plektra/syntsamix/docs/MECHANICAL.md

# Mechanical interface

Status: **[confirmed]** where a decision is named; sections marked *open* are still to settle in a `/system mechanical` session. Decisions behind this file: `decisions/mechanical.md` items 55, 59, 75, 86, 106 to 109, 119 to 121, 160, 162, 176 and 188; `decisions/power.md` items 168 (power LED), 182 (brick jack), 185 and 186 (power board size and form); `decisions/system.md` item 175 (multi-drop chain cables); `decisions/system-rules.md` item 118 (jack sizes).

The mechanical contract between the boards, the panels and the frame: what every board layout must fit. Changed only by a confirmed decision (invariant 5 in `ARCHITECTURE.md`).

## Format (decision 59)

Desktop unit. One PCB per channel strip under its own top panel strip; channel input jacks on the passive input module behind the rear panel (decision 62, position: decision 160); front and back aluminium rails cut to length with wedge side cheeks, so the top panels slope toward the player (decisions 160, 162); left to right: the channel strips, the master section, the power bay (decision 162); chain ribbons run under the strips between neighbours. Top and rear panels are black FR4 with white legends from the PCB maker.

## Strip envelope (decision 106)

| Item | Value |
|---|---|
| Strip pitch | 35.0 mm |
| Top panel strip width | 34.8 mm (0.2 mm gap to the neighbour) |
| Panel material | FR4, 1.6 mm |
| Channel card PCB width | at most 33.0 mm, centred on the strip |
| Control area (between the rails' inner faces) | at most 320 mm deep (decisions 106, 108) |
| Top panel length | control area + 2 × 20 mm on the rails, at most 360 mm (decision 108) |
| Channel card PCB depth | fits between the rails: at most 318 mm (1 mm clearance to each rail; decision 108) |

Sixteen strips are 560 mm wide before the master section. Unit width: 35 mm × (channels + 5) plus the cheeks (master 4 strips, power bay 1; decision 162): about 315 mm for the prototype, 735 mm for 16 channels.

## Channel strip panel layout (decisions 55, 106)

One column, top (rear) to bottom (front), following the signal flow:

1. TRIM
2. [LOW-CUT]
3. Cutoff CV IN and CV OUT jacks (3.5 mm Thonkiconn, vertical, on the channel card; decisions 118, 165), side by side, IN left and OUT right, 16 mm between centres, centred on the strip (decision 166)
4. CUTOFF
5. RESONANCE
6. [FILTER BYPASS]
7. AUX 1
8. AUX 2
9. [SC SEND] [DUCK] [COMP BUS] in one row (caps at most about 10 mm on an 11 mm pitch)
10. [PFL]
11. [MUTE]
12. 8-LED meter beside the 60 mm fader, at the front edge: printed bezel flush in one panel slot, 6.0 mm pitch, CLIP level with the fader's top travel end (decision 119)

## Panel stack (decision 107)

| Item | Value |
|---|---|
| PCB top to panel underside | 10.0 mm, set by the Alpha 9 mm pots (10 mm body) |
| Panel | 1.6 mm FR4; top surface 11.6 mm above the PCB |
| Pots (RD901F-40, RD902F-40) | hold the panel: M7×0.75 bushing 5 mm, washer 0.4 mm and nut 2 mm (4.0 mm of thread used); shaft 6 mm T18 knurled, L = 15 mm from the body face, about 13.4 mm above the panel, push-on knobs (decision 114); bushing thread from Alpha's RD902F drawing, confirmed by Thonk support for the Thonk T18 pots (2026-10-09); check the nut fit on the first delivery |
| Fader (PTA6043, DP lever 15 mm) | frame top 6.5 mm above the PCB; screwed to the panel with two M2 screws (holes 71 mm apart) through 3.5 mm spacers; lever about 10 mm above the panel; slot about 4.5 × 65 mm |
| Top-side height limit | at most 9.0 mm under the panel (1 mm clearance), except parts that pass through it |
| Buttons (GPBS850L) | printed caps take up the height (measure a sample) |
| Channel meter (decision 119) | 0805 LEDs on the PCB under a 3D-printed bezel 11.6 mm tall, face flush with the panel top, through one slot about 5 × 49 mm; 8 windows at 6.0 mm pitch (about 4 × 4.5 mm, 1.5 mm walls); located by the slot and two printed pegs in 1.5 mm non-plated PCB holes; column position across the strip: *set at channel card layout* |
| Cutoff CV jacks (IN, OUT) | 3.5 mm Thonkiconn PJ398SM (decisions 118, 166), each: body 9 mm on the PCB, 1 mm printed washer on the unthreaded bushing collar to the panel underside, M6×0.5 nut on top (2.9 mm of thread left) |

Assembly order: screw the fader to the panel first, then solder it to the PCB, so its joints carry no stress. The fader is therefore hand-soldered, not assembled by the PCB maker.

## Card fixing (decisions 108, 120)

- Each top panel rests on the front and back 2020 rails, covering each rail's full 20 mm top face.
- One M3 button-head screw (ISO 7380) per end (two per panel), on the strip's centreline, into a drop-in M3 T-nut in the rail's top slot (slot centre 10 mm from the rail edge) (decision 120).
- A 3D-printed locating key under each panel end sits in the rail's top slot and stops the panel rotating in its plane (decision 120). Check rattle and twist on the prototype; the second screw per end (decision 108) returns if needed.
- The card hangs from its panel by the pots and the fader (decision 107); nothing on the PCB reaches over a rail.

## Chain headers (decisions 109, 175)

- Left to right: the channel strips, the master section (4 strips), the power bay (1 strip) (decision 162).
- Every channel card: one audio header (2×17) and one power header (2×4) on the underside, long axis front to back, **pin 1 toward the front**, key on the same side on every card (decision 175). Every card is the same, so the sockets sit at the 35 mm strip pitch.
- Header positions (each header's distance from the front, position across the card): chosen by the channel card layout (rear half, clear of the fader) and recorded here: *to be filled in*. The master card's audio header sits on the same line in the same orientation, near its left edge.
- Audio cable: multi-drop sections of 34-way flat cable. A standard section has 8 card sockets about 37 mm apart on the cable (35 mm pitch plus about 2 mm so it bows instead of pulling; marked on a crimping guide) and an end socket at each end. The first section's right end plugs into the master; a second section (cards 9-16) joins the first's left end through the coupler board; a free end socket stays unplugged. End-segment lengths: *set at the channel and master layouts*.
- Coupler board (only for more than 8 cards): a small passive PCB with two shrouded 2×17 headers as on the cards, same orientation, pin n to pin n; held in the cable run under the strips by a cable tie or a printed clip, never on the bottom cover.
- Power cable: one multi-drop section per group of 8 cards (decisions 80, 175), 8-way Würth WR-CAB flat cable (decision 178), a feed socket at the power board and 8 card sockets. Chain 1 feeds the group next to the master (the prototype's cards), chain 2 the far group (full-size module only, decision 185). Chain 1's feed runs under the master section; chain 2's (about 0.5 m) along the rear floor in front of the input modules on printed clips on the rear bottom angle, then forward to the header line (no cross band under the cards). The master card has its own two-socket power ribbon.
- Unused card sockets may stay free: the prototype has one audio and one chain 1 power section with 4 of the 8 card sockets in use. Any card can be unplugged without breaking the chain.
- Crimping (by hand, IDC press or smooth-jawed vise): every socket of a section on the same cable face, stripe along the front edge. At card sockets the cable passes straight through; end sockets may take the strain relief (check the Würth drawing).

## Rear panel and input module (decision 160)

| Item | Value |
|---|---|
| Rear panel | one black FR4 strip per channel, 34.8 mm wide (as the top panels), 1.6 mm; the master section and the power bay have their own rear pieces (decision 162) |
| Rear strip fixing | top: one M3 screw into a T-nut in the rear 2020 rail's back slot; bottom: one screw into an aluminium angle (about 20 × 20 × 2 mm, cut to length) along the rear bottom edge |
| Input module (6.3 mm) | PCB on edge in the front-to-back vertical plane, below the rear rail, centred on its strip; NYS216 jacks stacked, L/MONO above R, about 19 mm between centres; module about 40 mm tall; fixed only by the jack nuts on the rear strip; 2x6 box header facing forward (decision 181) |
| Why stacked | NYS216 is 17.7 mm wide across its pin rows (footprint from Rean's drawing): two side by side need 35.4 mm, more than the 35.0 mm pitch |
| Rear inside height | about 60 mm: 20 mm rail plus about 40 mm of jack zone; *from the module layout* |
| Input cable (decisions 99, 180, 181) | self-made 12-way IDC flat cable, 150 mm, between the 2x6 box headers; the channel card layout places its header near the rear edge, within reach |

## Frame shape (decision 160)

- Sloped: wedge side cheeks, flat bottom cover; the rear about 60 mm inside (above), the front a single 2020 rail, 20 mm inside (decision 162), so the top panels tilt about 6° toward the player.
- Front: no member below the front rail; the bottom cover screws into the rail's bottom slot. At the front only fader and part pins pass a card's underside; underside parts (decision 121) sit at least about 40 mm behind the front rail's inner face, where the floor is deep enough.
- The cards hang from their panels (decision 107): the tilt changes nothing on a board. The cheeks are the same for every channel count.

## Master section (decision 162)

| Item | Value |
|---|---|
| Width | 4 strips (140 mm), right of the channels; one top panel 139.8 mm wide, at most 360 mm long |
| Master card | at most 138 mm wide and 318 mm deep, hung 10 mm under its panel like a channel card (decision 107); audio header on the channel cards' header line near its left edge, same orientation (decisions 109, 175) |
| Controls | 13 pots, 10 buttons, stereo meter, 5 gain-reduction LEDs, headphone jack; three columns (compressor and sidechain, AUX, master/phones/meter) set at layout |
| Meters | 0805 LEDs under printed bezels as decision 119: 2 × 12 at 6.0 mm pitch plus the 5 gain-reduction LEDs (yellow); the PFL-active LED is an 0805 under a bezel window too (decision 170) |
| Rear jacks | one rear piece 139.8 mm; 12 positions in 2 rows × 6 at about 23 mm: 11 jacks and the ground-lift switch, on two flat passive row boards fixed only by the jack nuts: output board (main L/R, AUX send 1 L/R, AUX send 2 L/R) and input board (AUX return 1 L/R, AUX return 2 L/R, SC EXT, ground lift), each cabled to the master card by one 26-pin ribbon (J603 outputs, J903 inputs and ground lift; decision 163). Needs the NYS216 at most about 17 mm tall above its board: *measure a sample*; if taller, on-edge 2-jack boards as the input module |
| Headphones | panel-mounted 6.3 mm stereo jack, nut on the master top panel, body through a cutout in the master card; Rean NYS230 cabled by a ready-made 150 mm Molex 217797-1031 lead to the KK 1x3 header J751 on the card (decision 169); at least about 90 mm behind the front edge (about 30 mm of depth, to measure on a sample) |
| Regulators | U901, U902 TO-220 on Wakefield 637-10ABPE heatsinks (12.67 °C/W, 25.4 mm below the PCB; LM317 TJ about 111 °C worst case at decision 167's 57 °C air, within the 125 °C rating, decision 174); U903 without a heatsink. On the card's underside, hand-soldered, at least about 190 mm behind the front rail's inner face, where the sloped floor leaves 40 mm below the panel underside (heatsink bottom 37 mm plus 3 mm to the cover; decision 176; master-only exception to decision 121); ≥ 3 mm from each other, the frame and the cover (live tabs); heatsinks and tabs at least 10 mm inside the card's right edge, preferably near the card's middle, so about 20 mm of air separates them from the power board's parts (decision 188) |
| Power cables | the master's power ribbon and the chain 1 feed cross under the master section in front of the heatsink zone (less than about 185 mm behind the front rail's inner face); no chain cable passes under a heatsink; the master's power header is placed so its ribbon needs no other route (decision 188) |

## Power bay (decisions 162, 185, 186, 188)

| Item | Value |
|---|---|
| Width | 1 strip (35 mm) at the right end, with a plain top strip (34.8 mm) |
| Power LED | on the bay's top strip: 3 mm LED in a Bivar CR-104 clip, Ø4.47 mm (+0.10 / −0.05) hole in the 1.6 mm FR4 (flange 5.3 mm, ring 6.1 mm behind the panel), wired to J103 (decision 168); hole on the strip's centreline about 290 mm behind the front rail's inner face, clear of the rear bracket (decision 188) |
| Power board | small module (decision 185): on edge in the front-to-back plane, 177 × 35 mm, about 138 to 315 mm behind the front rail's inner face, top edge about 5 mm under the panel, bottom edge 3 mm above the cover, rising over the front 47 mm (decision 186); parts side toward the master, parts up to about 17 mm; ribbon headers along the bottom edge, pin 1 toward the front |
| Position across the bay | back face (bracket side) 6 mm from the bay's right edge at the cheek, so the parts end about 10 mm from the master section's edge; back-face copper at least 5 mm from the cheek; nothing touches the cheek (decision 188) |
| Fixing | hangs from the bay's top strip on two brackets only, no fixing to the rear strip (decision 186); panels only, nothing on the cheeks; insulating hardware keeps PGND off the frame (invariant 8). Brackets printed PETG or ASA, inverted L: vertical leg on the back face with a vertical slot, M3 from the parts side through H1/H2 into a heat-set insert; horizontal leg about 4 mm thick in the 5 mm gap above the board; one M3 button-head screw (ISO 7380) per bracket through the top strip on its centreline, about 309 mm (H1) and 144 mm (H2) behind the front rail's inner face, plus a printed anti-twist peg (decision 188); bracket drawing and the strip's holes *with the panel drawing* |
| Rear strip | brick jack Kycon KPJX-PM-4S (flange 25.2 × 14.2 mm, two M2.5 self-tapping screws 19.0 mm apart, about Ø13 hole, body 9.9 mm; decision 182) and power rocker (decision 157, cutout 19.2 × 12.9 mm for a 0.8-1.2 mm panel, 19.4 mm for 1.3-2.0 mm), upright side by side; exhaust slots where they leave room (decision 167); the board's rear edge ends about 25 mm in front of the strip: *check the rocker tabs with their receptacles on the frame* |
| Module sizes | the prototype's small module for up to 8 channel cards (master and chain 1, decision 185); a full-size module with chain 2 after the prototype measurement; same bay and ribbons |

## Underside and bottom cover (decision 121)

| Item | Value |
|---|---|
| Underside parts | the chain headers (decision 175); elsewhere only hand-set parts (trimmers, jumper headers; decision 112), at most 10.5 mm below the PCB's bottom face |
| Keep-out | no underside parts other than the chain headers in a band across the whole card width over each header's length plus 15 mm front and back (decision 175); the cable runs below at the sockets' depth |
| Bottom cover | perforated as the air intake (decision 167); detachable, a few captive or quarter-turn screws: at the rear into the bottom angle (decision 160), at the front into the front rail's bottom slot (decision 162); off without touching side cheeks, cards or feet |
| Feet | on the side cheeks or the rails, not on the cover |
| Inside height | 20 mm at the front rail, about 60 mm at the rear (decisions 160, 162); the channel card layout checks header, socket and cable depth against the inside height at the header distance (decision 175) |

## Ventilation (decision 167)

| Item | Value |
|---|---|
| Principle | passive, no fan on the prototype; design point: inside air 22 K above room temperature (57 °C on a 35 °C stage), up to 8 cards; parts and heatsinks checked at 57 °C air |
| Intake | perforated bottom cover |
| Exhaust, channel rear strip | four routed slots 2 × 30 mm in the jack zone, two in each band beside the jack nuts (from the left edge 2.5-4.5, 6.5-8.5, 26.3-28.3, 30.3-32.3 mm; 2.5 mm edge margin, 2 mm bars): about 2.4 cm²; legends and the top screw on the 20 mm in front of the rail; jack nut taken as about 15 mm across (*measure the sample*) |
| Exhaust, master and bay | slots where the jacks, rocker and brick jack leave room (about 3 and 2 cm²) |
| No openings | cheeks, top panels (spills) |
| Estimate | rise about 20 K (prototype), 22 K (8 cards), 24 K (16 cards) **[estimate]**, `tools/heat_budget.py` |
| Measurement | prototype: probe at the master heatsinks and over the middle channel card, one hour with every LED lit; full-size cooling decided after it |
| Check | the rear bottom angle (decision 160) must not cover the lower slots or the lower jack's body: under the jack zone or a shorter leg (input module layout) |

## Panel hardware and ground (note)

Jack sleeves go to their own card's AGND; FR4 panels do not conduct (`CHAIN.md`, Grounding). Keep pot bushings and fader frames off AGND anyway, so metal panels (a product-version option, decision 59) need no ground rework. A jack's metal bushing is usually its sleeve, so on metal panels jacks would need insulated bushings or insulating washers.

## Open

Settled in this order, each by a decision:

1. *Underside:* the header positions, end-segment lengths and the inside-height check (keep-out settled by decision 175) and the input cable length, all at the channel card layout; the chain 1 feed reaches the header line after crossing under the master section in front of its heatsink zone (less than about 185 mm behind the front rail, decision 188), and the master layout checks the floor height where both power ribbons cross (rear, frame shape, master section and power bay settled by decisions 160 and 162; underside rules and cover by decision 121)
2. *Heat (full size):* the cooling for 16 cards after the prototype measurement (decision 167): a quiet fan in the power bay (expected) or less dissipation
