plektra/syntsamix/docs/SPEC.md

# Specification v0.7 (draft)

Items marked **[confirmed]** were agreed with the user. Items marked **[proposed]** are defaults suggested during the design chat and still need confirmation. See `decisions/INDEX.md`.

## 1. Goals

- Live-performance mixer for synths, drum machines and modular gear **[confirmed]**
- Modular by design **[confirmed]**
- Relatively tight budget: prefer cost-effective parts where the audible difference is small **[confirmed]**
- Channel strips can be added one at a time as needed. Each stereo channel card is self-contained and has no direct dependency on any other channel card; it talks only to the shared buses **[confirmed]**
- Inputs accept hot Eurorack modular levels as well as line levels, without an external attenuator **[confirmed]**
- Analog signal path **[confirmed]**
- Pro-level headroom: +4 dBu nominal. On ±15 V rails a single-ended stage tops out at about +20 dBu; +24 dBu is reachable only at the balanced outputs (each leg at +18 dBu) **[confirmed]**

## 2. Architecture

- Identical stereo channel cards, 1 to 16 (the prototype has 4), chained by multi-drop ribbon cables in 8-card sections (decision 175), with the master card at one end. No backplane PCB **[confirmed]**
- Each channel card has one connector of each kind, on multi-drop cables (decision 175): a 34-pin IDC audio ribbon (buses, logic lines, interleaved audio grounds, spares) and a keyed 8-pin IDC power ribbon (2× V+, 2× V−, 4× ground; 10- and 16-pin avoided so Eurorack cables cannot be plugged in) **[confirmed]**
- Chain power: about ±20 V nominal (unregulated in general; on the prototype it comes from the converters on the power board, decision 100), entering at the power board; each card regulates its own ±15 V; audio ground and power ground on separate conductors **[confirmed]**
- Pinouts, signal definitions and grounding rules: see `CHAIN.md` **[confirmed]**
- Summing buses: main L/R, compressor L/R, AUX1 L/R, AUX2 L/R (8 lines), plus cue L/R (2 lines), a "PFL active" logic line and the sidechain bus (pinout in `CHAIN.md`) **[confirmed]**
- Channel independence rules: every slot is identical (no slot-specific signals); audio buses are summed on the master card, so adding a card only adds a source; logic lines such as "PFL active" are wired-OR; no part is shared between channel cards; each card regulates its own supply **[confirmed]**
- Expansion by the chain: adding a channel means adding one card and one pair of ribbon cables **[confirmed]**
- Master/compressor card **[confirmed]**
- Prototype power: a certified off-the-shelf 24 V Class II DC power brick (floating output) plugs into a locking 4-pin DIN connector on the power board next to the master card (decisions 81, 100); non-isolated converters there (TPS54560 buck and inverter, 400 kHz) make about ±20 V for the chain, followed by an LC filter, with a pi filter at the input against the brick lead (decision 187); per-card linear ±15 V regulators reject the remaining switching ripple. Power switch, resettable fuse, reverse-polarity protection and a power LED at the input. No mains wiring inside the mixer **[confirmed]**
- Supply rating for 16 cards: 3.6 / 2.9 A per rail (decision 96, rerun after decisions 102 and 103; `docs/ARCHITECTURE.md`). The +20 V buck probably scales; the −20 V inverter needs a controller with external MOSFETs, settled after the prototype cards are measured (decision 100) **[open]**
- Each module is its own KiCad project with hierarchical sheets and its own PCB **[confirmed]**

Signal flow per channel: input receiver and trim (with soft clip) → low-cut (switchable) → filter (or bypass) → [PFL, meter and SC send tap] → level VCA (fader + mute) → AUX sends and bus assign (main or compressor bus).

## 3. Channel strip (per stereo channel; every element is an L/R pair)

| Block | Spec | Status |
|---|---|---|
| Input | Balanced inputs | confirmed |
| Mono sources | L/MONO input: with only the L jack plugged in, the signal feeds both sides through the R jack's switch contacts. No panel switch, no balance/pan control | confirmed |
| Input module | Jacks sit on a separate passive input module on a 12-pin IDC header (`INPUT-MODULE.md`, decision 181); the prototype module is 6.3 mm, with 3.5 mm and D-SUB bundle modules later | confirmed |
| Input connectors | 2x 6.3 mm TRS (L/MONO and R), balanced; an unbalanced TS plug works with ring and sleeve shorted, so Eurorack gear connects with a 3.5 mm TS to 6.3 mm TS cable. The R jack needs switch contacts on tip and ring for L/MONO normalling (part to be chosen from datasheets). All jacks on the mixer are 6.3 mm | confirmed |
| Input level range | From -10 dBV consumer line up to Eurorack hot signals of ±12 V peak (24 Vpp), with no clipping at minimum trim | confirmed |
| Input receiver | Difference amplifier at G = ½ (-6 dB) on one TL072 per card for L and R, 10k 0.1 % resistors (CMRR at least 51.5 dB; decision 143; the AD8273 until 2026-10-10) | confirmed; DC-coupled inputs confirmed |
| Soft clipping | Soft clipper after the input trim stage, so overloads saturate gradually instead of hard-clipping. Onset about 6 dB below the internal maximum (about +14 dBu); exact circuit set in the schematic | confirmed |
| Low-cut | Switchable fixed low-cut at 100 Hz (decision 73), 12 dB/octave Butterworth, C0G capacitors (decision 113; film before), after the trim stage and before the ladder filter (so meter, PFL and sends all see it) | confirmed (slope proposed) |
| Input trim | One wide trim, no pad switch: overall gain about -20 to +20 dB (input to internal +4 dBu nominal); the trim stage after the receiver spans about -14 to +26 dB | confirmed |
| Input DC blocking | AC coupling after the receiver, corner about 3 Hz; Eurorack outputs can carry DC offsets | confirmed |
| Level meter | 8-segment mono LED meter (louder of L/R), post-filter and pre-fader (same point as PFL): -30, -20, -10, -5, 0, +3, +6, clip, relative to +4 dBu nominal. Peak-reading with a 1 to 2 s fall. Peak detector plus comparators; low-current LEDs returning to power ground. Replaces the peak LED | confirmed |
| Filter | 24 dB/oct (4-pole) ladder LPF with resonance and cutoff controls | confirmed |
| Filter part | SSI2144 baseline, AS3320 fallback | confirmed |
| Cutoff range | 20 Hz to 20 kHz (10 octaves, about 190 mV at the frequency control pin); one linear pot drives L and R, which gives an even octave-per-turn feel (noon about 630 Hz) through the chip's exponential control | confirmed |
| Filter bypass | Per-channel bypass switch around the filter | confirmed |
| Filter gain structure | "Hot" drive by default: +4 dBu maps to the datasheet nominal of ±20 mV at the SSI2144 input. Simulated: under 0.1% THD at +4 dBu with the cutoff open, about 1.3% with the cutoff lowered toward the signal, clear saturation from about +8 dBu; SNR about 93 dB A-weighted with the filter engaged. A jumper on the prototype selects a "medium" drive 4 to 6 dB lower (switching the pre-filter attenuator and the make-up gain together) so the final choice can be made by ear. Make-up gain after the filter. See `simulation/filter/README.md` | confirmed |
| Filter tracking | One control path drives L and R, plus a frequency offset trim per chip; the temperature-compensating resistor is in the backlog (decision 141) | confirmed |
| Resonance limit | Fixed maximum Q current so no chip self-oscillates: about 75% of the oscillation current (k = 3). With the Q VCA (decision 71) the limit is the series resistor into the LM13700 bias pin (provisional 41.2 kΩ, about 254 µA with R184 = 12 kΩ, decision 129) | confirmed |
| Resonance bass loss | Half compensation by default: bass loss at maximum Q drops from -12 dB to -6 dB and the resonant peak stays about +9.5 dB above nominal (full compensation would put it at about +15.5 dB, at the internal maximum). Built with the datasheet's external Q VCA (SSI2144 Figure 9, one LM13700 per card for L and R) instead of a make-up gain stage; a prototype jumper selects none, half or full compensation (decision 71) | confirmed |
| Level | Level fader | confirmed |
| Fader type | Linear 60 mm fader (Bourns PTA6043-2015DPB103) generating the control voltage for an SSI2162 dual VCA (one chip per card covers L and R); a resistor network shapes a console-style dB law | confirmed |
| Fader range | +10 dB at the top, -∞ at the bottom (the VCA's -100 dB attenuation, with the control overdriven at the end stop) | confirmed |
| Fader scale | 0 dB at about 75% of travel; markings +10, +5, 0, -5, -10, -20, -30, -40, -60, -∞ | confirmed |
| Mute | Mute; click-free via VCA | confirmed |
| Bus assign | Per-channel switch: main bus or compressor bus | confirmed |
| Buttons | Low-cut, mute, PFL, SC send, duck, filter bypass, bus assign: latching push switches with two contact sets; one set drives a logic line to a DG413 analog switch that switches L and R (bus assign, PFL and SC send: a CD4052B at the virtual-earth end of the bus resistors, decision 183; for MUTE and DUCK the pole switches the DC control voltage into the VCA control summer directly, decision 142), the other drives the button's LED (decision 69). A local +5 V supply feeds the switch logic. State survives power cycles. Mute switches the VCA control voltage (click-free); switched audio paths are DC-free to avoid clicks. Low-current 0805 LEDs (1 to 2 mA) returning to power ground, lighting 3D-printed translucent caps from below (decision 75); colours to be chosen. Switch: CW Industries GPBS850L | confirmed |
| Duck | DUCK button: adds the master's SC_ENV ducking envelope to this channel's VCA control (post-fader level ducks with the sidechain trigger) | confirmed |
| SC send | Button: adds L+R to the mono sidechain bus, tapped at the same point as PFL (pre-fader, pre-mute) | confirmed |
| PFL | Latching button; taps the stereo signal after the filter and before the fader VCA (so also pre-mute) onto the cue bus, and pulls the "PFL active" line | confirmed |
| AUX | Two stereo AUX sends, each a level control feeding a stereo AUX bus | confirmed |
| AUX pre/post | Post-fader by default; a PCB jumper per send selects pre-fader | confirmed |
| Cutoff CV input | Per-channel 3.5 mm jack (Thonkiconn, decision 118) into the filter control summer, driving L and R together; fixed scale of about 1 V/octave (Eurorack convention), no amount knob; DC-coupled, about 100 kΩ input impedance, survives ±12 V; knob plus CV is limited to the chip's safe control range by a zener clamp on the summer (frequency pin within about ±128 mV, decision 165) | confirmed |
| Cutoff CV chaining | Per-channel 3.5 mm CV OUT jack beside the CV input: the channel's total cutoff control at 1 V/oct, so one knob or CV can drive several channels by patching CV OUT into the next CV IN. An underside jumper per card selects CV ONLY (a plugged CV replaces the knob) or CV + POT (the knob adds an offset). Beside CV IN, IN left and OUT right (decisions 165, 166) | confirmed |
| HPF | Sweepable resonant HPF dropped from the prototype; reserve space for later. A fixed switchable 100 Hz low-cut is included instead | confirmed |

Panel layout, top to bottom, following the signal flow (post-fader AUX knobs sit above the fader, as on any console) **[confirmed]**:
TRIM, [LOW-CUT], CV IN + CV OUT jacks, CUTOFF, RESONANCE, [FILTER BYPASS], AUX 1, AUX 2, [SC SEND] [DUCK] [COMP BUS], [PFL], [MUTE], then the 8-LED meter beside the 60 mm fader at the bottom edge.
Channel input jacks (L/MONO and R, on the input module) on the rear panel; the cutoff CV IN and CV OUT jacks sit side by side on the top panel directly above CUTOFF, mounted on the channel card (decision 166); strip pitch 35 mm (decision 106, `MECHANICAL.md`) **[confirmed]**

Notes on the filter (SSI2144 datasheet Rev 3.0, January 2018, verified):
- Supply ±4 V to ±16 V, absolute maximum ±18 V; datasheet specs are measured at ±12 V.
- Differential input, nominal ±20 mV, clips at ±50 mV.
- Dynamic range 92 dB A-weighted (noise floor to 1% THD).
- Frequency control -19 mV/octave, untrimmed offset up to ±10 mV (about half an octave between chips).
- Q current at oscillation 350 to 450 µA; more Q lowers the passband and bass gain.
- Current output, ±300 µA minimum; can drive an SSI2164 VCA input directly.
- SSOP-16 only. The chip is a reissue of the SSM2044 (Rossum improved ladder).
- Resonance is on the LPF only (HPF is dropped). Two filter cores per channel card (8 in the 4-channel prototype).

Notes on input levels:
- Eurorack audio is typically 10 Vpp (±5 V), about +13 dBu for a sine (Doepfer A-100 technical details). Many modules swing further toward the ±12 V rails; ±10 V outputs are common. Eurorack is unbalanced, on 3.5 mm TS.
- Waveforms are often square or saw, so plan by peak voltage, not dBu. A ±10 V square wave is about +22 dBu RMS.
- Gain needed to reach +4 dBu nominal (1.74 V peak): ±5 V peak about -9 dB, ±10 V about -15 dB, ±12 V about -17 dB. Line +4 dBu needs 0 dB; -10 dBV needs about +12 dB. Weak sources get up to +20 dB.
- AD8273 (not used since decisions 143 and 148: both receivers are TL072 difference amplifiers; Analog Devices, datasheet Rev B; figures from datasheet excerpts; supply current read from Table 2, the rest of the PDF still to read directly): dual, internal precision resistors, G = ½ or 2, ±2.5 V to ±18 V supplies. At ±15 V and G = ½: input voltage range about ±40.5 V (−3VS + 4.5 to +3VS − 4.5), output noise 26 nV/√Hz at 1 kHz (about -106 dBu over 20 kHz if flat), CMRR 77 dB minimum, gain error 0.05% maximum, THD+N 0.00025%. Supply current 2.5 mA maximum per amplifier at ±15 V (no typical given). Input resistance not yet confirmed. Active part, about $4.
- Earlier candidate THAT1246 (datasheet Rev 05, verified; replaced because of supply risk and because the AD8273 is a dual): gain -6 dB; with ±15 V rails the output swings to about +21.1 dBu, so differential inputs up to about +27 dBu (about ±24 V peak) pass cleanly, well above any Eurorack level. Common-mode input range +31 dBu. Input impedance 24 kΩ differential and 18 kΩ common mode (±25%). Output noise -106 dBu. THAT recommends the 1243 (-3 dB) for pro +24 dBu inputs, but the 1246 suits this mixer better because of the hotter Eurorack peaks.
- A TS cable shorts ring to sleeve at the source, so the receiver still rejects ground noise between the case and the mixer (pseudo-balanced).

Notes on mono/stereo (L/MONO convention everywhere):
- Channel inputs, AUX send outputs and AUX returns all use L/MONO jacks.
- Mono handling for AUX lives on the master card, not per channel.
- Jack part with tip and ring switch contacts is still to be chosen and verified from its datasheet.

## 4. Master and compressor

- Compressor with selectable/routable sidechain input **[confirmed]**
- The compressor processes a dedicated **compressor bus**; each channel chooses main or compressor bus, and the compressor output sums into the main bus **[confirmed]**
- Sidechain has an LPF so the detector reacts mainly to bass; purpose is bass pumping **[confirmed]**
- Sidechain LPF adjustable about 40 to 500 Hz, 12 dB/octave, with bypass switch **[confirmed]**
- Sidechain source: INT (the compressor bus itself, L+R) / BUS (the mono sidechain bus) / EXT (external jack). A plug in the EXT jack overrides; otherwise an SC BUS button picks BUS or INT (decision 90) **[confirmed]**
- Channels feed the sidechain bus through a per-channel SC send button, tapped after the filter and before fader and mute (same point as PFL and the meter), so a muted channel can still trigger the pumping ("ghost triggering"). The master card never addresses a specific slot **[confirmed]**
- EXT sidechain input: DC-coupled, accepts audio and Eurorack envelopes or gates up to ±12 V **[confirmed]**; 6.3 mm on the master's rear input row board (decisions 118, 162)
- Sidechain ducking (decision 66): an envelope follower on the master card takes the sidechain signal after the source switch and the sidechain LPF and drives the SC_ENV chain line. Controls: THRESHOLD, DEPTH and DECAY; attack fast and fixed. Each channel's DUCK button adds SC_ENV (negative, −1 V = 10 dB; decision 97) to its VCA control, so the channel ducks with the trigger independently of the compressor bus. Each AUX return also has a DUCK switch **[confirmed]**
- SC listen button: sends the filtered sidechain signal to the cue bus (headphones) and pulls the PFL-active line **[confirmed]**
- Stereo-linked VCA compressor (SSI2162) with a performance control set **[confirmed]**:
  - **Amount:** one knob that lowers the threshold and raises makeup gain together, through the VCA control circuit
  - **Release ("pump"):** recovery time after each hit
  - **Mix:** dry/wet blend of the uncompressed and compressed compressor bus (parallel compression)
  - **On/off button:** click-free bypass
  - **Gain-reduction LEDs:** about 5 segments
  - Sidechain LPF frequency and bypass, and the sidechain source selector (below)
- Preset inside (trimmers or jumpers, no panel knobs): attack about 1 ms, ratio 4:1, makeup range tied to Amount **[confirmed]**
- Detector: feed-forward, peak-sensing, log conversion with a matched transistor array (Alfa AS3046 / CA3046 class or THAT300 series; the THAT2252 RMS detector is obsolete) **[confirmed]**
- Ranges: Amount 0 to about 30 dB (threshold down to -30 dB below nominal, makeup tied); Release about 50 ms to 1.5 s; gain-reduction LEDs at 1, 3, 6, 10, 15 dB **[confirmed]**
- Soft clipping on the master bus output, same onset as the channels **[confirmed]**
- Master level: linear pot controlling an SSI2162 VCA (accurate L/R tracking) **[confirmed]**
- Headphone output **[confirmed for the prototype]**: dual-gang volume pot; TI TPA6120A2 headphone amplifier on ±15 V (decision 84, replaces the NJM4556A whose package cannot dissipate the power); for 32 to 600 Ω headphones; 6.3 mm stereo jack panel-mounted on the master top panel and wired to the card (decision 162), the only jack not on the rear
- AUX send outputs: L/MONO and R jacks per send (impedance-balanced TRS, TS works); with only L plugged in, L outputs (L+R)/2 **[confirmed]**
- AUX send master: dual-gang pot per send, -∞ to 0 dB, ahead of the output stage; full up gives +4 dBu nominal, turned down suits pedals and other low-level gear **[confirmed]**
- AUX returns: stereo, L/MONO normalled (only L plugged in feeds both sides) **[confirmed]**
  - Input stage: TL072 difference amplifier at G = ½ with 10k 0.1 % resistors (decision 148, as the channel's decision 143) (DC-coupled, about 3 Hz AC coupling after it, accepts up to ±12 V peak); a jumper per return sets the receiver gain to -6 dB (pro and Eurorack effects) or +6 dB (pedals at about -10 dBV)
  - Level: linear pot controlling an SSI2162 VCA, -∞ to +10 dB
  - Mute button (click-free via the VCA)
  - Main/compressor bus switch, so for example a reverb return can pump with the kick
- Headphone output: master bus normally, cue bus automatically while any PFL is active **[confirmed]**
- PFL-active LED **[confirmed]**
- Stereo LED level meter on the master bus after the master level control (no cue switching): 12 segments per side, -30, -20, -15, -10, -6, -3, 0, +3, +6, +9, +12, clip; 0 = +4 dBu; clip about +17 dBu internal (+23 dBu at the balanced outputs); peak-reading with a 1 to 2 s fall **[confirmed]**
- Balanced stereo outputs on 6.3 mm TRS **[confirmed]**
- No solo-in-place **[confirmed]**
- Ground-lift switch for the frame bond at the master card (see `CHAIN.md`, Grounding) **[confirmed]**
- Output protection: relays in series with the main outputs and the headphone output; open (outputs grounded through a resistor) when unpowered, closing about 2 s after the rails are stable, opening at once when a comparator sees the incoming chain voltage start to drop. AUX send outputs are not relay-protected **[confirmed]**

## 4b. Mechanical format **[confirmed]**

- Desktop unit, not rack. Left to right: channel strips, master section (4 strips), power bay (1 strip); 35 mm × (channels + 5) plus the cheeks: about 315 mm for the prototype, 735 mm for 16 channels (decision 162). Sloped: the panels tilt about 6° toward the player (decisions 160, 162)
- One module per channel strip: a horizontal PCB carrying the pots, fader and buttons, with its own top panel strip (35 mm pitch, 34.8 mm wide, control area at most 320 mm deep between the rails; decisions 106, 108, `MECHANICAL.md`); the PCB sits 10 mm below the panel, the pots hold the panel and the fader is screwed to it (decision 107)
- Top and rear panel strips are black FR4 with white printed legends, made by the PCB maker (aluminium panels can come with a product version)
- Channel input jacks are on the passive input module behind a small FR4 rear panel strip, cabled to the channel card (decisions 62, 99; on edge with the jacks stacked, decision 160); the headphone jack is on the master section's top panel (decision 162)
- Frame: front and back aluminium rails (2020 extrusion, cut to length) that the strips screw onto (one centred M3 button-head screw per panel end into a T-nut, plus a printed locating key; decisions 108, 120), with wedge side cheeks (sloped, decisions 160, 162); longer rails for more strips
- One multi-drop chain cable per 8-card section runs under the strips (decision 175)
- Knobs and fader caps chosen with the panel design

## 5. Performance targets (confirmed; refine after simulation and measurement)

With the filter bypassed:
- Frequency response 20 Hz to 20 kHz within +-0.5 dB
- THD+N below 0.05% at +4 dBu (relaxed from 0.01% for the SSI2162 VCA)
- Dynamic range above 100 dB
- Crosstalk below -80 dB

With the filter engaged:
- SNR at +4 dBu: about 93 dB A-weighted with hot drive, about 89 dB with medium drive (estimated from the datasheet's 92 dB dynamic range and the simulated 1% THD point)
- Distortion is part of the filter character: with hot drive and the cutoff lowered, about 1.3% THD at +4 dBu and clear saturation from about +8 dBu (simulated)

## 6. Tooling

- KiCad, driven through its MCP server **[confirmed]**
- Hierarchical schematics, custom symbol and footprint libraries, ngspice simulation, ERC/DRC checks, BOM export **[confirmed]**
