plektra/syntsamix/hardware/channel-card/STATUS.md

# Channel card status

Updated 2026-10-21 (/system: local regulation kept; 78L05 too hot at the 57 °C design air, Next 5). 2026-10-20 (breadboard: test 2 on chips 1 and 2, loose ladder capacitor contacts, chip 1 damaged; /system: decision 183 flag settled). 2026-10-19 (schematic: CD4052B bus switches and LCSC trimmers, decisions 183 and 184; input header J1 redrawn as the 2x6 box header of decision 181). 2026-10-18 (/system: SPARE2 to SPARE5 wording in the contracts, flag settled). 2026-10-17 (schematic: chain sheet down to one audio and one power header, decision 175; /system: multi-drop chain cables replace the mock-up, decision 175; cable mock-up dropped by the user; breadboard tests on chip 1: output scale, V/oct, cutoff tracking, weak resonance). 2026-10-15 (breadboard page: Electrokit SKUs and part types, kit resistor substitutes, RV4 and the 1N4001s on the board). 2026-10-14 (breadboard layout re-placed for the 500 mil SSOP adapter; SSI2144 footprint verified against the maker's package drawing and a measured chip). 2026-10-13 (/system: chain cable parts registered for the mock-up, SX-CONN-023 and SX-WIRE-001/003; CV IN and CV OUT side by side in panel row 3, decision 166; earlier: cutoff CV chaining, CV OUT and the summer clamp drawn: decision 165; RoHS source for the SSI2144 and SSI2162 accepted: SGS report via Electrokit). 2026-10-11 (/system mechanical: front underside zone, decision 162; schematic: coupling capacitors back to back, decision 161). 2026-10-10: R217 30k (153); SSI2144/SSI2162 hand-soldered (155). Earlier the same day: decisions 137, 139-143 and 152 (see the decision file); 2026-10-09: decisions 110-130.

Reference lists: `CHECKLISTS.md` (checks before layout and on delivery, cost-cut levers, component values; decision 151).

## Where it stands

- Schematic complete: Input, Filter, Level, Routing, Meter, Chain and power. ERC 0 errors 0 warnings; every sheet matches its reference netlist.
- 2026-10-08: decisions 97, 98 and 102 drawn (SC_ENV into VSUM through R217; PGND returns for Q301 and the button pull-downs; U204 = OPA2171). The Level control is simulated in `simulation/level/`.
- 2026-10-09, mechanical parts (decisions 110-117): every top-side part now fits the 9 mm limit under the panel. Regulators D²PAK on copper (110); electrolytics SMD at most 5.4 mm (111); trimmers and jumper headers on the underside (112); low-cut caps C0G 1206 (113); pot shaft standard T18 (114); trim stage scaled to a 100 k pot and the pots chosen (115); RoHS strict for every part (116, project-wide); button LEDs and chain headers chosen (117). Sheets rebuilt, netlists match, ERC 0/0.
- 2026-10-09, /system mechanical: 3.5 mm CV jack by the new jack-size rule (118), meter as 0805 LEDs under a printed bezel at 6.0 mm pitch (119), one centred panel screw per end with a printed key (120), underside rules, keep-out and bottom cover (121), RoHS invariant 9 with standard passives at BOM time (122).
- 2026-10-09, schematic: meter LEDs D411-D418 drawn as 0805 (KT-0805G, KT-0805Y, NCD0805R1; decision 119); power levers (decision 123): U107 NE5532 → TL072, meter U401/U404 TL072 → TL062CDR (SX-IC-024). Card load now 113 / 95 mA typical, 229 / 194 mA worst case, sizing 174 / 142 mA. Netlists match, ERC 0/0. RoHS audit of `parts.csv` done (report `docs/reviews/2026-10-09-rohs-audit.md`).
- 2026-10-09, schematic (pots): Alpha MPNs on RV1, RV181, RV301/RV302 (Thonk `-0057` codes); RV183 is SX-POT-012 (Tayda RD901F-40-15K-C10K) in the reference too; R184 10 k → 12 k (SX-R-008) so RV183 stays within Alpha's 0.02 W rating for non-B tapers (decision 129; RD901F spec facts in `parts.csv`). Netlists match, ERC 0/0.
- 2026-10-09, schematic (tempco): R108/R158 Vishay TFPT0603L8200FV (820 Ω, +4110 ppm/K) with new R122/R172 180 Ω in series to AGND replace the end-of-life ERA-V33J102V: 1 k, about +3370 ppm/K (decision 130). Trim pot value text shortened to "50k OFFSET" for room. Netlists match (filter 80 nets), ERC 0/0, sheet looked at.
- 2026-10-10, fee-free parts (decision 137, confirmed by the user): SX-IC-007 TL072 → ST TL072CDT (LCSC C6961, basic; U107, U205, U402, U403), SX-IC-012 78L05 → UTC 78L05G-AB3-R (C71136, basic; U503), SX-D-001 → hongjiacheng BZT52C6V2 (C19077403, preferred; D1-D4), SX-R-011/036/042 → UNI-ROYAL 0805W8F (C17455, C17797, C17818, preferred). Datasheets checked (facts and RoHS sources in `parts.csv`): TL072CDT pinout and limits as TI's, ICC the same, so the power budget is unchanged; 78L05G-AB3-R pins 1 O 2 G 3 I as the KiCad symbol (the -AB3-C-R variant is G I O); BZT52C6V2 SOD-123 matches KiCad `D_SOD-123`. Filter, level, meter and chain sheets rebuilt; netlists match, ERC 0/0. `costs.py extended`: 82 → 80 fee types.
- 2026-10-10, schematic (levers, delegated): U303 is a DG413: PFL L/R on the NO sections 1 and 4, SC send on the NC section 2 driven by SC_OFF from SW302 pin 1 (released = high), R315 moved to pin 1, no part added (decision 139). Values on E24 with JLCPCB basic/preferred UNI-ROYAL parts (decision 140): input trim stage, filter scaling, cutoff summer (R183 = 150k + new R187 12k; RV182 redrawn in the FCV column), fader law (new pairs R207+R223, R208+R224, R213+R225; `simulation/level/` rerun, within 0.4 dB of the design from +10 to −60 dB), SC send 47k, meter ladder (within 0.21 dB). New SX-R-092 to SX-R-106. Reference scripts give the button LEDs their 0805 footprints and part numbers. Netlists match (filter 81, level 44, routing 46 nets), ERC 0/0, changed areas looked at. `tools/costs.py estimate` (4 channels): €1,035 → €963.
- 2026-10-10, schematic (levers, delegated: "work on this autonomously"): TL072 difference receiver with 10k 0.1 % resistors instead of the AD8273 (decision 143; new R19-R26, SX-R-107); MUTE and DUCK switched by the buttons, U206 DG413 and C235/C236 removed, R220/R222 now 100k hold resistors on MUTE_V/DUCK_V with pin 1 open so no contact sequence can short the rail (decision 142, after the architect review); temperature compensation to the backlog, R108/R158 plain 820 Ω (decision 141); trimmers from Mouser, CUTOFF pot from Tayda A-4730. Netlists match (input 46, level 41 nets), ERC 0/0, drawings looked at. Card load 110 / 93 mA typical, sizing 171 / 139 mA. `tools/costs.py estimate` (4 channels): €946 (€1,035 on main before this day's sessions).
- 2026-10-10, schematic: R217 30k (decision 153; ducking −10.10 dB per −1 V in `simulation/level/`); SSI2144 U101/U102 and SSI2162 U201 hand-soldered by the user on the prototype (decision 155). Netlists match (filter 81, level 41 nets), ERC 0/0. `tools/costs.py estimate`: €788 / €1,069 / €1,665 for 4 / 8 / 16 channels, 36 fee types.
- 2026-10-10, button MPN corrected: SX-SW-001 is CW GPBS850L (latching, Electrokit 41012905); GPBS850N, recorded until now, is the momentary twin. MPN, footprint `SW_Latching_8.5x8.5mm_CW_GPBS850L` (same geometry per datasheet Rev 2), parts.csv and prices.csv changed; erratum on decision 75; no wiring change, ERC 0/0. Estimate €769 / €1,037 / €1,609 for 4 / 8 / 16 channels.
- 2026-10-11, schematic: the eight 10 µF bipolar coupling capacitors are now pairs of ROQANG 10 µF 35 V (SX-C-024) in series, − to −: C5+C21, C6+C22, C101+C108, C151+C158, C107+C109, C157+C159, C221+C235, C271+C285 (decision 161). New references C21, C22, C108, C109, C158, C159, C235, C285; R5/R6, R101/R151 and R201/R251 moved right for room; R112/R162 down 2.54 mm and TP102/TP152 to the left of the IV column for text clearance. Netlists match (input 48, filter 85, level 43 nets: +2, +4, +2 for the middle nodes), ERC 0/0, the drawings looked at. No part on the card is consigned now. `tools/costs.py estimate`: €778 → €768 / €1,040 → €1,024 / €1,600 → €1,571 at 4 / 8 / 16 channels (the master's 16 bipolars and the €30 handling remain until its session).
- 2026-10-13, RoHS: Electrokit sent the documents it received from its supplier (an SGS test report CANEC25029425315 of 2025-12-02 on the packaging house's SOP/SSOP families, an MSDS and a REACH report; in git-ignored `docs/rohs/`). The SGS report passes all ten RoHS substances on body and pins. The user accepted it as the source (decision 164) for SX-IC-001 (listed as 0.635SSOP16) and SX-IC-002 (not named; taken as the listed SOP10, same 3.9 × 4.9 mm body and 1.00 mm pitch); `parts.csv` records it. The maker, Sound Semiconductor, confirmed the same day: the report covers the whole SOP family, SSOP included, for both parts. The REACH report is not read yet (no PDF renderer on this Mac; RoHS does not need it).
- 2026-10-13, schematic (decision 165, the user's feature request, confirmed for the prototype point by point): cutoff CV chaining. New CV OUT jack J182 (PJ398SM) from FCV through U107B (R189 100k, R190 51k + R191 1k, R192 1k out): the channel's total cutoff control at 1 V/oct. Mode jumper JP181 on the underside (1-2 CV ONLY through J181's normal contact, 2-3 CV + POT); R181 300k → 200k (new SX-R-116) plus R188 100k. Summer clamp D184/D185 BZT52C11 back to back (new SX-D-018, JLCPCB preferred; datasheet facts in `parts.csv`): the SSI2144 datasheet's frequency pin range is −120 to +150 mV with a dropout above about +175 mV, which the unclamped summer could reach (about ±165 mV with the trim); clamped, the pin stays within about ±128 mV (`simulation/cutoff/`). Summer block moved 10.16 mm right for the jumper column. Filter netlist matches (92 nets, was 85: +8 new nets, SPARE_OA gone), ERC 0/0, the drawing looked at. `tools/costs.py estimate`: €761 → €764 / €1,017 → €1,022 / €1,564 → €1,573 at 4 / 8 / 16 channels, fee types unchanged (28). Breadboard test 13 checks the clamp knee, the real dropout and CV OUT.
- 2026-10-13, breadboard: the first Electrokit order arrived (the SparkFun SSOP adapter too). `breadboard.html` and its artifact refreshed to the parts in hand: E24 kit values (18k, 33k → 51k, 510 Ω, 470k, 160k, 300k), RV3 start about 9k (33k was the datasheet value for a 68.1k input), bipolar coupling caps, R82 film caps placed diagonally for their 5 mm pitch, C14/C15 10 µF at the supply entry, 1N4001s at the supply terminals, rail-continuity check; layout check passes. Test 13 needs zeners: Electrokit has no 11 V, so the second order carries a BZX55C10V and a BZX55C12V pair, measured both ways with C11 read between them. 2026-10-14: the SparkFun BOB-13994 adapter's pin rows are 500 mil apart, not 300: U1's pins now sit in rows d/g with rows e/f under the adapter kept free; C1, C2, C7, C8, C9, R1-R3, R6, R7, W5, W13 and the RV2 tag moved, link W14 added, the layout check passes and now rejects parts in pin holes or under a chip. 2026-10-15: the parts table lists each part's Electrokit SKU and type (film, C0G or X7R ceramic, polarised or bipolar electrolytic; 41037776 is probably the PC16SH pots, not confirmed). The kit lacks 200 Ω, 510 Ω, 160k and 300k: R2 = 2 × 100 Ω and R12 = 2 × 150k in series (exact), R4 and the R3 alternative 220 Ω, R7 470 Ω, R11 150k with RV5 near 42k, until the E24 values are ordered. RV4 (21h-23h, W15-W17) and the 1N4001s (D1, D2 across the rails at column 4) are on the board.
- 2026-10-14, SSI2144 package: Sound Semiconductor's package drawing PODPSSL16 (May 2024; the datasheet has none) gives a 16-lead SSOP, JEDEC MO-137-AB, 0.635 mm pitch, so "SSOP" (maker) and "QSOP" (KiCad) are the same outline. A chip from the first order measured within the drawing (body width 3.89, lead span 6.08, height 1.46, length 5.12 with end flash) and fits the SSOP-DIP adapter. U101/U102 keep `Package_SO:QSOP-16_3.9x4.9mm_P0.635mm`; footprint verified for layout. `parts.csv` SX-IC-001 and `CHECKLISTS.md` record it.
- 2026-10-15 to 10-17, breadboard tests on chip 1 (results in `simulation/filter/BREADBOARD.md`): bring-up clean once the ±15 V came from two single supplies in series and three build slips were fixed (R11 in pin 5's strip, poor contacts at R2 and RV3; RV3 is now a fixed 8.2 kΩ). Test 5: unity with the hot drive at 8.2 kΩ (+0.07 dB measured), medium drive (330 Ω) about 12.5 kΩ. Test 12: 1 V/oct needs 186 kΩ of feedback (about −18.4 mV/oct), inside RV182's 182-202 kΩ. Test 1: 17.5 Hz / 400 Hz / 9.7 kHz; the chip's tracking sags above about 5 kHz (0.57 octave short at +5 V CV, the same at ±12 V; the sag follows frequency, not pin voltage). Test 2: chip 1 never self-oscillates (up to about 790 µA) and peaks at k ≈ 1 near 410 µA; the Q network, capacitors and adapter joints check out, so a second chip is next. The datasheet (Rev 3.0, checked by `part-facts`) gives Q oscillation at 350-450 µA (typ 400), −18 to −20 mV/oct, 1000:1 for ±90 mV at ±12 V, and no maximum cutoff or tracking figure.
- 2026-10-17, schematic (decision 175, the user's go-ahead): the chain sheet has one audio header J501 (2×17, "AUDIO") and one power header J503 (2×4, "POWER") on the multi-drop cables; J502/J504 and the straight-through wiring are gone. SPARE2-5 (J501 pins 26-32) carry no-connect flags: the cable carries them past the card. Header notes say pin 1 toward the front. Chain netlist matches (22 nets, was 26: the four SPARE nets), the other five sheets unchanged and matching, ERC 0/0, the sheet looked at; root sheet unchanged (UUID-only churn restored). `power_budget.py` unchanged (110 / 93 mA typical, sizing 171 / 139 mA). `tools/costs.py estimate`: €801 → €792 / €1,087 → €1,069 / €1,686 → €1,650 at 4 / 8 / 16 channels.
- 2026-10-19, schematic (decision 181, the user chose the stock KiCad parts): J1 is now the Adam Tech BHR-12-VUA 2x6 box header (SX-CONN-024; Mouser 737-BHR-12-VUA), symbol `Connector_Generic:Conn_02x06_Odd_Even`, footprint `Connector_IDC:IDC-Header_2x06_P2.54mm_Vertical` (checked against the Adam Tech drawing figures; layout note in `CHECKLISTS.md`). Pinout as `docs/INPUT-MODULE.md`: 3 IN_L+, 4 IN_L−, 9 IN_R+, 10 IN_R−, AGND on 2, 5-8 and 11, DO_L/DO_R (1, 12) no-connect. J1 moved down between the two receivers; each side's AGND pins share one ground line and symbol; TP7 moved 7.62 mm right. `post_wired.py` gained an opt-in `field_at` title entry (J1's reference above, value below; nothing changes for sheets without it, the master included). Netlists match (input 48 nets as before, the others unchanged), ERC 0/0, the sheet looked at. `tools/costs.py estimate`: €813 → €812 / €1,075 → €1,073 / €1,689 → €1,687 at 4 / 8 / 16 channels.
- 2026-10-19, schematic (levers 1 and 2 of the commercial-console comparison, the user's choice): U302 (bus assign) and U303 (PFL) DG413 → CD4052BM96 (SX-IC-026, JLCPCB preferred), new U304 CD4052B for the SC send, each at the bus end of its bus resistor with the released PFL and SC throws on AGND (decision 183); VDD +5 V, VEE about −6.2 V from R505 10k and D507 BZT52C6V2 on the Chain and power sheet (PWR_FLAG, TP507); C303-C308 now +5 V / VEE decoupling. Drawn with the Analog_Switch:HEF4052BT symbol (passive switch pins, so ERC needs no relaxed rule). Trimmers RV101, RV151, RV182 → BOCHEN 3296W-1-503, LCSC C118911 (SX-TRIM-002, decision 184). Netlists match (routing 47 nets, was 46: VEE added; chain 23, was 22; filter 92, fields only), the other sheets unchanged and matching, ERC 0/0, the routing and chain sheets looked at. Power budget −15 V +1 mA (zener): 110 / 94 mA typical, sizing 171 / 140 mA. `tools/costs.py estimate`: €811 → €786 / €1,072 → €1,021 / €1,684 → €1,583 at 4 / 8 / 16 channels (channel card €48.48 → €42.10 per board).
- PCB: not started; waits for the breadboard (filter values).

## Provisional until the breadboard

`simulation/filter/BREADBOARD.md` tests 1-10 set R111/R161 (filter output scale, now 9k1 for the 18k attenuator; the breadboard uses the same 18k since 2026-10-13, so its value carries over directly) and R120/R170 (Q current limit, now 36k: about 281 µA maximum with R184 = 12 k, decisions 129 and 140). Keep any new value on E24 or an E24 pair (decision 140).

Measured so far (chip 1, 2026-10-17), not yet decided:
- R111/R161: **8.2k [proposed]** if the hot drive stays the default (9k1 would run about 0.9 dB hot); 12k or 13k with the medium drive. Settle with the drive choice (tests 4 and 7, REW).
- R120/R170: open; no chip has self-oscillated yet (test 2). 2026-10-20: chip 2 faulty or a bad joint, chip 1 damaged by a misplaced power-up after reaching k ≈ 1.5 at about 520 µA (776 µA measured into pin 14, no oscillation); loose ladder capacitor contacts on the breadboard found. Repeat on chip 3 with the capacitors soldered to the adapter.
- Cutoff range **[proposed, open]**: with the datasheet's capacitors chip 1 tops out near 9-10 kHz. Options: keep them and rely on the bypass for the full-bandwidth sound, or test smaller filter capacitors (3 × 3.3 nF + 270 pF) to move the sag up; the datasheet neither recommends nor rules this out. Decide after chip 2. RV182's range fits chip 1's scale.

Then edit `filter_wired.py` / `filter_build.py`, run `scripts/rebuild_all.sh`, and update `docs/decisions/channel-card.md`.

## Waiting on others

- **Decision 183 circuit details (the user's review):** the user chose the lever; the details are mine: three CD4052B (a third for the SC send), VEE about −6.2 V from R505 10k and D507 on the Chain and power sheet, released PFL/SC resistor ends on AGND, the HEF4052BT symbol. Bring-up checks in `CHECKLISTS.md`.

- **Alpha `-0057` suffix (left open by the user 2026-10-09):** the variant code on Thonk's three Alpha order codes is not defined in the RD901F spec; RV183 (Tayda) has none. Check the shaft and knurl of the Tayda RESONANCE pot against the Thonk pots on delivery.
- **RD902F dual specification:** not read yet (the Mouser RD901F PDF is blocked to scripts; the Tayda copy covers the RD901F single); confirm the dual's power rating when it is found.

- **Knobs:** after the pots (T18 push-on, up to about 19 mm across; for example Thonk Davies 1900H clone, Tall Satin Synthpointer, Mini MXR); need a RoHS source.

## Parts

Chosen (fields on the symbols, sources and RoHS in `docs/parts.csv`): regulators onsemi LM317D2TR4G / LM337D2TR4G; ROQANG SMD electrolytics, also as back-to-back pairs in the audio coupling positions (decision 161); Murata C0G low-cut caps; BOCHEN 3296W trimmers from LCSC (decision 184); TI CD4052BM96 bus switches (decision 183); Bourns PTA6043 fader; chain headers Würth 61203421621 (2×17) and 61200821621 (2×4); button LEDs JLCPCB basic 0805 (MUTE red NCD0805R1, PFL yellow KT-0805Y, SC SEND/DUCK/COMP BUS green KT-0805G, LOW-CUT/BYPASS white KT-0805W); CV jack Thonkiconn PJ398SM (decision 118). Printed in-house: button caps, the meter bezel (decision 119) and the 1 mm M6 washer for the CV jack (SX-MECH-004). Supply budget: `scripts/power_budget.py` (rerun after changing parts that draw current).

## Next

1. Breadboard, next session: solder the ladder capacitors C1-C4 and C9 onto the adapter header pins (their breadboard contacts were loose, 2026-10-20), fit chip 3 (the last in hand: chip 1 damaged, chip 2 faulty or a bad joint, `BREADBOARD.md` test 2), repeat test 2 and the 100 Hz bass-loss check, then the tracking points (CV 0 / +3 / +5 V) and test 12's second-chip row. If chip 3 also stays near k ≈ 1.5, write to Sound Semiconductor. Tests 4, 6 and 7 need the audio interface with REW. Plan (now with test 11, the back-to-back coupling pair against a bipolar, decision 161, test 12, fixed V/oct and drift, and test 13, summer clamp, dropout and CV OUT, decision 165) (second Electrokit order on hold: `simulation/filter/electrokit-order-2.csv`). Test 10 (fader law) wants one OPA2171 (SOIC-8, adapter) and one TL072; with two TL072s, skip the 0 % row (`simulation/filter/BREADBOARD.md`).
2. RoHS gaps: copy the orderable MPNs the audit checked (NE5532DR, LM339DR, DG413DY-T1-E3, LM13700MX/NOPB; CD4052BM96 is already the orderable code) into the MPN column at BOM time. At the next LCSC check run, add SX-R-089 (TFPT, Mouser-only: hand-solder or consign) and SX-R-090 to `docs/lcsc-check.csv` / `tools/lcsc_check.py`.
3. ~~Chain sheet for decision 175~~: done 2026-10-17 (J501 and J503 only).
4. PCB layout. Chain headers (decision 175, `docs/MECHANICAL.md`, Chain headers): underside, long axis front to back, pin 1 toward the front, key on a fixed side; record each header's distance from the front and position across the card in `MECHANICAL.md` (tell /system), with the end-segment lengths; keep-out band across the full width over each header's length plus 15 mm front and back; check header, socket and cable depth against the inside height at that distance (sloped floor, decision 162).

5. **78L05 U503 at the 57 °C design air (/system 2026-10-21), before layout:** `power_budget.py` gives 0.25 W worst case (0.14 W typical) from the raw 20 V; at about 357 °C/W (UTC's 350 mW SOT-89 rating, no thermal resistance given) that is about 146 °C junction worst case and 107 °C typical at decision 167's 57 °C inside air, above the usual 125 °C limit (UTC's TJ rating not yet in `parts.csv`: look it up). Candidates: an E24 dropper resistor in series with its input, feeding it from +15.1 V (moves about 0.25 W onto U501, already at 97-107 °C worst case, and adds to the +15 V load), or a larger package or another regulator; the choice is a new decision (next free number, `INDEX.md`, `record/`); redraw, rerun `power_budget.py`, and tell /system to update the `ARCHITECTURE.md` heat and local-rail rows. Also recheck U501/U502 at 57 °C air on the board's real copper weight (decision 110 assumed 2 oz and 40 °C; by hand U502 about 92-100 °C and 97-107 °C worst case for U501 on 36-45 °C/W, within 125 °C).

## For /system

- Settled by /system 2026-10-21 (the user): local regulation stays (invariant 3, decision 40); a regulated ±15 V from the power board is not pursued (shared-rail noise and ribbon drop would reach the rail-referenced controls; the 2026-10-10 review's scenario B). The card keeps its LM317/LM337 on copper, no heatsink. 78L05 heat: Next 5.

- Settled by /system 2026-10-20: decision 183's refinement of rule 69 is in `docs/decisions/system.md` (69) and the budget rows of `ARCHITECTURE.md`; the master's DG413s stay as they are.

- Settled by /system 2026-10-17 (decision 175): the dropped cable mock-up is replaced by multi-drop chain cables in 8-card sections; the card keeps one audio and one power header (drawn 2026-10-17; layout in Next 4).
- Settled by /system 2026-10-18: `CHAIN.md` and `ARCHITECTURE.md` now say SPARE2 to SPARE5 are carried by the multi-drop cable and left unconnected on the cards (wording only, no pinout change). The CV jack note below (row 3 beside the chain headers) applies only if row 3 falls over the header band.

- Settled by /system 2026-10-10: decision 152 refines 69 (a button pole may switch a DC control voltage when the wiring does not depend on the contact sequence and a smoothing ramp follows; the board already meets both) and confirms the scope wording; the input impedances are in `docs/INPUT-MODULE.md`. Keep conditions (a) and (b) of 152 if MUTE/DUCK are redrawn.

- Decision 160 (2026-10-11): the input module stands on edge below the rear rail. At layout, place the input header near the rear edge, within reach of the 150 mm IDC flat cable (decision 181), and report its position. The sloped frame changes nothing on the card.
- Settled by /system 2026-10-13 (decision 166): J181 (CV IN) and J182 (CV OUT) side by side in panel row 3, IN left, OUT right, 16 mm between centres, each 8 mm from the strip centreline, pins along the strip as the footprint draws them. At layout: if row 3 falls beside the chain headers, the jack pins (8.5 mm from the PCB edge) sit inside the 10 mm underside keep-out of item 121; clip them flush or move the header distance. A CV patch cable between cards is allowed (`CHAIN.md`, Grounding). JP181 follows the underside zone rules (items 112, 121).
- Decision 162 (2026-10-11): single front rail, 20 mm inside at the front: keep underside parts (trimmers, jumper headers) at least about 40 mm behind the front rail's inner face (the card's front edge sits 1 mm behind it). Chain 1's power feed plugs into the power OUT header of the card next to the master; nothing changes on the card.
