plektra/syntsamix/docs/CONTINUE-FROM-HERE.md

# Continue from here

Project-level handoff, updated 2026-10-21 (/system: local regulation on every card kept, the user; channel 78L05 too hot at 57 °C air, `hardware/channel-card/STATUS.md` Next 5). Read `CLAUDE.md` first. Board detail lives in each board's `STATUS.md` and `CLAUDE.md`; shared schematic workflow in `hardware/CLAUDE.md`; decisions in `docs/decisions/` (start at `INDEX.md`; area files hold short current rulings, `record/` the full text, decision 154).

## Boards

| Board | Schematic | PCB | Status file |
|---|---|---|---|
| Input module | done, ERC 0/0; position on edge, jacks stacked (decision 160); 2026-10-19: input header J3 redrawn as the Adam Tech 2x6 box header (decision 181) | not started | `hardware/input-module-6p3/STATUS.md` |
| Channel card | done, ERC 0/0; mechanical parts chosen and settled with /system 2026-10-09 (decisions 110-122); meter LEDs 0805 and op amp power levers drawn (decision 123); pot MPNs on the symbols, R184 12 k for the RESONANCE pot rating (decision 129); TFPT tempco pair (decision 130); 2026-10-10 (delegated): U303 DG413 (decision 139), all values E24 with fee-free parts (decision 140), tempco to the backlog (141), MUTE/DUCK by the buttons (142), TL072 receiver (143); trimmers from Mouser, CUTOFF pot from Tayda; R217 30k (153); SSI2144 and SSI2162 hand-soldered on the prototype (155); 2026-10-11: coupling capacitors as back-to-back ROQANG pairs, nothing consigned (161; the master follows); 2026-10-13: cutoff CV chaining, CV OUT jack, CV ONLY / CV + POT jumper and a zener clamp on the cutoff summer (165; panel row: CV IN and OUT side by side, decision 166) ; 2026-10-17: chain sheet down to one audio and one power header J501/J503 (decision 175); 2026-10-19: input header J1 redrawn as the Adam Tech 2x6 box header (decision 181); bus assign, PFL and SC send on CD4052B (decision 183) and LCSC trimmers (decision 184), about €6.40 per card less | not started (waits for the breadboard; SSI2144/SSI2162 RoHS source accepted 2026-10-13) | `hardware/channel-card/STATUS.md` |
| Master card | done, ten sheets, ERC 0/0; decision 162 rework in progress: rear ribbons J603/J903 drawn (163, 26-pin, row boards still to draw after measuring an NYS216), headphone jack J751 done 2026-10-13 (KK header for a panel NYS230); meter and GR LEDs 0805 done 2026-10-13; underside heatsinks on hold (none fits; recheck at decision 167's 57 °C air, master STATUS); pre-layout session 2026-10-09: open points of 89-94 confirmed, DRV135 replaces the end-of-life THAT1646, TL062 levers, SMD electrolytics, both raw rails watched (decisions 125-128); RELEASE pot C100K for the pot rating (decision 131); SC LPF pot RV501 a standard B100K dual (decision 138); 2026-10-10: fee-free parts and E24 values throughout (decisions 144, 146, 147), AUX return receivers TL072 difference amplifiers (148, the AD8273 is gone from the project), R421 a plain 1k (149, temperature compensation to the backlog), DG413/SSI2162/DRV135/AS3046D hand-soldered on the prototype (150); R232/R332 30k (153); 2026-10-17 (delegated): U901/U902 onsemi LM317TG/LM337TG (TI LM317KCSE3 NRND), the 16 bipolar 10 µF as back-to-back ROQANG pairs including the DRV135 sense capacitors (172, nothing consigned), power budget at 57 °C inside air; ten NE5532 → TL072 (173); regulator heatsinks Wakefield 637-10ABPE with the junction limit at the 125 °C rating (174; zone at least about 190 mm behind the front rail, decision 176); AUX return MUTE/DUCK on the buttons, U208/U308 DG413 removed (177, delegated; `CHECKLISTS.md` brought to decisions 174-175) | not started (waits for the decision 162 schematic rework) | `hardware/master/STATUS.md` |
| Power board | done, four sheets, ERC 0/0; power bay form and two module sizes (decision 162); values confirmed, start-up ramp added; full-size brick GSM220B24-R7B (decision 145); converter dividers on fee-free E24 values (decision 156); power switch a rear-panel rocker on J102 (decision 157); C103 and sync capacitors chosen (decision 158); D201 SS54 on SMA (decision 159); power LED on the bay's top strip via J103 (decision 168); 2026-10-19/20: panel-mount brick jack wired to J101 (182), small module without chain 2 (185); 2026-10-20: input EMI pi filter C108/L101 after Q102 (187), DNP switch-node snubber footprints (189) | done 2026-10-20, reviewed by the user: 2 layers, 177 × 35 mm referenced to the panel, two brackets to the top strip (186); DRC clean; built by `scripts/build_pcb.sh`; rebuilt with the input filter (187) and snubber footprints (189), reviewed by the user | `hardware/power/STATUS.md` |
| Chain coupler | not needed for the prototype: two shrouded 2x17 headers joining the 8-card audio cable sections, drawn before the first build of more than 8 cards (decision 175) | not started | (none yet; `docs/MECHANICAL.md`, Chain headers) |
| Rear row boards (master; output and input) | not started: new KiCad projects, jacks + 26-pin header (+ SW901 on the input board), pinouts decision 163; measure an NYS216 sample first | not started | `hardware/master/STATUS.md` |

Decisions 1-191; last pushed commit: see `git log -1`.

## Order of work

1. **Decision 97 and 98 board changes**: done on the channel card (with decision 102) and on the master card (2026-10-08, with decisions 103 and 104: master fader-law op amps on OPA2171s, SC_ENV from a negative DEPTH through the existing follower). Remaining before layout: the checks in each `STATUS.md` (master power levers done, decision 126).
2. **SSI2144 breadboard**, in progress (`simulation/filter/BREADBOARD.md`, results in its tables): chip 1 measured 2026-10-15 to 10-17 (output scale 8.2k [proposed] for the hot drive, V/oct 186 kΩ, tracking sags above about 5 kHz, resonance too weak: never oscillates). 2026-10-20: chip 1 reached k ≈ 1.5 at about 520 µA on a steadier board (still no oscillation), loose ladder capacitor contacts found, chip 2 faulty or a bad joint, chip 1 then damaged by a misplaced power-up. Next: solder the ladder capacitors onto the adapter, fit chip 3 (the last in hand) and repeat test 2 first; tests 4, 6 and 7 need the audio interface with REW. It settles the provisional filter values on the channel card (`hardware/channel-card/STATUS.md`).
3. **Channel card schematic touch-up**: done 2026-10-09 (meter LEDs 0805, decision 119; power levers, decision 123).
4. **RoHS audit** (decision 122): done 2026-10-09, report `docs/reviews/2026-10-09-rohs-audit.md`. Gaps: the declaration for the AS3046D (master; the SSI2144 and SSI2162 are cleared by an SGS package report via Electrokit, decision 164; the Alpha pots are cleared by Alpha's declaration, decision 124), and the rows with no part chosen yet. The end-of-life parts are gone: ERA-V33J102V (no tempco part on either board, decisions 141 and 149) and THAT1646 (DRV135UA, decision 125).
5. **Chain cables (decision 175, 2026-10-17):** the dropped mock-up is replaced by multi-drop flat cables in 8-card sections (audio sections joined by a coupler board, one power section per group), hand-crimped by the user. Cable: Würth WR-CAB 28 AWG, 1 A max at 25 °C, 34-way and true 8-way in 1 m cuts (decision 178; the unrated 3M 3365 is dropped from the chain); confirm its derating before a full group of 8, and check mid-cable use on the first socket delivery (`CHAIN.md`). Board follow-ups in the channel, master and power `STATUS.md`. Chain cables are costed on their own line of `tools/costs.py` since 2026-10-17 (sections per build, lengths in `docs/costs/overheads.csv`): €38 for 4 or 8 channels, €93 for 16 (two sections, a coupler and its PCB; Würth WR-CAB cable, decision 178); the 2x4 power sockets (€1.75) are about half of it: a cheaper 2x4 socket is the open lever (candidate in `prices.csv`).
6. **Master schematic rework for decision 162** (`hardware/master/STATUS.md`, Next): rear ribbons on the master done (decision 163); still the two row board projects (measure an NYS216 sample first); underside heatsinks chosen (decision 174), their zone is settled by decision 176 (meter and GR LEDs 0805 done 2026-10-13); the headphone jack is done (J751 KK header, panel NYS230, ready-made Molex lead, 2026-10-13). Input-module cable: a self-made 12-way IDC flat cable on Adam Tech 2x6 box headers replaces the Molex lead (decisions 180, 181; about €16 saved at 4 channels, €66 at 16), misplug-safe pinout in `docs/INPUT-MODULE.md`; before the channel card layout both boards redraw their input header in `/board` sessions (channel card J1 and input module J3 done 2026-10-19) (`hardware/channel-card/STATUS.md`, `hardware/input-module-6p3/STATUS.md`).
7. **Power board PCB: done** (2026-10-20, decisions 182, 185, 186): placed and routed by scripts (`hardware/power/scripts/build_pcb.sh`; workflow lessons in `hardware/CLAUDE.md`, PCB workflow), reviewed by the user. Power bay settled by /system 2026-10-20 (decision 188): board back face 6 mm from the cheek, master heatsinks at least 10 mm inside the master card's right edge, inverted-L printed brackets to the top strip's centreline, LED hole about 290 mm behind the front rail, chain cables cross under the master in front of the heatsink zone; the bracket drawing goes to the power board session. Still to report: the converters' efficiency for `tools/heat_budget.py`. One JLCPCB order for all boards stays the plan.
8. **Channel card PCB** (after the breadboard; its floorplan with a free filter zone may start earlier: it sets the chain header positions the master needs), then the input module and master card (with its two row boards) PCBs.
9. **Prototype bring-up:** with the heat measurement of decision 167 (probe at the master heatsinks and over the middle channel card, one hour with every LED lit); its result replaces the estimates in `tools/heat_budget.py` and settles the full-size cooling. Power board EMI on the first boards: ripple on the brick lead and switch-node ringing, snubber values if needed (decisions 187, 189; `hardware/power/CHECKLISTS.md`, "Bench, first boards").

## System

Cross-board budgets, chain lines and invariants: `docs/ARCHITECTURE.md` (budgets rerun after decision 123 on 2026-10-09). Mechanical contract `docs/MECHANICAL.md`: strip envelope, panel stack, card fixing and chain headers settled (decisions 106-109), jack sizes, channel meter bezel, single panel screw, underside and bottom cover (decisions 118-121); rear strips, input module on edge with stacked jacks, sloped frame (decision 160); master section (4 strips, rear jacks on two row boards, headphones on the top panel), power bay with two planned module sizes, single front rail, chain 1 next to the master (decision 162); invariant 9 RoHS (decision 122); CV IN and OUT side by side (decision 166); passive ventilation, design point 22 K above room (decision 167, `tools/heat_budget.py`); multi-drop chain cables with a header-band keep-out (decision 175); power bay layout and master heatsink keep-out (decision 188); still open: the header positions (channel layout) and the full-size cooling after the prototype measurement. Flags from board sessions sit under "For /system" in each `STATUS.md`. Validator reports: `docs/reviews/`.

## Waiting for the user's confirmation

- Channel card: decisions 139-143 (made under the user's delegation 2026-10-10) reviewed and accepted by the user 2026-10-17. Lever 11 settled by decision 155 (the user hand-solders the SSI2144 and SSI2162 on the prototype). The prototype-scope button wording and the refinement of decision 69 were confirmed by /system (decision 152).
The master's proposals (89-94, power levers) were decided on 2026-10-09 with the user's delegation (decisions 125-128; review them in `hardware/master/STATUS.md`).
- Master card: 144, 146-150 and 177 confirmed by the user (147 on 2026-10-17); nothing waiting.

- **Cost (2026-10-09):** the user asked for a large cost cut, then set the frame: the prototype is 4 channel cards, maybe 2 (first trial-and-error versions); the full 16-channel console's cost stays in view for a possible product; the ladder filter stays (rejected as a fitting option). Estimates from `tools/costs.py` (2026-10-11, after decisions 139-159: €764 / €1,045 / €1,641 for 4 / 8 / 16 channels, 28 fee types; 2026-10-13, with every off-board part counted through `docs/costs/offboard.csv` (rear jacks, cables, ribbon sockets, row-board PCBs; the user: nothing is left out, decision 171): €834 / €1,113 / €1,696; after the 0805 master LEDs (170) €831 / €1,110 / €1,693; 2026-10-17, after decisions 172-174 and the consignment fix in `costs.py`: €801 / €1,087 / €1,686; after the channel chain sheet of decision 175 (one header pair per card): €792 / €1,069 / €1,650; with the chain cables counted on the rated Würth cable (175, 178): €827 / €1,105 / €1,740; 2026-10-21 cost review (`docs/reviews/2026-10-21-cost-system.md`, after 181-184): €793 / €1,028 / €1,590, 2 channels €683; the 27 hand-soldered chips stay on the first prototype, production machine-places them (decision 190); the realistic builds set by the user, before VAT and shipping) and levers: `docs/ROADMAP.md`, Cost review; board levers in each `STATUS.md`. Done: Rean NYS216 jacks (decision 132); through-hole parts hand-soldered by the user (decision 133). Value selection is each board's own job (decision 134: E24 by default; off-series lists in each `STATUS.md`). Cost principle: live device, not studio gear (decision 135). Fee-free JLCPCB parts first: basic, then preferred (decision 137; candidates in the board STATUS files). Cost control: `/cost <scope>` (cost-controller sub-agent), `tools/costs.py`, and the private ledger of realized costs, `/cost ledger` (decision 136); the first Electrokit breadboard order is recorded. 2026-10-10: ±15 V rails reviewed and dropped as marginal (`docs/reviews/2026-10-10-cost-system-15v-rails.md`); one power input only (the user rejected two bricks); full-size brick GSM220B24-R7B (decision 145). Open, all [proposed]: prototype fees (one JLCPCB order, the two-board minimum), and the per-channel levers for the console (cheaper and fewer trimmers; the receivers and DG413s are settled by decisions 139, 142, 143 and 148; fee types shared by both boards, 220p C0G, TL062 and LM339, in `hardware/channel-card/STATUS.md`).

## Pending outside the boards

- Second Electrokit order, placed by the user 2026-10-20 (record its total with `/cost ledger` when invoiced): `simulation/filter/electrokit-order-2.csv`, now with three ProtoPCB EKB14 boards for a soldered filter core, three SSI2144 (chip 1 damaged, chip 2 faulty) and the E24 resistors the kit lacks (33k, 200 Ω, 510 Ω, 160k, 300k). Not needed to start the breadboard (tests 1-7 and a reduced test 10 run on the first order, `BREADBOARD.md`); release it for tests 8, 9 and 13 (BZX55C10V and BZX55C12V pairs: Electrokit has no 11 V zener) and for the GPBS850L buttons (button cap prints and LED brightness). The full test 10 also needs an OPA2171 on an SOIC-8 adapter (Mouser or LCSC).
- Next near-future order: include about 3 Rean NYS216 jacks as samples, from Tayda with the channel's CUTOFF pot (Tayda lists Rean as the maker, $0.70, 2026-10-13). The master rear row boards wait on its height (at most about 17 mm above the board, decision 162), and its pin roles must be checked with a meter before the input module or master PCBs are ordered (decision 132). No sample on hand (2026-10-13).
- RoHS declaration requested by the user (2026-10-09, by email) for the AS3046D (master); without it the part blocks the master's PCB order. The SSI2144 and SSI2162 (channel) are cleared: Electrokit forwarded its supplier's SGS package report (2026-10-13, `docs/rohs/`, accepted by the user); Sound Semiconductor (the maker) confirmed the report covers both part numbers.
- Panel pots: Taiwan Alpha's RoHS II declaration (via Thonk, 2026-10-09) covers every standard Alpha pot (decision 124): the four channel pots are cleared, the master's Alpha pots get their source when chosen. Supplier declarations live in git-ignored `docs/rohs/` (not ours to publish).
- RoHS is strict for every part on every board (decision 116): record a `RoHS: <source>` in `docs/parts.csv` when choosing a part.
- Ground-lift switch part to choose (decision 61), with the master's input row board.
- Backlog (now including mains power: external linear box or internal supply, decision 101), cost-cut and power-cut candidates: `docs/ROADMAP.md`.

## How the user likes to work

- Commit and push only when asked; pause for review before each commit.
- "Commit & push" means Claude puts the commit on `main` on origin itself; from a background worktree: `git push origin HEAD:main` (fast-forward only, rebase first if main moved, never force; allowed by the rule in `.claude/settings.json`). The user does not merge or push by hand.
- Give a recommendation with alternatives; one topic at a time; tight budget (flag cost-cut candidates).
- Mark proposals as proposed until confirmed; ask before changing a confirmed decision.
