plektra/syntsamix/docs/ROADMAP.md

# Roadmap

## Phases

1. **Specification** *(done: spec v0.7, decisions 1-69, chain pinouts in CHAIN.md, input module interface in INPUT-MODULE.md)*. Supply rating for 16 cards settled by decision 96 (system decisions 96-99 settle the 2026-10-06 system validation)
2. **Simulation and breadboard**: filter simulated in ngspice *(done, `simulation/filter/`)*; channel fader law and ducking *(done, `simulation/level/`)*; SSI2144 breadboard *(parts ordered; plan, schematic, layout and BOM in `simulation/filter/`)*. compressor side chain and sidechain/ducker simulated in ngspice *(done, `simulation/compressor/`, `simulation/sidechain/`)*. Later: VCA and compressor detector on the breadboard, sidechain LPF
3. **Input module** (`hardware/input-module-6p3`): schematic *(done, ERC clean)*, then PCB
4. **Channel card** (`hardware/channel-card`): schematic *(done)*, mechanical parts *(chosen 2026-10-09, decisions 110-122; pots RoHS-cleared by Alpha's declaration, decision 124; meter LEDs drawn)*, then PCB
   - Input: header, TL072 difference receiver (decision 143), trim with soft clip, 100 Hz low-cut, DG413 switching *(done, ERC clean apart from sheet links)*
   - Filter: 2x SSI2144, LM13700 Q VCA (resonance compensation), cutoff summer and CV, drive and compensation jumpers, DG413 bypass *(done, ERC clean apart from sheet links; output scale and Q limit provisional until the breadboard)*
   - Level: SSI2162 VCA, 3-segment fader law, mute and DUCK switched by the buttons (decision 142) *(done, ERC clean apart from sheet links)*
   - Routing: pre-fader buffers, AUX sends with pre/post jumpers, bus assign, PFL and SC send, PFL_ACT driver *(done; outputs wait for the Meter and Chain sheets)*
   - Meter: 8-segment peak meter (full-wave superdiode peak detector, LM339 comparators) *(done)*
   - Chain and power: ribbon connectors, ±15 V regulation, +5 V logic supply, test pads for the rails and PGND *(done; schematic complete, ERC 0 errors 0 warnings)*
5. **Master/compressor card** (`hardware/master`): schematic sheet by sheet *(schematic complete: ten sheets, ERC 0/0; decisions 97, 98, 103, 104 drawn; pre-layout parts session 2026-10-09, decisions 125-128)*, then the decision 162 rework (rear ribbons J603/J903 drawn 2026-10-12, decision 163; still the two passive row board projects after measuring an NYS216, panel-mounted headphone jack and 0805 meter LEDs done 2026-10-13; 2026-10-17: back-to-back coupling pairs (172), ten NE5532 → TL072 (173), Wakefield 637-10ABPE heatsinks (174, enclosure depth to /system)), then PCB with the two row boards
6. **Power board** (`hardware/power`, decisions 81, 100): 24 V brick input, protection, non-isolated TPS54560 buck and inverter to ±20 V; *(schematic complete, ERC 0 errors 0 warnings; PCB done 2026-10-20: the small module, master and chain 1, 177 × 35 mm on edge in the power bay, decisions 182, 185, 186)*; the full-size module (chain 2, about 4 A per rail) after the prototype cards are measured
7. **Prototype build and measurement** against the targets in SPEC.md section 5

## Backlog (after the prototype)

- Channel HPF
- Filter temperature compensation (decision 141): put a +3300 ppm/K resistor back in the SSI2144 FREQ leg (R108/R158, now a plain 820 Ω with 180 Ω; Vishay TFPT 820 Ω +4110 ppm/K as in decision 130, in 0805 or with a 0603 footprint) if breadboard test 12 or the prototype shows the cutoff drifting audibly with warm-up
- Compressor detector temperature compensation (decision 149): put a +3300 ppm/K resistor back as R421 (Vishay TFPT 820 Ω + 180 Ω pair as decision 130, or another 1k +3300 ppm/K part) if the prototype's compression drifts audibly as the case warms up (simulated: threshold about 2 dB over 15-45 °C without it)
- Hand-soldered master ICs as a potential single point of failure (decision 150): the prototype's master has DG413 ×8 (decision 177), SSI2162 ×4, DRV135UA ×2 and AS3046D soldered by hand; one bad joint can silence the whole mixer. The channel cards' SSI2144 ×2 and SSI2162 are hand-soldered too (decision 155). A production build machine-places every SMD part (decision 190; under €1 per mixer at 100 mixers); before that, settle SSI2144/SSI2162 sourcing at volume (maker minimum order), JLCPCB consignment terms (tubes or reels), panelling the 318 mm channel card above 30 boards, or a contract manufacturer that sources the parts itself (`docs/reviews/2026-10-21-cost-system.md`). If the prototype shows joint trouble, return them to JLCPCB placement earlier (remove the Assembly field)
- Digital output per channel for recording: ADAT or similar
- More input modules (the interface exists from the prototype, `INPUT-MODULE.md`): 3.5 mm, D-SUB bundle, XLR
- More CV control options
- Pre-fader direct output per channel for multitrack recording (input header pins 1 and 12, DO_L and DO_R, already reserved, decision 181; jacks on the input module)
- Momentary buttons with flip-flop logic and LEDs instead of latching switches, enabling CV/MIDI control and mute groups over the spare chain lines. Must keep button states through a power cycle (for example after a power cut during a gig), so the states need non-volatile storage (FRAM or microcontroller EEPROM) restored at power-up
- Insert points on the channel strips
- Power modules in two sizes for the power bay (decision 162): one for up to 8 channel cards (the prototype design) and one for larger builds, so small units do not pay for the full-size supply
- Microphone channel strip: mic preamp input (XLR) for vocals or acoustic sources
- Expansion to 32 channels: a power section for each further group of 8 cards (decision 80), mixing amps sized for 32 inputs (about 3 dB more bus noise), two frames of 16 strips linked by a coupler board and a longer audio section (decision 175). Channel cards and pinouts stay unchanged
- (Done: channel meter decision 119, master meter decision 162; the master's PCB step is still to do) 3D-printed LED bar diffuser for the meters: an opaque printed bezel with square windows (for example 4 x 4 mm at 5 mm pitch) and a translucent diffuser over 0805 SMD LEDs, replacing the round 3 mm meter LEDs (decision 86). Same look as the printed button caps; walls between the windows stop light bleeding between segments
- Mains power (decision 101): an external linear supply box (mains and toroid in their own earthed box, ±20 V on a locking connector; the power board shrinks to protection and fusing) or an internal mains supply (Class I, safety earth to the chassis, ground lift between signal ground and chassis). Either must keep the supply output floating (invariant 8)
- Mixer variant with external channel strips, for bands or groups of performers who each connect and control their own instrument submix
- Longer-life channel fader (decision 48): TT Electronics PS60-10MC2BR10K (PSxx Issue B, 11/2020): same 75 × 9 × 6.5 mm body, M2 holes 71 mm apart and 15 mm metal lever as the PTA6043, rated 100,000 cycles instead of 15,000; check its pin pattern against the PTA footprint. A factory order at Mouser (3,600 minimum, about 1.25 € each, 2026-10-09); the 20 and 25 mm lever versions (MC4, MC5) would allow a taller panel gap (decision 107) if the pots change too

## Cost-cut candidates

Decisions that can fall back to a cheaper option if the budget needs it:

- Main balanced outputs: THAT1646 line drivers → NE5532 buffer + inverter (decision 83; the THAT1646 is now the DRV135UA, decision 125, about €3.40 each)

### Cost review 2026-10-09

The user asked for a large cost cut (2026-10-09), then set the frame: the prototype is 4 channels, maybe only 2 (first trial-and-error versions of the channel design); the cost of a full 16-channel console must stay in view in case it becomes a commercial product; the ladder filter stays, being the feature that sets this mixer apart. On 2026-10-10 the user set the realistic builds to track: 4, 8 and 16 channels (`python3 tools/costs.py estimate` shows them side by side). Prices below are rough, before VAT and shipping, from the four schematic BOMs (20-50 pieces; LCSC and Mouser checks on 2026-10-09 for the DG413DY, DRV135UA, PTA6043 and the jacks, the rest estimated, so ±25 %). Through-hole parts are hand-soldered by the user (decision 133).

**Figures from `tools/costs.py` (decision 136), 2026-10-09:** the schematic BOMs priced from `docs/lcsc-check.csv` and `docs/costs/prices.csv`, with the overheads in `docs/costs/overheads.csv`. About a third of the part prices and every overhead figure are estimates (marked in those files), so treat the totals as ±25 %. Rerun `python3 tools/costs.py estimate` for current figures (4, 8 and 16 channels; `--channels N` for one build in detail).

| Build | Total |
|---|---|
| Prototype, 4 channels | ~€1,115 (2026-10-10: €941; after decisions 144-150: €794; after 153, 155: €788; 153 on the master: €785; power board 156-159, 2026-10-11: €764; latching button price, JLCPCB fees per design at $3.07, Thonk volume breaks: €778; 2026-10-13, every off-board part counted (`docs/costs/offboard.csv`: rear jacks, cables, ribbon sockets, row-board PCBs, decision 171): €834; 0805 master LEDs, decision 170: €831; 2026-10-17, decisions 172-174: €801; chain cables counted, decision 175: €833; rated Würth cable, decision 178: €839; with the channel chain sheet of 175: €827) |
| 8 channels, one power board | €1,221 (2026-10-10; after decisions 144-150: €1,074; after 153, 155: €1,069; 153 on the master: €1,066; power board 156-159: €1,045; button, fee model, breaks: €1,040; off-board parts counted, 2026-10-13: €1,113; decision 170: €1,110) |
| Series of 8-channel mixers, one order (`tools/costs.py sets`) | per set €1,040 / €854 / €784 / €772 for 1 / 5 / 10 / 20 sets (2026-10-11); from 5 sets the channel cards go to Standard PCBA (over 30 boards), panelling the 33 mm card not priced; volume breaks only where known (Thonk) |
| Full console, 16 channels, ordered like the prototype | ~€2,110 (2026-10-10: €1,818; after decisions 144-150: €1,671; after 153, 155: €1,665; 153 on the master: €1,663; power board 156-159: €1,641; button, fee model, breaks: €1,600; off-board parts counted, 2026-10-13: €1,696; decision 170: €1,693) |

The 2026-10-10 figures include decisions 139-143 and 145. The 8-channel build assumes one power board carries 8 cards plus the master (power lever 1's open check); the 16-channel figure still prices one power board, although the full-size supply is not designed yet (decision 100).

The 4-channel prototype in detail:

| Item | EUR |
|---|---|
| Channel card parts (4 boards, about €65 each) | 261 |
| Input module parts (4) | 7 |
| Master parts (JLCPCB assembles at least 2 boards per design, so a second set of SMD parts) | 182 |
| Power board parts (2 assembled) | 30 |
| JLCPCB fees (82 extended or consigned types, 3 assembled designs, placements) | 343 |
| PCBs | 75 |
| FR4 panels | 55 |
| Frame, hardware, ribbons, 24 V brick | 110 |
| Knobs and fader caps | 22 |
| Consigned parts handling | 30 |
| **Total** | **1,115** |

These replace the first hand estimate of the same day (prototype about €1,450, console about €2,600), which guessed about 130 extended part types (the BOMs have 82 once JLCPCB's fee-free "preferred" parts are counted, decision 137) and a higher channel card cost (about €75; the BOMs give about €65). Includes decisions 130 and 131 (TFPT tempco pair, RELEASE C100K). At prototype size the JLCPCB fees are about a third of the cost; at 16 channels the channel cards are about half. The full-size power board still needs its 4 A design (or power lever 1).

**Update 2026-10-10** (system cost review, `docs/reviews/2026-10-10-cost-system.md`): with JLCPCB Economic PCBA set-up (about €9 per design instead of €35), current prices and seven fee types the tool had missed, `tools/costs.py` gives about €885 / €1,035 / €2,009 for 2 / 4 / 16 channels; about €60 more at 4 channels if JLCPCB bills shared extended types once per design (`--fees-per-design`, unverified). New levers are in each board's `STATUS.md`, Cost-cut levers. After the channel decisions 139-143 and the brick prices of decision 145 (prototype GSM120B24 €44.60, full-size GSM220B24 €72.90 at TME, now taken from `docs/costs/prices.csv`): €941 / €1,221 / €1,818 for 4 / 8 / 16 channels; the brick line in the table above is then €105 at 4 channels (€125 at 8, €193 at 16).

**Update 2026-10-19** (comparison with commercial analog consoles: Midas, Soundcraft, Harrison 32, Allen & Heath, Yamaha): the user took levers 1 and 2, LCSC BOCHEN trimmers (decision 184) and CD4052B switches at the virtual-earth bus ends (decision 183): €811 → €786 / €1,072 → €1,021 / €1,684 → €1,583 at 4 / 8 / 16 channels (channel card €48.48 → €42.10). The other levers (DRV135 → op-amp balanced outputs, passive master level, pot and button sourcing) were judged too small to pursue; low-cut and bypass as virtual-earth switches and the master's DG413s are noted in `hardware/channel-card/CHECKLISTS.md`.

**As a product:** at production volume the set-up and extended-part fees spread over many units and the per-channel parts become the cost, together with labour: through-hole assembly (hand-soldered here, decision 133, not in a product) and calibration (three trimmers per channel: CUTOFF OFFSET ×2 and V/OCT, plus the TRIM and drive/Q jumpers). Per-channel levers therefore count sixteen times per console, and anything that removes a trimming step saves labour on every channel.

Levers [proposed] (board details in each `CHECKLISTS.md`, "Cost-cut levers"):

*For the prototype (fixed costs):*

1. **JLCPCB fees:** one order for all boards (shared part types pay their fee once), and fewer extended types: JLCPCB basic or preferred (fee-free) parts wherever one fits (decision 137; candidates in each board's `STATUS.md`, all types with a fee from `python3 tools/costs.py extended`). Value selection is each board's job (decision 134: E24 by default, justified exceptions listed in the board's `STATUS.md`, "Component values"; now 25 types on the channel card, 23 on the master, none on the power board since decision 156). Up to about €100-150 per order.
2. **The second master and power board:** JLCPCB's two-board minimum buys a spare; place only one fully and leave the spare for repair, or hand-place the spare's SMD parts later. Check JLCPCB's current minimum and partial-assembly options when ordering.
3. **Start with 2 channels:** about €150 less, at the cost of not testing 3- and 4-card chain effects (bus noise, chain current).

*For the full console and a product (per channel, ×16):*

4. **Op-amp receivers instead of the AD8273** (done 2026-10-10: channel decision 143, AUX returns decision 148) (channel and AUX returns): about €4.50 per channel (€80 at 16) and one part fewer to consign; costs CMRR and needs the input stage checked again.
5. **Fewer DG413s** (channel: done 2026-10-10, decision 142, one DG413 fewer) (4 per channel, about €1.90 each) by using VCA control for mute and DUCK: about €2-4 per channel. 2026-10-19: bus assign, PFL and SC send moved to CD4052B (decision 183), two DG413 left per channel (low-cut, bypass).
6. **Cheaper trimmers** than the Bourns 3296W: about €4 per channel; and for a product, fewer trimmers (each is a calibration step).
   - Note (2026-10-10): the channel trimmers are now bought at Mouser to keep the hand-soldered parts in one order (652-3296W-1-503LF, €1.58 at 10+, €1.38 at 25+). The same Bourns part is cheaper at LCSC (C83686, 0.75 USD at 10+, 0.64 USD at 50+): about €0.90 less per trimmer, €2.70 per channel card (3 trimmers), about €11 for 4 channels and €43 for a 16-channel console. Worth switching if the order goes to LCSC/JLCPCB anyway.
7. Done: Rean NYS216 jacks instead of the Neutrik NMJ6HCD2 (decision 132), about €1.15 per jack. For a product, recheck the 1,000-cycle rating against the inputs' expected use (the Neutrik is rated over 10,000).
8. **Settled by decisions 180 and 181 (2026-10-18): self-made 12-way IDC flat cable on Adam Tech 2x6 box headers instead of the Molex lead**, saving about €16 at 4 channels and €66 at 16 (`docs/reviews/2026-10-18-cost-input-module-6p3.md`); the boards redraw their headers. History: **Cost watch: ready-made input-module cables** (agreed by the user 2026-10-13 to avoid hand crimping; decision 179): Molex 217796-1101 at about €4.80 (€4.00 at 25+) against about €1.60 for housings and crimps, so about €13 more on the 4-channel prototype and about €40-50 at 16 channels. Levers to check later: a cheaper ready-made source with a RoHS statement, a longer stock length cut and re-terminated (needs crimping again), IDC (a 2x6 or 2x7 header on both boards, see below: contract change), or a crimp tool once the volume justifies it. **To check (the user, 2026-10-17):** whether a simple input module with a self-made IDC ribbon (flat cable and two IDC sockets, one press each, the same tool as the chain cables of decision 175) is cheaper and less manual work than the ready-made Molex lead. Constraints: a 2x5 (10-pin) header is the Eurorack power size that decision 41 keeps off the unit, and 2x4, 2x13 and 2x17 are taken by the power, rear and audio ribbons, so a 2x6 or 2x7 header (spare pins as grounds) is the likely size; it changes the input header contract (`docs/INPUT-MODULE.md`, decisions 68, 99, 105, 179) and both boards' footprints, so it is settled before the channel card layout places the input header. Compare parts per channel (two box headers, two sockets, about 0.15 m of cable) against the Molex lead (about €5) in `tools/costs.py`, and the work (two presses against none).

Rejected by the user (2026-10-09): **the filter as a fitting option** (about €25 per channel). The SSI2144 ladder filter is one of the essential features that make this mixer stand out; it stays on every channel.

## Power-cut candidates

From `/system power conversion` (2026-10-08). About three-quarters of the supply current is op amp quiescent current; the NE5532s in the core audio path stay. Supply currents per amplifier, typical / maximum (TI datasheets): NE5532 3 / 8 mA, TL072 1.4 / 2.5 mA, TL062 0.2 / 0.25 mA, OPA1678 2 / 2.5 mA.

1. **Done on the channel card (decision 123):** Channel U107 (cutoff CV summer, one unit unused): NE5532 → TL072. Saves 3.2 / 11 mA per rail per card; DC accuracy improves (FET input bias into 100-300 kΩ)
2. **Done (decisions 123, 126):** channel U401, U404 and master U409, U410, U802, U804 TL072 → TL062; the superdiodes (channel U205, master U207, U307, U706) and the master's log-detector U407 stay TL072. Master saves about 9.6 mA per rail typical
3. Later cost choice: NE5532 → OPA1678 in low-noise-gain audio stages (channel U3, U106; the master positions became TL072 by decision 173). Saves 2 / 11 mA per package with equal or better audio; costs more (price not checked)

The channel share is done: decision 123 cut the card from 121 / 103 to 113 / 95 mA typical (the budget in `ARCHITECTURE.md` includes it). The master's share is done too: decision 126 moved four packages (about 9.6 mA per rail typical; master 340 / 269 → 331 / 260 mA with decision 125); `ARCHITECTURE.md` still shows the old master figures until `/system` reruns the budget. NE5532 → TL072 in audio stages was rejected at first (measurably more noise and distortion); decision 173 (2026-10-17, the user) then moved ten master packages with low noise gain and light loads to TL072 (master 327 / 256 → 295 / 224 mA typical); the audible bus summers, send drivers and master out I-V stay NE5532.

## KiCad workflow

- One KiCad project per module; hierarchical sheets inside a module for sub-blocks (input stage, filter, VCA, AUX sends)
- Custom symbols and footprints live in `hardware/libs/`
- Sheets are generated by scripts in `hardware/channel-card/scripts/` and drawn with real wires inside each circuit block (labels only between blocks); every rebuild is checked pin by pin against a separate reference netlist. See the scripts README
- Edit schematics and PCBs through the KiCad MCP server (kicad-mcp-pro, profile `schematic_authoring`); pause for the user's review before each commit
- The server's circuit builder connects nets by labels and cannot handle multi-unit symbols (dual op amps, DG413): build with temporary references per unit, then rename them in the file, and verify with ERC plus a netlist check against the intended nets
- Shared project symbols: `hardware/libs/syntsamix.kicad_sym` (SSI2144, SSI2162, AS3046, THAT1646 pinout used for the DRV135, TPA6120A2; the AD8273 symbol is no longer used, decisions 143 and 148), registered in each project's `sym-lib-table`
- Give every placed symbol the BOM fields in `docs/PART-NUMBERING.md`
- Run ERC after schematic changes and DRC after layout changes
- Keep a BOM export per module
- Keep simulation netlists and results in `simulation/`

## Design cautions

- Ladder filters need low-level signals; do the gain structure before layout
- L/R filter tracking needs a per-chip offset trim close to each SSI2144 (the temperature-compensating resistor is in the backlog, decision 141); plan layout accordingly
- 8 filter cores means significant board area per channel card
- Verify every part's pinout, footprint and limits against its datasheet
