plektra/syntsamix/simulation/filter/BREADBOARD.md

# SSI2144 breadboard test plan

Goal: verify the simulation in `README.md` against the real chip, and fix the values the channel card schematic needs (output scale, resonance limit, drive setting). Record every measurement in the result tables below.

Order list: `breadboard-bom.csv`. Schematic, breadboard layout and placement tables: `breadboard.html` (generated by `breadboard_schematic.py`, `breadboard_layout.py` and `breadboard_page.py`; the layout script checks the breadboard connections against the schematic netlist).

Reference: SSI2144 datasheet Rev 3.0 (January 2018), Figures 1 and 3. Where this plan says "per Figure 1", copy the datasheet values exactly; they set the filter's frequency scale and are not repeated here, so they cannot be copied wrong.

## 1. Shopping list

**What runs on the first order alone** (`electrokit-order.csv`, delivered 2026-10-13, with the SparkFun SSOP adapter bought separately and an E24 1 % resistor kit): tests 1-7, which settle the values the channel card waits for (R111/R161 output scale in test 5, R120/R170 Q limit in test 2, the drive jumper in tests 4 and 7), test 10 in its reduced form (two spare TL072s, without the 0 % row), test 11 (the bipolar and two 10 µF 25 V electrolytics from the order) and test 12. Test 13 needs the second order's BZX55C10V and BZX55C12V pairs (Electrokit has no 11 V zener; the 51k and 1k for its CV OUT row come from the kit, the op amp is a spare TL072). Test 8 needs the second order's three 6.8 nF capacitors and second breadboard; test 9 needs its LM13700 and 1N4148s; test 13 needs its zeners. The full test 10 needs one OPA2171 on an SOIC-8 adapter, in neither order (Mouser or LCSC). 2026-10-20: the second order (placed that day) now also carries three ProtoPCB EKB14 boards for a soldered filter core, three SSI2144 and the E24 resistors the kit lacks (33k, 200 Ω, 510 Ω, 160k, 300k; SKUs confirmed by the user). The second order (`electrokit-order-2.csv`) also carries 3 GPBS850L buttons (cut from 10 on 2026-10-20: latch and pin check, cap fit; the LED brightness and bleed test moves to the first channel card PCB, since the 0805 LEDs come only with JLCPCB assembly; the build's set comes later at the 25+ price) for printing and testing the button caps and setting the button LED brightness (decisions 75, 117). Resistors come from the 1 % E24 kit; the plan, the drawing and `breadboard.html` use the kit values (the channel card's own where it has them).

| Qty | Part | Notes |
|---|---|---|
| 3 | SSI2144 (SSOP-16) | One for the test, one for the L/R tracking test, one spare. Electrokit 41019301 (EU), Thonk, synthCube, Modular Addict |
| 2 packs | SSOP-16 to DIP-16 adapter, 0.635 mm pads | SparkFun BOB-13994 (2 boards per pack). The SSI2144 package is QSOP-16 (JEDEC MO-137-AB, 0.635 mm pitch). Its pin rows are 500 mil (0.5 in) apart, not a DIP's 300 mil (measured 2026-10-14): it straddles the centre gap with its pins in rows d and g, and the layout keeps rows e and f under it free. A 600 mil adapter does not fit the layout |
| 3 | TL072 (DIP-8) | Control summer, output stage, spare. Electrokit 40350072 |
| 1 | NE5532 or OPA1642 (DIP-8 or on adapter) | Optional: lower-noise output stage for comparison. Electrokit 40355532 (NE5532P) |
| 1 set | 1% metal film resistors, kit | 18 kΩ, 200 Ω (3), 330 Ω, 33 kΩ, 51 kΩ, 510 Ω, 1 kΩ, 100 kΩ (2), 160 kΩ, 300 kΩ, 470 kΩ. The kit in hand lacks 200 Ω, 510 Ω, 160 kΩ and 300 kΩ (2026-10-14); until the E24 values are ordered: R2 = 2 × 100 Ω in series (exact, it sets the drive level), R4 and the R3 alternative 220 Ω, R7 470 Ω, R11 150 kΩ (RV5 makes up the rest), R12 = 2 × 150 kΩ in series (exact, the card's 300k) |
| 1 set | Capacitors | 6.8 nF (3) and 10 nF, 3.3 nF (optional): R82 film box, 10 % (6.8n, 3.3n) and 5 % (10n), 5 mm pitch (Electrokit 41015666, 41015667, 41015664); 560 pF and 100 pF C0G/NP0 ceramic MLCC (41011990, 41011983) |
| 6 | 100 nF ceramic | X7R ceramic MLCC: supply decoupling across the rails at each IC. Electrokit 41016717 |
| 4 | 10 µF electrolytic, 25 V or more | Polarised electrolytic, ø4×5 mm, stripe = −: supply rail bulk decoupling (C14, C15 at the supply entry) and test 11. Electrokit 41019084 |
| 2 | 10 µF bipolar electrolytic (100 V, ø8 mm) | Bipolar (non-polarised) electrolytic, ø8×12 mm: input and output coupling (both ends sit near 0 V); test 11 also uses two of the 10 µF electrolytics above, back to back. Electrokit 41018168 |
| 3 | 10 kΩ linear pot (PC16SH, PCB pins: solder leads) | Cutoff, resonance (Figure 3; linear instead of reverse-audio), spare. Probably Electrokit 41037776 (not confirmed: no longer listed) |
| 3 | 50 kΩ multiturn trimmers (in-line pins) | Output gain (RV3), V/octave (RV5), cutoff offset (RV4). Bourns 3296W, Electrokit 40900268 |
| 3 | 6.3 mm mono jacks with switch (PCB pins: solder leads to tip and sleeve) | Input, output, CV. Electrokit 41002006 |
| 1 | Solderless breadboard (840 holes) and jumper wire | Check that the rails run the full length. Electrokit 10160840 (840 holes), jumper kit 41002700 |
| 2 | 1N4001 | Reverse-polarity protection, on the board across the rails at column 4 (D1, D2; the leads fit the holes). Electrokit 40310001 |
| 2 + 2 | Zener 0.5 W DO-35: BZX55C10V and BZX55C12V | Test 13 only, second order (Electrokit has no 11 V; 40310030 and 40310033); they bracket the card's BZT52C11 |
| – | Flux, fine solder (0.5 mm), fine tip, magnifier | For the SSOP adapter |

Equipment:
- Dual bench supply, ±15 V, current limit about 50 mA per rail
- Audio interface with balanced line outputs and inputs (able to reach +18 dBu or more), on a computer with REW (Room EQ Wizard, free)
- True-RMS multimeter (1.228 V RMS at 1 kHz = +4 dBu)
- Oscilloscope (optional)

## 2. Build

### Chip on adapter
Flux the pads, tack two opposite corner pins, check alignment, then solder the rest or drag-solder. Inspect for bridges under magnification and check pin-to-pin continuity with the multimeter before powering.

### Power
±15 V from the bench supply, current limit 50 mA. 100 nF ceramic from each supply pin to ground right at the chip and at each op amp; 10 µF per rail at the breadboard's supply entry. Note the supply current at power-up (datasheet: about 5 mA per rail typical; the whole board draws about 12-13 mA per rail with the pots). Two single-output supplies in series make the ±15 V: one's − and the other's + join as ground, their earth terminals stay open (a single supply's middle terminal is chassis earth, not a midpoint: with it, the board's ground floats and the rails read about +2.4 / −12.8 V).

### Bench notes (2026-10-15 to 10-17)
- Measure every kit resistor before fitting it: a "150k" read 135 kΩ, and the parts in the 33k compartment (banded 33k) read 19.2 kΩ (R6 is one of them).
- The DSO1060's meter reads resistance about 2 % low and cannot resolve capacitors below about 1 nF (100 pF reads 0.0 nF). In meter mode it reads only from its own COM and V/Ω jacks, not the probes.
- Trimmer pins and two-resistor pairs make poor breadboard contact: the gain wandered ±0.2 dB until R2 was fixed and RV3 replaced by a fixed 8.2 kΩ.
- Cutoff from one reading: with resonance 0 the four poles give f_c = f / √(1/√r − 1), r = V out / V in at a test frequency f above the cutoff. Read V in at the same frequency with the same meter, so the meter's own frequency response cancels.

### Circuit blocks

| Block | Build |
|---|---|
| Input coupling | 10 µF in series with the input jack (stands in for the channel's 3 Hz AC coupling) |
| Input attenuator (hot drive) | 18 kΩ (the card's R104) from the coupled input to SIG IN+, 200 Ω (two 100 Ω in series) from SIG IN+ to ground: +4 dBu (1.74 V peak) becomes about ±19.0 mV |
| Medium drive jumper | Jumper that adds a resistor in parallel with the 200 Ω: 330 Ω gives 124.5 Ω (about -4 dB), 220 Ω gives 104.8 Ω (about -5.6 dB; 200 Ω for -6 dB once the E24 set is in). Try both |
| SIG IN- | 220 Ω to ground (datasheet: 200 Ω for an unused input; not critical) |
| Filter capacitors | Per Figure 1 |
| Cutoff control | Control summer per Figure 1 (TL072) with the 10 kΩ linear pot and a trimmer for frequency offset. The datasheet values are for ±12 V; on ±15 V check the sweep in test 1 and scale the pot's input resistor if needed. Use a fixed 1 kΩ in place of the temperature-compensating resistor (datasheet allows this) |
| Resonance | Per Figure 3, fed from +15 V. Series resistor into the Q pin: 33 kΩ for test 2 (allows up to about 450 µA), then 51 kΩ (limits to about 294 µA). Keep the 10 nF from Figure 3 with 470 Ω for its 499 Ω (kit value). The Q pin is a virtual ground, so Q current = wiper voltage / series resistance: measure the wiper voltage instead of using an ammeter |
| Output | Current-to-voltage stage per Figure 1, with a 50 kΩ trimmer (RV3) as the feedback resistor in place of the fixed 33.2 kΩ. Start at about 9 kΩ (unity is predicted near 8.8 kΩ with the 18 kΩ attenuator; at 33 kΩ the output would sit about 11.5 dB hot); it is set for unity gain in test 5 |

## 3. Tests

Calibrate levels first: generate a 1 kHz sine from REW and set the interface output so the multimeter reads 1.228 V RMS (+4 dBu) at the breadboard input. Loop the interface output to its input with a cable and run a REW calibration so the interface's own response is removed.

### Test 1: Cutoff sweep
Sweep the frequency response with the cutoff knob at minimum, noon and maximum, resonance at zero.

| Knob | Expected cutoff | Measured -3 dB point (or -12 dB point of the 4-pole) |
|---|---|---|
| Min | about 20 Hz | 17.5 Hz (chip 1, from 32 mV at 40 Hz: uncertain, mains hum) |
| Noon | about 630 Hz | 400 Hz (RV4 near centre, pin 15 about −2 mV) |
| Max | about 20 kHz | 9.7 kHz (8.9 kHz after RV5 was set for 1 V/oct) |

Chip 1 (2026-10-15 to 10-17), tracking against the CV input, RV1 at noon, RV5 set for 1 V/oct at +3 V (test 12):

| CV | 1 V/oct would give | Measured, ±15 V | Measured, ±12 V | Measured, 0 V point moved to about 240 Hz with RV4 |
|---|---|---|---|---|
| 0 V | – | 403 Hz | 447 Hz | about 240 Hz |
| +3 V | 8 × | 3.21 kHz (set) | 3.78 kHz (3.08 oct) | 1.93 kHz |
| +4 V | 16 × | 5.7 kHz (0.18 oct short) | – | – |
| +5 V | 32 × | 8.6 kHz (0.57 oct short) | 9.4 kHz (4.40 oct) | 7.0 kHz (+3 to +5 V: 1.86 oct, 0.14 short) |

The pot path is right (R12 296 kΩ, R13 100.8 kΩ): the knob's span falls short because the chip's tracking sags above about 5 kHz. The sag follows the frequency (control current), not the pin voltage, and is the same at ±12 V. The datasheet (Rev 3.0) gives no maximum cutoff or tracking figure; it claims 1000:1 for ±90 mV at ±12 V. Chip 1 also resonates weakly (test 2), so a second chip should be measured before this is taken as the part's behaviour.

### Test 2: Resonance onset and limit
With the 33 kΩ series resistor and cutoff at about 1 kHz, raise resonance slowly until the output sine-oscillates with no input. Record the wiper voltage and compute the current. Then change to 51 kΩ and confirm no oscillation at full resonance.

| Measurement | Datasheet / plan | Measured |
|---|---|---|
| Q current at oscillation onset | 350 to 450 µA (typ 400, datasheet p2) | Chip 1: no oscillation anywhere on RV2 (R6 read 19.2 kΩ: up to about 790 µA). Chip 2: none either, at any cutoff, on ±15 V and ±12 V |
| Max Q current with 51 kΩ | about 294 µA | |
| Oscillates at max with 51 kΩ? | No | |

Chip 1 (2026-10-17): with a small signal (0.12 V at the 1 kHz cutoff) the level at the cutoff peaks at a third of the input (k ≈ 1) at a wiper of 7.9 V (about 410 µA) and falls again over the last quarter turn; at 1.23 V in the peak is 0.396 V. Checked and cleared: pin 14 at 0.7 mV (the current flows into the chip), the R7/C8 junction at the same voltage (no DC through R7), C4 marked 561 at pins 4-5, C9 fitted, every capacitor-pin joint continuous from chip pin to adapter pin. Next: fit chip 2 on a fresh adapter and repeat this test first.

Chip 2 (2026-10-20), swapped into chip 1's place with the rest of the board unchanged (R6 still 19.2 kΩ, J1 off): no self-oscillation with the input quiet, with RV2's wiper at about 8 V (about 410 µA) or fully up (15.2 V, about 790 µA), anywhere across the cutoff pot's travel. The same on ±12 V (about 620 µA at the top). Pin 14 at about 10 mV with RV2 fully up, so the current reaches the chip. Supply current at ±12 V: +12.43 / −10.66 mA for the whole board, in line with the chip's datasheet 4.0 / 4.2 mA plus the TL072 and the pots. A `part-facts` check of the datasheet (Rev 3.0, Figures 1 and 3, p2) found the build matching: capacitors on the right pin pairs (560 pF at 4-5, 6.8 nF at 6-7, 10-11, 12-13), the optional 3.3 nF across pins 1-2 ("improves Q stability and amplitude over frequency sweep"), 470 Ω + 10 nF at pin 14 for 499 Ω + 10 nF, 200/220 Ω input terminations, pin 14 a current input at ground potential (0-1000 µA range, oscillation 350-450 µA), supply range ±4 to ±16 V with every figure at ±12 V. The only differences are the ±15 V supply (ruled out above) and the hotter input attenuator (18k / 200 Ω against the datasheet's 68.1k), which should not matter with the input quiet. Step 3 on chip 2 (±12 V, 0.12 V in at the 1 kHz cutoff): out/in 0.29 / 0.31 / 0.39 / 0.28 / 0.27 at wiper 2 / 4 / 6 / 8 / 10 V, k ≈ 0.6 / 0.8 / 1.4 / 0.5 / 0.3 from out/in = 1/(4 − k). Not reliable: with 0.5 V in, RV2 at 0 (wiper 0 V) and the cutoff fully open, chip 2 gave only 0.2 V (about 8 dB low) and drifted, while chip 1 in the same place gave a steady 0.380 V. Chip 2's adapter joints are suspect (inspect and reflow pins 1, 3, 8, 9, 15, 16 first); its no-oscillation result stands only once that is cleared. Chip 1's 0.380 V for 0.5 V in is about 2.4 dB under test 5's unity, possibly from the ±12 V supply; recheck at ±15 V.

Cause found (2026-10-20): back at ±15 V chip 1 wandered too, and tapping U1 sent the output from about 0.4 V to over 3 V. All 16 adapter pins read good to their strips and no bridges were found; wiggling the ladder film capacitors (C1-C3, placed diagonally for their 5 mm pitch) steadied the output at 0.44 V for 0.5 V in (cutoff open, about −1 dB). Poor breadboard contacts at the ladder capacitors are the likely cause of the drift and probably of the weak resonance on both chips (a series resistance at a ladder capacitor costs loop gain at the cutoff). Fix: solder C1-C4 and C9 directly across their adapter header pins (4-5, 6-7, 10-11, 12-13, 1-2), then repeat test 2 on chip 1 and chip 2's results after its joints are checked. Before soldering, after the wiggling: chip 1 still did not self-oscillate (input quiet, RV2 up to fully up, cutoff near 1 kHz). Step 3 on chip 1 (±15 V, 0.5 V in at 1 kHz, cutoff set for 0.125 V out at RV2 = 0): 0.154 / 0.175 / 0.193 / 0.204 / 0.189 V out at wiper 4 / 6 / 8 / 10 V / fully up (about 210 / 310 / 415 / 520 / 790 µA), k ≈ 0.75 / 1.1 / 1.4 / 1.55 / 1.35: a little stronger than before, still far from 4, and falling again at the top. Current measured directly with RV2 fully up: 14.9 V across R6, pin 14 at 10 mV, so about 776 µA flows into the chip. Chip 2 refitted on the steadier board: output 0 V or wandering with the cutoff fully open and RV2 at 0, where chip 1 gives a steady 0.44 V. Chip 2 is faulty or has a bad lead joint (it drew normal supply current at ±12 V); its test 2 results do not count. Reflow its leads with the capacitor soldering; the third chip is the spare. Chip 1 was then refitted one column to the right and powered: each pin sat in its neighbour's strip. Back in place, the + rail ran into the 50 mA limit; without a chip both rails read normal, so chip 1 is damaged (its results above, taken before, stand). Before powering a refitted adapter, check that pin 1 sits in its marked strip.

Where test 2 stands (2026-10-20): on a steady board, chip 1 reached k ≈ 1.5 at about 520 µA and never self-oscillated with 776 µA measured into pin 14; the build matches the datasheet. Not settled: whether the ladder capacitors' breadboard contacts still cost loop gain. Next: solder C1-C4 and C9 onto the adapter header pins, fit chip 3 (the last one in hand), repeat test 2, then the 100 Hz bass-loss check (output at 100 Hz with RV2 at 0, 10 V and fully up; k from the drop 1/(1 + k)). If chip 3 also stays near k ≈ 1.5, write to Sound Semiconductor with these figures.

### Test 3: Bass loss with resonance
Frequency response at cutoff about 1 kHz, resonance at 0, 1/3, 2/3 and full (51 kΩ).

| Q current | Simulated 20 Hz gain | Measured | Simulated peak | Measured |
|---|---|---|---|---|
| 0 | 0 dB | | – | |
| about 100 µA (k = 1) | -6.0 dB | | -3.7 dB | |
| about 200 µA (k = 2) | -9.5 dB | | -1.8 dB | |
| about 300 µA (k = 3) | -12.0 dB | | +3.5 dB | |

### Test 4: Distortion against level (hot drive)
100 Hz sine, resonance 0. THD+N from REW.

| Level | Sim, cutoff open | Measured, cutoff open | Sim, cutoff 1 kHz | Measured, cutoff 1 kHz |
|---|---|---|---|---|
| 0 dBu | 0.03% | | 0.53% | |
| +4 dBu | 0.08% | | 1.3% | |
| +8 dBu | 0.21% | | 3.4% | |
| +12 dBu | 0.60% | | 8.7% | |

Repeat the +4 dBu row with the medium drive jumper (both values):

| Jumper | Measured THD, cutoff open | Measured THD, cutoff 1 kHz |
|---|---|---|
| 330 Ω (about -4 dB) | | |
| 220 Ω (about -5.6 dB) | | |

### Test 5: Output scale
With the cutoff fully open and resonance 0, set RV3 so +4 dBu in gives +4 dBu out. Scaling the datasheet's Figure 1 values (68.1 kΩ in, 33.2 kΩ out for unity) to the 18 kΩ hot attenuator predicts about 8.8 kΩ; the channel card uses 9.1 kΩ (R111/R161, E24, decision 140) until this test sets it. The breadboard's attenuator is the card's 18 kΩ, so the measured value carries over directly (an E24 value or pair, decision 140). With power off, measure RV3's resistance between its pin 1 and wiper.

| Measurement | Value |
|---|---|
| RV3 resistance for unity gain (hot drive) | Chip 1: 8.0 kΩ on the meter (about 8.2 kΩ); a fixed 8.2 kΩ in RV3's place gives +0.07 dB (1.24 V out for 1.23 V in) |
| Same with medium drive jumper | Chip 1: 12.3 kΩ on the meter (about 12.55 kΩ), R3 measured 324.5 Ω |

Attenuator as built: R1 17.62 kΩ, R2 196.9 Ω (meter values; the ratio matches 18k / 200 Ω). The jumper changed the level by 0.65 (−3.7 dB) against 0.625 (−4.1 dB) from the resistors.

### Test 6: Noise
Terminate the input (short the jack's tip to sleeve through about 100 Ω). Measure output noise in REW, 20 Hz to 20 kHz, A-weighted, at the same unity gain setting.

| Setting | Estimated SNR at +4 dBu | Measured noise (dBu A) | Measured SNR |
|---|---|---|---|
| Hot drive | about 93 dB | | |
| Medium drive (-4 dB) | about 89 dB | | |

### Test 7: Listening
Play synths, drums and a full mix through the filter at +4 dBu. Sweep the cutoff, add resonance, push the level to +8 and +12 dBu. Compare hot and medium drive and note which sounds right as the default.

| Material | Hot drive | Medium drive | Preferred |
|---|---|---|---|
| | | | |

### Test 8: L/R tracking (optional, second chip)
Build a second core sharing the same control voltage. With both cutoffs at the same knob position, measure each one's cutoff, then adjust one offset trimmer until they match.

| Measurement | Value |
|---|---|
| Untrimmed cutoff difference (octaves) | |
| Trimmer range needed (mV at the frequency pin) | (plan: at least ±12 mV) |

### Test 9: Q VCA (resonance compensation, decision 71)
Rebuild the resonance section per datasheet Figure 9 with one LM13700N (DIP-16): Q pin 14 to ground through 13 kΩ; OTA A output (pin 5) to SIG IN- (pin 2, keep its 220 Ω to ground); OTA + input (pin 3) through 560 Ω or 620 Ω to ground (channel card: 560 Ω with 18 kΩ, decision 140); OTA - input (pin 4) through the same value to ground, through 18 kΩ (R14) from the output stage, and through R10 from the input attenuator's input node; bias input (pin 1) through about 41 kΩ (kit: 39 kΩ) from the RESONANCE pot wiper; pot from +15 V through 10 kΩ, its other end through two 1N4148 in series to -15 V; diode bias and buffer outputs open, buffer inputs (pins 7, 10) to ground. Note: the datasheet circuit inverts at the output stage, so the input node here is the 18 kΩ's input end.

| R10 | Expected 20 Hz gain at max resonance | Measured | Oscillates at max? |
|---|---|---|---|
| Open (none) | -12 dB | | No |
| 51 kΩ (half) | -6 dB | | No |
| 18 kΩ (full) | 0 dB | | No |

| Measurement | Value |
|---|---|
| Bias current at oscillation onset (wiper voltage minus about -13.8 V, divided by the series resistor) | (datasheet: about 375 µA) |
| Series resistor for k = 3 maximum (75% of onset) | (channel card provisional: 36 kΩ, about 281 µA maximum, decision 140) |
| Listening: none / half / full preferred | |

### Test 10: Fader law (channel card Level sheet, decisions 72, 97, 102)
This tests the control-voltage circuit only; no VCA is needed. Build it on the second breadboard with one OPA2171 (U204: A = fader buffer, B = summer with pin 5 to ground), one TL072 (U205: both superdiodes), two 1N4148 and a 10 kΩ linear pot as the fader (pin 1 to -15 V, pin 3 to ground). Follow `hardware/channel-card/level.kicad_sch` (U204, U205 and the resistors around them). E24 kit values are close enough: 110k for 113k, 470k for 453k, 220k for 221k, 62k for 63.4k, 120k for 124k, 8.2k for 8.66k, 30k for 30.1k. Leave out C224 and the DG413 for this test. The OPA2171 comes in SOIC-8 only: use a SOIC-8 adapter, or use a TL072 for U204 and skip the 0 % row (the TL072 buffer is outside its input range near -15 V and may reverse phase; decision 102).

Measure the pot wiper voltage Vw (travel x = 1 + Vw / 15 V) and the summer output VC (U204 pin 7). Gain in dB = -VC / 33 mV. Simulated values: `simulation/level/results.txt`.

| Travel x | Wiper Vw | Expected VC | Expected gain | Measured VC |
|---|---|---|---|---|
| 100 % | 0 V | -0.33 V | +10.1 dB | |
| 75 % | -3.75 V | 0.00 V | 0.0 dB | |
| 53 % | -7.05 V | +0.32 V | -9.6 dB | |
| 42 % | -8.70 V | +0.65 V | -19.6 dB | |
| 19 % | -12.15 V | +1.37 V | -41.4 dB | |
| 14 % | -12.90 V | +1.97 V | -59.7 dB | |
| 0 % | -15 V | +3.31 V | about -100 dB (off; the OPA2171 output stops about 0.45 V above -15 V) | |

Expected values are for the card's E24 network (decision 140): 113k = 100k + 13k from VB, 450k = 300k + 150k from +15 V, breakpoints 100k / 220k → 62k and 100k / 124k (100k + 24k) → 9k1. With the E96 kit values of the original network the law is the same within 0.5 dB.

Mute check: connect a 33 kΩ resistor from -15 V to U204 pin 6; VC must rise by about 4.5 V at any fader position. On the card the MUTE button switches this resistor itself (decision 142): flick a wire on and off a few times and check on a scope that VC ramps (about 10 ms) without spikes, which also covers contact bounce.

Duck check (decision 97): connect 30 kΩ from a -1 V source (a low-impedance divider from -15 V) to U204 pin 6; VC must rise by about 0.33 V (10 dB) at any fader position.

### Test 11: Back-to-back electrolytics instead of a bipolar (decision 161)
The card's eight coupling positions are now two polarised 10 µF electrolytics in series, negative to negative (decision 161: C5+C21, C6+C22, C101+C108, C151+C158, C107+C109, C157+C159, C221+C235, C271+C285), 5 µF effective. This test checks that the pair is as clean as a bipolar at low frequency and hot levels. Parts: two 10 µF polarised electrolytics, 25 V or more (from the order, wired − to −), and the 10 µF bipolar from the order.

Put the capacitor under test in series with the input (in place of the input coupling capacitor of the circuit), signal into a 10 kΩ load (as C101 into R101), output into the scope and headphones through the output stage.

| Check | Bipolar electrolytic | Two 10 µF back to back |
|---|---|---|
| Level at 20 Hz relative to 1 kHz (expect about −0.1 dB for the pair) | | |
| THD at 20 Hz and 50 Hz, +4 dBu (if the meter or interface allows) | | |
| THD at 20 Hz, hot Eurorack level (10 V peak) | | |
| THD at 1 kHz, +4 dBu | | |

Decide: keep the pair unless its 20 Hz THD is clearly above the bipolar's (more than about 0.05 %) or audible; then return to a bipolar part (Nichicon UWP1V100MCL1GB, LCSC C340735, same footprint as before; one fee type). The X5R ceramic option is dropped: it costs more than the pair and can be microphonic.

### Test 12: Fixed V/oct scale instead of the RV182 trimmer (cost review, product lever)
Temperature compensation is in the backlog (decision 141): the card's FREQ leg is a plain 1 k (820 + 180), as on this breadboard. This test shows whether the V/oct scale is close enough between chips to drop the V/OCT trimmer, and how far the scale drifts without compensation.

With the CV input at 0 V and at +1 V, +2 V, +3 V (a lab supply or a divider; the card's CV input is 100 kΩ into the summer), trim RV5 for an exact octave per volt at room temperature, then measure RV5 plus its series resistor (power off). The card needs the summer feedback near 162k (R183 + R187) plus the trimmer.

| Measurement | Chip 1 | Chip 2 (test 8) |
|---|---|---|
| Feedback for 1.000 V/oct at room temperature (kΩ) | 186.3 (meter; about 190), set at +2.99 V: about −18.4 mV/oct | |
| Room temperature (°C) | | |
| Octave error at +3 V after 30 min warm-up in a closed box (cents) | | |
| Octave error at +3 V with the chip warmed by a finger or hair dryer for a minute (cents) | | |

Decide: if both chips need the same feedback within about ±2 % (about 20 cents over 3 octaves), an E24 pair can replace RV182 for the product (one part and one calibration step fewer per card). The warm-up drift tells whether the backlog item (decision 141) is worth bringing back.

### Test 13: Summer clamp, dropout and CV OUT (decision 165)
The card clamps the cutoff summer with two BZT52C11 back to back across its feedback, so the SSI2144 frequency pin stays inside its datasheet range (−120 to +150 mV) and below the low-cutoff dropout (above about +175 mV the filter goes silent and recovers at about +135 mV, datasheet p5). `simulation/cutoff/` predicts a clamp at about ±10.5 to 12 V and a pin within about ±128 mV; the knee below 0.5 mA is not in the zener datasheet. Electrokit has no 11 V zener, so the second order carries a pair each of BZX55C10V and BZX55C12V (DO-35): the two neighbours of the card's BZT52C11, and the two values this test may move to. Measure with both pairs; C11 behaves between them. Also needed, for the last row, a TL072 half with 100k in, 51k + 1k feedback and 1k out.

First without the zeners: feed the CV input from a lab supply (or a ±12 V divider) and raise the voltage on the low-cutoff side (positive at the pin) until the output goes silent; note the pin voltage, then lower it until the signal returns. Then fit the C10 pair and repeat across the full CV range, then the C12 pair.

| Measurement | Without clamp | C10 pair | C12 pair |
|---|---|---|---|
| Pin voltage at dropout / recovery (mV) | | — | — |
| Summer output at the CV extremes (V) | | | |
| Pin voltage at the CV extremes (mV) | | | |
| Octave error at the pot's ends (cents; knee of the clamp) | — | | |
| CV OUT against the total control at −5, 0, +5 V (V) | — | | |

Decide: take C11's figures as midway between the C10 and C12 columns. Keep C11 if its pin voltage stays below the measured recovery level with margin and its pot ends are within about 20 cents; otherwise move one zener step (C10 if the dropout comes earlier than the datasheet says, C12 if the knee bends the ends), using that pair's measured column directly.

## 4. After the tests

- Copy the measured values into `README.md` next to the simulated ones.
- Update `docs/decisions/channel-card.md` (and its row in `INDEX.md`): drive default, Q VCA series resistor and compensation setting, output feedback resistance, any differences from the model.
- Update the channel card Filter sheet: R111/R161 (output scale) and R120/R170 (Q limit), on E24 values or E24 pairs (decision 140).
- Tests 11 and 12: record the decisions on the coupling capacitors (lever 7) and the V/OCT trimmer in `hardware/channel-card/STATUS.md`.
- Test 13: if the zener changes, update D184/D185 in `filter_wired.py` / `filter_build.py` and `simulation/cutoff/`.
