plektra/syntsamix/docs/decisions/record/process.md

# Process decisions

Tools, workflow, part numbering, licensing, test points and assembly.

Full record (decision 154): the complete text of each decision as made, with figures, sources and rejected options. The current rulings, which sessions read first, are in `../process.md`; the index of all decisions is `../INDEX.md`. Numbers are global and never reused. Text marked **[proposed]** still needs the user's confirmation.

## Decisions

10. Design tool: KiCad, using its MCP server
11. Write the specification before starting implementation
47. Tooling: one KiCad project per module with hierarchical sheets, custom symbol and footprint libraries, ngspice simulation, ERC/DRC checks, BOM export
63. Part numbering: each unique part type gets a project part number `SX-<category>-<nnn>` (register `docs/parts.csv`), used as Mouser's customer part number. KiCad symbols carry ProjectPN, Manufacturer, MPN, Supplier and SupplierPN fields, and BOMs are exported grouped by ProjectPN (`docs/PART-NUMBERING.md`)
70. Licensing is non-commercial source-available; the author keeps all commercial rights (`LICENSE.md`, `REUSE.toml`, texts in `LICENSES/`): hardware design files and documentation CC-BY-NC-SA-4.0, source code PolyForm-Noncommercial-1.0.0 with SPDX headers, repository configuration CC0-1.0. Applies from this change on; earlier commits stay under GPL-3.0
77. Test points: bare 1.5 mm SMD pads only (no wire loops), named on the silkscreen with their net and kept out of the BOM. Channel card pads: L/R receiver out, trim out and PREFILT, AGND (Input); L/R SSI2144 input, I-V out and POSTFILT, FCV, QW, AGND (Filter); VC, VB, L/R POSTFADE, SC_ENV (Level); L/R PRE (Routing); MV (Meter). The Chain and power sheet adds pads for the raw rails, +15 V, -15 V, +5 V and PGND
79. Assembly at JLCPCB (or PCBWay) for the prototype is planned around the LCSC stock check (`docs/lcsc-check.csv`, `tools/lcsc_check.py`). To cut extended-part setup fees, non-critical resistors use JLC basic values: bus resistors 22 kΩ (was 22.1 kΩ), the VCA input network 100 Ω (was 110 Ω), the cutoff offset injection 470 kΩ (was 499 kΩ, range still about ±32 mV) and the regulator dividers 200 Ω / 2.2 kΩ (15.1 V; was 120 Ω / 1.33 kΩ). Filter scaling, fader law and meter ladder keep their exact values. Not stocked at LCSC and to be consigned or hand-soldered: SSI2144, SSI2162, AD8273 and the ERA-V33 temperature-compensating resistor
116. RoHS compliance is a strict requirement (confirmed by the user 2026-10-09, during `/board channel-card mechanical parts`; for EU compliance). Every component on every board, and the boards themselves, must comply with the RoHS directive 2011/65/EU as amended by Delegated Directive (EU) 2015/863 (ten restricted substances); compliance through an Annex III exemption counts as compliant. A part may be chosen only when its maker or supplier states RoHS compliance (datasheet mark, declaration, or the distributor's RoHS field), and the source is recorded in the Notes column of `docs/parts.csv` as `RoHS: <source>`. Parts without such a statement (for example unbranded synth-DIY pots, knobs and jacks) are not chosen until compliance is confirmed. Fabrication and assembly are lead-free: lead-free HASL or ENIG board finish and lead-free assembly at JLCPCB (not the default leaded HASL), lead-free solder for hand soldering. The parts already registered are audited against this rule (all boards) (invariant 9, standard passives and the audit: item 122 in `system-rules.md`)
124. A maker's general RoHS declaration covers that maker's standard parts (confirmed by the user 2026-10-09, `/system`; refines item 116). Taiwan Alpha's RoHS II declaration (2020-10-26, signed; 2011/65/EU with 2015/863, all ten substances) covers "our standard models or series", so every standard Alpha potentiometer counts as RoHS compliant under item 116, whichever reseller sells it (Thonk, Tayda), provided the part is genuine Alpha. This clears the channel pots CUTOFF, TRIM, AUX (Thonk, Alpha order codes RD901F-40-15K-B50K-0057, RD902F-40-15K-A100K-0057, RD902F-40-15K-A10K-0057) and RESONANCE (Tayda, RD901F-40-15K-C10K), and gives the master card's Alpha pots their source once a standard model is chosen. Supplier declarations received by email are kept in `docs/rohs/`, which is git-ignored: they are the suppliers' documents and not ours to publish in the public repository; `parts.csv` names the document, its date and scope. The same reading applies to other makers' general declarations
133. Through-hole parts are hand-soldered by the user; JLCPCB places SMD parts only (confirmed by the user 2026-10-09, cost review; refines item 79). This covers the panel parts (pots, faders, latching switches, 6.3 mm and 3.5 mm jacks), the chain and input headers, jumper headers, trimmers, relays, the master's TO-220 regulators and heatsinks, and the power board's radial capacitor and DC jack. No through-hole assembly is ordered, so JLCPCB charges no through-hole set-up or per-joint fees; the order files list these parts for the user's own purchase. Footprints keep hand-solderable pads (no paste-in-hole assumptions).
134. Component values come from the E24 series, and each board owns its value selection (confirmed by the user 2026-10-09, cost review; refines items 79 and 110). Resistor and capacitor values are chosen from E24 (capacitors preferably E12 or E6, where the JLCPCB basic library is widest). A value outside E24 stays only where the circuit needs a ratio or accuracy that E24 values cannot give, singly or as a pair of E24 parts; each such value is listed in its board's `STATUS.md` (section "Component values") with its references and reason. The board's own sessions are responsible: they apply the rule when drawing, review their list before layout, and record each exception or change there. Reason: every value outside the JLCPCB basic library costs a $3 extended-part fee per type per order (item 110), and off-series values are harder to source for a product. Item 79's exact values (filter scaling, fader law, meter ladder) stand until their board's review moves or justifies them. The rule is in each board's `CLAUDE.md`, "Component values".
136. Cost control and realized costs (confirmed by the user 2026-10-09). (1) `/cost <scope>` runs the `cost-controller` sub-agent (`.claude/agents/cost-controller.md`), read-only on the design like the validator: it prices the BOMs, checks them against item 135 and the E24 rule (item 134), explores new cost-saving scenarios, and writes `docs/reviews/<date>-cost-<scope>.md` with each lever's saving, trade-off, the side of item 135 it is on, and the decisions it would touch. Its levers are proposals; accepted ones become topics in a `/board` or `/system` session. (2) `tools/costs.py` makes the estimate repeatable from the schematics: `estimate --channels N`, `drivers`, `unpriced`; its inputs are `docs/lcsc-check.csv`, `docs/costs/prices.csv` (prices for parts LCSC does not sell, with source and date) and `docs/costs/overheads.csv` (rates, PCB, panel, JLCPCB fee, frame and knob figures). The ROADMAP's cost figures come from it. (3) Realized costs: every order and payment is recorded with `tools/costs.py ledger add` (date, supplier, order reference, category, board, amount and currency, converted to EUR); `tools/costs.py ledger` totals them by category, board and supplier. The ledger `docs/costs/ledger.csv` is private: git-ignored (the repository is public) and kept in the main checkout, which the tool finds from any worktree. (4) `/handoff` notes the cost effect of a session that changed parts.
137. Prefer JLCPCB's fee-free parts (confirmed by the user 2026-10-10: "highly prefer the standard parts from LCSC in order to avoid extended component costs"; refines items 79, 110 and 134). For every SMD part JLCPCB places, choose in this order: (1) a JLCPCB basic part; (2) a JLCPCB "preferred" part (an extended part that carries no extended-part fee); (3) another LCSC extended part ($3 fee per type per order); (4) a part LCSC does not stock (consigned or hand-placed). A lower choice is allowed only where no fee-free part meets the need under item 135 (live device: accuracy the audience cannot hear may be traded; the "must stay" list may not), and it is recorded with its reason in the board's `STATUS.md`. Same function counts: a basic part from another maker (for example ST's TL072CDT for a TL072) is fine once its datasheet confirms pinout, package and limits. Resistor values follow item 134 (E24), and the chosen E24 value should be one the basic or preferred library holds (most 1 % 0805 E24 values are; 110 Ω, for example, was not on 2026-10-10). Through-hole parts are hand-soldered (item 133) and bought wherever they are cheapest. `tools/lcsc_check.py` records the class as basic, preferred or extended; `tools/costs.py` counts basic and preferred as fee-free, and `tools/costs.py extended` lists the types that still cost a fee.
151. Models per role and a lighter session start, to cut token use (confirmed by the user 2026-10-10; refines item 136 and the workflow in `docs/WORKING-WITH-CLAUDE.md`). Design sessions (`/board`, `/system`) stay on Opus. The sub-agents carry a fixed model in their `.claude/agents/` files: `architect`, `cost-controller` and `validator` on Sonnet; `/validate <scope> deep` runs the validator on Opus, used for a full board before layout and before a PCB order and for `system` before the first full order; likewise `/cost <scope> deep` runs the cost controller on Opus before layout, before each order and for `system` when new levers are wanted, while plain `/cost` (re-pricing, rule checks) stays on Sonnet. New read-only helper agents take the bounded jobs that used to start a general-purpose agent on the session's model: `part-facts` (datasheet facts with citations, Sonnet, because part reports have come back wrong before), `build-check` (reference build, `check_netlist.py` and ERC, Haiku), `sim-run` (ngspice runs against `results.txt`, Haiku) and `stock-check` (LCSC stock, class and prices, Haiku). Models are not switched in the middle of a session, since the switch drops the prompt cache; a fresh session for a phase with nothing left to decide may start on Sonnet. `/board` no longer reads all of `INDEX.md` and `ARCHITECTURE.md`: only the index's area table, rules, the board's rows, **[proposed]** rows and the open items, and the architecture's invariants and open system items (budgets and chain lines when the phase touches power, ribbons, signal levels or the panel, and always for the power board). Refined the same day (confirmed by the user): (1) `/board` reads the board's decision files in full only when the phase changes the circuit (schematic, breadboard, simulation); for PCB, mock-up, ordering and cost phases it reads the decisions named in the status files or the topic, by number, and reads in full before any circuit change. (2) Each board's `STATUS.md` keeps only the session state (where it stands, waiting, next, For /system); checks before layout and on delivery, checked part facts, cost-cut levers and the component value list (items 134 and 137 named `STATUS.md` for these) move to `hardware/<board>/CHECKLISTS.md`, read for layout, assembly, ordering and cost work and by the validator and cost controller. (3) `/handoff` runs the `architect` reviewer only when the changes touch a contract, a budget, `parts.csv`, a chain, bus or input-header script, a power budget script, or a decision that changes a signal level, rail, load or panel part.
154. Decision log in two tiers, to cut what sessions read (confirmed by the user 2026-10-10: "go ahead" on the recommendation; refines item 151 and the log rules in `INDEX.md`). The area files had grown to about 122 KB (140 KB with the index), a `/board channel-card schematic` start-up read about 36 KB of decision text, and recent entries ran to 1-2 KB each (measurements, prices and stock dates, rejected options, delegation quotes, netlist and ERC results), while a decision's current state was often spread over a refinement chain (12 → 50 → 71, 72 → 102 → 140 → 142, 65 → 73). (1) `docs/decisions/<area>.md` now holds the current ruling of each decision: what holds today, refinements folded in, at most a one-clause reason where it prevents reopening, references to the decisions that set it. (2) `docs/decisions/record/<area>.md` holds the full text unchanged (moved with `git mv`, so `git log --follow` keeps the history), with the tables, rationale notes and availability notes; it is read when a number needs its figures or sources, before reopening a decision, and by the validator and cost controller. (3) A new decision is written in both: the full entry appended to the record, the short ruling appended to the area file, and every short entry it refines rewritten to the new state (the record entries of refined decisions are not edited). (4) `tools/check_decisions.py` checks that `INDEX.md`, the short files and the record files list the same numbers, each in one area. (5) `/board`, `/system`, `/handoff` and the agents read the short files; the short files and the record were checked against each other once by the validator. Rejected: archiving superseded decisions only (little saving, since the long entries are the live ones) and trimming in place with git as the only record (the rationale would be hard to reach, inviting decisions to be reopened). Result: the area files sessions read fall from about 122 KB to about 47 KB (the channel card's two files from about 36 KB to about 12 KB)
164. RoHS source for the SSI2144 and SSI2162 (confirmed by the user 2026-10-13, `/board channel`: "Let's go with A"; refines item 124). Electrokit answered the 2026-10-09 request ("I have attached documents that I have received from the supplier") with three files, kept in the git-ignored `docs/rohs/`: (1) SGS test report CANEC25029425315, SGS-CSTC Guangzhou, 2025-12-02, lot 25J0288, client name and address redacted; sample an SOP16-1, the report applying to the client's SOP, ESOP, HSOP, SSOP, MSOP, EMSOP and TSSOP series (among them SOP10, SOP16, 0.635SSOP16, MSOP10). Results: EU 2011/65/EU with 2015/863, all ten substances not detected in the black body (sample A4); silvery pins (A5) Pb 6 mg/kg (limit 1000), Hg, Cd and Cr(VI) not detected; US TSCA section 6(h) PBT pass; F, Cl, Br, I not detected (EN 14582). (2) An MSDS for "IC" from the packaging maker (2025-05-25; Si, Cu, Ag, silica, Sn). (3) A REACH report (not read: no PDF renderer on this Mac, and RoHS does not need it). The report names packages, not part numbers, and is the packaging house's test rather than a Sound Semiconductor declaration. SSI2144SS-TU (QSOP-16, 0.635 mm pitch) matches the listed 0.635SSOP16. SSI2162SS-TU (Sound Semiconductor PSSL10: 10 leads, 3.9 × 4.9 mm body, 1.00 mm pitch) is not named; it is taken as the listed SOP10, which in Chinese packaging-house naming is that body and pitch. The user asks Electrokit to confirm both part numbers (2026-10-13); the PCB order does not wait for the answer, but a denial for the SSI2162 reopens SX-IC-002 under invariant 9. Rejected: accepting the SSI2144 only until the SSI2162 is confirmed (B), and waiting for a signed declaration naming the part numbers (C), which may never come; the documents answer a request for these exact parts and carry lab data for body and pins
171. Off-board parts in the cost estimate (`/board master` 2026-10-13; refines 136; the user: "I don't think we should count out any costs like this"). Until then `tools/costs.py` counted only parts with a schematic symbol, so the eleven master rear jacks, the ground-lift switch, the row-board headers and ribbon sockets (all moved off the card by 163), the panel headphone jack and its lead, and the input-module cable were in no total. `docs/costs/offboard.csv` (board, ProjectPN, qty, notes) now lists them; `bom()` adds them to that board as user-bought parts (priced from `prices.csv`, volume breaks applied). Master: SX-CONN-019 ×1, SX-CONN-021 ×1, SX-CONN-015 ×11, SX-SW-002 ×1 (estimate, part not chosen), SX-CONN-017 ×2, SX-CONN-018 ×4 (the jacks, switch and headers move to the row-board projects when those exist); input module: SX-CONN-022 ×1 (the ready-made cable the user agreed to, pending `/system`). The two row boards are priced as two PCB designs (`pcb_rear_row_eur` €1.50 per board, the €15 minimum per design applies). Effect: €763 / €1,021 / €1,573 became €834 / €1,113 / €1,696 for 4 / 8 / 16 channels. Still estimated inside overheads: chain ribbon cables (frame per channel), the rear ribbons' flat cable, knobs

190. Hand-soldered SMD chips: prototype only; production machine-placed (confirmed by the user 2026-10-21, after `/cost` asked which SMD parts the user solders; refines 133, 150 and 155). The 2026-10-21 cost review (`docs/reviews/2026-10-21-cost-system.md`) listed the hand-soldered SMD chips from the Assembly field: per channel card SSI2144 ×2 (U101, U102, QSOP-16 0.635 mm) and SSI2162 ×1 (U201, SSOP-10); on the master SSI2162 ×4, DG413DY ×8, DRV135UA ×2 and AS3046D ×1; 27 chips and about 366 pins at 4 channels, 63 chips and about 870 pins at 16. The user is not confident with the QSOP/SSOP packages, so the session priced JLCPCB placement with `tools/costs.py` (scenario override, no file change): SSI2144 and SSI2162 consigned to JLCPCB add about €52 to one prototype (€30 consigned-parts handling, about €8.5 extended/consigned fees for three type-designs, about €15 for four SSI2162 on the second master board of the two-board minimum): 2 / 4 / 8 / 16 channels €683 / €793 / €1,028 / €1,590 become €735 / €845 / €1,082 / €1,643; all 27 chips at JLCPCB add about €80. In orders of many mixers the difference per mixer falls to €3.7-4.7 at 10 mixers and €0.5-0.7 at 100 mixers (the model's flat €30 handling per order understates consignment at volume). Ruling: the first prototype keeps the hand-soldered chips as in 150 and 155; the user: "Let's keep the plan as it is for the first prototype, because I'm expecting the consignment to be quite a hassle, and I doubt SSI is interested in doing all this for the sake of only a few chips, most likely they have some kind of MOQ". A production build is not hand-soldered: the user: "there's no way I'm going to hand solder the chips for hundreds of 8 & 16 channel mixers"; every SMD part is machine-placed. Open for production (not priced): SSI2144/SSI2162 sourcing at volume (not at LCSC, not stocked at Mouser; direct from Sound Semiconductor or a reseller, minimum order unknown), JLCPCB consignment terms at volume (tubes versus reels), panelling the 318 mm channel card above Economic PCBA's 30 boards, and a contract manufacturer with its own sourcing as the alternative. Rejected for the prototype: consigning the SSI chips (cost and logistics above), and JLCPCB placement of all 27 chips (about €80, and the SOIC parts are easy to hand-solder).
191. PCBA supplier stays JLCPCB (confirmed by the user 2026-10-21 after `/cost` compared AISLER and PCBWay: "let's stick with jlcpcb"; refines 79). Report: `docs/reviews/2026-10-21-cost-system-pcba-suppliers.md`. The three assembled designs hold 230 distinct SMD part types (channel card 81, master 116, power 33); JLCPCB charges only the 28 extended types ($3.07 each; whole fee line EUR 144 at 4 channels). AISLER charges per distinct part: EUR 3.75 to 7.50 per type (2022-2023 posts, current rates behind its upload calculator) gives EUR 863 to 1,725 in part fees alone, about EUR 720 to 1,580 more per 4-channel build; its bare boards would also cost about EUR 136 against about EUR 60. PCBWay publishes no fee schedule (quote per project; an old user report suggests about 2x parts markup), so it could not be bounded. Rejected for the prototype: AISLER (cost; its advantages are an EU invoice, no customs and 6-9 working days) and PCBWay (no evidence it is cheaper). Open for production: re-quote AISLER, PCBWay and JLCPCB Standard PCBA (about EUR 320 loading per order for 230 types) at 16 cards and about 50 consoles. Follow-up the same day on JLCPCB's "Pre-reflow Soldering" line ($0.016 per joint, Economic and Standard, price page 2026-09-09): no JLCPCB page defines it; the evidence (through-hole parts normally wave, selective or hand soldered after reflow; pin-in-paste requested in the order remarks with through-hole pads on the paste layer; the rate matches manual assembly at $0.0164 rather than SMT at $0.0016) points to a charge on through-hole joints soldered in the reflow oven, not on every SMT joint. The cost review's worst case (about EUR 124 at 4 channels if every joint were charged) is therefore taken as zero while orders follow 133: SMD-only BOM and position files, no pin-in-paste remark, no through-hole pads on the paste layer; ask JLCPCB support if the line still appears on a quote. Not modelled in `overheads.csv`.

## Availability notes (checked 2026-10-03; recheck before ordering)

- SSI2144 (SSOP-16): not at the big distributors; sold through Sound Semiconductor's resellers. In stock at Thonk (about £3.75), also listed by synthCube and Modular Addict.
- SSI2164 (SOP-16): widely in stock (Thonk, Modular Addict, CE Distribution, AI Synthesis).
- THAT 2180A/B (SIP-8, through-hole): in stock at Newark, Farnell and element14 (tens to a few hundred units).
- Bourns PTA6043-2015DPB103 fader: active, about $1.92 at Mouser (about 1,300 in stock), €2.01 at Farnell. Alps RS60N11 is no longer manufactured.
- AD8273 (SOIC-14): active, widely stocked (DigiKey, Mouser, Arrow, Farnell), about $4.11. ADI's suggested replacement for the obsolete SSM2143.
- INA2137 (TI, dual, G = ½ or 2): active, $7.37 at quantity 1 at Mouser.
- SSM2143: obsolete.
- THAT1246: the SOIC-8 version (THAT1246S08-U) was in stock at Farnell and Newark, but one Farnell listing marks it "No Longer Manufactured"; the DIP-8 version shows a 20-week lead time. Treat it as at risk: buy prototype quantities plus spares early, and keep a fallback. Replaced by the AD8273 (proposed).
