plektra/syntsamix/docs/decisions/record/power.md

# Power decisions

The power board (`hardware/power`): 24 V DC brick input, protection, non-isolated converters to the raw ±20 V chain rails (decision 100). Chain voltage and power injection (decisions 40 and 80) are in `system.md`.

Full record (decision 154): the complete text of each decision as made, with figures, sources and rejected options. The current rulings, which sessions read first, are in `../power.md`; the index of all decisions is `../INDEX.md`. Numbers are global and never reused. Text marked **[proposed]** still needs the user's confirmation.

## Decisions

60. Prototype power: certified DC power brick (24 or 48 V) into the master section, isolated DC-DC module to about ±20 V, LC filter, per-card linear regulation. Power switch, resettable fuse, reverse-polarity protection, locking DC connector, power LED. A linear external supply box can be considered for a product version. (Item 100 replaces the isolated DC-DC module with non-isolated on-board converters and fixes the brick at 24 V; the brick provides the isolation)
81. The power input section is a separate small power board (`hardware/power`) next to the master card: DC brick input, fuse, reverse-polarity protection, power switch and LED, isolated DC-DC to ±20 V and LC filter. It feeds the master card and both power chains with short power ribbons, keeping switching noise and its ground currents off the audio boards. The master card takes power like a channel card and regulates locally. (Item 100: the conversion is non-isolated; the brick provides the isolation)
100. Power board conversion and parts (refines items 60 and 81; power board schematic session 2026-10-07). Isolated DC-DC modules were dropped as too expensive (about $260 for a ±20 V series pair of Traco TEP modules, the only family checked that trims down to 20 V). The certified brick provides the isolation; the power board converts without isolation and the brick's negative is PGND, so the brick's DC output must float (settled by item 101: invariant 8)
    - **Brick:** 24 V, Class II (2-pin C8 inlet) with a floating output: Mean Well GSM120B24-R7B (120 W) for the prototype, GSM160B24-R7B (160 W) for 16 cards (item 145: GSM220B24-R7B for 16 cards). Same plug and pinout: R7B locking 4-pin power DIN (Kycon KPPX-4P type), pins 1 and 4 = +24 V, 2 and 3 = 0 V. Mean Well GST bricks were rejected: Class I, and the 120 and 160 W models tie −V to earth
    - **Jack:** Kycon KPJX-4S, PCB right-angle at the board's rear edge, 7.5 A per pin; the KPPX plug latches into it. Check polarity with a meter on the first brick (Mean Well's and Kycon's face drawings are rotated relative to each other)
    - **Converters:** two TPS54560 (60 V, 6.3 A minimum switch limit): a buck to +20 V and an inverting buck-boost to −20 V (TI SLVA317), about 2 A per rail. Both synchronised at 400 kHz in opposite phase from one on-board oscillator (74HC14); the timing resistors give 400 kHz if the clock fails. Light-load pulse skipping cannot be turned off, but the cards' quiescent load keeps both in fixed-frequency operation
    - **Input protection:** 4 A resettable fuse (LUTE 2920L400/30GR), SMBJ24A TVS (clamps 38.9 V, keeping the inverter IC's VIN + 20 V under 60 V), two SQJ457EP P-MOSFETs back to back: one blocks a reversed brick, the other turns on slowly (about 7 ms) so the converters' input capacitors charge gently. The power switch only drives the shared gate. Power LED on the switched side
    - **Output:** one LC filter per rail, shared by the three headers: 2.2 µH (Bourns SRP7028A), 330 µF polymer (Panasonic EEHZK1V331P), 100 µF electrolytic for damping, 4.7 µF ceramic. Simulated about 47 dB at 400 kHz at the filter, 63 dB at the cards, peaking about 4.4 dB near 4 kHz. One 2 A resettable fuse (BHFUSE BSMD1812-200-33V) per rail per header, six in all; the chain 2 header is fitted on the prototype too
    - **Power ribbon parts (SX-CONN-008):** Würth 61200821621 box header, 3 A per contact; Würth 61200823021 IDC socket, 1 A per contact (two contacts per rail). Neither is stocked at LCSC: hand-soldered and ordered from a distributor
    - **Full size (about 4 A per rail; 2026-10-10: 3.31 / 2.69 A at the sizing figure, 4.37 / 3.68 A at worst case, `docs/ARCHITECTURE.md`):** the +20 V buck probably carries it (thermal check needed); the −20 V inverter does not (about 7.5 A inductor current) and needs a controller with external MOSFETs, none found at LCSC. Settled with the full-size supply after the prototype cards are measured (decision 96). The 2920 input fuse does not scale to 6.5 A either
    - Component values and their derivation: `hardware/power/scripts/design.py`. Confirmed by the user 2026-10-08: UVLO start 21.1 V and stop 18.7 V on both converters (they wait for the input ramp; on the inverter the stop threshold is moot once running); oscillator 4.7 kΩ / 560 pF (275 to 445 kHz over the 74HC14's threshold spread; both loops cross over near 1.8 kHz, the inverter's peak inductor current stays about 4.6 A at 275 kHz); power switch and LED on the power board at the rear edge (switch part to choose); part-number categories L (inductors, also ferrite beads) and F (fuses). Parts still to choose: the 100 µF 50 V input bulk capacitor and the 10 pF C0G 100 V sync capacitor
    - **Start-up ramp** (power board session 2026-10-08; settled by Claude, the user delegates such technical choices): with the fixed 2.6 ms soft-start both converters charge about 1.1 mF per rail at their current limit, and the averaged model `hardware/power/scripts/startup_sim.py` puts the brick's input at 183 to 262 W peak (6.3 to 8.8 A switch limit, SLVSBN0C), over the hiccup threshold of the GSM120B24 (105 % of 120 W = 126 W) and of the GSM160B24 (168 W) for 1 to 2 ms. Starting the inverter 10 ms after the buck still exceeds 126 W at the typical limit. Fix: on each converter 47 nF C0G (SX-C-016) from the output through a 1N4148W (SX-D-003) into FB; the loop holds FB at 0.8 V, so the output rises as an RC with τ = 240 kΩ × 47 nF = 11.3 ms (19 V after about 40 ms) and the input peaks at about 54 W whatever the current limit. A 1 MΩ (SX-R-060) and a second 1N4148W clamp reset the node; in steady state the diode is off and the loop is unchanged. On the inverter the network is referred to its IC ground (capacitor from PGND, clamp and resistor to −20V_CONV). The GSM120B24 stays the prototype brick
145. Full-size brick: Mean Well GSM220B24-R7B (`/system power brick` 2026-10-10; refines item 100, confirmed by the user after the ±15 V cost review `docs/reviews/2026-10-10-cost-system-15v-rails.md` and a brick survey). The 16-card console takes the GSM220B24-R7B (SX-MECH-005, 221 W) instead of the GSM160B24-R7B; the prototype keeps the GSM120B24-R7B (SX-MECH-003). Reason: at the rails 16 cards plus the master draw 120 W at the sizing figures and 161 W at worst case (`tools/system_power_budget.py`, 2026-10-10), about 133 / 179 W at the brick with about 90 % conversion **[estimate]**: 83 % of the GSM160B24's rating at the sizing figure and over it at worst case, 60 % / 81 % of the GSM220B24's, which leaves margin for a hot stage (working temperature −30 to +70 °C with a derating curve). One brick and one mains cord: the user rejected two bricks in series as unprofessional (2026-10-10). Facts from Mean Well GSM220B-SPEC (2026-05-09): IEC 320-C8 inlet, Class II, I/P-O/P 4 kVAC and 2×MOPP, no FG at the output; 24 V ±3 % (24.7 V maximum, as the GSM120B24, so the SMBJ24A note in the power board's `STATUS.md` is unchanged); 120 mVp-p ripple; 93.5 % efficiency, Level VI; overload 105-135 % in hiccup mode, far above the start-up ramp's 54 W. Same R7B plug (Kycon KPPX-4P equivalent, pins 1 and 4 = +V, 2 and 3 = −V), so the KPJX-4S jack and the power board are unchanged; 9.2 A rated, within the jack's 7.5 A per pin on two pins per pole. Price at TME (2026-10-10): EUR 72.90 at 1, 66.30 at 10, 64.40 at 20, 105 in stock; Mouser and Digi-Key about EUR 72 with no stock. RoHS: Mouser 709-GSM220B24-R7B RoHS Compliant (checked 2026-10-10). Item 100's full-size limits stand: the inverter and the input fuse still need the full-size supply design. Rejected: the GSM160B24-R7B (EUR 51.50 at Digi-Key; thin margin, worst case over its rating), the Mean Well OWA-200E-24 (200 W, locking XLR4 output at about the same price, but a fixed EU mains cord and 230 V input only), XP Power AHM180/AQM200 and Same Sky SDI200G (1.5 to 2.5 times the price, no gain), Class I versions (GSM160A/GSM220A: floating −V but the plug shell is earthed) and the GST220A24 (−V tied to earth, against invariant 8)

156. Power board converter dividers on fee-free E24 values (power board schematic session 2026-10-10, cost lever 5; refines item 100; confirmed by the user). UVLO divider R201/R301 732k → 680k (SX-R-036, LCSC C17797 preferred) and R202/R302 42k2 → 39k (SX-R-104, C25826 preferred): start 21.14 → 21.31 V, stop 18.65 → 19.00 V (SLVSBN0C eq. 4/5 with Ip 1.2 µA, Ih 3.4 µA, VEN 1.2 V); the inverter's EN at VIN + |VO| = 44.7 V is 2.42 V (internal clamp 5.8 V, abs max 8.4 V). The later start keeps the converters off until the input soft-start FET has finished its ramp, as item 100 intended; the buck's 19.0 V stop stays below the brick's 23.3 V minimum less the fuse and FET drops, and on the inverter the stop point is moot. RT R204/R304 243k → 240k (SX-R-084, the feedback divider's part, so no new type): free-running frequency 400 → 405 kHz, used only when the sync clock is absent. Buck compensation R203 15k8 → 16k (SX-R-005, C17490 preferred): calculated 15.94 kΩ (SLVSBN0C eq. 48), so 16k is closer than the 15k first proposed; Czero 220n and Cpole 560p stay (zero at 45 Hz, pole at 17.8 kHz). Four fee types fewer (732k, 42k2, 15k8, 243k; about $12 per order), none added. The 240k feedback resistor stays: it has no fee-free part, and moving the divider to 24k / 1k would need a 470 nF ramp capacitor, which is no longer practical in C0G (the start-up ramp τ = 240k × 47n). Rerun: `scripts/design.py`; `scripts/startup_sim.py` with the 21.31 V start (and the GSM220B24's 232 W limit from item 145): the 47 nF ramp still peaks at 54.2 W, rails at 19 V about 40 ms after switch-on. Netlist checks 0 problems, ERC 0/0.

157. Power switch: a snap-in rocker on the rear panel, wired to the power board (power board schematic session 2026-10-10; refines item 100, which placed a board-mounted switch at the rear edge; confirmed by the user, who asked for something cheap instead of a lever toggle). The switch only pulls the MOSFET gate to PGND through R102 (about 0.12 mA closed, 24.7 V open), so any latching contact rated above 25 V will do. Part: Legion SS11-BBIWG-R20-R (SX-SW-003, LCSC C309069, about EUR 0.32): black, O/− marking, 4.8 mm quick-connect tabs, panel cutout 19.2-19.8 × 12.9 mm by panel thickness (Legion drawing WIF120070 rev A4), 16 A 250 VAC, RoHS statement on the maker's drawing. It connects through a JST XH 2-pin header J102 (SX-CONN-016, B2B-XH-A, LCSC C158012, hand-soldered) with pre-crimped leads, so the rear panel can come off without desoldering; the leads are soldered or crimped (4.8 mm receptacles) to the rocker tabs. No datasheet of the cheap rockers states a DC rating, minimum load or contact material: check on the bench that it switches the gate reliably. The cutout and position on the rear panel go to `/system mechanical` (rear panel, still open). Rejected: E-Switch 100SP1T2B4M6QE toggle (B4 bushing unthreaded, so the board would take every flick; the threaded B3 version had no stock), C&K 7101MD9AQE toggle (threaded, about EUR 8.39: price), the channel cards' GPBS850L latching button (points up from a flat board, so it would move the switch to the top panel and is easy to press by accident on stage), cheaper KCD11 and RS601HL rockers (thin PCB pins not suited to wires, or no maker datasheet), E-Switch RA11131121 (cleanest datasheet but about EUR 0.55 at Mouser).

158. Power board parts left open by item 100 (power board schematic session 2026-10-11; confirmed by the user). Input bulk C103: Nichicon UHE1H101MPD, 100 µF 50 V radial 8 × 11.5 mm, 3.5 mm pitch (SX-C-028, LCSC C116229, about EUR 0.12), hand-soldered: JLCPCB has no fee-free SMD part at 100 µF 50 V, and the board already has hand-soldered radials. Nichicon CAT.8100M: 0.17 Ω max at 100 kHz (moderate ESR, good for damping the input filter), 555 mA rms at 105 °C / 100 kHz against about 0.3 A estimated, 7000 h at 105 °C, RoHS stated. Sync capacitors C207/C307: Samsung CL10C100JB8NNNC, 10 pF C0G 5 % 50 V 0603 (SX-C-029, LCSC C1634, JLCPCB basic) instead of a 100 V 0805 part (extended, $3 per order): C207 sees about 5 V, C307 bridges about 20-25 V (CLK_B from PGND to RT on the −20 V node) and about 40 V at most if the inverter output ran away (VIN + |VO| is limited to 60 V by the IC); C0G keeps its capacitance under DC bias. Rejected: KNSCHA 152EC0412 (cheaper, thinner documents), Panasonic EEU-FR1H101B (twice the price), an SMD bulk capacitor (fee); 100 V 0805 sync capacitors (fee, margin not needed). SX-C-021 and SX-C-022 (the placeholders) are not used.

159. Buck catch diode D201: MDD SS54 in SMA (LCSC C22452, JLCPCB basic) with the D_SMA footprint (power board schematic session 2026-10-11, cost lever 6; refines item 100; confirmed by the user). The drawn footprint was D_SMC while the recorded LCSC code C22452 is the SMA part: the footprint now matches the part, and the part stays fee-free. MDD datasheet Rev 2024A4: 40 V, 5 A, VF 0.55 V at 5 A, IR 50 mA max at 100 °C at rated voltage (about 4 mA typical at 62 % of rating, Fig. 2), RthJA 60 °C/W on 5 × 5 cm copper, TJ max 125 °C. Losses: forward about 0.15 W at 2 A (0.27 W at the 3.3 A full-size figure) at 17 % conduction; leakage at 24.7 V for 83 % of the time about 0.08 W typical, roughly 0.5 W at the datasheet maximum; rise about +15 °C typical, about +40 °C worst case, so near 90 °C junction in a 50 °C box with copper. Layout: give D201 a copper pad; bench check its temperature at full load. Rejected: an SMC SS54 (extended, $3 per order, likely the same die), SS56 60 V (lower leakage but VF 0.70 V).

168. Power LED on the power bay's top strip (power board session 2026-10-13; refines items 60 and 100, which put the power LED on the board at its rear edge; confirmed by the user). Since decision 162 the power board stands on edge in the power bay, hung from the bay's top strip, so an LED on the board cannot be seen; `docs/MECHANICAL.md` (Power bay) already lets the top strip carry the power LED, so no contract changes. The 0805 LED D103 (SX-D-011) leaves the board; R104 (10k from VIN_SW) stays and feeds a JST XH 2-pin header J103 (SX-CONN-016, the rocker's header part, hand-soldered): pin 1 = LED anode (LED_A), pin 2 = PGND (cathode). LED: Kingbright WP710A10LGD (SX-D-004, already registered for the master meter), T-1 3 mm green GaP diffused; Kingbright datasheet DSAL0509 V.9B (2020-04-18): 1 mcd min / 3 mcd typ at 2 mA, 50°, VF 1.9 V typ / 2.25 V max at 2 mA, IF 25 mA DC, VR 5 V, −40 to +85 °C, RoHS compliant. At 23.3-24.7 V the LED runs at about 2.1-2.3 mA (R104 about 50 mW in 0805, LED about 4 mW). The polarised XH housing keeps the LED from seeing reverse voltage; each lead joint gets its own heat-shrink sleeve (Kingbright precautions). Clip: Bivar CR-104 (SX-MECH-006), C-104 clip and R-104 ring, nylon 6/6 UL94 V-0, black; drawing CR-104 rev E: panel 0.8-3.2 mm (the bay's 1.6 mm FR4 strip fits), hole 0.176 in +0.004/−0.002 (4.47 mm +0.10/−0.05), flange 5.3 mm, ring 6.1 mm; Mouser EUR 0.189 at 1, 3599 in stock (2026-10-13); RoHS: Mouser RoHS Compliant. LED EUR 0.232 at 1 (Mouser, 15328 in stock). Both are off-board and counted with the frame in `tools/costs.py`, as the rocker (157). Rejected: a light pipe from an LED on the board's top edge through the strip (needs a tight, known gap between the board edge and the panel, which only the mock-up and the brackets settle; one more part type to source), and leaving the LED on the board (visible only through the vents). Netlist checks 0 problems, ERC 0/0. The hole's position on the top strip goes into `docs/MECHANICAL.md` at the next `/system mechanical` session.
182. Brick jack on the panel (power board PCB session 2026-10-19; refines item 100, which put a Kycon KPJX-4S right-angle PCB jack at the board's rear edge; confirmed by the user). While drawing the KPJX-4S footprint (Kycon drawing rev A13) it turned out the jack has no thread, nut or flange: two plastic pegs and the soldered contacts hold it, so the board would carry it and the panel only passes the barrel through a hole. The user doubted that it would stay sound after a few hundred matings. Ruling: Kycon's panel-mount version KPJX-PM-4S (Kycon drawing rev C2, 2026-01-08: same 4-pin locking connector, mates the KPPX-4P and the Mean Well R7B, 7.5 A per pin at 48 V DC, -40 to +75 C, RoHS compliant; diamond flange 25.2 x 14.2 mm, two M2.5 self-tapping screws 19.0 mm apart driven from the front, length 6.6 mm plus the panel thickness; body 9.9 mm deep behind the flange; non-shielded; Mouser 806-KPJX-PM-4S, 2.30 EUR, 9935 in stock 2026-10-19) is screwed to the power bay's rear strip; insertion, pull and side loads go into the panel. It is wired to the board by four 18 AWG wires, header pin n to jack pin n (1, 4 = +24 V; 2, 3 = 0 V, as the R7B plug), on a JST VH 4-pin top-entry header J101 (B4P-VH(LF)(SN), LCSC C160317, hand-soldered) with a VHR-4N housing and SVH-21T-P1.1 contacts (AWG 22-18). JST rates the VH at 10 A per pin with AWG 16 on the standard header (7 A with AWG 18 on the shrouded header), 250 V, -40 to +105 C, and advises against sharing a current above the rating between parallel pins (JST VH datasheet eVH); here each pin carries about 2.5 A on the prototype brick (120 W, 5 A) and about 4.6 A on the full-size brick (221 W, 9.2 A), each within the rating alone. The schematic's nets are unchanged (J101.1 and J101.4 VBRICK, J101.2 and J101.3 PGND); only the part, footprint and fields of J101 change. On the strip the jack (flange upright, 14.2 mm wide) and the rocker (cutout 12.9 mm wide, upright) sit side by side across the 34.8 mm strip; stacked they would need about 44 mm of the roughly 40 mm jack zone. The board's rear edge no longer needs to meet the strip and ends about 25 mm in front of it (set at placement). Cost: about 0.85 EUR more for the jack plus about 1.30 EUR for the header, housing and contacts per unit (`docs/costs/offboard.csv`), and four crimped leads to make. Rejected: keeping the KPJX-4S with the panel taking the loads (close-fitting Ø13.1 hole, jack shoulder against the strip, a bracket beside the jack): cheapest, but it relies on board edge, shoulder and strip lining up within a few tenths of a millimetre, otherwise the joints take the load again; the shielded KPJX-PM-4S-S (3.49 EUR): its shield would tie to nothing on the floating Class II supply. The rear strip's contents in `docs/MECHANICAL.md` (Power bay: "brick jack (KPJX-4S)") and its cutout change: noted for `/system`.
185. Small power module without chain 2 (power board PCB session 2026-10-19; refines items 100 and 162; confirmed by the user). The board carried three power headers (master, chain 1, chain 2; item 100 fitted chain 2 on the prototype), but its TPS54560 converters are designed for about 2 A per rail: at the sizing figures of `docs/ARCHITECTURE.md` 8 cards plus the master need about 1.9 A (+20 V) and 1.5 A (-20 V), close to that limit (the check is power lever 1 in `hardware/power/CHECKLISTS.md`), and 16 cards plus the master 3.26 / 2.63 A (4.25 / 3.57 A worst case), beyond the inverter's switch-current limit and the 4 A input fuse. The user asked why a board for at most 8 channels has a connector for 16 and, after weighing one full-size module now (a new -20 V inverter with an external-MOSFET controller, about 8-10 A input fuse, lower-resistance reverse-polarity MOSFETs, 2.5-3 A header fuses, a fan per item 167, about 10-20 EUR more per board, sized before the cards are measured), kept the plan of items 96 and 162: this board is the small module, the full-size module follows the prototype measurement. Ruling: J403 and its fuses F405/F406 are removed from the outputs sheet (scripts `outputs_build.py`, `outputs_wired.py`; netlist checks 0 problems, ERC 0/0), the board ends 18 mm earlier (177 mm, front bracket hole H2 moved with it), about 2 EUR of parts less per board. The pinout of the remaining headers is unchanged. `docs/CHAIN.md` ("the power board has three power headers") and `docs/ARCHITECTURE.md` describe the full system: their wording for the two module sizes goes to /system. `tools/costs.py` still prices this small module for every build, the 16-channel estimate included, until the full-size module exists.
186. Power board PCB form (power board PCB session 2026-10-19/20; refines items 100 and 162; confirmed by the user step by step). (1) Stack-up: 2 layers, 1 oz copper, lead-free HASL, JLCPCB's cheapest class with Economic PCBA; the bottom layer is mostly plane, PGND with a separate -20V_CONV island under the inverter (its IC ground), power nets as copper areas on top. Rejected: 2 oz (only if the full-size thermal check needs it), 4 layers (cost; the cards' LC filters and regulators follow anyway; the fallback if the bench shows switching noise on the rails). (2) Outline: a first rear fin of about 170 × 35 mm referenced to the bottom cover left parts covering 68 % of the area (too dense for a 2-layer switcher), so the board grew forward to 195 mm; the user then pointed out that a board hung from the top strip must be referenced to the panel and that the floorplan had no room for brackets: the top edge now runs about 5 mm under the panel along the whole length (the board tilts with the panel, about 6.7 degrees from the rail positions, ±1-2 mm), the bottom edge 35 mm lower at the rear and rising over the front part to keep 3 mm above the cover. With decision 185 the board ends 18 mm earlier: 177 mm, about 138 to 315 mm behind the front rail's inner face (KiCad design coordinates x 100-277, y 99-134; placed on the A4 sheet 40 mm to the left). Rejected: a lower 250 mm fin, a parallelogram along the slope, a taller board (beyond `MECHANICAL.md`'s 35 mm). (3) Mounting: two M3 holes (Ø3.2, unplated, board-only footprints H1 rear and H2 front, 4 mm below the top edge, copper keep-out radius 5 mm on both layers) for two brackets to the bay's top strip, the brackets on the board's back face; no fixing to the rear strip (the user: since decision 182 nothing on the board is plugged from the rear, and the ribbon headers sit under H2); the brackets get some width along the board or two screws each against twisting. This changes `MECHANICAL.md` (Power bay: "fixed at its rear edge to the bay's rear strip"): /system, together with the bracket design (proposal: printed PETG or ASA, not PLA at the 57 °C design air of item 167, L-shaped with a vertical slot for the height tolerance, M3 screws). (4) Ribbon headers: lying along the bottom edge with the long axis front to back, so each cable leaves sideways and folds flat to the floor without a twist (the user), pin 1 (stripe, -20 V) toward the front as on the cards, each header's fuses above it. (5) Build: placement, a hand-designed power stage (locked copper areas, tracks, vias, with bottom-layer hops for U201 EN, U201/U301 COMP, U301 BOOT and the sync clocks) and Freerouting for the small signals, by `hardware/power/scripts/` (`build_pcb.sh`); a first Freerouting-only run left 8 power connections open and cut the bottom plane with the VIN feed. Result reviewed by the user 2026-10-20 ("board looks good"): DRC clean with schematic parity, ERC 0/0.
187. Power board input EMI filter (power board session 2026-10-20; refines item 100; the user chose the recommendation, and the brick-side capacitor below was added on the calculation and reported). Asked how the TPS54560s' EMI is handled, the review found the output side covered (one 400 kHz clock, both converters synchronised in opposite phase, so no beat in the audio band; the second-stage LC filter per rail; the separate board and PGND; the input ceramics tight at each IC over a bottom PGND plane, shielded inductors), but nothing between the brick lead and the converters except C103 and the ceramics: the converters' pulsed 400 kHz input current ran out through the four internal wires and the 1.8 m brick lead, the board's largest antenna, and back through the brick to the mains. Ruling: a pi filter after the soft-start MOSFET Q102: C108 (4.7 uF 100 V X7S 1210, SX-C-018, the converters' input ceramic) on the brick side, L101 (2.2 uH Bourns SRP7028A-2R2M, SX-L-001, the output filters' inductor; 8 A rms, 14 A saturation, 20 mOhm) in series, then C103 and the converter ceramics. New net VIN_PRE: Q102 drain, the Miller capacitor C102 (the ramp follows the drain), C108 pin 1, L101 pin 1; VIN_SW starts at L101 pin 2. No new part type, so no new fee; about EUR 1-2 per build (`tools/costs.py estimate`: EUR 793 / 1,028 / 1,590 for 4 / 8 / 16 channels, from 792 / 1,027 / 1,588). Calculation (2026-10-20, hand model: brick lead and internal wires 0.5-3 uH with 50 mOhm, the brick's output an AC short, converter ceramics about 15 uF after DC bias, C103 ESR 0.05-0.4 Ohm, not taken from the UHE datasheet): 400 kHz ripple current in the lead relative to the converters' input ripple is about -44 dB today (-34 to -50 dB over the lead range); L101 alone gains almost nothing (-44 dB with a 1.5 uH lead) because the 100 nF C101 at the fuse resonates with the lead near 400 kHz; with C108 about -80 dB (-70 to -86 dB over the lead range), about 36 dB better. The filter's output impedance peaks at 0.2-0.36 Ohm near 7-20 kHz, far below the converters' negative input resistance (about 5.3 Ohm at 108 W from the brick), damped by C103's ESR, so no extra damping part. C108 sits behind Q102, so it is charged by the soft start (no hot-plug inrush into a bare ceramic). Layout: F101 stands upright in the free rear corner, D101 and C101 turned, Q101 and Q102 8.7 mm to the rear, L101 between Q102 and C103, C108 and C102 below L101 on a VIN_PRE copper area, the VIN_SW spine from L101's output; TP102 moved between F101 and J101. `placement.py` now takes the parts and every pad's net from the schematic netlist (new parts added from their library footprints). Board rebuilt by `build_pcb.sh`: DRC 0 violations, 0 unconnected, schematic parity. Rejected: L101 alone (the recommendation as first worded: about 0 dB in the model), a ferrite bead only (little effect at 400 kHz), a footprint with a 0 Ohm bridge fitted only if the bench needs it (same board space, a decision deferred without gain), and nothing until the bench (a later fix means a board revision). The filter sits before the full-size input's 9.2 A: the full-size module is a new design (decision 185). Still to look at, one topic at a time: switch-node snubber or edge-control footprints, and common-mode noise through the brick and the audio cable shields (only if the bench shows a problem).
189. Switch-node snubber footprints, not fitted (power board session 2026-10-20; refines item 100; the user chose the recommendation). The second EMI topic after decision 187: each converter's switch node swings fast (about 24 V on the buck, about 44 V on the inverter, between VIN and the -20 V node), and every edge rings with the loop's stray inductance and the diode and IC capacitance, typically 50-200 MHz: that ringing radiates from the switch-node copper and reaches the ribbons and the brick lead (stage wireless, the master card next door). Already helping: Schottky catch diodes (no reverse-recovery spike), short hot loops, shielded inductors. Ruling: an RC snubber footprint across each catch diode, an 0805 resistor (R208, R308) in series with an 0805 capacitor (C215, C315): the buck's from SW to PGND above D201, the inverter's from SW to the -20 V node (-20V_CONV) right of D301, its capacitor to the island by a via. Marked DNP in the schematic (placeholder values 4R7 and 470 pF 100 V, project number 'none'), so JLCPCB places nothing and the cost is unchanged; fitted by hand only if the bench shows ringing worth taming. Sizing on the bench: measure the ringing frequency f1 on the switch node (short ground spring on the probe), add a known capacitor across the diode until the frequency halves (the added C is then about three times the node's capacitance C0), L = 1/((2 pi f1)^2 C0); fit C about 3-4 C0 and R about sqrt(L/C0). The resistor takes about C V^2 f: an 0805 (about 0.125-0.25 W) allows up to about 1 nF on the buck (24.7 V) but only about 270 pF on the inverter (44.7 V) at 445 kHz; more needs a larger resistor wired on. Not fitted by default because a fitted snubber burns that power all the time (1 nF: about 0.23 W buck, 0.8 W inverter; heat, decision 167) against a problem not yet seen. Layout: R208/C215 in a row above D201 with a finger of the buck switch-node copper and a PGND via at C215; R308/C315 upright right of D301's top, the D301-L301 link track moved up to y 121.1. In the schematic L201 and L301 moved right to make room (no net change). `placement.py` now also takes the DNP and BOM flags from the symbols. Board rebuilt: DRC 0 violations, 0 unconnected, schematic parity. Rejected: snubbers fitted now with estimated values (the loss without knowing the need, guessed values); a resistor in series with the BOOT capacitor to slow the turn-on edge (not checked against the TPS54560 datasheet; can follow if the bench needs more); nothing (a later fix means a board revision). The measurement is a bring-up task: `hardware/power/CHECKLISTS.md`, Bench.

## Open items

- [x] Supply rating for 16 cards plus the master: decision 96 (`system.md`), 3.6 / 3.0 A per rail, about 132 W; prototype 1.35 / 1.11 A (rerun after decisions 102 and 103: 3.56 / 2.94 A, 130 W; prototype 1.33 / 1.09 A; after decision 123: 3.37 / 2.75 A, 122 W; prototype 1.28 / 1.04 A; `docs/ARCHITECTURE.md`), converters about 2 A per rail. Raw rails above about 19 V under load
