plektra/syntsamix/docs/decisions/record/channel-card.md

# Channel card decisions

The stereo channel card (`hardware/channel-card`): receiver, trim, low-cut, ladder filter, VCA and fader, routing, meter, chain and power sheet.

Full record (decision 154): the complete text of each decision as made, with figures, sources and rejected options. The current rulings, which sessions read first, are in `../channel-card.md`; the index of all decisions is `../INDEX.md`. Numbers are global and never reused. Text marked **[proposed]** still needs the user's confirmation.
Part and mechanical choices made for the panel stack (decisions 110-115, 117) are in `channel-card-parts.md`.

## Decisions

4. Per channel: level fader, mute, ladder filter, two AUX connections, balanced inputs
7. Filters are 24 dB/oct (4-pole) ladder lowpass filters with resonance. "Moog-style" is dropped as a requirement
8. Channel HPF is dropped from the prototype to simplify the build; resonance is therefore LPF-only
9. Filter part: SSI2144 baseline, AS3320 fallback
12. Filter gain structure: "hot" drive by default (+4 dBu at the datasheet nominal ±20 mV), with a per-channel filter bypass. Updated after simulation (item 50): saturation starts around +8 dBu when the cutoff is lowered, and a prototype jumper offers a medium drive
16. L/R filter tracking: shared control path plus a per-chip frequency offset trim and temperature-compensating resistor
17. Resonance limited by a fixed maximum Q current (about 300 µA) so no chip self-oscillates
18. Compensate the passband/bass gain loss that comes with resonance (half compensation, item 50)
19. Fader controls a VCA; part chosen in item 31
20. Per-channel cutoff CV input is included
22. No balance/pan control on the channel
23. AUX sends: post-fader, with a PCB jumper per send for pre-fader
26. One wide input trim (about -20 to +20 dB overall), no pad switch
31. VCA: SSI2162 dual, one per channel card (L/R) and one for the compressor. The clean-path THD+N target is relaxed from 0.01% to 0.05% to fit a tight budget
33. Input receiver: AD8273 dual difference amplifier at G = ½, one chip per channel card
35. Fader: linear 60 mm fader generating the VCA control voltage; a resistor network shapes the law to a pro console feel (fine resolution near 0 dB, fast fade to silence at the bottom)
36. Fader range: +10 dB at the top, -∞ (fully off) at the bottom
37. Fader scale: 0 dB at about 75% of travel; markings +10, +5, 0, -5, -10, -20, -30, -40, -60, -∞
43. Each channel card has an 8-segment mono LED level meter (louder of L/R), measuring after the filter and before the fader (same point as PFL); scale -30, -20, -10, -5, 0, +3, +6, clip relative to +4 dBu nominal. It replaces the peak LED. Built from a peak detector and comparators, not LM3915-type driver chips. Low-current LEDs returning to power ground. PFL is kept for listening (meter form: 0805 LEDs under a printed bezel since item 119)
48. Fader part: Bourns PTA6043-2015DPB103 (60 mm, single gang, linear, 10 kΩ, PCB pins, no detent, 15 mm metal lever). Fallback: Taiwan Alpha 60 mm 10k linear (check footprint). An RC filter smooths the fader's control voltage against wiper noise (datasheet: up to 100 mV sliding noise). Rated life 15,000 cycles: fine for the prototype; look for a longer-life fader for a product version
50. Filter simulation outcome: keep hot drive as the default and add a prototype jumper for a medium drive 4 to 6 dB lower (pre-filter attenuator and make-up gain switched together), to choose by ear on the breadboard. Resonance uses half compensation (make-up gain √(1+k) tied to the Q control): -6 dB bass loss and about +9.5 dB peak at maximum Q. Per-chip cutoff trim must inject at least ±12 mV at the frequency control pin
52. Filter cutoff range 20 Hz to 20 kHz on a linear pot (even octave spread through the exponential control)
53. Cutoff CV input: fixed about 1 V/octave, no amount knob (depth set at the source); DC-coupled, about 100 kΩ, protected to ±12 V, summed with the cutoff knob and limited
54. Channel buttons on the prototype are latching push switches with two contact sets (function plus LED); momentary buttons with logic are in the backlog
65. Switchable fixed low-cut per channel at about 150 Hz (12 dB/octave proposed), film capacitors, after the trim stage and before the ladder filter; one more latching button with LED. The sweepable resonant HPF stays in the backlog. Moved to 100 Hz by item 73
71. Resonance compensation uses the SSI2144 datasheet's external Q VCA (Rev 3.0 page 6, Figure 9): half of an LM13700 per filter (one chip per card), driven from one single-gang reverse-audio RESONANCE pot. The chip's own Q pin gets the datasheet's 13 kΩ to ground. A per-side 3-pin jumper selects the input share R10: none (plain SSI2144), half (R10 = 3 x R14, default; -3.5/-5.1/-6.0 dB at k = 1/2/3 against the √(1+k) target of -3.0/-4.8/-6.0 dB) or full (R10 = R14, constant bass). Refines decision 50: same half compensation, built in the feedback loop instead of a make-up gain stage, so no triple-gang pot or second VCA is needed
72. Level sheet: SSI2162 per datasheet Rev 1.2 Figure 1 (10 kΩ in and out, 110 Ω + 2.2 nF input network, 10 µF input coupling for control feedthrough), Class AB by default with a DNP mode resistor for trying Class A. The VCA stage inverts and a unity inverter restores polarity, so post-fader and pre-fader taps share one polarity. The fader law is a 3-segment piecewise curve from a buffered linear fader and two precision (superdiode) breakpoints on TL072s (buffer and summer on an OPA2171 since item 102): +10 dB at the top, 0 dB at 75 %, -10 dB at 53 %, -20 dB at 42 %, -40 dB at 19 %, -60 dB at 14 %, -113 dB at the bottom. A 10 ms smoothing in the control summer covers fader noise and the click-free mute ramp. MUTE and DUCK switch through one DG413: mute adds +4.5 V to the control voltage (-127 dB at the top of the fader), DUCK adds SC_ENV at 10 dB of ducking per volt (scale and circuit: item 97, SC_ENV negative, fed into the summer's virtual earth through 30k1)
73. The switchable low-cut moves from about 150 Hz to 100 Hz (refines decision 65): same 12 dB/octave unity-gain Sallen-Key with 47 nF film capacitors, resistors changed to 24 kΩ and 47 kΩ (101 Hz, Q 0.71)
74. Routing sheet: the post-filter signal is buffered (NE5532 followers) before the pre-fader taps (PFL, SC send, meter, AUX pre option), so they do not load the filter's DG413 bypass switch. Every bus is driven through 22 kΩ (was 22.1 kΩ, changed by item 79); the master card's virtual-earth amplifiers use 22 kΩ feedback for unity gain per channel. The SC send sums L and R through 44.2 kΩ each, so the SC bus carries (L+R)/2. (47 kΩ since item 140: the SC bus carries 0.47 (L+R).) AUX sends use a 10 kΩ audio dual-gang pot per send (wiper drives the bus resistor) and a 2x3 header per send for pre/post (default post). Bus assign switches each side's bus resistor to MAIN or COMP through one DG413 (pressed = COMP); PFL and SC send switch through a DG412 (four normally-open switches). PFL_ACT is pulled to AGND by an MMBT3904 open collector (to PGND since item 98)
76. Meter sheet: L, -L, R and -R each drive a precision rectifier (superdiode, TL072) that charges one 1 µF hold capacitor through 1 kΩ outside its feedback loop (about 1 ms attack, stable); 680 kΩ gives a fall of 20 dB in about 1.5 s. A follower drives eight LM339 comparators against a 1% resistor ladder from +15 V (thresholds within 0.06 dB). The clip segment lights at +10 dB re nominal (+14 dBu, the soft-clip onset; confirmed by the user). LEDs: 3 mm, five green (-30 to 0), two yellow (+3, +6), one red (clip), about 2 mA each from +5 V, sinking into the LM339 outputs whose ground is PGND. A 10-segment bar graph and square LEDs were considered and dropped (item 86) (LEDs: 0805 under a printed bezel since item 119; colours and drive unchanged)
78. Chain and power sheet: the audio (34-pin) and power (8-pin) ribbons each have an IN and an OUT header wired straight through. LM317/LM337 make ±15.1 V from the raw ±20 V (200 Ω / 2.2 kΩ since item 79, 10 µF on ADJ, protection diodes per the TI datasheets), a 78L05 makes +5 V for the DG41x logic and the meter LEDs. Input capacitors return to PGND; dividers, output capacitors and SS14 rail clamps (stop a rail being pulled the wrong way at power-up) return to AGND. Estimated load about 130 mA per rail per card, so about 0.7 W in each TO-220 regulator. With this estimate 16 cards draw about 2.1 A per rail, about 1.05 A per power-ribbon pin: the power ribbon's current capacity must be rechecked in the master card design. Superseded figures: power injection in groups of 8 (item 80); budget and sizing in item 96 (`scripts/power_budget.py`: typical 122 / 105 mA, worst case 253 / 218 mA, regulators 1.24 W worst case; 121 / 103 mA, 249 / 214 mA and 1.22 W since item 102)
102. Fader buffer input range (from /system 2026-10-08; refines item 72): U204 becomes an OPA2171 (TI SBOS516H: input range (V−) − 0.1 V to (V+) − 2 V, no phase reversal, rail-to-rail output, 0.475 mA per amplifier). The fader wiper reaches −15 V at the bottom, below a TL072's input range, where the classic TL07x reverses its output phase and could send the VCA to full gain. The OPA2171's inputs carry back-to-back protection diodes, which would conduct in a superdiode (open loop when off, about 5.6 V across the inputs) and leak current into VSUM, so U204 holds the fader buffer (A) and the control summer (B, linear, + input on AGND), and both superdiodes move to the TL072 U205 (A: breakpoint 2, B: breakpoint 1). Same part count; about +$0.20 per card (LCSC C40904, $0.36 against about $0.12 for a TL072); 1.9 mA less per rail typical. Simulated (`simulation/level/`): the law is within 1.2 dB of item 72 from +10 to −60 dB, and the bottom of the fader gives about −102 dB instead of −113 dB because the output stops about 0.45 V above −15 V (inaudible). With decision 97 the ducking is 10.07 dB per −1 V of SC_ENV at every fader position, 90 % of a 40 dB step after 23 ms (10 ms time constant). Rejected: a resistor at the bottom of the fader with a TL072H (the law would then depend on the fader's track tolerance, about ±2 dB at −20 dB) and relying on the TL072H not reversing phase outside its specified range
123. Channel op amp power levers (`/board channel-card schematic` 2026-10-09; confirms Power-cut candidates 1 and 2 of `docs/ROADMAP.md` for the channel card; the user took the recommendation). U107 (cutoff CV summer, DC control stage driving about 40 kΩ at a noise gain of about 4) goes from NE5532 to TL072: noise does not matter there, and the FET inputs improve DC accuracy into the 100-301 kΩ network. U401 (meter inverters, 10 k in and feedback) and U404 (hold follower into eight LM339 inputs) go from TL072 to TL062CDR (TI SLOS078N: VICR ±11 V min, swing ±10 V min into 10 k, 0.2 / 0.25 mA per amplifier, 3.5 V/µs; the meter needs about ±5.5 V at the +14 dBu clip point, HOLD stays between 0 and about +11 V, and 20 kHz at 11 V peak needs 1.4 V/µs; above clip an inverter may limit at ±10 V, with the clip LED already lit). U205 (superdiodes, open loop when off) and the meter superdiodes U402/U403 stay TL072. Card load drops from 121 / 103 mA to 113 / 95 mA typical, 249 / 214 to 229 / 194 mA worst case, sizing 186 / 154 to 174 / 142 mA (`scripts/power_budget.py`)
129. RESONANCE pot within its power rating (`/board channel-card schematic` 2026-10-09; refines item 71; the user took the recommendation). Taiwan Alpha's RD901F specification (RD901F-(C), Tayda copy SP26020021, 2026-02-04; drawing SLH-211-414) rates the track at 0.05 W for B taper and 0.02 W for every other taper. RV183 (C10K) sits in the chain +15.1 V → R184 → RV183 → D181, D182 → −15.1 V: with R184 = 10 k the pot carried 28.9 V / 20 kΩ = 1.45 mA, about 21 mW with the wiper at the bottom end (above its rating). R184 becomes 12 k (SX-R-008): 1.31 mA, about 17 mW. With the wiper at the top, loaded by R120/R170 (41.2 k each into the LM13700 bias pins, about 1.2 V above −15.1 V), the maximum Q current falls from about 284 µA to about 254 µA (k about 2.8 → 2.5). R184 is provisional with R120/R170: the breadboard sets the Q current limit; 36.5 k for R120/R170 would restore about 280 µA with R184 = 12 k. The other panel pots are within rating: CUTOFF (B50K across ±15.1 V) about 18 mW of 50 mW, AUX (A10K, audio, wiper into 22 k) about 6 mW at +20 dBu, TRIM (feedback resistor) negligible. Rejected: keeping 10 k (part outside its datasheet limit, invariant 6) and a B-taper pot with a law-shaping resistor (changes the reverse-audio law of item 71)
130. Tempco leg from an orderable part (`/board channel-card schematic` 2026-10-09; refines item 16; the user took the recommendation). The Panasonic ERA-V33J102V (1 k, +3300 ppm/K, 0603) named by the SSI2144 datasheet is End of Life at Mouser with no stock (checked 2026-10-09), and no other maker offers a 1 k +3300 ppm/K chip at Mouser, TME or LCSC. R108/R158 become a Vishay TFPT0603L8200FV (nickel thin-film linear PTC, 820 Ω 1 %, 0603, +4110 ppm/K ± 400 at 25 °C; Vishay TFPT datasheet doc. 33017 rev. 15-Apr-2026; SX-R-089) and new R122/R172 a standard 180 Ω 1 % 0805 in series to AGND (SX-R-090): 1 k at 25 °C as before, so the FREQ pin divider and the V/oct scale are unchanged, at 820 × 4110 / 1000 ≈ +3370 ppm/K, 2 % above the datasheet's 3300 and well inside the TFPT's own ± 400 ppm/K. Only the TFPT must sit against the SSI2144. RV182 trims the scale and RV101/RV151 the offset as before. Mouser: 71-TFPT0603L8200FV, 1379 in stock, about €0.96 (2026-10-09). On the drawing the trim pot value text RV101/RV151 is shortened to "50k OFFSET" to make room. Rejected: a TFPT 1 k with 243 Ω in series (3300 ppm/K, but 1.24 k changes the divider), synth-DIY through-hole tempcos (Electrokit 1 k 3500 ppm, Thonk KRL/Akaneohm: no maker or RoHS statement yet, hand-soldered) and broker stock of the ERA-V33J102V (dead part for later builds). The master card's R421 still uses the ERA-V33J102V (its own session)
139. PFL and SC send switch U303 a DG413 instead of the DG412 (`/board channel-card schematic` 2026-10-10; refines item 74; cost lever 6 of the system cost review `docs/reviews/2026-10-10-cost-system.md`, taken under the user's delegation for this session: "work autonomously and follow recommendations"). In the DG413 (Vishay doc 70050 Rev E, already used for U302 and U206) SW1 and SW4 are normally open and SW2 and SW3 normally closed. PFL L stays on SW1 (pins 1-3), PFL R moves to SW4 (pins 6-8), both driven by PFL_CTRL as before. The SC send moves to the normally closed SW2 (pins 14-16), driven by the new net SC_OFF from SW302 pin 1: the GPBS850N connects pins 1-2 (+5 V) when released (pressed = 2-3, datasheet Rev 1), so SC_OFF is high and the send off while SC SEND is out; pressed, pin 1 opens and the existing 100 k R315 pulls SC_OFF to PGND, so the send is on. SW302 pin 3 is now unused, so no part is added (the review's extra pull-down is not needed). SW3 stays tied to AGND. Break-before-make in the button is harmless: the send turns on only once pin 1 opens. Saving about €3.60-6.10 per card (DG412 8.24 USD at LCSC, DG413 1.64) and one fee type; SX-IC-008 is no longer used on any board. Netlist checked against the reference (46 nets), ERC 0/0
140. Channel card values on E24 (decision 134) and fee-free parts (decision 137) (`/board channel-card schematic` 2026-10-10; cost lever 10 of the 2026-10-10 review, under the same delegation; the off-E24 table of `STATUS.md`). Every resistor value is now E24 with a JLCPCB basic or preferred UNI-ROYAL 0805W8F part (LCSC search 2026-10-10), except R217 30k1 (below). E24 values with no fee-free part (110 R, 160k and others in the review's list) are avoided. Where one E24 value is not close enough, a series pair of fee-free values takes its place (one more placement, no fee). Input: trim stage R5/R6 3k9, R7/R8 820, R9/R10 1k8 (gain −13.5 to +28.3 dB, was −14 to +28; soft-clip ratio R9/R5 0.462, was 0.465). Filter: medium drive R103 16k / R113 6k2 (−4.2 / +4.2 dB, was −4.0 / +4.1); hot attenuator and Q feedback R104, R117, R119 18k (+4 dBu gives ±19.0 mV at SIG IN, was ±19.7 mV); half compensation R118 51k (2.83 × R104, was 3.0 ×: slightly more compensation, closer to the √(1+k) target at low k); Q VCA divider R115/R116 560 Ω, the SSI2144 datasheet's value; R111 9k1 and R120 36k stay provisional until the breadboard. R111 rises with the attenuator to keep unity. R120 36k gives about 281 µA maximum Q current (was 253 µA; decision 129 asked for 36.5k to restore 280 µA), which keeps the Q loop's maximum k about where it was with the smaller OTA divider. RV183 still dissipates 17.4 mW at most (computed with the R120 load). Cutoff summer: R181 300k; R183 becomes the pair 150k + new R187 12k (162k): V/oct needs about 192k of feedback (−19 mV/oct through the 100k/1k divider), and RV182 must bracket it from both sides, which neither 150k (top only +4 %) nor 180k (bottom only −6 %) does. RV182 now sits in the FCV column of the drawing. Level (fader law): R207 = 100k + new R223 13k, R208 = 300k + new R224 150k, R210 220k, R211 62k, R213 = 100k + new R225 24k, R214 9k1, R216 33k; `simulation/level/run.py` (ngspice) gives +10.1, 0.0, −9.6, −19.6, −41.4, −59.7 dB at 100, 75, 53, 42, 19 and 14 % against the design +10, 0, −10, −20, −40, −60 (the previous values gave 10.0, 0.0, −9.7, −19.6, −41.2, −60.2); the mute and ducking scales are unchanged (ducking −10.07 dB per −1 V). R217 stays 30k1: `docs/ARCHITECTURE.md` names 30.1 kΩ in the SC_ENV chain line, so a change goes through /system (30k would move the ducking scale by 0.03 dB). Routing: SC send R305/R306 47k (the SC bus carries 0.47 (L+R), −0.6 dB from (L+R)/2; the master's sidechain has its own threshold). Meter ladder R410-R418 39k, 8k2, 3k9, 3k, 3k, 1k8, 1k5, 470, 220: every threshold within 0.21 dB of −30 … +10 dB re +4 dBu peak, ladder current 0.25 mA (was 0.50). New part numbers SX-R-092 to SX-R-106; 17 resistor types left unused. The master still uses the old fader-law set (SX-R-014, SX-R-023 to SX-R-028) for its AUX returns and master out: noted in its `STATUS.md`. With decision 139, `tools/costs.py estimate` for 4 channels falls from €1,035 to €963 (channel parts −€25, JLCPCB fees −€47; fee types 87 → 70). All sheets match their references, ERC 0/0 (R217 30k1 → 30k by system decision 153)
141. Temperature compensation of the filter to the backlog (`/board channel-card schematic` 2026-10-10; cost lever 12; the user asked for it on 2026-10-10 and delegated the details: "work on this autonomously"; reopens decision 130 and the tempco half of item 16). R108/R158 become a standard 820 Ω 0805 (SX-R-100, JLCPCB preferred) in series with R122/R172 180 Ω as before, so the FREQ leg stays 1 k and the netlist, the divider and the V/oct scale at 25 °C are unchanged; only the +3300 ppm/K is gone. Cost: the cutoff scale now drifts with the chip's temperature (about 0.33 %/K of the V/oct scale: 10 K of warm-up moves a 3-octave CV sweep by about a semitone, and L and R drift together as long as the chips are equally warm); the knob is still set by ear. Saving €1.95 per card and the only Mouser-only consigned SMD part (TFPT). Backlog item in `docs/ROADMAP.md`: put a TFPT (0805 or a 0603 footprint) back in R108/R158; breadboard test 12 measures the drift. SX-R-089 is no longer used
142. MUTE and DUCK switched by the buttons, no DG413 (`/board channel-card schematic` 2026-10-10; cost lever 2; the user asked for it on 2026-10-10 and delegated the details: "work on this autonomously"; refines items 72 and 97). The free logic pole of each latching GPBS850N now switches the control voltage itself: MUTE pin 3 = −15 V, DUCK pin 3 = SC_ENV, common pin 2 = MUTE_V / DUCK_V into R216 33k / R217 30k1 at the control summer; pin 1 (released) stays open and R220 / R222 100k (the former logic pull-downs) hold MUTE_V / DUCK_V at AGND when off, so the circuit does not depend on the switch's contact sequence: a make-before-break contact would otherwise short −15 V, or the shared SC_ENV line, to AGND for a moment (architect review 2026-10-10; the GPBS850N sequence is not recorded). Engaged, the 100k draws 0.15 mA from −15 V and changes nothing at the summer. The summer's 10 k ∥ 1 µF (10 ms) smooths the step exactly as it did after the DG413, so the mute and duck ramps stay click-free and contact bounce (a few ms) is filtered; mute still adds +4.5 V to VC and DUCK still gives 10 dB per −1 V (`simulation/level/`). The contacts carry at most 0.45 mA DC at 15 V, a wetting current like the logic they carried before. U206 (DG413) and one decoupling pair (C235/C236) go: about €1.70-1.90 per card, no part added. The prototype rule "buttons only carry logic and LED current" (root `CLAUDE.md`) is read as audio never runs through a button; these are DC control currents, and the wording there now says so. Decision 69 (system: one pole drives a logic line to a DG413) is refined by this board decision; the architect asks for a /system confirmation of that refinement and of the reworded scope line (noted in the channel `STATUS.md`). Rejected: driving the summer from a logic level (wrong polarity, and a 5 V/15 V offset scheme leaves a few dB of gain error, cost review 2026-10-10)
143. Input receiver: TL072 difference amplifier instead of the AD8273 (`/board channel-card schematic` 2026-10-10; cost lever 1; the user asked for it on 2026-10-10 and delegated the details: "work on this autonomously", after the user's note that balanced runs are at most 5 m and usually 1-2 m; refines items 25 and 33). U1 becomes a TL072CDT (SX-IC-007, JLCPCB basic) as a G = ½ difference amplifier per side: R1-R4 (the RFI series resistors, with the 220p C0G caps) become 10k 0.1 % and form the first half of each 20k input leg, then R19/R21 (L) and R23/R25 (R) 10k into the inverting and non-inverting inputs, R20/R24 10k feedback and R22/R26 10k to AGND, all 10k 0.1 % thin film (YAGEO RT0805BRD0710KL, LCSC C110775, SX-R-107; one extended type, no 0.1 % part is fee-free). IN+ drives the inverting leg as the AD8273 pins were wired (−INA, +INA), so the receiver still inverts and the trim stage inverts back. Headroom: ±12 V peak in gives ±6 V out (decision 25); the non-inverting input sees a third of the input, well inside the TL072's common-mode range. CMRR from the resistor match: at least 51.5 dB worst case ((1 + G)/4t with 0.1 %), typically about 60 dB, against the AD8273's 77 dB minimum. With short runs the cable picks up little; what CMRR rejects here is ground-loop hum between the gear, which does not depend on cable length, and 50-60 dB keeps a 10 mV loop voltage 100 dB or more below +4 dBu. Noise: about 35 nV/√Hz at the receiver output (TL072 18 nV/√Hz at a noise gain of 1.5 plus the 10k/20k resistors), EIN about −98 dBu over 20 kHz, below the filter's 92 dB dynamic range. Input impedance 20k (IN+) and 30k (IN−). Supply: −2.2 mA typical per rail (`power_budget.py`). Saving about €3.20 per card (AD8273 €3.82 against a TL072 and twelve 0.1 % resistors), and the channel consigns one part fewer (the master's AUX returns still use the AD8273). Rejected: 1 % basic resistors (no fee, but 31.5 dB worst case CMRR) and the NE5532 (3.5 dB quieter receiver, 3 mA more per rail)

155. Channel SSI2144 and SSI2162 hand-soldered on the prototype (`/board channel-card schematic` 2026-10-10; cost lever 11; the user: "for the prototype, I can also hand solder SSI2162 and SSI2144, let's wait on the bipolar capacitors test results"; refines item 133 for these parts, as decision 150 does on the master; reverses the user's earlier note of the same day that the SSI2144 stays with JLCPCB). U101/U102 SSI2144 (SX-IC-001, QSOP-16, 0.635 mm pitch) and U201 SSI2162 (SX-IC-002, SSOP-10, 1.0 mm pitch) carry Assembly = "hand (decision 155)"; `tools/costs.py` counts them as user-soldered. With the master's SSI2162 already hand-soldered (decision 150), neither type is consigned any more: two fee types fewer (38 → 36, about €105 → €99 per order) and €794 → €788 for the 4-channel build (estimate 2026-10-10). On the 4-channel prototype that is 8 SSI2144 and 4 SSI2162, bought by the user (Electrokit). The €30 consignment handling stays while the 10 µF bipolar capacitors (SX-C-023) are consigned; they wait for breadboard test 11 (X5R ceramics, cost lever 7): if it passes they become a JLCPCB basic part and the handling goes too. Backlog: a product build returns both chips to JLCPCB placement (the 0.635 mm SSI2144 is the hardest joint on the card; a bad joint silences one channel, not the mixer). Rejected: keeping both consigned (about €5.52 more per order) and hand-soldering only the SSI2162 (keeps the SSI2144 fee). Update 2026-10-11: decision 161 replaced the bipolar capacitors with back-to-back SX-C-024 pairs placed by JLCPCB, so the channel card has no consigned part left.
165. Cutoff CV chaining, CV OUT and a clamped cutoff summer (`/board channel-card` 2026-10-13; the user asked for the feature and confirmed it for the prototype, then took the recommendation on each point: "Put it in the prototype", "go with the recommendation"; refines items 20 and 53). Purpose: one cutoff knob or CV drives the cutoff of several channels by patching one channel's CV OUT into the next channel's CV IN. (a) CV OUT: a second Thonkiconn PJ398SM per card (J182, SX-CONN-014) reports the channel's total cutoff control at 1 V/oct, that is what its own filter receives: the pot alone with nothing plugged in, the incoming CV alone in CV ONLY mode, CV plus pot in CV + POT mode. Built on the spare U107B as an inverting stage from FCV (R189 100k in, R190 51k + R191 1k feedback, gain 0.52, the inverse of the summer's nominal 1.92) with R192 1k in series to the tip (short-proof, isolates cable capacitance); the sleeve is AGND. The card's V/OCT trimmer RV182 also scales CV OUT, so cards trimmed for chips at the ends of the −18 to −20 mV/oct spread differ by up to about ±5 %: a following channel may sit up to about a quarter octave off at the knob's extremes and tracks around noon (accepted for a live device, decision 135). (b) Mode jumper JP181 (3-pin header, SX-CONN-005, underside per item 112): R181 (now 200k, SX-R-116) runs from the CUTOFF wiper to JP181 pin 2; pin 1 is the CV IN jack's normal contact (J181 TN, before on AGND); pin 3 feeds the summer through new R188 100k. 1-2 CV ONLY: with nothing plugged in the pot reaches the summer through the jack contact and R182 (200k + 100k = 300k, the previous scale), a plugged CV breaks the contact and replaces the pot. 2-3 CV + POT: the pot reaches the summer through 200k + 100k as before, the CV adds to it; the knob becomes an offset (noon = 0 V, no detent). No buffer, pull-down or extra op amp is needed: an unplugged tip sits at the summing node's virtual earth through R182, and the open end of the unused path carries no current. (c) Summer clamp: the SSI2144 datasheet (Rev 3.0, p2) specifies the frequency pin from −120 to +150 mV and gives no absolute maximum for it; above about +175 mV the ladder current falls below the output amplifier's bias, the filter passes nothing and recovers at about +135 mV, possibly with a thump (p5; part and batch dependent). Unclamped, U107A swings to about ±13.5 V, about ±134 mV at the pin through the 100k / 1k divider and up to about ±165 mV with the offset trim: a strongly negative CV with the knob down could reach the dropout even before chaining (item 53's "limited" was only the op amp rail). Two BZT52C11 back to back across the summer feedback (D184 cathode on the summing node, D185 cathode on FCV, anodes joined; hongjiacheng, LCSC C19077409, JLCPCB preferred, SX-D-018; datasheet Rev 2.1: 10.45 to 11.55 V at 5 mA, 0.1 µA at 8 V) limit FCV to about ±10.5 to 12 V. `simulation/cutoff/` (ngspice; datasheet tolerance, V/oct feedback 182k / 192k / 202k, three knee shapes because the datasheet's curves stop at 0.5 mA): error inside the pot's range at most 0.015 octave with a typical knee and 0.19 octave in the worst corner (low zener, softest knee, −20 mV/oct chip, at the ends of the sweep only); pin within ±113 to ±128 mV including a ±10 mV trim, below the recovery level and about 47 mV from the dropout; CV OUT then stays within about ±5.4 to 6.3 V. C10 bends the sweep ends by up to 0.56 octave, C12 reaches ±138 mV. Breadboard test 13 measures the real knee and dropout. Cost per card: one PJ398SM, two zeners, five resistors (R188, R189 to R192) and a 3-pin header; R181 changes value; no new chip, the 200k and 11 V zener are fee-free (basic, preferred). Panel: CV IN and CV OUT side by side in row 3 of the strip; `docs/MECHANICAL.md` and the panel layout in `SPEC.md` change only through /system (noted in `STATUS.md`). Patching a channel's CV OUT into its own CV IN latches the cutoff at a clamp end (harmless). Rejected: CV OUT as a pass-through of the incoming CV (the user's first idea: in CV + POT mode the card would need plug detection to count the pot once, and followers would not follow the leader's knob); always CV + pot without a jumper (exact following would depend on setting each knob to noon by eye); a trim-independent CV OUT summer (an extra stage, not limited by the clamp, and no longer what the filter receives); a cutoff link line on the chain ribbon with a LINK button (changes `CHAIN.md`, a source for the line, a panel button: backlog-sized); for the clamp, the datasheet's diode network on C4A/C4B (Figure 8: only the dropout side, does not limit CV OUT), limiting only the CV input (pot plus CV can still exceed) and diode clamps at the pin to reference voltages (more parts per chip)
183. Bus assign, PFL and SC send switched by CD4052B CMOS multiplexers instead of DG413s (2026-10-19; lever 2 of the commercial-console comparison in that session: the user asked for a comparison with Midas, Soundcraft, Harrison 32, Allen & Heath and Yamaha consoles and chose "let's proceed with levers 1 and 2"; refines items 69, 74 and 139). Consoles of that class put their assign switches at the virtual-earth end of the bus resistor and ground the resistor end that is not assigned, so the switch never carries the signal voltage; the channel card already had its bus-assign switch at that end (item 74), so a ±15 V DG413 (€1.34, extended) is more part than the job needs. Part: TI CD4052BM96 (SX-IC-026, LCSC C6521, JLCPCB preferred, no fee; $0.22 at 50+; datasheet SCHS047O May 2026): dual 4:1 analog multiplexer, one address (A, B) for both sides, so one package switches L and R together. Supplies: VDD = +5 V (the card's 78L05; logic thresholds referenced to VSS, VIH 3.5 V min at VDD 5 V, so the button logic lines drive A directly as they drove the DG413), VSS = AGND (as the DG413 GND pin), VEE about −6.2 V from −15 V through R505 10k and D507 BZT52C6V2 (SX-D-001) on the Chain and power sheet, a PWR_FLAG and test pad TP507 there, 100 nF on VDD and VEE at each package (C303-C308). VDD − VEE is about 11 V, well inside the 20 V absolute maximum (±15 V directly would be 30 V); rON is about 180-200 Ω typical (400 Ω max at 25 °C, 520 Ω at 85 °C), so the level error with the 22 kΩ bus resistors is about −0.08 dB (−0.2 dB worst case) and L/R match within ΔrON 10 Ω (0.004 dB); the signal at the switch is the master summing amplifier's error voltage (millivolts), so rON does not modulate and adds no distortion. VEE leaves several volts of margin should a master bus amplifier clip (the bus node then moves; input current is limited to under 1 mA by the 22 kΩ, inside the ±10 mA rating). The zener draws about 0.9 mA from −15 V (power budget −15 V +1 mA per card). Wiring: B and INH on AGND, so only channels 0 and 1 are used (X2, X3, Y2, Y3 no-connect). U302 bus assign: X = L_BUS (R301), X0 MAIN_L, X1 COMP_L; Y = R_BUS (R302), Y0 MAIN_R, Y1 COMP_R; A = COMP_CTRL (pressed = high = COMP, as before). U303 PFL: X = L_PFLR (R303), X0 AGND, X1 CUE_L; Y = R_PFLR (R304), Y0 AGND, Y1 CUE_R; A = PFL_CTRL. U304 SC send: X = SC_SUM (R305 + R306), X0 SC, X1 AGND; A = SC_OFF (high while SW302 is released, item 139), Y unused. Grounding the released resistor ends loads the pre-fader buffers (NE5532) with 22 kΩ and 47 kΩ more, which they drive easily, and keeps the off switches at virtual-earth level too. Three packages instead of two: PFL L/R and SC send need three independent switches and a CD4052B has one address; a CD4053B (three independent SPDT) is extended at LCSC, so its fee would cost more than the third CD4052B at 4 to 16 channels. Low-cut and filter bypass stay on DG413 (in-line switches carrying the full signal swing). Drawn with the KiCad symbol Analog_Switch:HEF4052BT (the standard 4052 pinout, checked against TI SCHS047O Table 4-2; switch pins typed passive, so no ERC rule is relaxed: the CD4052B symbol's bidirectional pins against the AGND PWR_FLAG gave pin-to-pin warnings), value CD4052B. Cost: about €2.0 per card in parts (two DG413 €2.67 → three CD4052B €0.61 plus R505, D507 and two capacitors), no fee change; the DG413 fee stays for low-cut and bypass and for the master. Click behaviour (charge injection into a virtual earth, comparable to the DG413's) is checked on the prototype. Rejected: a CD4053B for PFL and SC send (extended fee), VEE = VSS = 0 V (rON about 470-1050 Ω and no margin below ground), the KiCad Analog_Switch:CD4052B symbol (pin-to-pin ERC warnings), relaxing the ERC pin map instead.
184. Channel trimmers from LCSC: BOCHEN 3296W-1-503 instead of Bourns 3296W-1-503LF (2026-10-19; lever 1 of the same comparison, chosen by the user with lever 183; refines the trimmer choice of 2026-10-10 and supersedes the LCSC-Bourns option of the 2026-10-13 cost review, levers P6 and C4). RV101 and RV151 (OFFSET, dividers between ±15 V) and RV182 (V/OCT, a rheostat in the cutoff summer feedback) become SX-TRIM-002, BOCHEN (Chengdu Guosheng Tech) 3296W-1-503, LCSC C118911: $0.14 at 50+ against €1.58 for the Bourns at Mouser, 44,309 in stock (2026-10-19). From the BOCHEN 3296W approval sheet (LCSC datasheet b5e5c19d): 10 Ω to 2 MΩ, ±10 %, ±250 ppm/K, 0.5 W at 70 °C, 30 ± 2 turns, −55 to +125 °C, body 9.5 × 4.85 × 10 mm with pins 1-2-3 in line at 2.5 mm: the Bourns 3296W outline, so the footprint Potentiometer_Bourns_3296W_Vertical and the underside mounting (item 112) stay. The higher tempco cancels in the two dividers; in the V/OCT rheostat, which is only part of the summer feedback, it moves the scale by well under 0.1 % over a 20 K warm-up; the element's 250 ppm/K is itself about 13 times below the SSI2144's own +0.33 %/K drift that decision 141 accepted (about 6.6 % over the same warm-up). The sheet numbers the pins but does not name the wiper: pin 2 as on the Bourns, checked with a meter on delivery (`CHECKLISTS.md`). Bought at LCSC with the master's hand-soldered LCSC parts (DG413, DRV135), so no extra parcel. Saving about €4.35 per card. Rejected: Bourns at LCSC (C83686, about €0.69, saves €2.7 per card), single-turn trimmers (coarser setting of the V/oct scale).

## VCA comparison (datasheets: THAT 2180 Rev 02, SSI2164 Rev 3.4; ±15 V, 20 kΩ converter resistors)

| | THAT 2180A | THAT 2180B | SSI2164 class AB | SSI2164 class A |
|---|---|---|---|---|
| THD at about 0 dBu, 0 dB gain | 0.005% typ, 0.010% max | 0.010% typ, 0.020% max | 0.05% typ | 0.025% typ |
| Output noise, 20 Hz to 20 kHz | -98 dBV (about -96 dBu) | -98 dBV | -96 dBu | -84 dBu |
| Channels per package | 1 (SIP-8) | 1 (SIP-8) | 4 (SOP-16) | 4 (SOP-16) |
| Control constant | 6.1 mV/dB | 6.1 mV/dB | -33 mV/dB | -33 mV/dB |

The THD+N target of 0.01% (filter bypassed) is only met by the 2180A. Because of the tight budget and the one-chip-per-card rule, the SSI2162 (dual, same family as the SSI2164, 3 dB lower noise) was chosen instead and the target relaxed to 0.05% (item 31). Both parts are current-in/current-out, so each needs a voltage-to-current input resistor and a current-to-voltage output op amp.

## Rationale notes

- Why SSI2144: a 4-pole ladder character without the hard parts of a discrete ladder (transistor matching and temperature compensation). It is a reissue of the SSM2044 (Rossum improved ladder), not a Moog transistor ladder; the user accepted this by dropping "Moog-style". Rejected: discrete OTA ladder (limited headroom, more noise, more tuning) and a state-variable filter (clean but not ladder character).
- Why HPF was dropped: build simplification. Resonance loop count would have doubled to 16 with HPF.
- Why hot drive plus bypass: the SSI2144 clips at ±50 mV and has 92 dB dynamic range. Driving it at its nominal level gains about 8 dB SNR over a clean +20 dBu headroom design (simulated: about 93 versus 85 dB), and its overdrive is musical. The simulation showed about 1.3% THD at +4 dBu when the cutoff is lowered, more colour than first assumed, so a medium-drive jumper lets the prototype settle it by ear. The bypass keeps the clean path within the pro targets, and avoids the 20 kHz roll-off of an open 4-pole filter.
- Why a -6 dB receiver: Eurorack peaks reach ±12 V. Gain ½ passes them on ±15 V rails with margin, at a small noise cost that the hot source levels more than make up for.
- Why AD8273 over the THAT1246: dual (one chip per card, like the SSI2162), active and widely stocked, about $4, noise similar to the 1246. Trade-off: 77 dB minimum CMRR versus the 1246's 90 dB typical, still far above a discrete op amp with 0.1% resistors (about 54 dB).
