plektra/syntsamix/docs/decisions/record/master-card-sheets.md

# Master card decisions: sheet implementations

How each sheet of the master card (`hardware/master`) implements the scope and part choices in `master-card.md`: power sheet, AUX returns and sends, compressor, sidechain, master out, meter, headphones. Split from `master-card.md` on 2026-10-08 (size); numbers unchanged.

Full record (decision 154): the complete text of each decision as made, with figures, sources and rejected options. The current rulings, which sessions read first, are in `../master-card-sheets.md`; the index of all decisions is `../INDEX.md`. Numbers are global and never reused. Text marked **[proposed]** still needs the user's confirmation.

## Decisions

87. Master card power sheet: power ribbon in from the power board, LM317/LM337 to ±15.1 V as on the channel cards, and an L7805 (TO-220) for +5 V because the master's LED load (two 12-segment meters, compressor and PFL LEDs, about 60 to 70 mA) is too much heat for a 78L05. The system star point (the only AGND-PGND connection) is a net tie on this sheet. The frame bonds to it through a ground-lift switch; lifted, through 100 Ω ∥ 100 nF (100 V). Regulator heat is rechecked once the master's load is known; TO-220 heatsinks may be needed
88. AUX return implementation (refines item 51): the AD8273 stays at its fixed G = ½, wired inverting as on the channel cards; the -6 / +6 dB choice is a jumper in the inverting gain stage after it (fitted: gain 1, -6 dB overall, the default for pro and Eurorack effects; open: gain 4, +6 dB for pedals), because switching the AD8273 itself between G = ½ and G = 2 would need four pins per side. The level knob is a 10 kΩ linear pot driving the same three-segment law as the channel fader (+10 dB at full, 0 dB at 75 %, off at the bottom; buffer and summer on an OPA2171 since item 103, duck input into the summer's virtual earth since item 97). Mute and duck through a DG413, a unity inverter so the signal reaches the bus non-inverted, and 22 kΩ bus resistors switched to MAIN or COMP. One script draws both identical return sheets
89. Compressor implementation (refines items 44 and 57). Confirmed by the user: (A) log-domain peak detector: precision full-wave rectifier into a log converter on the AS3046D matched pair (Q1 signal, Q2 diode-connected reference current), peak hold in the log domain; (A) MIX is a dual linear pot crossfading dry (compressor bus) and wet (VCA) of equal polarity, and ON/OFF acts on the control voltage, so off gives the dry signal at any MIX setting with no audio switch; (A) makeup tracks Amount at full compensation (0.735 x the threshold drop at 4:1) with a DNP resistor (R439) for half. Implementation, simulated in `simulation/compressor/` (transistor-level side chain, not yet breadboarded): gain -11 after the log converter with the ERA-V33 as input resistor (drift 0.02 dB from 15 to 45 °C), 32.6 mV/dB to match the SSI2162; attack 470 Ω / 1 µF (0.9 ms to 63 %); release from a Q3/Q4 current mirror on the hold capacitor, so recovery runs at a steady dB/s: RELEASE (10 kΩ reverse-log) gives 44 ms to 1.4 s per 10 dB; threshold at AMOUNT 0 is +14.6 dBu sine peak (the channel soft-clip onset), AMOUNT lowers it 30 dB; the ON button ramps the Amount voltage through one DG413 (NO charge, NC discharge, about 20 ms) and, when off, slowly lifts the threshold about 11 dB (reset at once on turn-on), keeping on/off transitions to smooth ramps with at most 1.5 dB excursion. Five gain-reduction LEDs at 1/3/6/10/15 dB on two LM339s. **Confirmed 2026-10-09** (`/board master`; the user delegated the open points to Claude's recommendation): Q5 of the AS3046D is unused: Alfa's datasheet (2019 v.2) ties its emitter to the substrate (pin 13, to the most negative point), and B5 sits on −15 V with C5 open, so it cannot conduct. At full AMOUNT and signal below threshold the makeup reaches +22 dB, 2 dB past the SSI2162's specified +20 dB (Rev 1.2 specifies nothing beyond it; the control voltage of about −0.73 V is well inside its V− to V+ absolute maximum): kept, and heard on the breadboard; if it misbehaves, fit R439 = 330 kΩ (the T-network then gives 0.667, makeup capped at +20 dB)
90. Sidechain and ducking sheet (refines items 45 and 66). Confirmed by the user: (D) a plug in the SC EXT jack overrides the source selection (detected by the jack's ring switch contact), otherwise a latching SC BUS button with LED picks BUS (pressed) or INT; switching through one DG413 in two stages, no audio through mechanical contacts; (A) the sidechain LPF is a unity-gain Sallen-Key (22 nF / 47 nF, Q about 0.73) tuned by 10 kΩ plus a 100 kΩ dual reverse-log pot, simulated 46 to 510 Hz, with a bypass button; (A) the ducker is trigger-style: when the filtered sidechain crosses ±THRESHOLD (window comparator, 0.1 to 5 V peak on a log pot), SC_ENV jumps to the DEPTH level (0 to 4 V = 0 to 40 dB) in about 3 ms and falls with DECAY (time constant 48 ms to 1.15 s), retriggered by every hit. Implementation: INT = -(COMP_L_SUM + COMP_R_SUM)/2, BUS = -SC_SUM, EXT DC-coupled through a 100 kΩ inverting buffer (no common-mode limit for ±12 V); a follower drives SC_DET (compressor detector, ducker, SC listen); SC LISTEN sums SC_DET into both cue buses through 22 kΩ and pulls PFL_ACT low with an MMBT3904; SC_ENV leaves through a follower and 100 Ω (items 97 and 104: DEPTH negative, the follower fed back after the 100 Ω, SC_ENV 0 to −4 V, BAT54 clamp to AGND). Simulated in `simulation/sidechain/`. **Confirmed 2026-10-09** (`/board master`; the user delegated the open points to Claude's recommendation): a patched but silent EXT cable still selects EXT (switched-jack convention: unplug to return to the button's choice); no separate EXT LED (the SC BUS LED shows BUS/INT)
91. AUX sends implementation (refines items 24 and 51): one sheet for both sends. Each send's dual 10 kΩ log master pot sits on the inverted bus sums; 47 kΩ / 47 kΩ inverting NE5532 stages restore polarity (low pot loading and noise); outputs are impedance-balanced (tip through 100 Ω, ring through 100 Ω to AGND). L/MONO uses the R jack's ring switch contact as a plug detector (pulled up to +5 V, held low through the ring resistor when R is unplugged); with R unplugged, two DG411 sections (normally closed) add R into the L stage and halve its feedback, so L carries (L+R)/2. One DG411 serves both sends. **Confirmed 2026-10-09** (`/board master`; the user delegated the open points to Claude's recommendation): no output coupling capacitors (the DC-coupled chain keeps offsets in the millivolt range, harmless to line inputs)
92. Master out implementation (refines items 46, 64, 83 and 85). Confirmed by the user: (A) the master level uses the channel fader law on a 10 kΩ linear pot (+10 dB at full, 0 dB at 75 %, off at the bottom), through an SSI2162 whose one control voltage sets both sides (buffer and summer on an OPA2171 since item 103). Implementation: the I-V stages carry the soft clip (back-to-back 6V2 zeners with 4.7 kΩ across the 10 kΩ feedback, onset about +14 dBu as on the channels) and give MAIN_L/R_OUT for the meter and headphones; THAT1646 drivers with 10 µF common-mode offset capacitors and M7 (1N4007) clamps to the rails per the THAT application circuit; G6K-2F-Y relays switch hot and cold, and when released ground each output conductor through 1 kΩ; coils run from +15 V through 330 Ω (about 11.8 V). An LM339 drops the relays at once when the raw +20 V falls below about 17.9 V (before the ±15 V regulators fall out) and closes them about 2 s after power-up (1 MΩ / 2.2 µF timer); one MMBT3904 sinks all three coils (RLY_N also reaches the headphone relay). The Power sheet now exports +20V_RAW for this. Proposal "only the positive raw rail is monitored" replaced by item 128: both raw rails are watched (2026-10-09)
93. Master meter implementation (spec section 4, refines items 76 and 86): per side an inverter and two TL072 superdiodes charge a 1 µF hold through 1 kΩ (about 1 ms attack), 680 kΩ gives a fall of 20 dB in about 1.5 s, and a follower drives 12 LM339 comparators. One 1% ladder from +15 V (115k down to 866 Ω, E96) serves both sides; thresholds re +4 dBu peak at -30 -20 -15 -10 -6 -3 0 +3 +6 +9 +12 and clip (+13 dB, about +17 dBu), all within 0.04 dB. 24 LEDs at about 2 mA from +5 V (about 48 mA). **Confirmed 2026-10-09** (`/board master`; the user delegated the open points to Claude's recommendation): LED colours green −30 to 0, yellow +3 to +9, red +12 and clip (the LED form, 3 mm or 0805 under a bezel as item 119, is settled with the master section panel in `/system mechanical`)
94. Headphones implementation (refines items 56 and 84): a DG413 on PFL_ACT selects MAIN_L/R_OUT normally and the cue bus sums while PFL_ACT is low (any PFL or SC listen); a dual 10 kΩ log pot sets the level; the TPA6120A2 (TI SLOS431B) runs as non-inverting gain-2 stages with TI's values (51 Ω series input, 1 kΩ / 1 kΩ feedback, 39.2 Ω output resistors in 2512 for full level into 32 Ω), thermal pad to AGND copper with vias; the third G6K relay (coil on RLY_N from Master out) connects the jack and grounds it through 1 kΩ when released. The PFL-active LED (3 mm) sinks into PFL_ACT from +5 V through 1.5 kΩ. The root sheet marks the unused bus-node pins AUX1_L/R, AUX2_L/R and SC as no-connect (`scripts/reference/root_nc.json`); the master card ERC is 0 errors, 0 warnings. **Confirmed 2026-10-09** (`/board master`; the user delegated the open points to Claude's recommendation): gain 2 (+6 dB) for 600 Ω headphones; the cue bus arrives inverted relative to main (inaudible on headphones); PFL LED yellow, as the channel PFL LED (item 117)
95. Master card power recheck (refines item 87; `hardware/master/scripts/power_budget.py`): typical load +15 V 345 mA, -15 V 275 mA, +5 V 29 mA; worst case (every IC at its datasheet maximum, headphones at full output into 32 Ω, whole meter lit) 730 / 606 / 68 mA. From the ±20 V raw rails the LM317 dissipates 1.7 W typical and 3.6 W worst case, the LM337 1.35 / 3.0 W, the L7805 0.3 / 0.7 W (fine in free air). Confirmed by the user: (A) the LM317 and LM337 each get a board-mount TO-220 heatsink of 10 °C/W or better (junction at most about 100 °C at 40 °C ambient in the worst case). The heatsinks are live (LM317 tab = +15 V, LM337 tab = raw -20 V): separate, not touching each other or the frame, or on insulating pads. The power board must supply about 2.4 to 2.8 A per rail for 16 channel cards and the master card (superseded by item 96: sizing figure 3.6 / 3.0 A at full size)
103. Master fader-law input range (from /system 2026-10-08; refines items 88 and 92, as item 102 on the channel card): the AUX return level pots (RV201, RV301) and the master level pot (RV701) run from −15 V to ground, below a TL072's input range at the bottom of travel. U206, U306 and U705 become OPA2171s (TI SBOS516H: input range to V−, no phase reversal) holding the pot buffer (A) and the control summer (B, + input on AGND); both superdiodes move to the TL072s U207, U307 and U706 (A: breakpoint 2, B: breakpoint 1), because the OPA2171's back-to-back input diodes must not sit in an open-loop stage. Same part count; about +$0.60 per master card; typical load 340 / 269 mA (was 345 / 275), sizing 589 / 476 mA. The law is the channel's (`simulation/level/`): bottom of travel about −102 dB instead of −113 dB. Rejected: a resistor at the bottom of each pot with a TL072 (law then depends on the track tolerance) and relying on the TL072 not reversing phase
104. SC_ENV drive on the Sidechain sheet (refines items 90 and 97): instead of a unity inverter after the hold capacitor, the DEPTH pot's top resistor R518 (27 kΩ) goes to −15 V, so U505A gives 0 to −4 V and the hold capacitor C504 charges negative through the DG413 switches; U505B stays a follower with its feedback taken after R521 (100 Ω), so SC_ENV runs 0 to −4 V at low impedance as item 97 requires. A BAT54T1G (onsemi SOD-123, SX-D-014) from SC_ENV (anode) to AGND (cathode) clamps positive excursions; its leakage at 4 V is about 0.06 µA at 25 °C, about 5 µA at 85 °C (onsemi BAT54T1/D Rev. 12, Figure 3), negligible on a driven line. No added parts besides the diode. Simulated (`simulation/sidechain/`, 18 loads of 30k1 = 1.7 kΩ): peak −3.91 V (DECAY CCW) to −4.00 V (CW), 90 % after about 3 ms, 20 dB recovered after 33 ms to 0.82 s; SC_ENV never rises above 0 V. Rejected: an inverter after the hold capacitor (its input resistor discharges C504 into the virtual earth: with 100 kΩ the longest decay falls from 1.15 s to about 0.2 s, with 1 MΩ to about 0.75 s), 10 MΩ inverter resistors (leakage-sensitive) and a rescaled C504/RV504 (changes the pot and the simulated decay range)
126. Master op amp power levers (`/board master` 2026-10-09; confirms Power-cut candidate 2 of `docs/ROADMAP.md` for the master; the user delegated the choice): U409 (gain computer and VC summer), U410 (gain-reduction inverter into five LM339 inputs, Amount follower), U802 and U804 (meter inverters 10k/10k at ±7.75 V at clip, 1 V/µs at 20 kHz, and hold followers into twelve LM339 inputs) go from TL072 to TL062CDR (SX-IC-024, as item 123; TI SLOS078N: VICR ±11 V min, ±10 V min into 10 k, 0.2 / 0.25 mA per amplifier, 3.5 V/µs). The superdiodes U207, U307, U706 stay TL072 (open loop when off, as channel U205 in item 123), and U407 stays TL072: it sits in the log detector at a noise gain of 12, where the TL062's larger offset (15 mV maximum against 10 mV) would move the threshold by several dB worst case. Master load 340 / 269 mA → 331 / 260 mA typical (with item 125), worst case 701 / 576 mA, sizing 576 / 463 mA (`scripts/power_budget.py`)
127. Master electrolytics to SMD (`/board master` 2026-10-09; as item 111 on the channel card; clears the 9 mm top-side limit of item 107): the 16 bipolar 10 µF radials (C205, C206, C209, C210, C305, C306, C309, C310, C401, C402, C701, C702, C707-C710) become Panasonic EEE-1VA100NP (SX-C-023, 6.3 × 5.4 mm, hand-soldered, not at LCSC); regulator input C901, C906 become ROQANG RVT1V470M0605 (SX-C-025); regulator ADJ/output C903, C904, C908, C909, C912 and the TPA6120A2 bulk C755, C756 become ROQANG RVT1V100M0505 10 µF 35 V (SX-C-024). All 5.4 mm tall. The relays K701, K702, K751 are 5.2 mm (Omron K106-E1-11) and stay. Still too tall: U901-U903 TO-220 (about 19.7 mm seated, TI KCS0003B, ST L78 Rev 33) with the HS901/HS902 heatsinks: placement with the master section in `/system mechanical`
128. Relay drop-out watches both raw rails (`/board master` 2026-10-09; replaces the proposal in item 92; the user delegated the choice): the power board's buck and inverter are separate converters with separate output fusing (item 100), so the −20 V side can fail alone. The spare LM339 section U707C compares NEG_DIV (22k6 from +15 V, 100k to −20V_RAW: 0.816 × 15 V + 0.184 × V−) against the existing REF (8.93 V); NEG_DIV rises above REF when the raw −20 V is weaker than about −17.9 V (mirror of the +17.9 V trip of comparator A), and its open-collector output joins UV_O, so either rail drops the relays at once. NEG_DIV stays between about +8.5 V (healthy) and +12.2 V (rail gone), inside the LM339's input range; the Power sheet exports −20V_RAW like +20V_RAW. U707D stays spare
131. RELEASE pot within Alpha's non-B rating (`/board master` 2026-10-09; refines item 89; confirmed by the user): Taiwan Alpha's RD901F specification rates the track at 0.05 W for B taper but only 0.02 W for other tapers. RV402 (C10K) from AGND through R425 (620 Ω) to −15.1 V carried 1.42 mA, about 20 mW, over the rating with the track 20 % low. RV402 becomes a C100K (Alpha RD901F-40-15K-C100K, Tayda A-5370, SX-POT-014) and R425 6.2 kΩ (SX-R-091): only the ratio of R425 to the track sets REL_B and the wiper voltages, and the wiper's source impedance (25 kΩ at most) against R424's 2.2 MΩ adds about 1 %, so the release law is unchanged; dissipation about 2.1 mW. Simulated (`simulation/compressor/`): 44 / 353 / 1427 ms per 10 dB (CCW / middle / CW, was 44 / 351 / 1422 ms); track ±20 % moves the CW end to 1.0 to 2.0 s, as with the 10k pot. Rejected: raising R425 alone (to 1.5 kΩ: REL_B moves from −14.1 V to −13.0 V, much further from the mirror input at about −14.4 V, so the slowest release current rises about five times and the CW end falls to about 0.3 s); a C10K with a resistor at the AGND end and R425/R424 retuned (about 16 mW, still near the limit at −20 % track, one more part)
138. SC LPF pot RV501 is a standard Alpha dual B100K (`/board master` 2026-10-10; refines item 90; confirmed by the user): the reverse-log (C) dual 100k of item 90 has no standard 9 mm T18 source (Thonk and Tayda list no dual C100K; a special-order RD902F C100K would need its own RoHS check and minimum order). RV501 becomes Alpha RD902F-40-15K-B100K-0057 (Thonk, SX-POT-015; order code by analogy with Thonk's A10K/A100K codes, confirm with the order), RoHS cleared by Alpha's general declaration (item 124), 0.05 W B rating, audio only. No change to the circuit: the rheostat (wiper to CW end, 10 kΩ in series, 22 nF / 47 nF Sallen-Key) still sweeps CW = higher cutoff. The linear law spends more of the knob on the bass, which suits pumping on the kick (`simulation/sidechain/`): -3 dB at 46 / 60 / 85 / 146 / 510 Hz at CCW / 25 % / middle / 75 % / CW (the C taper put the middle at about 255 Hz); track ±20 % moves the CCW end to 39-57 Hz; no peaking. Rejected: a special-order C100K dual (sourcing and RoHS), an A100K dual wired reversed (CW lowers the cutoff, against every other knob), a linear pot with a law-bending resistor (a redraw for a law B100K already makes usable). Also checked the other non-B master pots against Alpha's 0.02 W rating: THRESHOLD RV502 (10k between 20k to +15 V and 200 Ω to AGND) about 2.5 mW; DECAY RV504 at most about 0.2 mW; AUX SEND and PHONES duals and RV501 carry audio only, about 6 mW per gang at the +20 dBu internal maximum: none needs a change
144. Master fader laws on the channel's E24 values (`/board master` 2026-10-10; refines items 88, 92 and 103 as item 140 did on the channel; confirmed by the user): the AUX return level laws (both returns) and the master level law take the channel's fee-free E24 values: Ra 113k = 100k + 13k (R222 + R242, R322 + R342, R714 + R734), Rc 453k → 450k = 300k + 150k (R223 + R243, R323 + R343, R715 + R735), breakpoint 1 221k → 220k and 63k4 → 62k (R225/R226, R325/R326, R717/R718), breakpoint 2 124k = 100k + 24k (R228 + R244, R328 + R344, R720 + R736) and 8k66 → 9k1 (R229, R329, R721), mute 33k2 → 33k (R231, R331). R232/R332 30k1 kept (SC_ENV scaling, a chain line). Simulated (the circuit of `simulation/level/run.py`): within 0.5 dB of the E96 law from +10 dB to −60 dB, bottom about −100 dB, ducking −10.07 dB at SC_ENV −1 V. Six extended types leave the master (113k, 221k, 63k4, 124k, 8k66, 33k2: about €17 in JLCPCB fees per order); 453k stays for the compressor's R443; nine resistors added, every value already fee-free on the channel card. Rejected: single nearest E24 values (110k, 470k, 220k, 62k, 120k, 9k1): 124k → 120k moves breakpoint 2, so the fade-out starts late, +6 to +8 dB off below 18 % of travel and −94 dB at the bottom; the best of 64 single-value sets is still 3.9 dB off. Considered: only 124k as a pair (within 1.5 dB, but its 110k is extended) or 124k and 113k as pairs (within 0.62 dB, three resistors fewer); the channel's values were kept so both boards share one tested set (30k1 → 30k on R232/R332 by system decision 153)
146. Master meter ladder and the −20 V watch on fee-free E24 values (`/board master` 2026-10-10; refines items 93 and 128; confirmed by the user): the 12-threshold ladder R811-R823 (115k ... 866, E96, 63 µA) becomes 16k, 1k8, 4k7, 3k, 2k4, 1k5, 1k2, 750, 750, 510, 300, 270, 120 (UNI-ROYAL 0805, every value JLCPCB basic or preferred), about 0.45 mA from +15 V. Thresholds re +4 dBu peak (−30 … +12 dB and clip at +13 dB) within 0.14 dB of ideal (E96: 0.04 dB); with the LM339's maximum input bias (250 nA, two inputs per tap) within 0.19 dB, where the 63 µA E96 ladder drifted up to 0.62 dB at −30 dB, so the higher current also makes the meter more robust. Searched over the 77 fee-free 0805 values at ladder currents from 60 to 520 µA; the best unrestricted E24 set (60 µA, 0.13 dB) needs 910 Ω, which has no fee-free part. R732 22k6 becomes R732 22k + R737 560R (both fee-free): the raw −20 V watch trips at −17.98 V instead of −17.93 V (22k alone: −18.66 V, too close to the 19 V minimum). Thirteen extended types leave the master (twelve ladder values and 22k6, about €36 per order); new part numbers SX-R-108 to SX-R-112; master +15 V typical load 331 → 332 mA, worst case and sizing unchanged
147. Compressor and sidechain values on fee-free parts (`/board master` 2026-10-10; refines items 89, 90 and 138; the user delegated minor changes; confirmed by the user 2026-10-17: "147 is just fine"): R420 560k (log reference current) becomes R420 510k + R456 51k (561k, threshold unchanged; 510k alone would move it about 0.8 dB); R426 140k (top of the AMOUNT pot) becomes R426 120k + R457 20k (exact; 150k alone would shrink the 30 dB range by about 2 dB); the gain-reduction LED ladder R443 453k → 470k and R445 4k02 → 4k3 (LEDs at 0.97 / 2.9 / 5.8 / 9.9 / 14.9 dB of gain reduction instead of 1 / 3 / 6 / 10 / 15); the sidechain LPF ground capacitor C503 22n C0G becomes two 47n C0G in series (C503 + C521, 23.5 nF; the 47n C0G type is already used by C502 and the power board): Q 0.731 → 0.707 (Butterworth), sweep −3 dB at 44 / 56 / 80 / 137 / 478 Hz at CCW / 25 % / middle / 75 % / CW (was 46 / 60 / 85 / 146 / 510), peaking +0.02 dB → none (`simulation/sidechain/`, rerun 2026-10-10). The master's TL072 symbols carry the fee-free ST TL072CDT (LCSC C6961) chosen in `parts.csv`. Five extended types leave the master (560k, 140k, 453k, 4k02, 22n C0G); new part numbers SX-R-113 to SX-R-115. Checked and dropped: OPA2171 → LM358 (no datasheet figure for the output within 0.5 V of V− while sinking, ±15.1 V only 0.9 V from its ±16 V rating; onsemi LM358/D Rev. 27) and ceramic capacitors on the LM337 output (onsemi LM337/D Rev. 11 p. 7: low-ESR and ceramic types can cause instability or continuous oscillation)
148. AUX return receivers: TL072 difference amplifier instead of the AD8273 (`/board master` 2026-10-10; cost lever 1, confirmed by the user; refines items 51 and 88; the circuit of the channel's item 143): U201/U301 become TL072CDT (SX-IC-007, JLCPCB basic), one unit per side at G = ½. The RFI series resistors R201-R204 / R301-R304 go from 100 Ω to 10k 0.1 % and form the first half of each 20k input leg (220p C0G caps kept); per side Ri, Rf, Rni and Rg are 10k 0.1 % (R245-R252, R345-R352; YAGEO RT0805BRD0710KL, SX-R-107, the channel's part, so no new type). IN+ drives the inverting leg as the AD8273 pins were wired, so the receiver still inverts and the gain stage with the PRO/PEDAL jumper is unchanged. CMRR from the 0.1 % match at least 51.5 dB worst case (about 60 dB typical), against the AD8273's 77 dB: enough for ground-loop hum from an effects unit. Input impedance 20k (hot) and 30k (cold). The AD8273 (SX-IC-003, consigned from Mouser) leaves the project entirely; about €7 per master (two AD8273 against a TL072 pair and 24 resistors). Master typical load 332 / 260 → 327 / 256 mA, sizing 576 / 463 → 570 / 456 mA, worst case unchanged (`power_budget.py`)
149. Compressor detector without temperature compensation on the prototype (`/board master` 2026-10-10; confirmed by the user; refines item 89, as item 141 on the channel): R421, the gain stage's input resistor in the log detector, becomes a plain 1k 0805 (SX-R-035, JLCPCB basic) instead of the end-of-life ERA-V33J102V (+3300 ppm/K, consigned). Simulated (`simulation/compressor/`, 15 / 25 / 45 °C): the threshold moves 2.2 dB at AMOUNT 0 (+17.0 → +14.8 dBu), 1.0 dB at full AMOUNT, gain reduction at +20 dBu 14.5 → 16.4 dB, ratio about 3.5:1 cold to 4.6:1 hot; with the tempco part all of these stayed within 0.06 dB. Heard as pumping that deepens by about 1.5-2 dB as the case warms up. Temperature compensation goes to the backlog (`docs/ROADMAP.md`); R421 stays next to U402 so a tempco part (Vishay TFPT pair as item 130) can return on the same pads
163. Rear row-board ribbons (`/board master schematic` 2026-10-12; refines items 87, 88, 90, 91, 92 and the rear-jack part of 162; ribbon size and the pair-and-ground scheme confirmed by the user; pin numbers drawn to that scheme): decision 162 moves the eleven rear jacks and the ground-lift switch off the master card onto two passive row boards, each cabled by one ribbon. Both ribbons are 26-pin 2.54 mm shrouded keyed box headers (Würth WR-BHD 61202621621, SX-CONN-017, straight THT, the family of the chain headers; Mouser 710-61202621621, 1210 in stock, about €0.94 at 10+, RoHS compliant per Mouser, checked 2026-10-12) with IDC sockets with strain relief on the cable (61202623021, SX-CONN-018, RoHS compliant per Mouser). Pin n is ribbon conductor n. Signals run in pairs (hot/cold or tip/ring of one jack) with an AGND conductor between pairs, so neighbouring jacks never share an edge without a ground; the jack sleeves return on the ground conductors (12 on the output ribbon, 14 on the input ribbon, all AGND; input pin 25 is AGND on the card side only: invariant 2 holds, the sleeves still go to the master's AGND). Output ribbon J603, on the AUX sends sheet (10 of its 14 signals are there; MAIN_L/R_HOT/COLD come from the relay contacts on the Master out sheet through new root sheet pins): 1 G, 2 MAIN_L_HOT, 3 MAIN_L_COLD, 4 G, 5 MAIN_R_HOT, 6 MAIN_R_COLD, 7 G, 8 L1_T, 9 L1_RING, 10 G, 11 R1_T, 12 R1_RING, 13 G, 14 L2_T, 15 L2_RING, 16 G, 17 R2_T, 18 R2_RING, 19 G, 20 DET1, 21 G, 22 DET2, 23-26 G. The send's ring conductor carries the ring through its 100 Ω to AGND on the card; DETn is the R jack's ring switch contact (RN), pulled up on the card. Input ribbon J903, on the Power sheet (next to the star point NT901 and the frame bond J902; the returns and SC EXT reach their sheets through new root sheet pins): 1 G, 2 RET1_L+, 3 RET1_L−, 4 G, 5 RET1_R+, 6 RET1_R−, 7 G, 8 RET2_L+, 9 RET2_L−, 10 G, 11 RET2_R+, 12 RET2_R−, 13 G, 14 EXT_T, 15 G, 16 EXT_SEL, 17-24 G, 25 lift return, 26 CHASSIS. RETn_L+/L− carry the L/MONO jack's tip and ring, which the R jack's tip and ring switch contacts (TN, RN) normal into on the input row board, so the normalling of item 24 works unchanged. EXT_SEL is J501's ring switch contact (RN), pulled up on the card (plug detect of item 90); J501's ring, sleeve and tip switch go to the row board's ground. The ground-lift switch SW901 sits on the input row board between conductors 25 and 26, insulated from the row board's ground: CHASSIS (26) runs from the frame bond J902 and the 100 Ω ∥ 100 nF lift network (R905, C913, still on the Power sheet) to the switch, and 25 returns to AGND on the card, to be routed straight to the star point NT901 (invariant 2: the frame bonds at the star point only). The row boards carry only the jacks, the header and SW901, all through-hole and hand-soldered (no JLCPCB assembly); every resistor, capacitor, relay and pull-up stays on the master card. On the master schematic the jacks J201, J202, J301, J302, J501, J601, J602, J621, J622, J701, J702 and SW901 are gone (they move to the row board projects, still to be drawn); netlist checks 0 problems on every sheet, ERC 0/0, and the full netlist traced pin by pin across the sheets. The NYS216 height (at most about 17 mm above the row board) is still to be measured on a sample; if it is taller, decision 162's fallback (on-edge 2-jack boards) needs a cabling plan of its own, and this pinout is revisited. Rejected: a 20-pin input header with the 26-pin output header (two header and cable types to save a few cents); 20-pin on both with grounds only between channels (less isolation between neighbouring jacks for no real saving); passive parts on the row boards (the return RFI filters or the send ring resistors: would need assembly or SMD hand soldering on two more boards, and the cable sits inside the card's RFI filtering either way); a separate rear-connector sheet (no free power-reference prefix, decision 87's prefix scheme)

172. Master bipolar capacitors as back-to-back pairs (`/board master` 2026-10-17; refines item 127, follows the channel's item 161; made under the user's delegation "go ahead autonomously with your recommendations until there's major issues"): each of the sixteen Panasonic EEE-1VA100NP 10 µF bipolar positions (SX-C-023, not stocked at LCSC, so consigned or hand-soldered) becomes two ROQANG RVT1V100M0505 10 µF 35 V (SX-C-024, LCSC C72486, `CP_Elec_5x5.4`, already on the master's power sheet: no new fee type) in series, negative to negative, no bias resistor. The first capacitor keeps the old reference with + toward the source, the partner has + toward the load: AUX return coupling C205+C234, C206+C235, C305+C334, C306+C335; AUX return VCA inputs C209+C236, C210+C237, C309+C336, C310+C337; compressor VCA inputs C401+C432, C402+C433; master out VCA inputs C701+C726, C702+C727; DRV135 sense capacitors C707+C728, C708+C729, C709+C730, C710+C731 (C707-C710 + at the driver output, the partner + at the sense pin). Effective 5 µF: the coupling positions feed 10 kΩ into a virtual earth, −3 dB at about 3.2 Hz (two in series on each AUX return path, about 0.2 dB down at 20 Hz). Sense capacitors: TI SBOS094B (DRV134/DRV135, rev. December 2014) calls the 10 µF sense-pin capacitors optional, used to minimise output common-mode offset errors with "virtually no effect on performance" (p. 9), recommended "for applications with large dc cable offset errors" as 10 µF non-polarised (p. 15); with the internal sense network of about 30 kΩ, 5 µF moves the corner to about 1 Hz, and both ends sit near 0 V DC, so no 22 µF type is needed. Drawn with the sense pairs on rows jogged 6.35 mm outward from the sense pins so the fields stay apart; R205/R206 (R305/R306) and R211/R212 (R311/R312) moved right to make room. Netlist checks 0 problems (AUX returns 73 → 75 nets, compressor 83 → 85, master out 63 → 69: the new mid-nets), ERC 0/0. Cost (`tools/costs.py estimate`): nothing is consigned on either board any more, so the €30 handling goes (the estimate had kept counting it for the hand-soldered SSI2162 and AS3046D, fixed in `costs.py` the same day): €838 → €799 / €1,125 → €1,085 / €1,723 → €1,684 for 4 / 8 / 16 channels, together with the TO-220 regulators moving to onsemi LM317TG / LM337TG (part rows only, TI LM317KCSE3 NRND). Rejected: Nichicon UWP1V100MCL1GB bipolar (extended, one new fee type, as on the channel), two 22 µF at the sense pins (no fee-free 22 µF electrolytic at LCSC, and not needed).

173. Master NE5532 → TL072 where noise and drive allow (`/board master` 2026-10-17; the user: "NE5532 -> TL072 makes sense, implement it"; refines items 88, 89 and the bus sheet of 87): ten of the eighteen NE5532 packages become TL072CDT (SX-IC-007, ST, LCSC C6961, JLCPCB basic; same SO-8 dual pinout): AUX returns U202, U204, U205 and U302, U304, U305 (gain stage after the receiver, I-V after the SSI2162, unity inverter to the bus resistors: noise gain at most 5 and loads of 10 kΩ or more, behind an effect unit whose own noise dominates); compressor U403 (wet I-V), U404 (dry inverters), U405 (MIX followers into 22 kΩ: noise gain 1 to 2); bus U106 (SC bus, heard only through SC LISTEN, and the spare half). Kept NE5532: bus U101-U105 (MAIN, COMP, AUX1, AUX2, CUE summing amplifiers: noise gain grows with the channel count, about 17 at 16 cards, where the NE5532's 5 nV/√Hz against the TL072's 18 matters), AUX send drivers U601/U621 (cable drivers) and master out I-V U702 (last stage of the main path; decision 135 protects the stage-quiet floor). Supply (`power_budget.py`): master typical 327 / 256 → 295 / 224 mA, worst case 701 / 576 → 591 / 466 mA, LM317 worst 3.44 → 2.90 W. TL072 signal levels stay inside its common-mode range (internal clip about +17 dBu, under ±8 V peak, against at least ±11 V). Netlist checks 0 problems, ERC 0/0. The channel card's NE5532s are not changed here (another board session).

174. Master regulator heatsinks: Wakefield 637-10ABPE (`/board master` 2026-10-17; the user: "Wakefield heatsink is fine, let's adjust the enclosure to fit it"; refines item 95 and the regulator row of 162): HS901 (U901 LM317TG) and HS902 (U902 LM337TG) are Wakefield Thermal 637-10ABPE (SX-MECH-002, Mouser 567-637-10ABPE, $1.99, RoHS compliant): vertical board mount, 34.9 × 12.7 × 25.4 mm, two solder pins on 25.4 mm centres, 12.67 °C/W in natural convection. Junction limit: the parts' 125 °C rating (onsemi LM317/D Rev. 18, LM337/D Rev. 11: TJ 0 to 125 °C for the T versions) replaces decision 95's 100 °C design limit; with 5 °C/W junction-to-case and about 1 °C/W for the pad, at decision 167's 57 °C inside air after decision 173: LM317 about 111 °C at the worst case (2.90 W), about 105 °C at the sizing load (522 mA, 2.56 W), about 84 °C typical (1.45 W); LM337 about 100 °C worst case. U903 (L7805) stays without a heatsink (0.73 W worst, about 104 °C free-air at 57 °C; 0.32 W typical). Both heatsinks are live (LM317 tab +15 V, LM337 tab raw −20 V): 3 mm from each other, the frame and the cover. The heatsinks reach 25.4 mm below the PCB, past the 25 mm of the regulator row in `docs/MECHANICAL.md`: the enclosure change (about 28.5 mm floor depth at the regulator zone, or the zone moved toward the rear where the sloped floor is deeper) goes to `/system`. The prototype heat measurement (decision 167) checks the figures. Considered and declined by the user the same day ("let's keep the heatsink and 20V rails"): ±18 V raw rails (would undo decision 40's dropout margin and move decision 128's relay trip) and the LM317/LM337 bolted to a 2020 rail through insulating pads.
177. AUX return MUTE and DUCK switched by the buttons, no DG413 (`/board master` 2026-10-17; master cost lever 1 in `CHECKLISTS.md`; made under the user's delegation: "proceed autonomously until major changes need my input", then confirmed by the user: "177 ok"; refines item 88 and the count in 150; applies channel decision 142 under system rule 152). Of the master's ten DG413s only U208 and U308 switched pure DC control voltages from a button: in each AUX return, section 1 put SC_ENV and section 2 put −15 V onto DUCK_V / MUTE_V, which enter the VCA control summer (OPA2171 U206B / U306B, 10 k ∥ 1 µF feedback, 10 ms) through R232 30k / R231 33k, exactly as on the channel before decision 142. The other eight switch audio (U209/U309 bus assign, U506 sidechain source, U507 SC LPF bypass, U751 headphone source, U641 send mono) or are driven by logic or comparators (U413 compressor ON ramp, four sections; U508 ducker charge switches), so they stay. Now the free logic pole of each latching GPBS850L switches the control voltage itself: MUTE pin 3 = −15 V, DUCK pin 3 = SC_ENV, common pin 2 = MUTE_V / DUCK_V; pin 1 (released) stays open, and the former logic pull-downs R237 / R239 (R337 / R339) 100k now tie MUTE_V / DUCK_V to AGND instead of PGND (they carry control current, not logic), so no contact sequence can short −15 V or the shared SC_ENV line to ground (rule 152 a). The 10 ms summer smoothing gives the same ramps as after the DG413 and filters contact bounce (rule 152 b); mute still adds +4.5 V to VC and DUCK still gives 10 dB per −1 V. Engaged, the hold resistor draws 0.15 mA from −15 V, and with DUCK on it loads SC_ENV with 100k besides the 30k; SC_ENV is driven at low impedance (U505B follower fed back after R521, decision 104), so the scale does not move. The COMP bus-assign button stays a logic line to U209/U309 (audio). Removed: U208, U308 (DG413, hand-soldered under decision 150) and the decoupling pairs C232/C233, C332/C333; no part added. Netlist checks 0 problems on every sheet (AUX returns 75 → 73 nets: MUTE_CTRL and DUCK_CTRL gone), ERC 0/0. Estimate (`tools/costs.py estimate`) €801 / €1,087 / €1,686 → €798 / €1,084 / €1,683 for 4 / 8 / 16 channels, and about 32 fewer hand-soldered joints. Not done: moving other DG413 sections to relay contacts (the relays switch the outputs only; no spare contacts on a signal that a DG413 switches).
