plektra/syntsamix/docs/decisions/record/master-card.md

# Master card decisions

The master/compressor card (`hardware/master`): AUX returns and sends, compressor and sidechain, master out, master meter, headphones, output protection and the card's power sheet. This file holds the scope and part choices; the sheet-by-sheet implementations (87-95, 103, 104) are in `master-card-sheets.md`.

Full record (decision 154): the complete text of each decision as made, with figures, sources and rejected options. The current rulings, which sessions read first, are in `../master-card.md`; the index of all decisions is `../INDEX.md`. Numbers are global and never reused. Text marked **[proposed]** still needs the user's confirmation.

## Decisions

5. Compressor with selectable/routable sidechain input
6. Sidechain filter is an **LPF** (not an HPF); the main intent is bass pumping
15. Prototype master section has a headphone output fed from the master bus (cue/PFL was first moved to the backlog; see item 28)
24. Mono AUX: L/MONO jacks on the master card. Send outputs give (L+R)/2 on L when R is unplugged; returns normal L to R. Returns have level and a main/compressor bus switch
29. Stereo LED level meter on the master card, always showing the master bus (changed by item 43: it no longer switches to cue)
44. Compressor uses a performance control set: Amount (threshold and makeup gain together), Release, Mix (dry/wet parallel compression), click-free on/off button, about 5 gain-reduction LEDs, plus sidechain LPF frequency/bypass and source select. Attack (fast), ratio (about 4:1) and makeup range are preset inside
45. Sidechain source: INT (compressor bus) / BUS (sidechain bus) / EXT (jack); selected by an SC BUS button and the EXT jack's plug detection since item 90 (was a 3-position switch). Per-channel SC send button tapped pre-fader and pre-mute (ghost triggering from muted channels). EXT input DC-coupled for audio and Eurorack envelopes/gates up to ±12 V. SC listen button routes the filtered sidechain to the cue bus
49. Master meter: stereo, 12 segments per side (-30, -20, -15, -10, -6, -3, 0, +3, +6, +9, +12, clip), measuring the master bus after the master level control. 0 = +4 dBu; clip lights about 3 dB below the internal limit (about +17 dBu internal, +23 dBu at the balanced outputs). All meters (channel and master) are peak-reading with a slow fall of about 1 to 2 s
51. AUX sends and returns levels: each send has a dual-gang master pot (-∞ to 0 dB) on the master card, outputs impedance-balanced TRS at +4 dBu nominal. Each return uses an AD8273 receiver with a gain jumper (-6 dB for pro/Eurorack effects, +6 dB for pedals), a linear pot controlling an SSI2162 VCA (-∞ to +10 dB), a mute button and the main/compressor bus switch
56. Headphone output for the prototype: dual-gang volume pot, NJM4556A-class high-current op amp driver (replaced by the TPA6120A2, item 84), 32 to 600 Ω, 6.3 mm jack on the front or top panel. A dedicated headphone amp chip can be considered for a product version
57. Compressor detector: feed-forward, peak-sensing, log conversion with a matched transistor array (AS3046 / THAT300 class; THAT2252 is obsolete). Amount 0 to 30 dB, Release 50 ms to 1.5 s, attack about 1 ms, ratio 4:1, gain-reduction LEDs at 1/3/6/10/15 dB
58. Power-up/down protection: relays on main and headphone outputs, about 2 s turn-on delay, fast disconnect when the chain voltage drops; AUX sends unprotected
82. The compressor's log detector uses an Alfa AS3046D transistor array (SOIC-14; five NPN, two as a matched pair with VBE within ±1 mV), about 4.50 € from synth-DIY sources such as Electric Druid. Not stocked at LCSC: hand-soldered or consigned like the SSI chips. THAT300 rejected on price (about 12.70 €) and scarce EU stock
83. Main balanced outputs use one THAT1646S08-U OutSmarts line driver per side (about 7 $ each): +24 dBu balanced, full level and no overload with a TS cable. **Cost-cut candidate:** if the budget needs it, fall back to two NE5532 halves per side (buffer + inverter with series output resistors; same +24 dBu, but a TS cable loses 6 dB and loads the cold leg). AUX sends stay impedance-balanced
84. Headphone driver: TI TPA6120A2 (HSOP-20 PowerPAD, ±15 V, 1.5 W per channel into 32 Ω; LCSC C70439, about 1.90 $), replacing the NJM4556A of item 56. The NJM4556AM's DMP8 package is rated for only 300 mW (Nisshinbo datasheet 2025-03-06) but would dissipate about 0.4 W per channel at 1 Vrms into 32 Ω from ±15 V; its DIP8 version is NRND. The thermal pad needs copper and vias under it
85. Output protection relays: three Omron G6K-2F-Y DC12 DPDT signal relays (SMD; LCSC C397194, about 0.94 $): main L (hot and cold), main R (hot and cold) and headphones (L and R). 12 V coils from +15 V through a series resistor, one transistor driver, a comparator and timer for the 2 s power-up delay and instant drop-out. Coil data and contact rating to be checked in the Omron datasheet when drawing

## Rationale notes

- Why a performance compressor: the mixer is played during the set, so the compressor gets a few controls with an obvious musical effect (Amount, Release, Mix, on/off) and the technical settings are preset for pumping. Mix keeps the kick's punch while the rest pumps.
- Why a send master pot but a return gain jumper: the send pot adapts the output to any effect and can be ridden live, so no jumper is needed; L/R mismatch of a dual-gang pot is inaudible on an effect feed. On the returns, a -10 dBV pedal arrives about 8 dB short even with the level pot's +10 dB, so the receiver gain jumper (set once per effect) covers it without running the VCA at high, noisy gain. Returns use a VCA for accurate L/R tracking in the main mix and a click-free mute.
125. Main output driver: TI DRV135UA replaces the THAT1646S08-U (refines item 83; `/board master` 2026-10-09; the part is unobtainable, the user delegated the choice). THAT Corporation's end-of-life memo (2026-09-01) ends the 1606/1646 OutSmarts drivers with its dielectric-isolation wafer process; the last-time buy closed 2026-09-30, and Mouser, DigiKey and LCSC have none. The DRV135UA (TI SBOS094B, Active, RoHS "Yes" in TI's addendum) has the THAT1646S08's SO-8 pinout pin for pin (1 −Vo, 2 −Sense, 3 Gnd, 4 Vin, 5 V−, 6 V+, 7 +Sense, 8 +Vo), +6 dB, 10 kΩ input, 50 Ω outputs, swing (V+) − 3 V / (V−) + 2 V (about +26 dBu differential at ±15 V), 5.2 / 5.5 mA; TI recommends a 10 µF non-polarised capacitor at each sense pin (Figure 29), as drawn. A TS plug grounds −Vo and, through its capacitor, −Sense: TI's single-ended mode (8.4.2), gain still +6 dB. LCSC C544663 (JLC extended, about 3.40 $), also Mouser 595-DRV135UA. Same footprint and nets; the symbol `syntsamix:THAT1646` is kept (same pins). The NE5532 fallback of item 83 stays the cost-cut candidate
150. Expensive master ICs hand-soldered on the prototype (`/board master` 2026-10-10; confirmed by the user, "I can try this in the prototype"; refines item 133 for these parts): the master's DG413 ×10, SSI2162 ×4, DRV135UA ×2 and AS3046D ×1 (17 SMD chips, about 230 joints; all 1.27 mm SOIC except the SSI2162's 1.0 mm SSOP-10) are soldered by the user on the one master that is populated, so the second master JLCPCB has to assemble carries none of them and no extended fee is paid for the DRV135 and AS3046D (about €38 on the prototype). The symbols carry the field Assembly = "hand (decision 150)"; `tools/costs.py` counts such symbols as user-soldered, per symbol, so the channel card's DG413 and SSI2162 stay JLCPCB-placed. Kept in the backlog as a potential single point of failure: one bad hand-soldered joint on the only master can silence the whole mixer, so a product build returns these to JLCPCB placement
169. Headphone jack parts (`/board master` 2026-10-13; refines items 56 and 162 (4), which left the part to choose; confirmed by the user: "yes, take the NYS230", "yes go ahead" on the KK header, "headphone cable makes sense" on the ready-made lead). The panel jack is the Rean NYS230 (SX-CONN-019): 6.3 mm stereo open-frame panel jack, metal frame, washer and nut, solder/faston tabs, panels up to 3.5 mm (distributor listings, Pacrad; no maker drawing found). Mouser 568-NYS230 $1.96, 2,187 in stock, RoHS compliant, Active (2026-10-13). J751 only ever used T, R and S (RN, SN, TN were unconnected in the netlist), so no switching jack is needed. On the card, J751 is a Molex KK 254 1x3 friction-lock header 22-27-2031 (SX-CONN-020; footprint Connector_Molex:Molex_KK-254_AE-6410-03A_1x03_P2.54mm_Vertical, 22-27-2031 = AE-6410-03A as 22-27-2101 = AE-6410-10A; Mouser 538-22-27-2031 $0.23, RoHS compliant): pin 1 tip (HP_L, K751.6), 2 ring (HP_R, K751.3), 3 sleeve (AGND). The cable is the ready-made Molex 217797-1031 (SX-CONN-021: KK 254 3-pin receptacle to free ends, 150 mm, 22 AWG UL 11028 discrete, tin-plated brass, mates 6410 headers per the Molex sheet of sibling 217796-1052; Mouser $2.45, 98 in stock, RoHS compliant; 300 mm 217797-1032 with 1,070 in stock as fallback); the user rejected hand crimping (bad experience; the input-module cables would add about 80 crimps, `/system` item). To check on a sample: the NYS230 depth behind the panel (about 30 mm assumed in 162) and its pin roles; the lead's pin order on the free ends. Rejected: Tayda A-3641 (TE-PJ-645D, $0.46, unbranded, reviews report stripped plastic threads); Neutrik NJ3FP6C ($9.33, D-size cut-out); JST XH 3-pin header (B3B-XH-A, LCSC C144394; weaker hold, new crimp family); wires soldered to the card (card not removable); a 22-01-3037 housing with hand-crimped 08-50-0114 terminals (crimping)
170. Master LEDs to 0805 (`/board master` 2026-10-13; implements 162 (7) and extends it to the PFL-active LED; GR colour and D752 confirmed by the user: "yes, keep them yellow", "yes, make D752 an 0805"). Meter D805-D828: KT-0805G (SX-D-011, LCSC C2297) for -30 to 0, KT-0805Y (SX-D-016, C2296) for +3 to +9, NCD0805R1 (SX-D-015, C84256) for +12 and CLIP, the channel meter's JLCPCB basic parts (119). Gain-reduction LEDs D407-D411 KT-0805Y: yellow reads as "compressor working", apart from the meter's green and red, with no new part type. PFL-active LED D752 (headphones sheet) KT-0805Y: the card hangs 10 mm under its panel (107), so a 3 mm LED on the card cannot reach the panel. Same drive as before (comparator or PFL_ACT through 1k5 from +5 V), no circuit change; netlist checks 0 problems on the meter (83 nets), compressor (83) and headphones (28) sheets, ERC 0/0. No new fee type (estimate about €3 lower). SX-D-005 and SX-D-006 retired; SX-D-004 stays as the power LED of decision 168. Rejected: GR LEDs graded yellow with a red 15 dB step (red next to CLIP reads as clipping); all red; D752 as a 3 mm LED raised on long legs (hand-soldered, hard to set flush); dropping D752 (nothing would show the headphones on cue during SC LISTEN)
