plektra/syntsamix/docs/parts.csv

ProjectPN | Description | Manufacturer | MPN | Supplier | SupplierPN | Notes
SX-IC-001 | 4-pole ladder VCF | Sound Semiconductor | SSI2144SS-TU | Electrokit | 41019301 | 16-lead SSOP, JEDEC MO-137-AB: 0.635 mm pitch, body 3.80-4.00 x 4.70-5.10 mm, lead span 5.80-6.20 mm (Sound Semiconductor package drawing PODPSSL16, updated May 2024, https://www.soundsemiconductor.com/downloads/PODPSSL16.pdf; the SSI2144 datasheet Rev 3.0 names the package but has no drawing); measured by the user 2026-10-14: body width 3.89, lead span 6.08, height 1.46, length 5.12 including end flash; dry fit on an SSOP-DIP adapter; KiCad footprint QSOP-16_3.9x4.9mm_P0.635mm is the same outline (pads cover the lead foot); not stocked at Mouser; RoHS: SGS test report CANEC25029425315 (SGS Guangzhou, 2025-12-02, lot 25J0288, client name redacted), the IC packaging house's test of its SOP/SSOP package families: 2011/65/EU with 2015/863, all ten substances not detected in body and pins (Pb 6 mg/kg in the pins), TSCA PBT pass, halogen-free; package listed as 0.635SSOP16; received from Electrokit (forwarded from their supplier) 2026-10-13 with an MSDS and a REACH report; local copy docs/rohs/ (not published); coverage of the SSI2144 confirmed by the maker, Sound Semiconductor, 2026-10-13 (the SOP family including SSOP; 'SSI2144 isn't a QSOP'); accepted by the user 2026-10-13 (decision 164)
SX-IC-002 | Dual VCA SSOP-10 1.00 mm pitch | Sound Semiconductor | SSI2162SS-TU | Electrokit | 41019302 | Pinout from datasheet Rev 1.2; package PSSL10 (1.00 mm pitch) from Sound Semiconductor drawing; RoHS: same SGS report as SX-IC-001 (CANEC25029425315, 2025-12-02, via Electrokit 2026-10-13, docs/rohs/); the package is not named there: taken as the listed SOP10 (same 3.9 x 4.9 mm body and 1.00 mm pitch; the board session's reading); coverage confirmed by the maker, Sound Semiconductor, 2026-10-13: 'that report covers the entire SOP family including SSOP of the SSI2144 and SSI2162'; accepted by the user 2026-10-13 (decision 164)
SX-IC-003 | Dual difference amplifier G=1/2 or 2 | Analog Devices |  | Mouser |  | Not used since 2026-10-10: channel receiver (decision 143) and master AUX return receivers (decision 148) are TL072 difference amplifiers; was: Channel card: replaced by a TL072 difference amplifier (decision 143); still the master AUX returns. AD8273 (SOIC-14); exact orderable MPN to verify; RoHS: Mouser 584-AD8273ARZ RoHS Compliant (orderable AD8273ARZ; checked 2026-10-09)
SX-POT-001 | Fader 60 mm 10 kOhm linear | Bourns | PTA6043-2015DPB103 | Mouser |  | Mouser part number to verify; RoHS: Mouser 652-PTA60432015DPB10 RoHS Compliant (checked 2026-10-09)
SX-CONN-001 | (replaced by SX-CONN-015; decision 132) 6.3 mm stereo jack switched (T R S all switched) horizontal PCB | Neutrik | NMJ6HCD2 | Mouser |  | Pinout verified from Neutrik drawing ST-NMJ6HCD2; >10000 mating cycles; Mouser part number to verify; RoHS: Mouser 550-22302 RoHS Compliant (checked 2026-10-09)
SX-CONN-002 | (replaced by SX-CONN-024; decision 181) Header 1x10 2.54 mm vertical friction lock (KK 254) | Molex |  | Mouser |  | Footprint Molex_KK-254_AE-6410-10A; MPN to verify; mates with SX-CONN-009/010 (decision 99); RoHS: Mouser 538-22-27-2101 RoHS Compliant (Molex 22-27-2101 = current number for AE-6410-10A; checked 2026-10-09)
SX-IC-004 | Dual low-noise op amp SOIC-8 | Texas Instruments |  | Mouser |  | NE5532 (SOIC-8); exact orderable MPN to verify; RoHS: Mouser 595-NE5532DR RoHS Compliant (orderable NE5532DR; checked 2026-10-09); channel U107 moved to TL072 (decision 123)
SX-IC-005 | Quad SPST analog switch 2NO+2NC SOIC-16 | Vishay |  | Mouser |  | DG413DY; pinout verified from Vishay doc 70050 Rev E; normally open (on at logic 1): SW1 pins 1-3 and SW4 pins 6-8 = KiCad units 1 and 2; normally closed: SW3 pins 9-11 and SW2 pins 14-16 = KiCad units 3 and 4; MPN suffix to verify; RoHS: Mouser 781-DG413DY-T1-E3 RoHS Compliant (orderable DG413DY-T1-E3; checked 2026-10-09); master U641 AUX send mono switching since 2026-10-10 (replaces the DG411: send 2 on units 3/4 from DET2, send 1 on units 1/2 from MONO1)
SX-R-001 | Resistor 100 Ohm 1% 0805
SX-R-002 | Resistor 10 kOhm 1% 0805
SX-R-003 | Resistor 2 kOhm 1% 0805
SX-R-004 | Resistor 4.7 kOhm 1% 0805 | UNI-ROYAL | 0805W8F4701T5E | LCSC | C17673 | master meter ladder R813 (decision 146); JLC fee-free; RoHS: LCSC C17673 ROHS (UNI-ROYAL suffix E = lead-free; checked 2026-10-10)
SX-R-005 | Resistor 16 kOhm 1% 0805 | UNI-ROYAL | 0805W8F1602T5E | LCSC | C17490 | Channel medium drive R103/R153 (decision 140); JLC preferred; RoHS: LCSC C17490 ROHS (UNI-ROYAL suffix E = lead-free; checked 2026-10-10); master meter ladder R811 (decision 146); power buck compensation R203 (decision 156)
SX-R-006 | Resistor 33 kOhm 1% 0805 | UNI-ROYAL | 0805W8F3302T5E | LCSC | C17633 | master fader laws (decision 144); JLC basic; RoHS: LCSC C17633 ROHS (UNI-ROYAL suffix E = lead-free; checked 2026-10-10)
SX-R-007 | Resistor 100 kOhm 1% 0805 | UNI-ROYAL | 0805W8F1003T5E | LCSC | C149504 | master fader laws (decision 144); JLC basic; RoHS: LCSC C149504 ROHS (UNI-ROYAL suffix E = lead-free; checked 2026-10-10)
SX-R-008 | Resistor 12 kOhm 1% 0805
SX-C-001 | Capacitor 220 pF C0G 50 V 0805
SX-C-002 | Capacitor 100 nF X7R 50 V 0805
SX-C-003 | Capacitor 10 uF bipolar electrolytic 25 V+ radial 5 mm |  |  |  |  | Not used since decision 127 (master bipolars now SX-C-023)
SX-C-004 | Capacitor 22 pF C0G 50 V 0805
SX-C-005 | Capacitor 47 nF film 5% 5 mm pitch |  |  |  |  | Not used since decision 113 (channel low-cut now SX-C-026)
SX-POT-002 | Dual pot 250 kOhm audio (A) 9 mm vertical | Alpha |  |  |  | Footprint Alpha RD902F-40-00D; MPN to verify; not used since decision 115 (channel TRIM now SX-POT-011)
SX-D-001 | Zener diode 6.2 V SOD-123 | hongjiacheng | BZT52C6V2 | LCSC | C19077403 | Soft-clip zeners (channel input, master out); hongjiacheng datasheet Rev 2.1: VZ 5.89-6.51 V at 5 mA, 350 mW, 357 C/W, SOD-123 (land pattern matches KiCad D_SOD-123); JLCPCB preferred (decision 137); RoHS: hongjiacheng datasheet Rev 2.1 (RoHS-compliant, halogen-free) and LCSC C19077403 ROHS (checked 2026-10-10)
SX-D-002 | LED 0805 low current |  |  |  |  | Not used on any board since 2026-10-10 (master button LEDs moved too): the button LEDs take one part per colour (SX-D-011 green, SX-D-015 red, SX-D-016 yellow, SX-D-017 white)
SX-SW-001 | Latching push button DPDT 8.5x8.5 mm PCB | CW Industries | GPBS850L | Electrokit | 41012905 | Datasheet GPBS850L Rev 2 (2014, cwind.com/sites/cwind/files/gpbs850l.pdf): pressed = 2-3 and 5-6 closed, latching (LOCK position), plunger 4.0 mm wide; 100k mechanical cycles; footprint syntsamix:SW_Latching_8.5x8.5mm_CW_GPBS850L; RoHS: Mouser 629-GPBS-850L RoHS Compliant, DigiKey CW179-ND ROHS3 (checked 2026-10-10); MPN corrected 2026-10-10: GPBS850N is the momentary twin (Electrokit 41015527), whose datasheet Electrokit also links from 41012905; contact sequence (break-before-make or not) not recorded: circuits must not depend on it (decision 142)
SX-IC-006 | Dual OTA with linearizing diodes and buffers SOIC-16 | Texas Instruments |  | Mouser |  | LM13700 (SOIC-16); pinout verified from TI SNOSBW2F; orderable MPN to verify. Q VCA per SSI2144 datasheet Figure 9; RoHS: Mouser 926-LM13700MX/NOPB RoHS Compliant (orderable LM13700MX/NOPB; checked 2026-10-09)
SX-R-009 | Resistor 17.4 kOhm 1% 0805 |  |  |  |  | Not used since 2026-10-10: channel values moved to E24 (decision 140)
SX-R-010 | Resistor 200 Ohm 1% 0805
SX-R-011 | Resistor 13 kOhm 1% 0805 |  | 0805W8F1302T5E |  | C17455 | SSI2144 Q pin, master fader-law pairs R242/R342/R734 (decision 144); JLC preferred (decision 137); RoHS: LCSC C17455 ROHS (UNI-ROYAL suffix E = lead-free; checked 2026-10-10)
SX-R-012 | Resistor 604 Ohm 1% 0805 |  |  |  |  | Not used since 2026-10-10: channel values moved to E24 (decision 140); Datasheet Figure 9 shows 599 Ohm (not an E96 value)
SX-R-013 | Resistor 52.3 kOhm 1% 0805 |  |  |  |  | Not used since 2026-10-10: channel values moved to E24 (decision 140)
SX-R-014 | Resistor 8.66 kOhm 1% 0805 |  |  |  |  | Not used since 2026-10-10: master fader laws moved to the channel's E24 values (decision 144); was: Filter output scale; provisional until the breadboard
SX-R-015 | Resistor 41.2 kOhm 1% 0805 |  |  |  |  | Not used since 2026-10-10: channel values moved to E24 (decision 140); Q current limit; provisional until the breadboard
SX-R-016 | Resistor 6.04 kOhm 1% 0805 |  |  |  |  | Not used since 2026-10-10: channel values moved to E24 (decision 140)
SX-R-017 | Resistor 16.9 kOhm 1% 0805 |  |  |  |  | Not used since 2026-10-10: channel values moved to E24 (decision 140)
SX-R-018 | Resistor 301 kOhm 1% 0805 |  |  |  |  | Not used since 2026-10-10: channel values moved to E24 (decision 140)
SX-R-019 | Resistor 162 kOhm 1% 0805 |  |  |  |  | Not used since 2026-10-10: channel values moved to E24 (decision 140)
SX-R-020 | Resistor 499 kOhm 1% 0805
SX-R-021 | Resistor 1 kOhm +3300 ppm/K temperature-compensating 0603 | Panasonic | ERA-V33J102V |  |  | Not used since 2026-10-10: R421 is a plain 1k (decision 149), temperature compensation in the backlog; was: Named in SSI2144 datasheet Rev 3.0; place against the SSI2144; RoHS: Mouser 667-ERA-V33J102V RoHS Compliant By Exemption (Mouser lifecycle End of Life; checked 2026-10-09); channel card R108/R158 replaced by SX-R-089 + SX-R-090 (decision 130); still on the master card R421
SX-C-006 | Capacitor 6.8 nF C0G 5% 50 V 0805 |  |  |  |  | Ladder capacitor
SX-C-007 | Capacitor 560 pF C0G 5% 50 V 0805 |  |  |  |  | Ladder capacitor
SX-C-008 | Capacitor 100 pF C0G 5% 50 V 0805
SX-D-003 | Small-signal diode 1N4148W SOD-123
SX-POT-003 | Pot 50 kOhm linear single 9 mm vertical T18 knurled 15 mm | Alpha | RD901F-40-15K-B50K | Tayda | A-4730 | Channel CUTOFF (decisions 114, 115); Thonk Alpha 9 mm vertical T18 B50K, 1.69 GBP, in stock 2026-10-09 (https://www.thonk.co.uk/shop/alpha-9mm-pots-vertical-t18/); Alpha order code from Thonk support 2026-10-09; footprint Alpha RD901F-40-00D; bushing M7x0.75 x 5 mm (confirmed by Thonk support 2026-10-09); RoHS: Taiwan Alpha RoHS II declaration 2020-10-26, all standard models (2011/65/EU with 2015/863, ten substances), received via Thonk 2026-10-09; local copy docs/rohs/ (not published); Alpha spec RD901F-(C) (Tayda copy SP26020021, 2026-02-04, drawing SLH-211-414): tolerance +/-20 %, 0.05 W B taper / 0.02 W other tapers, 300 deg, rotation noise 100 mV max, 15,000 cycles, hand solder at most 350 C for 3 s and once only, no reflow, use within 6 months of delivery; nut M7x0.75 2.0 mm thick 10 mm AF and 0.4 mm washer supplied; Tayda A-4730 (USD 1.29), form checked on the listing (Wayback snapshot 2024-06: T18 knurled 6 mm, 15 mm, 9 mm base, PCB, vertical; 2026-10-10); Tayda carries no T18 9 mm A100K or A10K duals (round 6.35 mm shafts only), so TRIM and AUX stay at Thonk; RoHS: Alpha general declaration (decision 124)
SX-POT-004 | Pot 10 kOhm reverse-audio (C) single |  |  |  |  | RESONANCE and compressor RELEASE; SSI2144 datasheet suggests Bourns PDB181 class; part and footprint to choose; Master RELEASE moved to SX-POT-014 (C100K, decision 131)
SX-TRIM-001 | Trimmer 50 kOhm multiturn top adjust | Bourns | 3296W-1-503LF | Mouser | 652-3296W-1-503LF | Not used since decision 184 (SX-TRIM-002); 10.03 mm tall 25 turns (Bourns 3296 datasheet); channel card mounts it on the underside (decision 112);RoHS: Mouser 652-3296W-1-503LF RoHS Compliant By Exemption (checked 2026-10-09); Mouser 652-3296W-1-503LF (5549 in stock, EUR 1.58 at 10+, 1.38 at 25+; 2026-10-10): bought with the other Mouser parts (fader, headers, jacks, bipolar caps)
SX-CONN-003 | 6.3 mm mono switched jack vertical (top panel) |  |  |  |  | Not used: CUTOFF CV input is the 3.5 mm SX-CONN-014 (decision 118; no 6.3 mm jack fits the 10 mm panel gap)
SX-CONN-004 | Pin header 2x2 2.54 mm vertical |  |  |  |  | Jumper header
SX-CONN-005 | Pin header 1x3 2.54 mm vertical |  |  |  |  | Jumper header
SX-MECH-001 | Jumper cap 2.54 mm |  |  |  |  | For SX-CONN-004/005
SX-IC-007 | Dual JFET op amp SOIC-8 | STMicroelectronics | TL072CDT | LCSC | C6961 | TL072 (SOIC-8); used for low-bias control circuits; channel U107 cutoff CV summer since decision 123; JLCPCB basic (decision 137, 2026-10-10; was TI TL072CDR, extended): ST DocID 2298 Rev 7: pins 1 OUT1 2 -IN1 3 +IN1 4 V- 5 +IN2 6 -IN2 7 OUT2 8 V+ (same as TI and the KiCad TL072 symbol), supply max +-18 V, input max +-15 V, ICC 1.4 / 2.5 mA per amplifier, SO-8 125 C/W, TL072C 0 to 70 C; RoHS: LCSC C6961 ROHS (checked 2026-10-10); the master card symbols still say Texas Instruments (noted in its STATUS.md); master symbols carry the ST fields since 2026-10-10 (decision 147); master AUX return receivers U201/U301 (decision 148)
SX-R-022 | Resistor 110 Ohm 1% 0805 |  |  |  |  | Not used since 2026-10-10: channel values moved to E24 (decision 140)
SX-R-023 | Resistor 113 kOhm 1% 0805 |  |  |  |  | Not used since 2026-10-10: master fader laws moved to the channel's E24 values (decision 144)
SX-R-024 | Resistor 453 kOhm 1% 0805 |  |  |  |  | Not used since 2026-10-10: compressor and sidechain values on fee-free parts (decision 147); was: Compressor R443 only since decision 144 (master fader laws moved to E24 pairs)
SX-R-025 | Resistor 221 kOhm 1% 0805 |  |  |  |  | Not used since 2026-10-10: master fader laws moved to the channel's E24 values (decision 144)
SX-R-026 | Resistor 63.4 kOhm 1% 0805 |  |  |  |  | Not used since 2026-10-10: master fader laws moved to the channel's E24 values (decision 144)
SX-R-027 | Resistor 124 kOhm 1% 0805 |  |  |  |  | Not used since 2026-10-10: master fader laws moved to the channel's E24 values (decision 144)
SX-R-028 | Resistor 33.2 kOhm 1% 0805 |  |  |  |  | Not used since 2026-10-10: master fader laws moved to the channel's E24 values (decision 144)
SX-R-029 | Resistor 15.8 kOhm 1% 0805 |  |  |  |  | Not used since 2026-10-10: power R203 is 16k (SX-R-005; decision 156)
SX-R-030 | Resistor 14.3 kOhm 1% 0805 |  |  |  |  | SSI2162 Class A mode resistor; DNP by default
SX-C-009 | Capacitor 2.2 nF C0G 5% 50 V 0805 |  |  |  |  | SSI2162 input RC
SX-C-010 | Capacitor 1 uF X7R 50 V 0805
SX-R-031 | Resistor 24 kOhm 1% 0805 | UNI-ROYAL | 0805W8F2402T5E | LCSC | C17575 | Low-cut 100 Hz; master fader laws (decision 144); JLC basic; RoHS: LCSC C17575 ROHS (UNI-ROYAL suffix E = lead-free; checked 2026-10-10)
SX-R-032 | Resistor 47 kOhm 1% 0805 |  |  |  |  | Low-cut 100 Hz
SX-IC-008 | Quad SPST analog switch 4x NO SOIC-16 | Vishay |  | Mouser |  | Not used since 2026-10-10: the channel PFL/SC switch U303 is a DG413 (decision 139). DG412DY; truth table and pinout from Vishay doc 61564 Rev B; MPN suffix to verify; RoHS: Mouser 781-DG412DY-T1-E3 RoHS Compliant (orderable DG412DY-T1-E3; checked 2026-10-09)
SX-Q-001 | NPN transistor SOT-23 | onsemi | MMBT3904LT1G | Mouser |  | PFL_ACT open-collector driver; pinout B-E-C (1-2-3); RoHS: Mouser 863-MMBT3904LT1G RoHS Compliant (checked 2026-10-09); master Q601 DET1 inverter on the AUX sends sheet (2026-10-10)
SX-R-033 | Resistor 22.1 kOhm 1% 0805 |  |  |  |  | Bus resistor
SX-R-034 | Resistor 44.2 kOhm 1% 0805 |  |  |  |  | Not used since 2026-10-10: channel values moved to E24 (decision 140); SC send (L+R)/2
SX-POT-005 | Dual pot 10 kOhm audio (A) 9 mm vertical | Alpha |  |  |  | AUX level; footprint Alpha RD902F-40-00D; MPN to verify; RoHS: Taiwan Alpha RoHS II declaration 2020-10-26 covers it once a standard Alpha model is chosen (decision 124); Master AUX1/AUX2 SEND and PHONES: same part as SX-POT-013 (Thonk, RD902F-40-15K-A10K-0057)
SX-CONN-006 | Pin header 2x3 2.54 mm vertical |  |  |  |  | AUX pre/post jumper
SX-IC-009 | Quad comparator SOIC-14 | Texas Instruments |  | Mouser |  | LM339 (SOIC-14); pinout from TI SLCS006Z (pin pairs 2/4-5, 1/6-7, 14/8-9, 13/10-11); MPN to verify; RoHS: Mouser 595-LM339DR RoHS Compliant (orderable LM339DR; checked 2026-10-09)
SX-R-035 | Resistor 1 kOhm 1% 0805
SX-R-036 | Resistor 680 kOhm 1% 0805 |  | 0805W8F6803T5E |  | C17797 | Meter decay; power UVLO top R201/R301 (decision 156); JLC preferred (decision 137); RoHS: LCSC C17797 ROHS (UNI-ROYAL suffix E = lead-free; checked 2026-10-10)
SX-R-037 | Resistor 19.1 kOhm 1% 0805 |  |  |  |  | Not used since 2026-10-10: channel values moved to E24 (decision 140); Meter ladder
SX-R-038 | Resistor 4.02 kOhm 1% 0805 |  |  |  |  | Not used since 2026-10-10: compressor and sidechain values on fee-free parts (decision 147); was: Meter ladder
SX-R-039 | Resistor 1.43 kOhm 1% 0805 |  |  |  |  | Not used since 2026-10-10: channel values moved to E24 (decision 140); Meter ladder
SX-R-040 | Resistor 1.54 kOhm 1% 0805 |  |  |  |  | Not used since 2026-10-10: channel values moved to E24 (decision 140); Meter ladder
SX-R-041 | Resistor 845 Ohm 1% 0805 |  |  |  |  | Not used since 2026-10-10: channel values moved to E24 (decision 140); Meter ladder
SX-R-042 | Resistor 750 Ohm 1% 0805 |  | 0805W8F7500T5E |  | C17818 | Not used since 2026-10-10: channel values moved to E24 (decision 140); Meter ladder; JLC preferred (decision 137); RoHS: LCSC C17818 ROHS (UNI-ROYAL suffix E = lead-free; checked 2026-10-10); master meter ladder R818/R819 (decision 146)
SX-R-043 | Resistor 237 Ohm 1% 0805 |  |  |  |  | Not used since 2026-10-10: channel values moved to E24 (decision 140); Meter ladder
SX-R-044 | Resistor 1.5 kOhm 1% 0805 | UNI-ROYAL | 0805W8F1501T5E | LCSC | C4310 | Meter LED (about 2 mA from +5 V); master meter ladder R816 (decision 146); JLC fee-free; RoHS: LCSC C4310 ROHS (UNI-ROYAL suffix E = lead-free; checked 2026-10-10)
SX-D-004 | LED 3 mm green low current | Kingbright | WP710A10LGD | Mouser | 604-WP710A10LGD | Power board panel power LED on the power bay's top strip, wired to J103 in a SX-MECH-006 clip (decision 168); the master meter moved to 0805 on 2026-10-13 (decision 162; SX-D-005 and SX-D-006 retired). Kingbright datasheet DSAL0509 V.9B (2020-04-18): T-1 3 mm green GaP diffused, 1 mcd min / 3 mcd typ at 2 mA, 50 deg, VF 1.9 typ / 2.25 max at 2 mA, IF 25 mA DC, VR 5 V, -40 to +85 C; body 4.6 mm + 1 mm flange, flange 3.2 mm (the Mouser title's 2 mcd and 40 deg differ: datasheet figures used); solder wire joints with one heat-shrink sleeve per lead (datasheet precautions); RoHS: Kingbright datasheet DSAL0509 V.9B 'RoHS compliant' and Mouser 604-WP710A10LGD RoHS Compliant (checked 2026-10-13)
SX-D-005 | LED 3 mm yellow low current | Kingbright | WP710A10LYD | Mouser | 604-WP710A10LYD | Not used since 2026-10-13: the master meter, gain-reduction and PFL-active LEDs moved to 0805 (decision 162, SX-D-016). Meter segments +3 and +6; compressor gain-reduction LEDs (colour to confirm); part to choose; channel meter now 0805 (decision 119); still the master meter's LEDs until its own session; Candidate (sub-agent search 2026-10-09): Kingbright WP710A10 low-current diffused series, 2 mcd at 2 mA, 0.25 USD, 2473 in stock; body height to read from the Kingbright drawing (DigiKey 5.9 mm max); RoHS: Kingbright datasheet 'RoHS compliant' and Mouser RoHS Compliant (from the sub-agent; recheck on the datasheet before ordering); LED form for the master (3 mm or 0805 as decision 119) is open for /system mechanical
SX-D-006 | LED 3 mm red low current | Kingbright | WP710A10LID | Mouser | 604-WP710A10LID | Not used since 2026-10-13: the master meter moved to 0805 (decision 162, SX-D-015). Meter clip segment; part to choose; channel meter now 0805 (decision 119); still the master meter's LEDs until its own session; Candidate (sub-agent search 2026-10-09): Kingbright WP710A10 low-current diffused series, 3 mcd at 2 mA, 0.27 USD, 22650 in stock; also LCSC C5879080; body height to read from the Kingbright drawing (DigiKey 5.9 mm max); RoHS: Kingbright datasheet 'RoHS compliant' and Mouser RoHS Compliant (from the sub-agent; recheck on the datasheet before ordering); LED form for the master (3 mm or 0805 as decision 119) is open for /system mechanical
SX-CONN-007 | IDC box header 2x17 2.54 mm vertical shrouded keyed | Wurth Elektronik | 61203421621 | Mouser | 710-61203421621 | Audio ribbon (docs/CHAIN.md); WR-BHD straight THT (Wurth drawing rev 002.001 2026-08-30: L 50.84 mm, 9.1 mm above the board, key slot 4.5 mm, holes 1.1 +-0.15 mm; Mouser's title says 'Angld' in error, RS and the drawing say straight); about 1.02 EUR at 100, 1235 in stock 2026-10-09; hand-soldered (underside, decision 109); RoHS: Mouser RoHS Compliant, RoHS/REACh marks on the Wurth drawing (checked 2026-10-09)
SX-CONN-008 | IDC box header 2x4 2.54 mm vertical shrouded keyed | Wurth Elektronik | 61200821621 | Mouser | 710-61200821621 | Power ribbon (docs/CHAIN.md); 3 A per contact (Wurth WR-BHD datasheet text; check the rendered page); not at LCSC: hand-solder (decision 100); about 0.78 EUR at 50, 6896 in stock 2026-10-09; RoHS: Mouser RoHS Compliant (checked 2026-10-09)
SX-IC-010 | Adjustable positive regulator TO-220 | onsemi | LM317TG | Mouser | 863-LM317TG | Master U901; pinout 1 ADJ 2 VOUT 3 VIN, tab = pin 2; TO-220 RthJA 65 C/W, RthJC 5 C/W; VI-VO 40 V; TJ 0 to 125 C (onsemi LM317/D Rev. 18); replaces the TI LM317KCSE3, NRND (SLVS044Z p.30); Active, RoHS: Mouser 863-LM317TG RoHS Compliant By Exemption (checked 2026-10-17)
SX-IC-011 | Adjustable negative regulator TO-220 | onsemi | LM337TG | Mouser | 863-LM337TG | Master U902; pinout 1 ADJ 2 VIN 3 VOUT, tab = pin 2; TO-220 RthJA 65 C/W, RthJC 5 C/W; VI-VO 40 V; TJ 0 to 125 C (onsemi LM337/D Rev. 11); output capacitor not low-ESR or ceramic (p. 7); same maker as SX-IC-010 (TI LM337KCSE3 still Active, dropped for one family and price); Active, RoHS: Mouser 863-LM337TG RoHS Compliant By Exemption (checked 2026-10-17)
SX-IC-012 | 5 V 100 mA regulator SOT-89 | UTC | 78L05G-AB3-R | LCSC | C71136 | JLCPCB basic (decision 137, 2026-10-10; was ST L78L05ACUTR, extended); UTC QW-R101-001.R: -AB3-R pins 1 OUT 2 GND 3 IN (matches the KiCad L78L05_SOT89 symbol and footprint; the -AB3-C-R variant is G I O: do not substitute), VIN max 30 V, IQ 2.0 / 5.5 mA, PD 350 mW in SOT-89 (channel worst case 0.25 W: copper on the GND tab); G = lead-free and halogen-free; RoHS: UTC datasheet (G suffix lead-free, halogen-free) and LCSC C71136 ROHS (checked 2026-10-10)
SX-R-045 | Resistor 120 Ohm 1% 0805 | UNI-ROYAL | 0805W8F1200T5E | LCSC | C17437 | Regulator divider; master meter ladder R823 (decision 146); JLC fee-free; RoHS: LCSC C17437 ROHS (UNI-ROYAL suffix E = lead-free; checked 2026-10-10)
SX-R-046 | Resistor 1.33 kOhm 1% 0805 |  |  |  |  | Regulator divider (15.2 V)
SX-C-011 | Capacitor 47 uF 35 V electrolytic radial 6.3 mm |  |  |  |  | Regulator input; Not used since decision 127 (master now SX-C-025)
SX-C-012 | Capacitor 10 uF 25 V electrolytic radial 5 mm |  |  |  |  | Regulator ADJ and output; Not used since decision 127 (master now SX-C-024)
SX-D-007 | Schottky diode 1 A 40 V SMA |  |  |  |  | SS14 class; rail clamp to AGND
SX-R-047 | Resistor 22 kOhm 1% 0805 |  | 0805W8F2202T5E |  | C17560 | Bus resistor; JLC basic (decision 79); RoHS: LCSC C17560 ROHS (checked 2026-10-09)
SX-R-048 | Resistor 470 kOhm 1% 0805 |  | 0805W8F4703T5E |  | C17709 | Cutoff offset injection; JLC basic (decision 79); RoHS: LCSC C17709 ROHS (checked 2026-10-09); compressor GR LED ladder R443 (decision 147)
SX-R-049 | Resistor 2.2 kOhm 1% 0805 |  | 0805W8F2201T5E |  | C17520 | Regulator divider with 200 Ohm (15.1 V); JLC basic (decision 79); RoHS: LCSC C17520 ROHS (checked 2026-10-09)
SX-IC-013 | NPN transistor array with matched pair SOIC-14 | Alfa | AS3046D | Electric Druid |  | Compressor log detector (decision 82); pinout from Alfa datasheet 2019 v.2: 1 C1 2 B1 3 E1/E2 (matched pair) 4 B2 5 C2 6 B3 7 E3 8 C3 9 B4 10 E4 11 C4 12 B5 13 E5 and substrate (to the most negative rail) 14 C5; hand-soldered by the user on the prototype master (decision 150)
SX-IC-014 | Balanced line driver OutSmarts SOIC-8 | THAT Corporation | THAT1646S08-U | Mouser |  | Main outputs (decision 83, cost-cut candidate); pinout from THAT doc 600078 Rev 07: 1 Out- 2 Sns- 3 Gnd 4 In 5 Vee 6 Vcc 7 Sns+ 8 Out+; +6 dB, 5 kOhm input; symbol syntsamix:THAT1646; RoHS: Mouser 887-1646S08-U RoHS Compliant (Mouser lifecycle End of Life; checked 2026-10-09); Not used since decision 125: THAT EOL memo 2026-09-01 (1606/1646 OutSmarts), last-time buy closed 2026-09-30; replaced by SX-IC-025
SX-IC-015 | Headphone amplifier HSOP-20 PowerPAD | Texas Instruments | TPA6120A2DWPR | LCSC | C70439 | Decision 84; pinout from TI SLOS431B: 1 LVCC- 2 LOUT 3 LVCC+ 4 LIN+ 5 LIN- 6-15 NC 16 RIN- 17 RIN+ 18 RVCC+ 19 ROUT 20 RVCC-, thermal pad (21) to ground; footprint Package_SO:SO-20-1EP_7.52x12.825mm..._ThermalVias (TI DWP); symbol syntsamix:TPA6120A2; RoHS: Mouser 595-TPA6120A2DWPR RoHS Compliant (checked 2026-10-09)
SX-K-001 | Signal relay DPDT 12 V coil SMD | Omron | G6K-2F-Y DC12 | LCSC | C397194 | Output protection (decision 85); Omron cat. K106-E1-11: 12 V coil 9.1 mA 1315 Ohm, operate 80 % max, max 150 %; contacts 1 A 30 VDC, min 10 uA 10 mV; pins (KiCad Relay:G6K-2) 1 coil+ 8 coil- / COM 3 NC 2 NO 4 / COM 6 NC 7 NO 5; NC/NO assignment to re-check against the Omron terminal diagram; RoHS: LCSC C397194 ROHS (checked 2026-10-09)
SX-IC-016 | 5 V 1.5 A regulator TO-220 | STMicroelectronics | L7805CV |  |  | Master +5 V (decision 87); pinout 1 IN 2 GND 3 OUT (KiCad library); RoHS: Mouser 511-L7805CV RoHS Compliant By Exemption (checked 2026-10-09)
SX-SW-002 | Ground lift switch SPST panel |  |  |  |  | Master rear panel (decision 87); on the rear input row board between ribbon conductors 25 (star) and 26 (CHASSIS) of J903 (decision 163); part to choose
SX-C-013 | Capacitor 100 nF X7R 100 V 0805 |  |  |  |  | Ground lift RC (decision 87)
SX-R-050 | Resistor 30 kOhm 1% 0805 |  | 0805W8F3002T5E |  | C17621 | AUX return gain jumper (decision 88); JLC basic; RoHS: LCSC C17621 ROHS (checked 2026-10-09)
SX-POT-006 | Pot 10 kOhm linear single 9 mm vertical | Alpha | RD901F-40-15K-B10K | Tayda | A-4728 | AUX return level (decision 88); footprint Alpha RD901F-40-00D; MPN to verify; RoHS: Taiwan Alpha RoHS II declaration 2020-10-26 covers it once a standard Alpha model is chosen (decision 124); candidate: T18 knurled 15 mm; 1.29 USD, 1885 in stock (2026-10-09, cached); alt Thonk single B10K 1.69 GBP
SX-R-051 | Resistor 20 kOhm 1% 0805 | UNI-ROYAL | 0805W8F2002T5E | LCSC | C4328 | Compressor full-wave rectifier (sets the detector scale with SX-R-002); compressor R457 (decision 147); JLC basic; RoHS: LCSC C4328 ROHS (UNI-ROYAL suffix E = lead-free; checked 2026-10-10)
SX-R-052 | Resistor 10 MOhm 1% 0805 |  |  |  |  | Compressor log converter floor current
SX-R-053 | Resistor 560 kOhm 1% 0805 |  |  |  |  | Not used since 2026-10-10: compressor and sidechain values on fee-free parts (decision 147); was: Compressor log reference current
SX-R-054 | Resistor 11 kOhm 1% 0805 |  |  |  |  | Compressor detector gain -11 with SX-R-021
SX-R-055 | Resistor 470 Ohm 1% 0805 |  |  |  |  | Compressor attack
SX-R-056 | Resistor 2.2 MOhm 1% 0805 |  |  |  |  | Compressor release current and threshold offset
SX-R-057 | Resistor 620 Ohm 1% 0805 |  |  |  |  | Compressor release range (slow end); not used since decision 131 (R425 now SX-R-091)
SX-R-058 | Resistor 140 kOhm 1% 0805 |  |  |  |  | Not used since 2026-10-10: compressor and sidechain values on fee-free parts (decision 147); was: Compressor Amount pot top (about 1 V = 30 dB)
SX-R-059 | Resistor 3.3 MOhm 1% 0805 |  |  |  |  | Compressor off-state threshold lift
SX-R-060 | Resistor 1 MOhm 1% 0805 |  |  |  |  | Compressor off-state threshold lift
SX-R-061 | Resistor 75 kOhm 1% 0805 |  |  |  |  | Compressor 4:1 ratio
SX-R-062 | Resistor 68 kOhm 1% 0805 |  |  |  |  | Compressor makeup (0.735 x Amount)
SX-R-063 | Resistor 3 kOhm 1% 0805 | UNI-ROYAL | 0805W8F3001T5E | LCSC | C17661 | Gain-reduction LED ladder; master meter ladder R814 (decision 146); JLC fee-free; RoHS: LCSC C17661 ROHS (UNI-ROYAL suffix E = lead-free; checked 2026-10-10)
SX-R-064 | Resistor 5.1 kOhm 1% 0805 |  |  |  |  | Gain-reduction LED ladder
SX-C-014 | Capacitor 220 nF X7R 50 V 0805 |  |  |  |  | Compressor on/off ramps
SX-POT-007 | Dual pot 10 kOhm linear 9 mm vertical | Alpha | RD902F-40-15K-B10K | Tayda | A-7621 | Compressor MIX; footprint Alpha RD902F-40-00D; MPN to verify; RoHS: Taiwan Alpha RoHS II declaration 2020-10-26 covers it once a standard Alpha model is chosen (decision 124); candidate: T18 knurled 15 mm; 1.29 USD, 292 in stock (2026-10-09, cached); alt Thonk dual B10K 1.99 GBP
SX-R-065 | Resistor 27 kOhm 1% 0805 |  |  |  |  | Ducker DEPTH pot top (4 V)
SX-C-015 | Capacitor 2.2 uF X7R 25 V 0805 |  |  |  |  | Ducker hold
SX-C-016 | Capacitor 47 nF C0G 5% 50 V 0805 |  |  |  |  | Sidechain LPF; sidechain C503 + C521 in series for 23.5 nF (decision 147)
SX-C-017 | Capacitor 22 nF C0G 5% 50 V 0805 |  |  |  |  | Not used since 2026-10-10: compressor and sidechain values on fee-free parts (decision 147); was: Sidechain LPF
SX-POT-008 | Dual pot 100 kOhm reverse-audio (C) 9 mm vertical | Alpha |  |  |  | Not used since decision 138 (SC LPF RV501 now SX-POT-015, B100K): no standard T18 dual C100K found at Thonk or Tayda (2026-10-09); footprint Alpha RD902F-40-00D
SX-POT-009 | Pot 10 kOhm audio (A) single 9 mm vertical | Alpha | RD901F-40-15K-A10K | Tayda | A-5365 | Ducker THRESHOLD; footprint Alpha RD901F-40-00D; MPN to verify; RoHS: Taiwan Alpha RoHS II declaration 2020-10-26 covers it once a standard Alpha model is chosen (decision 124); candidate: T18 knurled 15 mm; 1.29 USD (stock unclear 2026-10-09); alt Thonk single A10K 1.69 GBP
SX-POT-010 | Pot 500 kOhm audio (A) single 9 mm vertical | Alpha | RD901F-40-15K-A500K | Tayda | A-5368 | Ducker DECAY; footprint Alpha RD901F-40-00D; MPN to verify; RoHS: Taiwan Alpha RoHS II declaration 2020-10-26 covers it once a standard Alpha model is chosen (decision 124); candidate: T18 knurled 15 mm; 1.29 USD (stock unclear 2026-10-09; Thonk has no 500K)
SX-POT-011 | Dual pot 100 kOhm audio (A) 9 mm vertical T18 knurled 15 mm | Alpha | RD902F-40-15K-A100K-0057 | Thonk |  | Channel TRIM (decision 115); Thonk Alpha 9 mm vertical T18 dual gang A100K, 1.99 GBP, in stock 2026-10-09 (https://www.thonk.co.uk/shop/alpha-9mm-pots-vert-t18-dual-gang/); Alpha order code from Thonk support 2026-10-09; footprint Alpha RD902F-40-00D (Alpha drawing RD902F-40-(L)R1: pin pattern matches); bushing M7x0.75 x 5 mm (confirmed by Thonk support 2026-10-09); RoHS: Taiwan Alpha RoHS II declaration 2020-10-26, all standard models (2011/65/EU with 2015/863, ten substances), received via Thonk 2026-10-09; local copy docs/rohs/ (not published); power rating of the RD902F dual not yet read (RD901F single: 0.02 W for non-B tapers); dissipation here a few mW (decision 129)
SX-POT-012 | Pot 10 kOhm reverse-audio (C) single 9 mm vertical T18 knurled 15 mm | Alpha | RD901F-40-15K-C10K | Tayda | A-5369 | Channel RESONANCE (decisions 71, 115); 1.29 USD, about 494 in stock (cached listing 2026-10-09, recheck); 5 mm thread, 9 mm body; not Tayda A-1845 (40-tooth knurl, 12.7 mm); footprint Alpha RD901F-40-00D; RoHS: Taiwan Alpha RoHS II declaration 2020-10-26, all standard models (2011/65/EU with 2015/863, ten substances), received via Thonk 2026-10-09; local copy docs/rohs/ (not published); standard Alpha model, buy genuine Alpha (decision 124); Alpha spec RD901F-(C) (Tayda copy SP26020021, 2026-02-04, drawing SLH-211-414): tolerance +/-20 %, 0.05 W B taper / 0.02 W other tapers, 300 deg, rotation noise 100 mV max, 15,000 cycles, hand solder at most 350 C for 3 s and once only, no reflow, use within 6 months of delivery; nut M7x0.75 2.0 mm thick 10 mm AF and 0.4 mm washer supplied; channel RV183 dissipation about 17 mW with R184 = 12 k (decision 129)
SX-POT-013 | Dual pot 10 kOhm audio (A) 9 mm vertical T18 knurled 15 mm | Alpha | RD902F-40-15K-A10K-0057 | Thonk |  | Channel AUX1/AUX2 level (decision 115); Thonk Alpha 9 mm vertical T18 dual gang A10K, 1.99 GBP, in stock 2026-10-09 (https://www.thonk.co.uk/shop/alpha-9mm-pots-vert-t18-dual-gang/); Alpha order code from Thonk support 2026-10-09; footprint Alpha RD902F-40-00D; bushing M7x0.75 x 5 mm (confirmed by Thonk support 2026-10-09); RoHS: Taiwan Alpha RoHS II declaration 2020-10-26, all standard models (2011/65/EU with 2015/863, ten substances), received via Thonk 2026-10-09; local copy docs/rohs/ (not published); power rating of the RD902F dual not yet read (RD901F single: 0.02 W for non-B tapers); dissipation here a few mW (decision 129)
SX-IC-017 | Quad SPST analog switch 4x NC SOIC-16 | Vishay |  | Mouser |  | Not used since 2026-10-10: the master's U641 is a DG413 (send 1 on its normally open sections through the Q601 inverter); was: DG411DY; on at logic 0; pinout as DG413 (Vishay doc 70050 Rev D); AUX send mono switching; MPN suffix to verify; RoHS: Mouser 781-DG411DY-T1-E3 RoHS Compliant (orderable DG411DY-T1-E3; checked 2026-10-09)
SX-D-008 | Rectifier diode 1 A 1000 V SOD-123FL (1N4007W) | hongjiacheng | 1N4007W | LCSC | C18199088 | Master out phantom-power clamps D705-D712 (THAT doc 600078 Figure 8 uses 1N4004); SOD-123FL since 2026-10-10 (was SMA M7; fee-free, decision 137): from the R+O / Zhuhai Hongjiacheng 1N4001W-1N4007W datasheet Rev 2.0: cathode band (KiCad pin 1 cathode), VRRM 1000 V, IF(AV) 1 A, IFSM 30 A (8.3 ms), VF max 1.0 V at 1 A, IR max 2 uA at 25 C, CJ 18 pF typ; suggested pads J 1.00 min, M 1.50 min, K 1.90 max: KiCad D_SOD-123F has 1.1 x 1.1 mm pads 1.7 mm apart (pad width under the 1.5 mm suggestion; widen at layout); LCSC C18199088 JLC preferred, 3689199 in stock 2026-10-10; RoHS: maker's datasheet Rev 2.0 (RoHS-compliant, halogen-free) and LCSC C18199088 ROHS (checked 2026-10-10)
SX-R-066 | Resistor 330 Ohm 1% 0805 |  |  |  |  | Relay coil series resistor (12 V coil from +15 V)
SX-R-067 | Resistor 6.8 kOhm 1% 0805 |  |  |  |  | Relay drop-out reference
SX-R-068 | Resistor 115 kOhm 1% 0805 |  |  |  |  | Not used since 2026-10-10: master meter ladder and R732 on fee-free E24 values (decision 146); was: Master meter ladder
SX-R-069 | Resistor 13.3 kOhm 1% 0805 |  |  |  |  | Not used since 2026-10-10: master meter ladder and R732 on fee-free E24 values (decision 146); was: Master meter ladder
SX-R-070 | Resistor 31.6 kOhm 1% 0805 |  |  |  |  | Not used since 2026-10-10: master meter ladder and R732 on fee-free E24 values (decision 146); was: Master meter ladder
SX-R-071 | Resistor 22.6 kOhm 1% 0805 |  |  |  |  | Not used since 2026-10-10: master meter ladder and R732 on fee-free E24 values (decision 146); was: Master meter ladder
SX-R-072 | Resistor 16.2 kOhm 1% 0805 |  |  |  |  | Not used since 2026-10-10: master meter ladder and R732 on fee-free E24 values (decision 146); was: Master meter ladder
SX-R-073 | Resistor 11.3 kOhm 1% 0805 |  |  |  |  | Not used since 2026-10-10: master meter ladder and R732 on fee-free E24 values (decision 146); was: Master meter ladder
SX-R-074 | Resistor 8.06 kOhm 1% 0805 |  |  |  |  | Not used since 2026-10-10: master meter ladder and R732 on fee-free E24 values (decision 146); was: Master meter ladder
SX-R-075 | Resistor 5.62 kOhm 1% 0805 |  |  |  |  | Not used since 2026-10-10: master meter ladder and R732 on fee-free E24 values (decision 146); was: Master meter ladder
SX-R-076 | Resistor 5.11 kOhm 1% 0805 |  |  |  |  | Not used since 2026-10-10: master meter ladder and R732 on fee-free E24 values (decision 146); was: Master meter ladder
SX-R-077 | Resistor 3.83 kOhm 1% 0805 |  |  |  |  | Not used since 2026-10-10: master meter ladder and R732 on fee-free E24 values (decision 146); was: Master meter ladder
SX-R-078 | Resistor 2.15 kOhm 1% 0805 |  |  |  |  | Not used since 2026-10-10: master meter ladder and R732 on fee-free E24 values (decision 146); was: Master meter ladder
SX-R-079 | Resistor 1.87 kOhm 1% 0805 |  |  |  |  | Not used since 2026-10-10: master meter ladder and R732 on fee-free E24 values (decision 146); was: Master meter ladder
SX-R-080 | Resistor 866 Ohm 1% 0805 |  |  |  |  | Not used since 2026-10-10: master meter ladder and R732 on fee-free E24 values (decision 146); was: Master meter ladder
SX-R-081 | Resistor 51 Ohm 1% 0805 |  |  |  |  | Headphone amplifier series input (TI SLOS431B suggests 50 Ohm)
SX-R-082 | Resistor 39.2 Ohm 1% 2512 1 W |  |  |  |  | Headphone amplifier output resistor (TI SLOS431B 39.2 Ohm); 2512 for full level into 32 Ohm
SX-MECH-002 | Heatsink board-mount TO-220 vertical 25.4 mm | Wakefield Thermal | 637-10ABPE | Mouser | 567-637-10ABPE | Master HS901 (U901 LM317) and HS902 (U902 LM337), decision 174; 34.9 x 12.7 x 25.4 mm, black anodised aluminium, two wave-solderable pins on 25.4 mm centres, package width up to 15.9 mm; 12.67 C/W natural convection (6 W at 76 C rise), 5.8 C/W at 200 LFM (distributor listings of the Wakefield sheet: Newark 93K7986, DigiKey 3179566); live at the regulator tab; footprint at layout from the Wakefield drawing; Active at Mouser and DigiKey (Ciiva lists NRND: recheck before ordering); RoHS: Mouser 567-637-10ABPE RoHS Compliant (checked 2026-10-17)
SX-CONN-009 | (not used since decision 181) Crimp housing 1x10 2.54 mm KK 254 friction ramp | Molex | 22-01-3107 |  |  | Input-module cable both ends (decision 99); from distributor listings (Farnell/Heilind) - verify against Molex drawing; RoHS: Mouser 538-22-01-3107 RoHS Compliant (checked 2026-10-09)
SX-CONN-010 | (not used since decision 181) Crimp terminal KK 254 22-30 AWG tin | Molex | 08-50-0114 |  |  | For SX-CONN-009 (decision 99); Molex sheet (Farnell copy, 2013-11-08): series 2759, 22-30 AWG, insulation 1.57 mm max, the loose-bag packing of 08-50-0113; Mouser lifecycle End of Life (no Molex notice found, 2026-10-13). Replacements: 08-50-0113 (same tin terminal on a reel of 10000; current Molex sheet 2020-06-22 Active, 22-26 AWG only; Mouser 538-08-50-0113) or 08-55-0102 (selective gold, bag, 22-30 AWG, Active; Mouser 538-08-55-0102, about 0.10 EUR at 100); moot if the ready-made input cable SX-CONN-022 replaces the crimped one (master STATUS, For /system); RoHS: Mouser 538-08-50-0114 RoHS Compliant (checked 2026-10-09)
SX-IC-018 | Step-down converter 60 V 5 A HSOIC-8 PowerPAD | Texas Instruments | TPS54560DDAR | LCSC | C31966 | Power board buck and inverter (decision 100); pinout 1 BOOT 2 VIN 3 EN 4 RT/CLK 5 FB 6 COMP 7 GND 8 SW + pad (TI SLVSBN0C); KiCad symbol TPS54560BDDA; RoHS: Mouser 595-TPS54560DDAR RoHS Compliant (checked 2026-10-09)
SX-IC-019 | Hex Schmitt inverter SOIC-14 | Nexperia | 74HC14D,653 | LCSC | C5605 | Power board 400 kHz clock; JLC basic; RoHS: Mouser 771-74HC14D-T RoHS Compliant (checked 2026-10-09)
SX-IC-020 | 5 V 0.5 A regulator DPAK | STMicroelectronics | L78M05ABDT-TR | LCSC | C58069 | Power board clock supply; JLC basic; Vi max 35 V (ST DS0425); pinout 1 IN 2 GND (tab) 3 OUT from KiCad LM78M05_TO252: verify against DS0425 Figure 2; RoHS: Mouser 511-L78M05ABDT-TR RoHS Compliant By Exemption (checked 2026-10-09)
SX-Q-002 | P-channel MOSFET 60 V 25 mOhm PowerPAK SO-8L | Vishay | SQJ457EP-T1_GE3 | LCSC | C511548 | Power board reverse block and soft start; pins 1-3 S 4 G tab D (Vishay doc 76628); SOA about 2-3 A at 24 V for 10 ms; RoHS: Mouser 78-SQJ457EP-T1_GE3 RoHS Compliant (checked 2026-10-09)
SX-D-009 | TVS unidirectional 24 V standoff 600 W SMB |  | SMBJ24A | LCSC | C19077578 | Power board input; VBR 26.7-29.5 V; VC 38.9 V at 15.5 A (Littelfuse SMBJ datasheet); RoHS: LCSC C19077578 ROHS (hongjiacheng SMBJ24A; distributor field only; checked 2026-10-09)
SX-D-010 | Zener diode 12 V SOD-123 |  | BZT52C12 | LCSC | C19077410 | Power board soft-start gate clamp; RoHS: LCSC C19077410 ROHS (hongjiacheng BZT52C12; distributor field only; checked 2026-10-09)
SX-D-011 | LED green 0805 |  | KT-0805G | LCSC | C2297 | Master meter green segments (decision 162, 2026-10-13). JLC basic; also channel meter green segments (decision 119); RoHS: LCSC C2297 ROHS (checked 2026-10-09); SC SEND, DUCK, COMP BUS button LEDs (user's colour scheme 2026-10-09); master DUCK D204/D304, COMP BUS D205/D305, COMP ON D412, SC BUS D501 button LEDs (2026-10-10)
SX-D-012 | Schottky diode 40 V 5 A SMA (DO-214AC) | MDD | SS54 | LCSC | C22452 | Power board buck catch diode D201; JLC basic; package corrected from SMC to SMA 2026-10-11 (C22452 is the SMA part; decision 159). MDD SS52-SS5200 datasheet Rev 2024A4: 40 V, 5 A, VF 0.55 V at 5 A, IR 1 mA at 25 C and 50 mA at 100 C at rated voltage, RthJA 60 C/W on 5 x 5 cm copper, TJ max 125 C, suggested pads 1.68 x 1.52 mm, 3.93 mm apart; RoHS: MDD datasheet RoHS compliant mark; LCSC C22452 ROHS (checked 2026-10-11)
SX-D-013 | Schottky diode 100 V 5 A SMC | MDD | SS510C | LCSC | C19229 | Power board inverter catch diode; VF 0.85 V at 5 A (MDD datasheet); RoHS: LCSC C19229 ROHS (distributor field only; checked 2026-10-09)
SX-D-014 | Schottky diode 30 V 200 mA SOD-123 | hongjiacheng | BAT54W | LCSC | C7502705 | Master SC_ENV clamp to AGND D504 (decisions 97, 104); BAT54W since 2026-10-10 (fee-free, decision 137; was onsemi BAT54T1G C152458): from the R+O / Zhuhai Hongjiacheng BAT54W datasheet Rev 2.0: SOD-123, cathode band (KiCad pin 1 cathode), VRRM 30 V, IF(AV) 200 mA, VF max 320 mV at 1 mA, IR max 2.0 uA at 25 V and 25 C; Fig. 2 typical IR at 4 V about 0.1 uA at 25 C and 6 uA at 100 C (onsemi: 0.06 / 5 uA at 85 C); land pattern J 0.91 min, M 1.22 min, K 2.36 max (KiCad D_SOD-123 fits); LCSC C7502705 JLC preferred, 143316 in stock 2026-10-10; RoHS: maker's datasheet Rev 2.0 (RoHS-compliant, halogen-free) and LCSC C7502705 ROHS (checked 2026-10-10)
SX-D-015 | LED red 0805 | Foshan NationStar | NCD0805R1 | LCSC | C84256 | Master meter +12 and CLIP segments (decision 162, 2026-10-13). Channel meter clip segment (decision 119); JLC basic; Vf 1.6-2.6 V; RoHS: LCSC C84256 ROHS (checked 2026-10-09); MUTE button LED (user's colour scheme 2026-10-09); master MUTE D203/D303 button LEDs (2026-10-10)
SX-D-016 | LED yellow 0805 | Hubei KENTO | KT-0805Y | LCSC | C2296 | Master meter +3 to +9 segments and the five gain-reduction LEDs and the PFL-active LED D752 (decision 162, 2026-10-13; GR LEDs yellow confirmed by the user). Channel meter +3/+6 segments (decision 119); JLC basic; Vf 1.8-2.4 V; RoHS: LCSC C2296 ROHS (checked 2026-10-09); PFL button LED (user's colour scheme 2026-10-09); master SC LISTEN D503 button LED (2026-10-10)
SX-D-017 | LED white 0805 | Hubei KENTO | KT-0805W | LCSC | C34499 | Channel LOW-CUT and FILTER BYPASS button LEDs (user's colour scheme 2026-10-09); JLC basic; Vf 2.6-3.2 V (about 1 mA from +15 V through 12 k); RoHS: LCSC C34499 ROHS (checked 2026-10-09); master SC LPF BYPASS D502 button LED (2026-10-10)
SX-D-018 | Zener diode 11 V SOD-123 | hongjiacheng | BZT52C11 | LCSC | C19077409 | Channel cutoff summer clamp D184/D185 back to back (decision 165); hongjiacheng datasheet Rev 2.1: VZ 10.45-11.55 V at 5 mA, ZZT 20 ohm max at 5 mA, ZZK 150 ohm max at 1 mA, IR 0.1 uA max at 8 V, 350 mW, 357 C/W, SOD-123, cathode band (land pattern matches KiCad D_SOD-123); knee below 0.5 mA not specified (breadboard test); JLCPCB preferred (decision 137); RoHS: hongjiacheng datasheet Rev 2.1 (RoHS-compliant, halogen-free) and LCSC C19077409 ROHS (checked 2026-10-13)
SX-C-018 | Capacitor 4.7 uF X7S 100 V 1210 | Taiyo Yuden | HMK325C7475KMHPE | LCSC | C385986 | Power board converter input and output ceramics | C108 input filter (decision 187); loses much of its capacitance under DC bias; RoHS: Mouser 963-HMK325C7475KMHPE RoHS Compliant (checked 2026-10-09)
SX-C-019 | Capacitor 330 uF 35 V hybrid polymer 10x10.2 mm | Panasonic | EEHZK1V331P | LCSC | C278516 | Power board converter output and LC filter; ESR 20 mOhm; 2.8 A rms at 100 kHz (Panasonic ZK table); RoHS: Mouser 667-EEH-ZK1V331P RoHS Compliant (checked 2026-10-09)
SX-C-020 | Capacitor 100 uF 35 V electrolytic radial 6.3 mm | KNSCHA | KNM2100UF35V149EC0055 | LCSC | C2982822 | Power board LC filter damping; ESR 80 mOhm; ripple 1.516 A at 100 kHz (maker datasheet); radial footprint to verify; RoHS: LCSC C2982822 ROHS (distributor field only; checked 2026-10-09)
SX-C-021 | Capacitor 100 uF 50 V electrolytic SMD 8x10 mm |  |  |  |  | Not used since 2026-10-11: power C103 is a through-hole SX-C-028 (no fee-free SMD part; hand-soldered, decision 158); was: Power board input bulk after the soft-start FET
SX-C-022 | Capacitor 10 pF C0G 100 V 0805 |  |  |  |  | Not used since 2026-10-11: power C207/C307 are SX-C-029 (10 pF C0G 50 V 0603, JLC basic; decision 158); was: Power board sync coupling (TI SLVSBN0C 7.3.11)
SX-C-023 | Capacitor 10 uF 35 V bipolar electrolytic SMD 6.3x5.4 mm | Panasonic | EEE-1VA100NP | Mouser | 667-EEE-1VA100NP | Not used since decisions 161 (channel) and 172 (master): back-to-back SX-C-024 pairs; kept for reference; LCSC C336211 is listed but out of stock and extended (2026-10-11); VS series bi-polar, 85 C; Ø6.3 x 5.4 mm (Panasonic size D) per Mouser, element14 and TME; land pattern checked 2026-10-09: KiCad C_Elec_6.3x5.4 (gap 1.75, pads 3.325 x 1.6 mm) matches Panasonic's size-D pattern (gap 1.8, pads 3.2 x 1.6 mm, FK-series sheet) within 0.1 mm; not at LCSC (hand-solder or JLC global sourcing); KiCad Capacitor_SMD:C_Elec_6.3x5.4; RoHS: Mouser 667-EEE-1VA100NP RoHS Compliant (checked 2026-10-09); master C205, C206, C209, C210, C305, C306, C309, C310, C401, C402, C701, C702, C707-C710 (decision 127)
SX-C-024 | Capacitor 10 uF 35 V electrolytic SMD 5x5.4 mm | ROQANG | RVT1V100M0505 | LCSC | C72486 | Channel card regulator ADJ and output C503, C504, C508, C509, C512 (decision 111); audio coupling in back-to-back pairs C5+C21, C6+C22, C101+C108, C151+C158, C107+C109, C157+C159, C221+C235, C271+C285 (decision 161); -40 to 105 C, 2000 h; JLC extended; KiCad Capacitor_SMD:CP_Elec_5x5.4; RoHS: LCSC C72486 ROHS (distributor field only; checked 2026-10-09); master C755, C756, C903, C904, C908, C909, C912 (decision 127)
SX-C-025 | Capacitor 47 uF 35 V electrolytic SMD 6.3x5.4 mm | ROQANG | RVT1V470M0605 | LCSC | C72522 | Channel card regulator input C501, C506 (decision 111); -40 to 105 C, 2000 h, 54 mA ripple at 120 Hz; JLC extended; KiCad Capacitor_SMD:CP_Elec_6.3x5.4; RoHS: LCSC C72522 ROHS (distributor field only; checked 2026-10-09); master C901, C906 (decision 127)
SX-C-026 | Capacitor 47 nF C0G 5% 50 V 1206 | Murata | GRM31M5C1H473JA01L | LCSC | C21812 | Channel card 100 Hz low-cut C9-C12 (decision 113, replaces film SX-C-005); JLC extended; KiCad Capacitor_SMD:C_1206_3216Metric; RoHS: Mouser 81-GRM31M5C1H473JA01 RoHS Compliant; LCSC C21812 ROHS (checked 2026-10-09)
SX-C-027 | Capacitor 56 pF C0G 50 V 0805 |  |  |  |  | Channel trim stage feedback C7/C8 (decision 115)
SX-C-028 | Capacitor 100 uF 50 V electrolytic radial 8x11.5 mm P3.5 | Nichicon | UHE1H101MPD | LCSC | C116229 | Power board C103 input bulk on VIN_SW after the soft-start FET (decision 158); hand-soldered (decision 133); Nichicon UHE catalogue CAT.8100M: 8 x 11.5 mm, P 3.5 mm, lead 0.6 mm, impedance 0.17 Ohm max at 100 kHz 20 C, ripple 555 mA rms at 105 C 100 kHz, 7000 h at 105 C, -40 to +105 C; footprint Capacitor_THT:CP_Radial_D8.0mm_P3.50mm; about 0.12 EUR, 10131 at LCSC (2026-10-10); RoHS: Nichicon CAT.8100M (RoHS 2011/65/EU, (EU) 2015/863)
SX-C-029 | Capacitor 10 pF C0G 5% 50 V 0603 | Samsung Electro-Mechanics | CL10C100JB8NNNC | LCSC | C1634 | Power board sync coupling C207/C307 (TI SLVSBN0C 7.3.11; decision 158): C207 sees about 5 V, C307 bridges about 20-25 V (CLK_B from PGND to RT on the -20 V node), about 40 V at most if the inverter output ran away (VIN + |VO| limited to 60 V by the IC); JLC basic (decision 137); Samsung code: C = C0G, 100 = 10 pF, J = 5%, B = 50 V; RoHS: LCSC C1634 ROHS (checked 2026-10-11)
SX-L-001 | Inductor 2.2 uH shielded 7.3x6.6 mm | Bourns | SRP7028A-2R2M | LCSC | C1329579 | Power board LC filters: L202/L302 output | L101 input (decision 187); DCR 20 mOhm max; Isat 14 A; Irms 8 A (Bourns figures garbled in the PDF text; match the LCSC listing); RoHS: Mouser 652-SRP7028A-2R2M RoHS Compliant (checked 2026-10-09)
SX-L-002 | Inductor 15 uH shielded 13.5x12.5 mm | Bourns | SRP1265A-150M | LCSC | C189912 | Power board buck; Isat 12.5 A; Irms 9 A; DCR 28 mOhm max (Bourns datasheet); footprint syntsamix:L_Bourns_SRP1265A (Bourns recommended layout | REV. 06/24); RoHS: Mouser 652-SRP1265A-150M RoHS Compliant (checked 2026-10-09)
SX-L-003 | Inductor 22 uH shielded 13.5x12.5 mm | Bourns | SRP1265A-220M | LCSC | C2041465 | Power board inverter; Isat 12 A; Irms 9 A; DCR 37 mOhm max (Bourns datasheet); footprint syntsamix:L_Bourns_SRP1265A (Bourns recommended layout | REV. 06/24); RoHS: Mouser 652-SRP1265A-220M RoHS Compliant (checked 2026-10-09)
SX-F-001 | Resettable fuse 4 A hold 30 V 2920 | LUTE | 2920L400/30GR | LCSC | C19078761 | Power board input; 3.01 A hold at 50 C; trip 8 A (LUTE datasheet); RoHS: LCSC C19078761 ROHS (distributor field only; checked 2026-10-09)
SX-F-002 | Resettable fuse 2 A hold 33 V 1812 | BHFUSE | BSMD1812-200-33V | LCSC | C7433877 | Power board per-header fuses; 1.66 A hold at 50 C; trip 4 A; RoHS: LCSC C7433877 ROHS (distributor field only; checked 2026-10-09)
SX-R-083 | Resistor 243 kOhm 1% 0805 |  |  |  |  | Not used since 2026-10-10: power RT R204/R304 are 240k (SX-R-084; decision 156); was: TPS54560 RT (400 kHz)
SX-R-084 | Resistor 240 kOhm 1% 0805 |  |  |  |  | TPS54560 feedback (20.0 V with 10 k) and RT (405 kHz free-running; decision 156); no fee-free part (JLC extended)
SX-R-085 | Resistor 732 kOhm 1% 0805 |  |  |  |  | Not used since 2026-10-10: power UVLO top R201/R301 is 680k (SX-R-036; decision 156)
SX-R-086 | Resistor 42.2 kOhm 1% 0805 |  |  |  |  | Not used since 2026-10-10: power UVLO bottom R202/R302 is 39k (SX-R-104; decision 156)
SX-CONN-011 | (not used since decision 182) Power jack locking 4-pin DIN PCB right angle | Kycon | KPJX-4S | DigiKey |  | Power board brick input; 7.5 A per pin at 48 V (Kycon drawing); mates KPPX-4P / Mean Well R7B; footprint syntsamix:Kycon_KPJX-4S_Horizontal (Kycon drawing rev A13 | 2022-08-15; no panel thread or nut); RoHS: Mouser 806-KPJX-4S RoHS Compliant (checked 2026-10-09)
SX-CONN-012 | IDC socket 2x4 2.54 mm with strain relief | Wurth Elektronik | 61200823021 | Mouser | 710-61200823021 | Power chain sections (9 sockets per 8-card section) and the master ribbon (2) (not on a board; decision 175); 1 A per contact (Wurth datasheet); 28 AWG fit to verify (no gauge in the Wurth documents, 2026-10-13); Mouser 710-61200823021, 8113 in stock 2026-10-13; RoHS: Mouser 710-61200823021 RoHS Compliant (checked 2026-10-09)
SX-CONN-013 | (rejected) Jack 3.5 mm mono with tip switch vertical PCB threaded bushing | XKB Connection | PJ-301C | LCSC | C692433 | Channel CUTOFF CV input J181 (user choice 2026-10-09, pending /system: exception to decision 27); drawing X-PJ-301C rev A1 2025-06-26: body 10.10 mm PCB to shoulder, bushing 6.00 mm dia x 4.00 mm (thread not stated, M6x0.5 assumed), 3 slotted pins 0.6 x 2.5 mm in a triangle, pinout from the drawing's schematic (checked 2026-10-09): pin 1 sleeve, pin 3 tip, pin 2 tip-normalling switch (rests on the tip spring, opens on insertion), as the Thonkiconn convention; footprint pads named S (pin 1), T (pin 3), TN (pin 2) to match KiCad AudioJack2_SwitchT; no KiCad footprint (draw one; EasyEDA footprint at LCSC); LCSC only; RoHS: LCSC C692433 ROHS (checked 2026-10-09); REJECTED 2026-10-09: bushing unthreaded (no thread callout, no nut), so the jack would hang on its solder joints; replaced by SX-CONN-014
SX-CONN-014 | Jack 3.5 mm mono with tip switch vertical PCB M6x0.5 threaded bushing (Thonkiconn) | Qingpu | PJ398SM | Thonk |  | Channel CUTOFF CV input J181 (decision 118) and CV OUT J182 (decision 165); Thonk drawing PJ398SM: body 9 mm, bushing 6 mm dia x 5.5 mm, 4.5 mm threaded (brass, Ni), PBT housing; pinout 1 sleeve, 2 tip switch, 3 tip; 5,000 cycles; KiCad Connector_Audio:Jack_3.5mm_QingPu_WQP-PJ398SM_Vertical_CircularHoles (pads S/TN/T at 0/3.1/11.4 mm match the drawing); drill a 3 mm hole in the PCB under the barrel (Thonk note); about 0.38 GBP; RoHS: Thonk shop page 'All materials used are RoHS compliant' (supplier statement, checked 2026-10-09)
SX-CONN-015 | 6.3 mm stereo jack switched (T R S all switched) horizontal PCB M11x1.25 plastic nut | Rean | NYS216 | Mouser | 568-NYS216 | Replaces SX-CONN-001 on the input module and the master (decision 132). Footprint syntsamix:Jack_6.35mm_Rean_NYS216_Horizontal from the Rean drawing NYS216 (2015-05-27): 2 x 3 pins at 6.35 mm, rows 16.50 mm apart, 1.5 mm holes, panel cut-out 11.4 mm; pin roles inferred (not on the drawing), check with a meter on the first part. 1,000 mating cycles (Rean product page). $0.68 at 50 (Mouser, 2026-10-09). RoHS: Mouser 568-NYS216 RoHS Compliant, Active (checked 2026-10-09); Rean RoHS certificate on rean-connectors.com
SX-CONN-016 | Header JST XH 2-pin 2.5 mm vertical through-hole | JST | B2B-XH-A(LF)(SN) | LCSC | C158012 | Power board J102: rear-panel power rocker (SX-SW-003) on two wires; J103: panel power LED (SX-D-004, decision 168) on two wires (pre-crimped XH leads with an XHP-2 housing); hand-soldered (decision 133); KiCad Connector_JST:JST_XH_B2B-XH-A_1x02_P2.50mm_Vertical; 3 A 250 V (LCSC listing); RoHS: LCSC C158012 ROHS (checked 2026-10-10)
SX-CONN-017 | IDC box header 2x13 2.54 mm vertical shrouded keyed | Wurth Elektronik | 61202621621 | Mouser | 710-61202621621 | Master rear ribbons J603 (outputs) and J903 (inputs), and the mating header on each rear row board (decision 163); WR-BHD straight THT as SX-CONN-007; hand-soldered; Mouser about 0.94 EUR at 10+, 1210 in stock 2026-10-12; RoHS: Mouser 710-61202621621 RoHS Compliant (checked 2026-10-12)
SX-CONN-018 | IDC socket 2x13 2.54 mm with strain relief | Wurth Elektronik | 61202623021 | Mouser | 710-61202623021 | Rear row-board ribbon cables, two sockets per cable (decision 163; not on a board); 28 AWG fit to verify as SX-CONN-012; cable SX-WIRE-002; 2696 in stock 2026-10-12; RoHS: Mouser 710-61202623021 RoHS Compliant (checked 2026-10-12)
SX-CONN-019 | 6.3 mm stereo jack open frame panel mount (T R S) solder/faston tabs nickel | Rean | NYS230 | Mouser | 568-NYS230 | Master headphone jack J751 (decision 162): on the master top panel by its nut, wired by a short twisted cable to a header on the card; only T, R, S used (no switch contacts needed). Chosen by the user 2026-10-13. Panels up to 3.5 mm (distributor listings, Pacrad); depth behind the panel (about 30 mm assumed, decision 162) and pin roles not verified: no maker drawing found, check on a sample. $1.96 (Mouser, 2,187 in stock, 2026-10-13; NYS230-U at $1.51 is the same jack, other finish). RoHS: Mouser 568-NYS230 RoHS Compliant, Active (checked 2026-10-13)
SX-CONN-020 | Header 1x3 2.54 mm vertical friction lock (KK 254) | Molex | 22-27-2031 | Mouser | 538-22-27-2031 | Master J751: header for the cable to the panel PHONES jack SX-CONN-019 (decision 162; chosen by the user 2026-10-13); 1 T, 2 R, 3 S. Footprint Connector_Molex:Molex_KK-254_AE-6410-03A_1x03_P2.54mm_Vertical (22-27-2031 = AE-6410-03A, as 22-27-2101 = AE-6410-10A for SX-CONN-002). $0.23 (Mouser, 78k in stock, 2026-10-13). Hand-soldered (decision 133); the cable is SX-CONN-021. RoHS: Mouser 538-22-27-2031 RoHS Compliant, Active (checked 2026-10-13)
SX-CONN-021 | Cable assembly KK 254 1x3 receptacle to free ends 150 mm 22 AWG discrete | Molex | 217797-1031 | Mouser | 538-217797-1031 | PHONES jack cable: housing end on J751 (SX-CONN-020), free ends soldered to the NYS230 tabs (SX-CONN-019); ready-made so nothing is crimped by hand (user, 2026-10-13). Series facts from the Molex sheet of sibling 217796-1052 (22 AWG UL 11028, tin-plated brass, mates 6410 headers); pin order on the free end to check with a meter. $2.45 (Mouser, 98 in stock, 2026-10-13); 300 mm 217797-1032 ($2.64, 1,070 in stock) if stock runs out. RoHS: Mouser 538-217797-1031 RoHS Compliant, Active (checked 2026-10-13)
SX-CONN-022 | (not used since decision 181) Cable assembly KK 254 1x10 receptacle both ends 150 mm 22 AWG discrete | Molex | 217796-1101 | Mouser | 538-217796-1101 | Input-module cable, ready-made instead of the hand-crimped SX-CONN-009/010 (decision 179; 1:1 wiring to check on the Molex sales drawing or with a meter on delivery). Series facts from the Molex sheet of sibling 217796-1052 (22 AWG UL 11028, tin-plated brass, mates 6410 headers); 1:1 wiring to check on the Molex sales drawing; hot/cold pairs twisted by hand. $5.63, $4.65 at 25+ (Mouser, 749 in stock, 2026-10-13); cost watch, ROADMAP Cost-cut candidates item 8. RoHS: Mouser 538-217796-1101 RoHS Compliant, Active (checked 2026-10-13)
SX-SW-003 | Rocker switch SPST snap-in black O/- marking 4.8 mm tabs | Legion | SS11-BBIWG-R20-R | LCSC | C309069 | Power switch on the rear panel, wired to power board J102 (SX-CONN-016; decision 157); switches gate current only (about 0.12 mA at up to 24.7 V DC). Legion drawing WIF120070 rev A4 (LCSC-hosted PDF): panel cutout 19.2 x 12.9 mm for 0.8-1.2 mm panel, 19.4 for 1.3-2.0, 19.8 for 2.1-2.5; 4.8 x 0.8 mm quick-connect tabs with hole, lead-wire soldering 350 C for 3 s max (SPEC-011 p5); 16 A 125/250 VAC (UL); contact resistance 50 mOhm max at 0.2 V DC 1 A; no DC rating, minimum load or contact material stated (bench check at gate current); RoHS: Legion drawing WIF120070 note 4 (all materials RoHS); about 0.32 EUR, 2926 at LCSC (2026-10-10)
SX-MECH-003 | DC power brick 24 V 120 W Class II R7B plug | Mean Well | GSM120B24-R7B | TME | GSM120B24-R7B | Prototype supply (decision 100); C8 inlet needs a C7 mains cord; SX-MECH-005 GSM220B24-R7B for 16 cards (decision 145); RoHS: Mouser 709-GSM120B24-R7B RoHS Compliant (checked 2026-10-09)
SX-MECH-004 | Washer M6 1.0 mm thick, 3D-printed |  |  |  |  | Spacer under the panel for the Thonkiconn J181 (9 mm body to the 10 mm panel gap; sits on the 1 mm unthreaded bushing collar); printed in-house with the button caps and meter bezel (user, 2026-10-09): inner diameter about 6.2 mm, outer about 9 mm, 1.0 mm thick; not an electrical component (outside RoHS scope)
SX-MECH-005 | DC power brick 24 V 221 W Class II R7B plug | Mean Well | GSM220B24-R7B | TME | GSM220B24-R7B | Full-size supply, 16 cards (decision 145); Mean Well GSM220B-SPEC 2026-05-09: IEC 320-C8 inlet (needs a C7 mains cord), I/P-O/P 4 kVAC 2xMOPP, no FG at the output, 24 V +-3 %, 9.2 A, 120 mVp-p, R7B plug = Kycon KPPX-4P equivalent, pins 1 and 4 +V, 2 and 3 -V (as SX-MECH-003); RoHS: Mouser 709-GSM220B24-R7B RoHS Compliant (checked 2026-10-10)
SX-IC-021 | Dual op amp 36 V input range to V- rail-to-rail output SOIC-8 | Texas Instruments | OPA2171AIDR | LCSC | C40904 | Channel fader buffer and control summer (decision 102); master U206, U306, U705 (decision 103); from TI SBOS516H: pinout 1 OUT A 2 -IN A 3 +IN A 4 V- 5 +IN B 6 -IN B 7 OUT B 8 V+ (as TL072), VCM (V-) - 0.1 V to (V+) - 2 V, no phase reversal, back-to-back diodes across the inputs (not for superdiodes or comparators), IQ 0.475 / 0.595 mA per amplifier; KiCad symbol Amplifier_Operational:Opamp_Dual; JLC extended; RoHS: Mouser 595-OPA2171AIDR RoHS Compliant (checked 2026-10-09)
SX-IC-022 | Adjustable positive regulator D2PAK | onsemi | LM317D2TR4G | LCSC | C12848 | Channel card U501 (decision 110); pinout 1 ADJ 2 VOUT 3 VIN, tab = pin 2 (onsemi LM317 Rev. 13); TJ 0 to 125 C; D2PAK RthJA 70 C/W minimum pad, about 36-45 C/W on 10-20 mm square of 2 oz copper (onsemi LM337 Rev. 11 Fig. 19, same case 936); KiCad Regulator_Linear:LM317_TO-263, Package_TO_SOT_SMD:TO-263-2; JLC extended; also at Mouser and TME; RoHS: Mouser 863-LM317D2TR4G RoHS Compliant By Exemption; LCSC C12848 ROHS (checked 2026-10-09)
SX-IC-023 | Adjustable negative regulator D2PAK | onsemi | LM337D2TR4G | LCSC | C232416 | Channel card U502 (decision 110); pinout 1 ADJ 2 VIN 3 VOUT, tab = pin 2 (onsemi LM337 Rev. 11); TJ 0 to 125 C; RthJA 70 C/W minimum pad, RthJC 5 C/W, Fig. 19 for copper area; KiCad Regulator_Linear:LM337_TO263, Package_TO_SOT_SMD:TO-263-2; JLC extended; also at Mouser and TME; RoHS: Mouser 863-LM337D2TR4G RoHS Compliant By Exemption; LCSC C232416 ROHS (checked 2026-10-09)
SX-IC-024 | Dual low-power JFET op amp SOIC-8 | Texas Instruments | TL062CDR | LCSC | C67471 | Channel meter U401 (inverters) and U404 (hold follower), decision 123; from TI SLOS078N (Aug 2023): pinout as TL072, VICR +-11 V min (-12 to +15 V typ), VOM +-10 V min into 10 k (+-13.5 V typ), ICC 0.2 / 0.25 mA per amplifier, 3.5 V/us, 1 MHz; not for superdiodes, comparators or heavy loads; KiCad symbol Amplifier_Operational:TL062; JLC extended; RoHS: LCSC C67471 ROHS (checked 2026-10-09); master U409, U410, U802, U804 since decision 126
SX-IC-025 | Balanced line driver +6 dB SOIC-8 | Texas Instruments | DRV135UA/2K5 | LCSC | C544663 | Main outputs U703, U704 (decision 125, replaces SX-IC-014); from TI SBOS094B: pinout 1 -Vo 2 -Sense 3 Gnd 4 Vin 5 V- 6 V+ 7 +Sense 8 +Vo (as THAT1646S08), +6 dB, 10 kOhm input, 50 Ohm outputs, swing (V+)-3 / (V-)+2 V, IQ 5.2 / 5.5 mA, 10 uF nonpolarised capacitor at each sense pin (Figure 29); symbol syntsamix:THAT1646 (same pins); JLC extended, 3.42 USD, 2322 in stock 2026-10-09; also Mouser 595-DRV135UA; RoHS: TI package addendum (10-Nov-2025) RoHS Yes; LCSC C544663 ROHS (checked 2026-10-09); hand-soldered by the user on the prototype master (decision 150)
SX-R-087 | Resistor 30.1 kOhm 1% 0805 |  |  |  |  | Not used since 2026-10-10: channel R217 and master R232/R332 are 30k SX-R-050 (decision 153); was: SC_ENV into the control summer's virtual earth (decision 97)
SX-R-088 | Resistor 806 Ohm 1% 0805 |  |  |  |  | Not used since 2026-10-10: channel values moved to E24 (decision 140); Channel trim stage fixed feedback R7/R8 (decision 115)
SX-R-089 | Resistor 820 Ohm 1% linear PTC thin film +4110 ppm/K 0603 | Vishay | TFPT0603L8200FV | Mouser | 71-TFPT0603L8200FV | Not used since 2026-10-10: temperature compensation in the backlog (decision 141). Channel tempco leg R108/R158 with SX-R-090 in series: 1 k at about +3370 ppm/K (decision 130); place against the SSI2144; TCR +4110 ppm/K +/-400 at 25 C, 75 mW at 70 C, 30 V max (Vishay TFPT datasheet doc. 33017 rev. 15-Apr-2026); 1379 in stock at Mouser, about 0.96 EUR (2026-10-09); RoHS: Vishay TFPT datasheet RoHS compliant mark; Mouser RoHS Compliant By Exemption (2026-10-09)
SX-R-090 | Resistor 180 Ohm 1% 0805 |  |  |  |  | Channel tempco leg R122/R172, low-tempco part in series with SX-R-089 (decision 130)
SX-R-091 | Resistor 6.2 kOhm 1% 0805 |  |  |  |  | Compressor release range (slow end): R425 under RELEASE RV402 100k (decision 131)
SX-POT-014 | Pot 100 kOhm reverse-audio (C) single 9 mm vertical T18 knurled 15 mm | Alpha | RD901F-40-15K-C100K | Tayda | A-5370 | Compressor RELEASE RV402 (decision 131); footprint Alpha RD901F-40-00D; Tayda A-5370 from the 2026-10-09 listing check (same SKU run as A-5369 C10K), recheck the page by hand before ordering (Tayda answers 403 to scripts); Thonk has no C taper (2026-10-09); Alpha spec RD901F-(C) (Tayda copy SP26020021): 1 k to 500 k, tolerance +/-20 %, 0.05 W B taper / 0.02 W other tapers, hand solder only; dissipation here about 2.1 mW (15.1 V across 106 kOhm); RoHS: Taiwan Alpha RoHS II declaration 2020-10-26, all standard models, received via Thonk 2026-10-09; local copy docs/rohs/ (not published); buy genuine Alpha (decision 124)
SX-POT-015 | Dual pot 100 kOhm linear (B) 9 mm vertical T18 knurled 15 mm | Alpha | RD902F-40-15K-B100K-0057 | Thonk |  | SC LPF RV501 (decision 138); Thonk Alpha 9 mm vertical T18 dual gang B100K, 1.99 GBP excl. VAT, in stock 2026-10-10 (https://www.thonk.co.uk/shop/alpha-9mm-pots-vert-t18-dual-gang/); order code by analogy with Thonk's A10K/A100K codes from Thonk support (SX-POT-011, -013), confirm with the order; footprint Alpha RD902F-40-00D; bushing M7x0.75 x 5 mm as the Thonk dual family; B taper rated 0.05 W (RD901F spec; RD902F dual rating not yet read), dissipation here audio only, well under 1 mW; RoHS: Taiwan Alpha RoHS II declaration 2020-10-26, all standard models (2011/65/EU with 2015/863, ten substances), received via Thonk 2026-10-09; local copy docs/rohs/ (not published); buy genuine Alpha (decision 124)
SX-R-092 | Resistor 18 kOhm 1% 0805 | UNI-ROYAL | 0805W8F1802T5E | LCSC | C17506 | Channel hot attenuator R104/R154 and Q feedback R117/R119/R167/R169 (decision 140); JLC preferred (decision 137); RoHS: LCSC C17506 ROHS (UNI-ROYAL suffix E = lead-free; checked 2026-10-10)
SX-R-093 | Resistor 51 kOhm 1% 0805 | UNI-ROYAL | 0805W8F5102T5E | LCSC | C17737 | Channel half compensation R118/R168 (decision 140); JLC basic (decision 137); RoHS: LCSC C17737 ROHS (UNI-ROYAL suffix E = lead-free; checked 2026-10-10); compressor R456 (decision 147)
SX-R-094 | Resistor 560 Ohm 1% 0805 | UNI-ROYAL | 0805W8F5600T5E | LCSC | C28636 | Channel Q VCA input divider R115/R116/R165/R166, the SSI2144 datasheet value (decision 140); JLC basic (decision 137); RoHS: LCSC C28636 ROHS (UNI-ROYAL suffix E = lead-free; checked 2026-10-10)
SX-R-095 | Resistor 9.1 kOhm 1% 0805 | UNI-ROYAL | 0805W8F9101T5E | LCSC | C17855 | Channel filter output scale R111/R161 (provisional) and fader law R214 (decision 140), master fader laws R229/R329/R721 (decision 144); JLC preferred (decision 137); RoHS: LCSC C17855 ROHS (UNI-ROYAL suffix E = lead-free; checked 2026-10-10)
SX-R-096 | Resistor 300 kOhm 1% 0805 | UNI-ROYAL | 0805W8F3003T5E | LCSC | C17616 | Channel fader law R208 (decision 140; R181 was 300k until decision 165), master fader-law pairs R223/R323/R715 (decision 144); JLC preferred (decision 137); RoHS: LCSC C17616 ROHS (UNI-ROYAL suffix E = lead-free; checked 2026-10-10)
SX-R-097 | Resistor 36 kOhm 1% 0805 | UNI-ROYAL | 0805W8F3602T5E | LCSC | C4360 | Channel Q current limit R120/R170 (provisional; decision 140); JLC preferred (decision 137); RoHS: LCSC C4360 ROHS (UNI-ROYAL suffix E = lead-free; checked 2026-10-10)
SX-R-098 | Resistor 150 kOhm 1% 0805 | UNI-ROYAL | 0805W8F1503T5E | LCSC | C17470 | Channel V/oct feedback R183 (with R187 12k) and fader law R224 (decision 140), master fader-law pairs R243/R343/R735 (decision 144); JLC basic (decision 137); RoHS: LCSC C17470 ROHS (UNI-ROYAL suffix E = lead-free; checked 2026-10-10)
SX-R-099 | Resistor 3.9 kOhm 1% 0805 | UNI-ROYAL | 0805W8F3901T5E | LCSC | C17614 | Channel trim stage R5/R6 and meter ladder R412 (decision 140); JLC basic (decision 137); RoHS: LCSC C17614 ROHS (UNI-ROYAL suffix E = lead-free; checked 2026-10-10)
SX-R-100 | Resistor 820 Ohm 1% 0805 | UNI-ROYAL | 0805W8F8200T5E | LCSC | C17837 | Channel trim stage R7/R8 (decision 140) and FREQ leg R108/R158 (decision 141); JLC preferred (decision 137); RoHS: LCSC C17837 ROHS (UNI-ROYAL suffix E = lead-free; checked 2026-10-10)
SX-R-101 | Resistor 1.8 kOhm 1% 0805 | UNI-ROYAL | 0805W8F1801T5E | LCSC | C17398 | Channel soft-clip branch R9/R10 and meter ladder R415 (decision 140); JLC preferred (decision 137); RoHS: LCSC C17398 ROHS (UNI-ROYAL suffix E = lead-free; checked 2026-10-10); master meter ladder R812 (decision 146)
SX-R-102 | Resistor 62 kOhm 1% 0805 | UNI-ROYAL | 0805W8F6202T5E | LCSC | C17783 | Channel fader law R211 (decision 140), master fader laws R226/R326/R718 (decision 144); JLC preferred (decision 137); RoHS: LCSC C17783 ROHS (UNI-ROYAL suffix E = lead-free; checked 2026-10-10)
SX-R-103 | Resistor 220 kOhm 1% 0805 | UNI-ROYAL | 0805W8F2203T5E | LCSC | C17556 | Channel fader law R210 (decision 140), master fader laws R225/R325/R717 (decision 144); JLC basic (decision 137); RoHS: LCSC C17556 ROHS (UNI-ROYAL suffix E = lead-free; checked 2026-10-10)
SX-R-104 | Resistor 39 kOhm 1% 0805 | UNI-ROYAL | 0805W8F3902T5E | LCSC | C25826 | Channel meter ladder R410 (decision 140); power UVLO bottom R202/R302 (decision 156); JLC preferred (decision 137); RoHS: LCSC C25826 ROHS (UNI-ROYAL suffix E = lead-free; checked 2026-10-10)
SX-R-105 | Resistor 8.2 kOhm 1% 0805 | UNI-ROYAL | 0805W8F8201T5E | LCSC | C17828 | Channel meter ladder R411 (decision 140); JLC basic (decision 137); RoHS: LCSC C17828 ROHS (UNI-ROYAL suffix E = lead-free; checked 2026-10-10)
SX-R-106 | Resistor 220 Ohm 1% 0805 | UNI-ROYAL | 0805W8F2200T5E | LCSC | C17557 | Channel meter ladder R418 (decision 140); JLC basic (decision 137); RoHS: LCSC C17557 ROHS (UNI-ROYAL suffix E = lead-free; checked 2026-10-10)
SX-R-107 | Resistor 10 kOhm 0.1% 25 ppm/K thin film 0805 | YAGEO | RT0805BRD0710KL | LCSC | C110775 | Channel input receiver R1-R4, R19-R26 (decision 143); master AUX return receivers R201-R204, R245-R252, R301-R304, R345-R352 (decision 148); JLC extended (no 0.1 % part is fee-free); RoHS: LCSC C110775 ROHS (checked 2026-10-10)
SX-R-108 | Resistor 2.4 kOhm 1% 0805 | UNI-ROYAL | 0805W8F2401T5E | LCSC | C17526 | Master meter ladder R815 (decision 146); JLC basic; RoHS: LCSC C17526 ROHS (UNI-ROYAL suffix E = lead-free; checked 2026-10-10)
SX-R-109 | Resistor 1.2 kOhm 1% 0805 | UNI-ROYAL | 0805W8F1201T5E | LCSC | C17379 | Master meter ladder R817 (decision 146); JLC basic; RoHS: LCSC C17379 ROHS (UNI-ROYAL suffix E = lead-free; checked 2026-10-10)
SX-R-110 | Resistor 510 Ohm 1% 0805 | UNI-ROYAL | 0805W8F5100T5E | LCSC | C17734 | Master meter ladder R820 (decision 146); JLC basic; RoHS: LCSC C17734 ROHS (UNI-ROYAL suffix E = lead-free; checked 2026-10-10)
SX-R-111 | Resistor 300 Ohm 1% 0805 | UNI-ROYAL | 0805W8F3000T5E | LCSC | C17617 | Master meter ladder R821 (decision 146); JLC basic; RoHS: LCSC C17617 ROHS (UNI-ROYAL suffix E = lead-free; checked 2026-10-10)
SX-R-112 | Resistor 270 Ohm 1% 0805 | UNI-ROYAL | 0805W8F2700T5E | LCSC | C17590 | Master meter ladder R822 (decision 146); JLC preferred; RoHS: LCSC C17590 ROHS (UNI-ROYAL suffix E = lead-free; checked 2026-10-10)
SX-R-113 | Resistor 4.3 kOhm 1% 0805 | UNI-ROYAL | 0805W8F4301T5E | LCSC | C17667 | Compressor gain-reduction LED ladder R445 (decision 147); JLC preferred; RoHS: LCSC C17667 ROHS (UNI-ROYAL suffix E = lead-free; checked 2026-10-10)
SX-R-114 | Resistor 510 kOhm 1% 0805 | UNI-ROYAL | 0805W8F5103T5E | LCSC | C17733 | Compressor log reference R420 with R456 51k = 561k (decision 147); JLC preferred; RoHS: LCSC C17733 ROHS (UNI-ROYAL suffix E = lead-free; checked 2026-10-10)
SX-R-115 | Resistor 120 kOhm 1% 0805 | UNI-ROYAL | 0805W8F1203T5E | LCSC | C17436 | Compressor AMOUNT top R426 with R457 20k = 140k (decision 147); JLC preferred; RoHS: LCSC C17436 ROHS (UNI-ROYAL suffix E = lead-free; checked 2026-10-10)
SX-R-116 | Resistor 200 kOhm 1% 0805 | UNI-ROYAL | 0805W8F2003T5E | LCSC | C17539 | Channel CUTOFF pot leg R181 (with R188 100k = 300k; decision 165); JLC basic (decision 137); RoHS: LCSC C17539 ROHS (UNI-ROYAL suffix E = lead-free; checked 2026-10-13)
SX-MECH-006 | LED clip and ring 3 mm (T-1) panel mount, black nylon | Bivar | CR-104 | Mouser | 749-CR-104 | Power LED SX-D-004 in the power bay's top strip (decision 168). Bivar drawing CR-104 rev E (2016-05-28): C-104 clip and R-104 ring, panel 0.8-3.2 mm (1.6 mm FR4 fits), panel hole 0.176 in +0.004/-0.002 (4.47 mm +0.10/-0.05), clip flange 5.3 mm, ring 6.1 mm, nylon 6/6 UL94 V-0; EUR 0.189 at 1 (Mouser 2026-10-13, 3599 in stock); not an electrical component; RoHS: Mouser 749-CR-104 RoHS Compliant (checked 2026-10-13)
SX-CONN-023 | IDC socket 2x17 2.54 mm with strain relief | Wurth Elektronik | 61203423021 | Mouser | 710-61203423021 | Audio chain cable sections, 10 sockets per 8-card section (docs/CHAIN.md, decision 175; not on a board); mates SX-CONN-007; Wurth datasheet MPI 002.000 2022-08-30: 34 pins, 1 A per contact, 250 V AC working, -40 to +105 C, 30 mating cycles; strain relief a separate piece in the pack (Wurth WR-BHD catalog 2009); no wire gauge in the Wurth documents, 28 AWG flat cable from the DigiKey attribute only: check from a datasheet or choose a rated cable (decision 175); about 0.94 EUR at 30, 3364 in stock 2026-10-13; RoHS: Wurth datasheet 'RoHS Approval Compliant [2011/65/EU&2015/863]', Mouser RoHS Compliant (checked 2026-10-13)
SX-WIRE-001 | Flat cable 34-way 1.27 mm 28 AWG stranded grey PVC | 3M | 3365/34 | Mouser | 517-3365/34FT | Not used since decision 178 (no current rating; chain cable is SX-WIRE-004); was for the audio chain sections; sold by the foot (3365/34-CUT-LENGTH), about 0.91 EUR/ft, 529 in stock 2026-10-13; 100 ft roll 517-3365/34; 3M TS-0080: 28 AWG 7x36 tinned copper, 300 V (UL 2651), -20 to +105 C, current rating not stated; RoHS: Mouser RoHS Compliant (3M sheet silent; checked 2026-10-13)
SX-WIRE-002 | Flat cable 26-way 1.27 mm 28 AWG stranded grey PVC | 3M | 3365/26 | Mouser | 517-3365/26FT | Master rear row-board ribbons J603 and J903 (decision 163) with SX-CONN-018; by the foot, about 0.66 EUR/ft, 4034 in stock 2026-10-13; specs as SX-WIRE-001; RoHS: Mouser RoHS Compliant (checked 2026-10-13)
SX-WIRE-004 | Flat cable 34-way 1.27 mm 28 AWG stranded grey PVC 1 m cut | Wurth Elektronik | 63913415521CAB | Mouser | 710-63913415521CAB | Audio chain cable sections (decisions 175, 178), 1 m per section; Wurth datasheet 63913415521 AnMa 002.005 2026-08-21 (CAB 002.004): 28 AWG 7x0.13 mm tinned copper, 1 A max at 25 C (derate above), 300 V, -25 to +105 C, UL AWM 2651 VW-1, 237 ohm/km max; reel 63913415521 (76.2 m); Mouser 55 in stock 2026-10-17; RoHS: Wurth datasheet p.2 Compliant [2011/65/EU & 2015/863]
SX-WIRE-005 | Flat cable 8-way 1.27 mm 28 AWG stranded grey PVC 1 m cut | Wurth Elektronik | 63910815521CAB | Mouser | 710-63910815521CAB | Power chain sections and the master power ribbon (decisions 175, 178) with SX-CONN-012, a true 8-way; Wurth datasheet 63910815521 AnMa 002.005 2026-08-21: as SX-WIRE-004; Mouser 342 in stock 2026-10-17 (reel none); RoHS: Wurth datasheet p.2 Compliant [2011/65/EU & 2015/863]
SX-WIRE-003 | Flat cable 10-way 1.27 mm 28 AWG stranded grey PVC (split to 8-way) | 3M | 3365/10 | Mouser | 517-3365/10FT | Not used since decision 178 (no current rating; power chain cable is SX-WIRE-005); was for the power sections, peeled to 8-way; by the foot, about 0.26 EUR/ft, 4485 in stock 2026-10-13 (a true 8-way 3365/08 exists only as a 100 ft roll, Mouser 517-3365/08100, about 33 EUR); specs as SX-WIRE-001; current per conductor not stated by 3M: CHAIN.md needs at least 1 A per contact, to verify; RoHS: Mouser RoHS Compliant (checked 2026-10-13)
SX-CONN-024 | Box header 2x6 2.54 mm shrouded straight through-hole no latches | Adam Tech | BHR-12-VUA | Mouser | 737-BHR-12-VUA | Input header on the channel card and the input module (decision 181; docs/INPUT-MODULE.md); Adam Tech drawing BHR-XX-VUA rev - 11/16/04: pin 1 bottom left, odd pins on the key-slot row, holes 1.02 mm, outer 22.86 x 8.80 mm, inner about 20.32 x 6.35 mm (inferred), 9.10 mm tall, key slot 4.50 mm centred; 3 A 250 V AC; EUR 0.445 at 10+, 0.354 at 100 (Mouser 2026-10-18); RoHS: Adam Tech drawing 'Lead free, RoHS compliant' (checked 2026-10-18); channel card J1 drawn on KiCad Connector_IDC:IDC-Header_2x06_P2.54mm_Vertical (2026-10-19: body 22.9 mm long, 10.4 mm wide outline, drill 1.0 mm, key on the odd-pin side); input module J3 on the same footprint (2026-10-19)
SX-CONN-025 | IDC socket 2x6 2.54 mm for 1.27 mm flat cable | Adam Tech | FCS-12-SG | Mouser | 737-FCS-12-SG | Input cable, one at each end (decision 181; off-board); Adam Tech drawing FCS-XX-SG rev F 4/13/16: no strain relief, width 6.00 mm (7.00 with the 0.90 mm key bump), bump 3.80 mm centred; 1 A 250 V AC; cable pitch and gauge not stated on the drawing: press a test cable with SX-WIRE-006 first; EUR 0.323 at 10+, 0.266 at 100 (Mouser 2026-10-18); RoHS: Adam Tech drawing 'Lead free, RoHS compliant' (checked 2026-10-18)
SX-WIRE-006 | Flat cable 12-way 1.27 mm 28 AWG stranded grey PVC 1 m cut | Wurth Elektronik | 63911215521CAB | Mouser | 710-63911215521CAB | Input cable, 150 mm per channel, six per 1 m cut (decision 181); Wurth datasheet AnMa 002.004 2026-08-21: 28 AWG 7x0.13 mm tinned copper, red first conductor, 1 A max, 300 V RMS, -25 to +105 C, UL 2651; EUR 2.34 at 1, 1.94 at 10 per 1 m (Mouser 2026-10-18); RoHS: Wurth datasheet Compliant [2011/65/EU & 2015/863] (checked 2026-10-18)
SX-IC-026 | Dual 4-channel CMOS analog multiplexer SOIC-16 | Texas Instruments | CD4052BM96 | LCSC | C6521 | Channel U302 (bus assign), U303 (PFL), U304 (SC send), decision 183; from TI SCHS047O (May 2026): pinout 1 Y0 2 Y2 3 Y 4 Y3 5 Y1 6 INH 7 VEE 8 VSS 9 B 10 A 11 X3 12 X0 13 X 14 X1 15 X2 16 VDD; VDD - VEE abs max 20 V, inputs within VEE - 0.5 V to VDD + 0.5 V, DC input current +-10 mA; rON 470 / 1050 Ohm typ / max at 5 V, 180 / 400 at 10 V (25 C), 520 max at 85 C; delta rON 10 Ohm at 10 V; VIH 3.5 V min at VDD 5 V; IDD 60 uA max; on the card VDD +5 V, VSS AGND, VEE about -6.2 V (R505 + D507); KiCad symbol Analog_Switch:HEF4052BT (same 4052 pinout, switch pins passive), footprint SOIC-16 3.9 x 9.9 mm; JLC preferred (no fee); RoHS: LCSC C6521 ROHS (checked 2026-10-19)
SX-TRIM-002 | Trimmer 50 kOhm multiturn top adjust | BOCHEN (Chengdu Guosheng Tech) | 3296W-1-503 | LCSC | C118911 | Channel RV101, RV151 (OFFSET) and RV182 (V/OCT), decision 184, replaces SX-TRIM-001; BOCHEN 3296W approval sheet (LCSC datasheet b5e5c19d): 10 Ohm - 2 MOhm, +-10 %, +-250 ppm/K, 0.5 W at 70 C, 30 +-2 turns, -55 to +125 C, body 9.5 x 4.85 x 10 mm, pins 1-2-3 in line at 2.5 mm (Bourns 3296W outline, KiCad Potentiometer_Bourns_3296W_Vertical); the sheet numbers the pins but does not name the wiper: pin 2 as Bourns, check with a meter on delivery; hand-soldered (decision 133); RoHS: LCSC C118911 ROHS (checked 2026-10-19)
SX-CONN-026 | Header JST VH 4-pin 3.96 mm vertical through-hole | JST | B4P-VH(LF)(SN) | LCSC | C160317 | Power board J101: lead to the panel brick jack SX-CONN-027 (decision 182); hand-soldered (decision 133); KiCad Connector_JST:JST_VH_B4P-VH_1x04_P3.96mm_Vertical; 10 A with AWG 16, wire AWG 22-16, 250 V, -40 to +105 C, mated height 16.5 mm (JST VH datasheet eVH); RoHS: JST VH datasheet (RoHS2 compliance) and LCSC C160317 ROHS (checked 2026-10-19)
SX-CONN-027 | Power jack locking 4-pin DIN panel mount non-shielded | Kycon | KPJX-PM-4S | Mouser | 806-KPJX-PM-4S | Brick input on the power bay's rear strip (decision 182; not on a board), wired to J101 (SX-CONN-026); mates Kycon KPPX-4P and Mean Well R7B; flange 25.2 x 14.2 mm, two M2.5 self-tapping screws 19.0 mm apart from the front, length 6.6 mm + panel thickness, body 9.9 mm deep; 7.5 A per pin at 48 V DC, -40 to +75 C (Kycon drawing KPJX-PM-4S rev C2, 2026-01-08); 2.30 EUR (1), 9935 in stock at Mouser 2026-10-19; RoHS: Kycon drawing (RoHS compliant)
SX-CONN-028 | Housing JST VH 4-way receptacle | JST | VHR-4N | Mouser | 306-VHR-4N | J101 lead to the panel brick jack (decision 182; not on a board); with SX-CONN-029 contacts; JST VH datasheet eVH; RoHS: JST VH datasheet (RoHS2 compliance)
SX-CONN-029 | Crimp contact JST VH AWG 22-18 tin | JST | SVH-21T-P1.1 | Mouser | 306-SVH-21T-P1.1 | J101 lead, four per lead (decision 182; not on a board); 18 AWG wire, insulation 1.7-3.0 mm; JST VH datasheet eVH; RoHS: JST VH datasheet (RoHS2 compliance)
