plektra/syntsamix/simulation/filter/breadboard-bom.csv

Ref | Qty to order | Value | Spec | E24 substitute (hobby-shop stock) | Where | Notes
U1 | 3 | SSI2144 | Sound Semiconductor SSI2144SS-TU (QSOP-16 / SSOP-16 MO-137-AB 0.635 mm pitch) |  | Electrokit | 1 test + 1 for L/R tracking test + 1 spare
— | 2 | SSOP-16 to DIP-16 adapter | SparkFun BOB-13994 (0.635 mm pads; pin rows 0.5 in / 500 mil apart | measured on the board 2026-10-14; 2 boards per pack) |  | Electrokit if stocked; else Melopero or Mouser | The layout puts its pins in rows d and g (500 mil). Electrokit's own SOIC/TSSOP-16 adapter is 600 mil and does not fit
— | 1 | Pin header | 2.54 mm break-away male header 1x40 |  | Electrokit | For the adapters (2 x 8 pins each)
U2 | 3 | TL072 | Dual JFET op amp DIP-8 |  | Electrokit | 1 used + spares
R1 | 0 (kit) | 18 kΩ | 1% metal film 0.25 W | (E24; the card's R104. Was 17.4 kΩ) | Your 1/4 W metal film kit | Input attenuator: +4 dBu gives ±19.0 mV
R2, R4, R3 alt | 0 (kit) | 200 Ω | 1% metal film 0.25 W | (E24 value; not in the kit: R2 = 2 × 100 Ω in series, R4 and R3 alt 220 Ω) | Your 1/4 W metal film kit | R2 and R4 plus a spare to try as R3 (-6 dB; -5.6 dB with 220 Ω)
R3 | 0 (kit) | 330 Ω | 1% metal film 0.25 W | (E24 value) | Your 1/4 W metal film kit | Medium drive (-4 dB)
R6 | 0 (kit) | 33 kΩ | 1% metal film 0.25 W | (E24; was 33.2 kΩ) | Your 1/4 W metal film kit | Resonance test 2 (finds oscillation onset)
R6 final | 0 (kit) | 51 kΩ | 1% metal film 0.25 W | (E24; was 49.9 kΩ) | Your 1/4 W metal film kit | Resonance limit: about 294 µA
R7 | 0 (kit) | 510 Ω | 1% metal film 0.25 W | (E24; datasheet 499 Ω; not in the kit: 470 Ω) | Your 1/4 W metal film kit | Resonance input filter
R8 | 0 (kit) | 1 kΩ | 1% metal film 0.25 W | (E24 value) | Your 1/4 W metal film kit | Cutoff pin to ground
R9, R13 | 0 (kit) | 100 kΩ | 1% metal film 0.25 W | (E24 value) | Your 1/4 W metal film kit | Summer output and CV input
R10 | 0 (kit) | 470 kΩ | 1% metal film 0.25 W | (E24; the card's value. Was 499 kΩ) | Your 1/4 W metal film kit | Cutoff offset: about ±32 mV
R11 | 0 (kit) | 160 kΩ | 1% metal film 0.25 W | (E24; the card uses 150k + 12k; not in the kit: 150 kΩ with RV5 at about 42k) | Your 1/4 W metal film kit | Summer feedback (RV5 trims)
R12 | 0 (kit) | 300 kΩ | 1% metal film 0.25 W | (E24; the card's value. Was 301 kΩ; not in the kit: 2 × 150 kΩ in series) | Your 1/4 W metal film kit | Cutoff pot scaling
C1, C2, C3 | 4 | 6.8 nF | R82 film 10 % 5 mm (ordered: C0G 5 % sold out) |  | Electrokit | Ladder capacitors; placed diagonally for the 5 mm pitch
C4 | 2 | 560 pF | C0G/NP0 ceramic 5% |  | Electrokit | Ladder capacitor
C6 | 2 | 100 pF | C0G/NP0 ceramic 5% |  | Electrokit | Output stage
C8 | 2 | 10 nF | C0G ceramic or film |  | Electrokit | Resonance input filter
C9 | 2 | 3.3 nF | C0G/NP0 ceramic 5% |  | Electrokit | Optional
C10–C13 | 6 | 100 nF | X7R ceramic 50 V 2.54/5.08 mm |  | Electrokit | Rail decoupling
C5, C7 | 2 | 10 µF | Bipolar (non-polarised) electrolytic 25 V or more |  | Electrokit | Input and output coupling
C14, C15 | 2 | 10 µF | Electrolytic 25 V ø4×5 (ordered) |  | Electrokit | Bulk decoupling where the supply enters the rails (column 1)
RV1 | 1 | 10 kΩ lin | Panel potentiometer linear (B) |  | Electrokit | Cutoff
RV2 | 1 | 10 kΩ lin | PC16SH linear (ordered; reverse-audio not taken) |  | Electrokit | Resonance
RV3, RV4, RV5 | 3 | 50 kΩ | Multiturn trimmer with in-line pins (Bourns 3296W-1-503) |  | Electrokit | Output gain / cutoff offset / V per octave
— | 3 | 6.3 mm jack | Mono with switch, PCB pins (ordered); leads to tip and sleeve |  | Electrokit | IN / OUT / CV
— | 1 | Breadboard | 830 tie-point solderless breadboard |  | Electrokit
— | 1 | Jumper wires | Pre-cut breadboard jumper kit plus some flexible hook-up wire |  | Electrokit | Flying leads to pots and jacks
Supp | 2 | NE5532 | Dual low-noise op amp DIP-8 |  | Electrokit | Output stage noise comparison (test 6)
Supp | 4 | 1N4001 | Rectifier diode |  | Electrokit | Reverse-polarity protection: one from each rail to ground, cathode toward +15 V / anode toward −15 V
Supp | 4 | 4.7 nF | C0G ceramic 5% or polypropylene film 5% |  | Electrokit | Alternative ladder caps to shift the cutoff range up
Supp | 4 | 10 nF | C0G ceramic 5% or polypropylene film 5% |  | Electrokit | Alternative ladder caps to shift the cutoff range down
Supp | 2 | 390 pF | C0G ceramic 5% |  | Electrokit | C4 to go with 4.7 nF ladder caps (keep C4 about 1/12 of the others)
Supp | 2 | 820 pF | C0G ceramic 5% |  | Electrokit | C4 to go with 10 nF ladder caps
Supp | 2 each | 22 pF, 47 pF, 220 pF | C0G ceramic 5% |  | Electrokit | Op-amp stability tweaks
Supp | 10 | 100 nF | X7R ceramic 50 V |  | Electrokit | Extra decoupling
Supp | 4 | 10 µF | Electrolytic 35 V |  | Electrokit | Extra bulk decoupling
Supp | 2 | 10 µF | Bipolar electrolytic 25 V or more |  | Electrokit | Spare coupling caps
Supp | 2 | 50 kΩ | Multiturn trimmer in-line pins (Bourns 3296W-1-503) |  | Electrokit | Spares
Supp | 2 | 100 kΩ | Multiturn trimmer in-line pins (Bourns 3296W-1-104) |  | Electrokit | Wider trim range if needed
Supp | 1 | 10 kΩ lin | Panel potentiometer linear (B) |  | Electrokit | Spare
Supp | 1 pack | SSOP-16 to DIP-16 adapter | SparkFun BOB-13994 |  | Electrokit if stocked; else Melopero or Mouser | Extra pack for soldering mistakes
Supp | 1 | Solder wick | Desoldering braid 1.5–2 mm |  | Electrokit | Fixing bridges on the QSOP pins
Order 2 | 2 | LM13700N | Dual OTA DIP-16 (TI LM13700N) |  | Electrokit | Datasheet Figure 9 Q VCA test (resonance compensation, decision 71); 1 used + 1 spare
Order 2 | 10 | 1N4148 | Small-signal diode DO-35 |  | Electrokit | Q pot bias diodes (D1 and D2 in datasheet Figure 9) plus spares
Order 2 | 3 | 6.8 nF | Same film capacitor as the first order (41015666) |  | Electrokit | Second core for test 8 (L/R tracking) needs 3 more; first order had 4
Order 2 | 1 | Breadboard | 840 tie-point solderless breadboard (same as first order) |  | Electrokit | Room for the second core (test 8) and the LM13700 Q VCA (test 9)
Order 2 | 2 | TL072 | Dual JFET op amp DIP-8 |  | Electrokit | Test 10 fader law (Level sheet control circuit)
Order 2 | 3 | ProtoPCB EKB14 | Breadboard-pattern prototype PCB, 270 plated holes, 71 x 43 mm (Electrokit 41003657) |  | Electrokit | Soldered filter core (2026-10-20: the ladder capacitors' breadboard contacts were loose): adapter on female header sockets, C1-C4, C9, R7/C8, R1, R2, R4, R8 and decoupling; one for the test 8 second core, one spare
Order 2 | 3 | SSI2144 | Sound Semiconductor SSI2144SS-TU (Electrokit 41019301) |  | Electrokit | Chip 1 damaged, chip 2 faulty (2026-10-20); chip 3 plus these cover test 2 and test 8
Order 2 | 2 | 33 kΩ | 1% metal film (Electrokit 40811433) |  | Electrokit | R6 for test 2 and the test 10 mute check (the kit's 33k compartment held 19.2 kΩ parts)
Order 2 | 4 | 200 Ω | 1% metal film (Electrokit 40811220) |  | Electrokit | R2 and R4 on two cores (replace 2 × 100 Ω and 220 Ω)
Order 2 | 2 | 510 Ω | 1% metal film (Electrokit 40811251) |  | Electrokit | R7 (replaces 470 Ω)
Order 2 | 2 | 160 kΩ | 1% metal film (Electrokit 40811516) |  | Electrokit | R11 (replaces 150 kΩ)
Order 2 | 2 | 300 kΩ | 1% metal film (Electrokit 40811530) |  | Electrokit | R12 (replaces 2 × 150 kΩ)
Order 2 | 10 | Latching push switch | CW Industries GPBS850L DPDT 8.5x8.5 mm |  | Electrokit | Button switch for the channel cards (decision 75): test fit and feel, and print translucent cap prototypes
Order 2 | 2 | 10 V zener | BZX55C10V 0.5 W DO-35 (Electrokit 40310030) |  | Electrokit | Test 13 summer clamp (decision 165): no 11 V at Electrokit; brackets the card's BZT52C11 with the C12 pair
Order 2 | 2 | 12 V zener | BZX55C12V 0.5 W DO-35 (Electrokit 40310033) |  | Electrokit | Test 13 summer clamp: the other neighbour of C11
