plektra/syntsamix/simulation/sidechain/results.txt

Sidechain LPF (Sallen-Key, 22n/47n, 10k + 100k pot):
  CW (pot 0): -3 dB at 510 Hz, peak +0.02 dB
  75 % (25k): -3 dB at 146 Hz, peak +0.02 dB
  middle (50k): -3 dB at 85 Hz, peak +0.02 dB
  25 % (75k): -3 dB at 60 Hz, peak +0.02 dB
  CCW (pot 100k): -3 dB at 46 Hz, peak +0.02 dB
  CCW, track -20 % (80k): -3 dB at 57 Hz, peak +0.02 dB
  CCW, track +20 % (120k): -3 dB at 39 Hz, peak +0.02 dB

Ducker (THRESHOLD 0.6 V peak, DEPTH -4 V = 40 dB, 100 Hz kick burst of 30 ms at 0.1 s, load 18 x 30k = 1.67 kOhm)
  DECAY CCW: peak -3.91 V (39 dB), 90 % after 3.1 ms, half (20 dB) recovered 33 ms after the burst, most positive -0.0 mV
  DECAY CW: peak -4.00 V (40 dB), 90 % after 2.9 ms, half (20 dB) recovered 823 ms after the burst, most positive -0.0 mV
  signal 3 dB below threshold: SC_ENV peak -0.0 mV (no trigger)
  Eurorack gate 10 V for 100 ms: SC_ENV peak -3.91 V
