plektra/syntsamix/simulation/level/results.txt

Fader law (OPA2171 buffer and summer, TL072 superdiodes)
  position   VB (V)   gain (dB)   design (dB)   ducking at SC_ENV -1 V (dB)
    100 %      0.00       10.1        10       -10.10
     75 %     -3.75        0.0         0       -10.10
     53 %     -7.05       -9.6       -10       -10.10
     50 %     -7.50      -12.3         -       -10.10
     42 %     -8.70      -19.6       -20       -10.10
     19 %    -12.15      -41.4       -40       -10.10
     15 %    -12.75      -56.1         -       -10.10
     14 %    -12.90      -59.7       -60       -10.10
      0 %    -14.55     -100.2      -113       -10.10

Ducking attack, SC_ENV 0 -> -4 V at fader 75 %
  VC -0.002 V -> 1.331 V (-40.4 dB); 90 % after 23.0 ms
