plektra/syntsamix/hardware/power/power.kicad_pcb

## KiCad design hardware/power/power.kicad_pcb (2026-10-21)

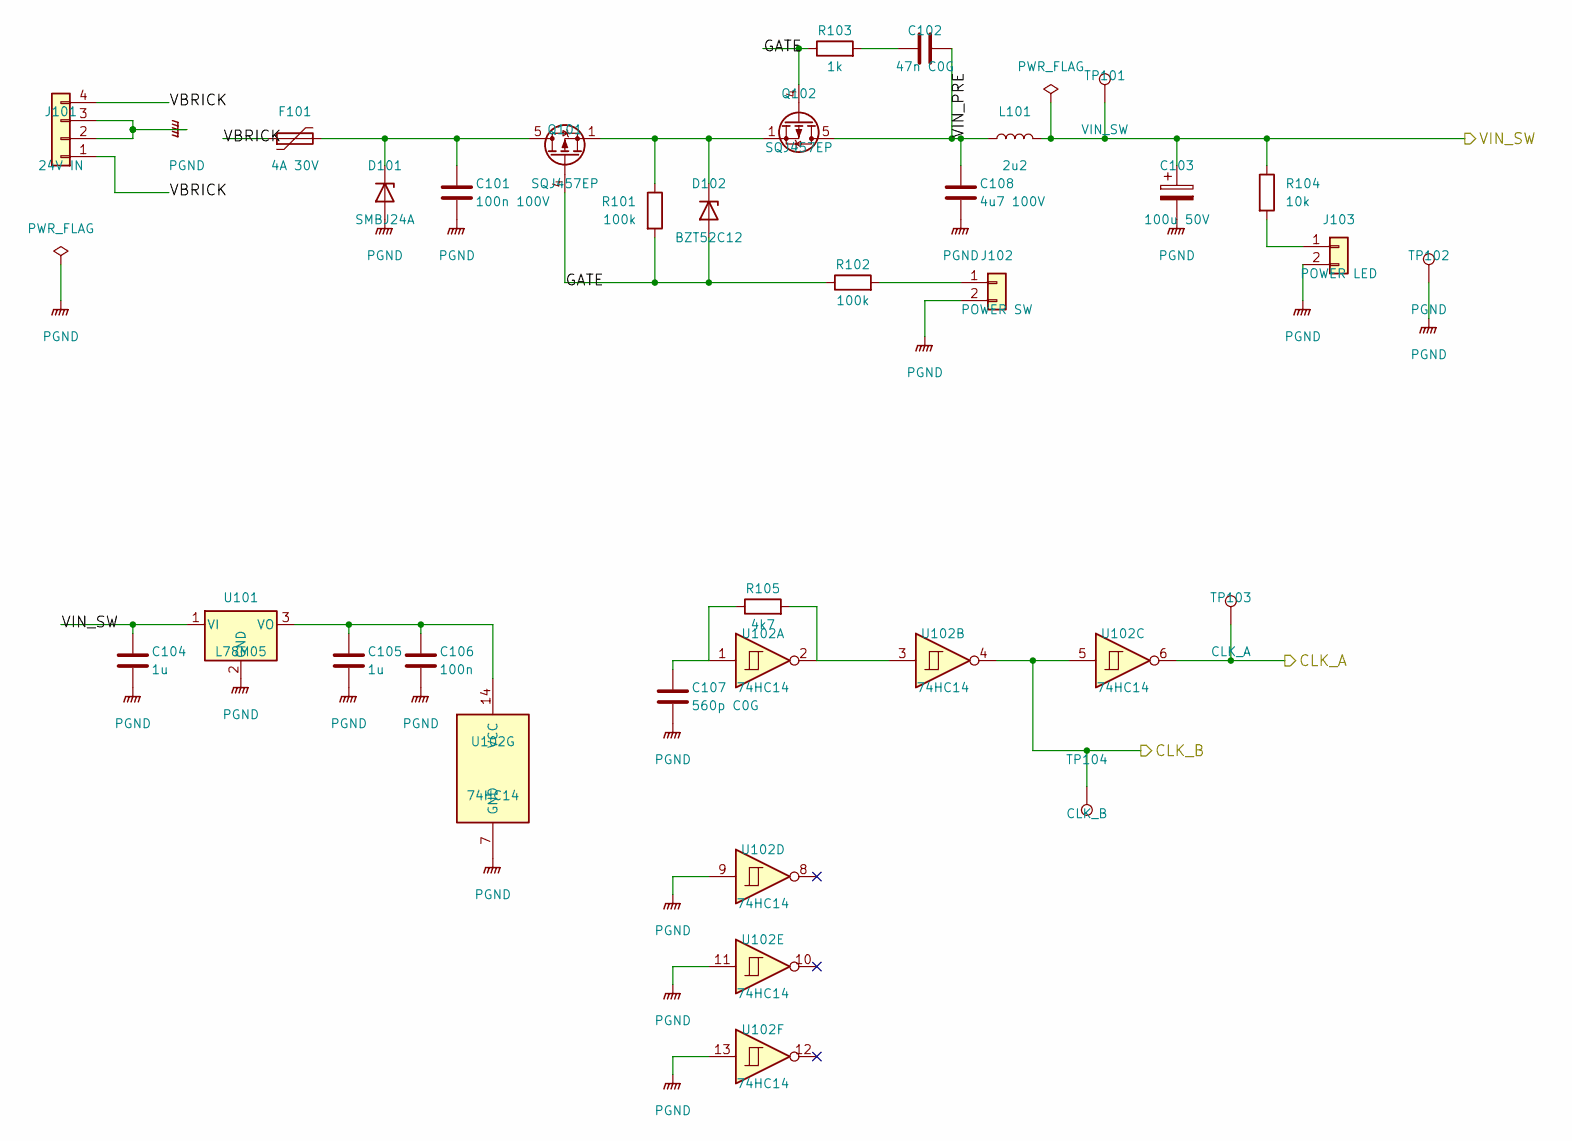
[picture p1: schematic input.kicad_sch, Power board: input and clock]

Parts:
C101: 100n 100V; C_0805_2012Metric
C102: 47n C0G; C_0805_2012Metric
C103: 100u 50V; CP_Radial_D8.0mm_P3.50mm; MPN UHE1H101MPD
C104, C105: 1u; C_0805_2012Metric
C106: 100n; C_0805_2012Metric
C107: 560p C0G; C_0805_2012Metric
C108: 4u7 100V; C_1210_3225Metric; MPN HMK325C7475KMHPE
D101: SMBJ24A; D_SMB; MPN SMBJ24A
D102: BZT52C12; D_SOD-123; MPN BZT52C12
F101: 4A 30V; Fuse_2920_7451Metric; MPN 2920L400/30GR
J101: 24V IN; JST_VH_B4P-VH_1x04_P3.96mm_Vertical; MPN B4P-VH(LF)(SN)
J102: POWER SW; JST_XH_B2B-XH-A_1x02_P2.50mm_Vertical; MPN B2B-XH-A(LF)(SN)
J103: POWER LED; JST_XH_B2B-XH-A_1x02_P2.50mm_Vertical; MPN B2B-XH-A(LF)(SN)
L101: 2u2; L_Bourns_SRP7028A_7.3x6.6mm; MPN SRP7028A-2R2M
Q101, Q102: SQJ457EP; PowerPAK_SO-8L_Single; MPN SQJ457EP-T1_GE3
R101, R102: 100k; R_0805_2012Metric
R103: 1k; R_0805_2012Metric
R104: 10k; R_0805_2012Metric
R105: 4k7; R_0805_2012Metric
TP101: VIN_SW; TestPoint_Pad_D1.5mm
TP102: PGND; TestPoint_Pad_D1.5mm
TP103: CLK_A; TestPoint_Pad_D1.5mm
TP104: CLK_B; TestPoint_Pad_D1.5mm
U101: L78M05; TO-252-2; MPN L78M05ABDT-TR
U102: 74HC14; SOIC-14_3.9x8.7mm_P1.27mm; MPN 74HC14D,653

Connections:
/CLK_A: TP103.1, U102.6; also elsewhere on the board
/CLK_B: TP104.1, U102.4, U102.5; also elsewhere on the board
/Input and clock/GATE: D102.2 (A), Q101.4 (G), Q102.4 (G), R101.2, R102.1, R103.1
/Input and clock/VBRICK: F101.1, J101.1, J101.4
/Input and clock/VIN_PRE: C102.2, C108.1, L101.1, Q102.5 (D)
unnamed: C102.1, R103.2
unnamed: C107.1, R105.1, U102.1
unnamed: C101.1, D101.1 (K), F101.2, Q101.5 (D)
unnamed: D102.1 (K), Q101.1 (S), Q101.2 (S), Q101.3 (S), Q102.1 (S), Q102.2 (S), Q102.3 (S), R101.1
unnamed: J102.1, R102.2
unnamed: J103.1, R104.2
unnamed: R105.2, U102.2, U102.3
unnamed: C105.1, C106.1, U101.3 (VO), U102.14 (VCC)

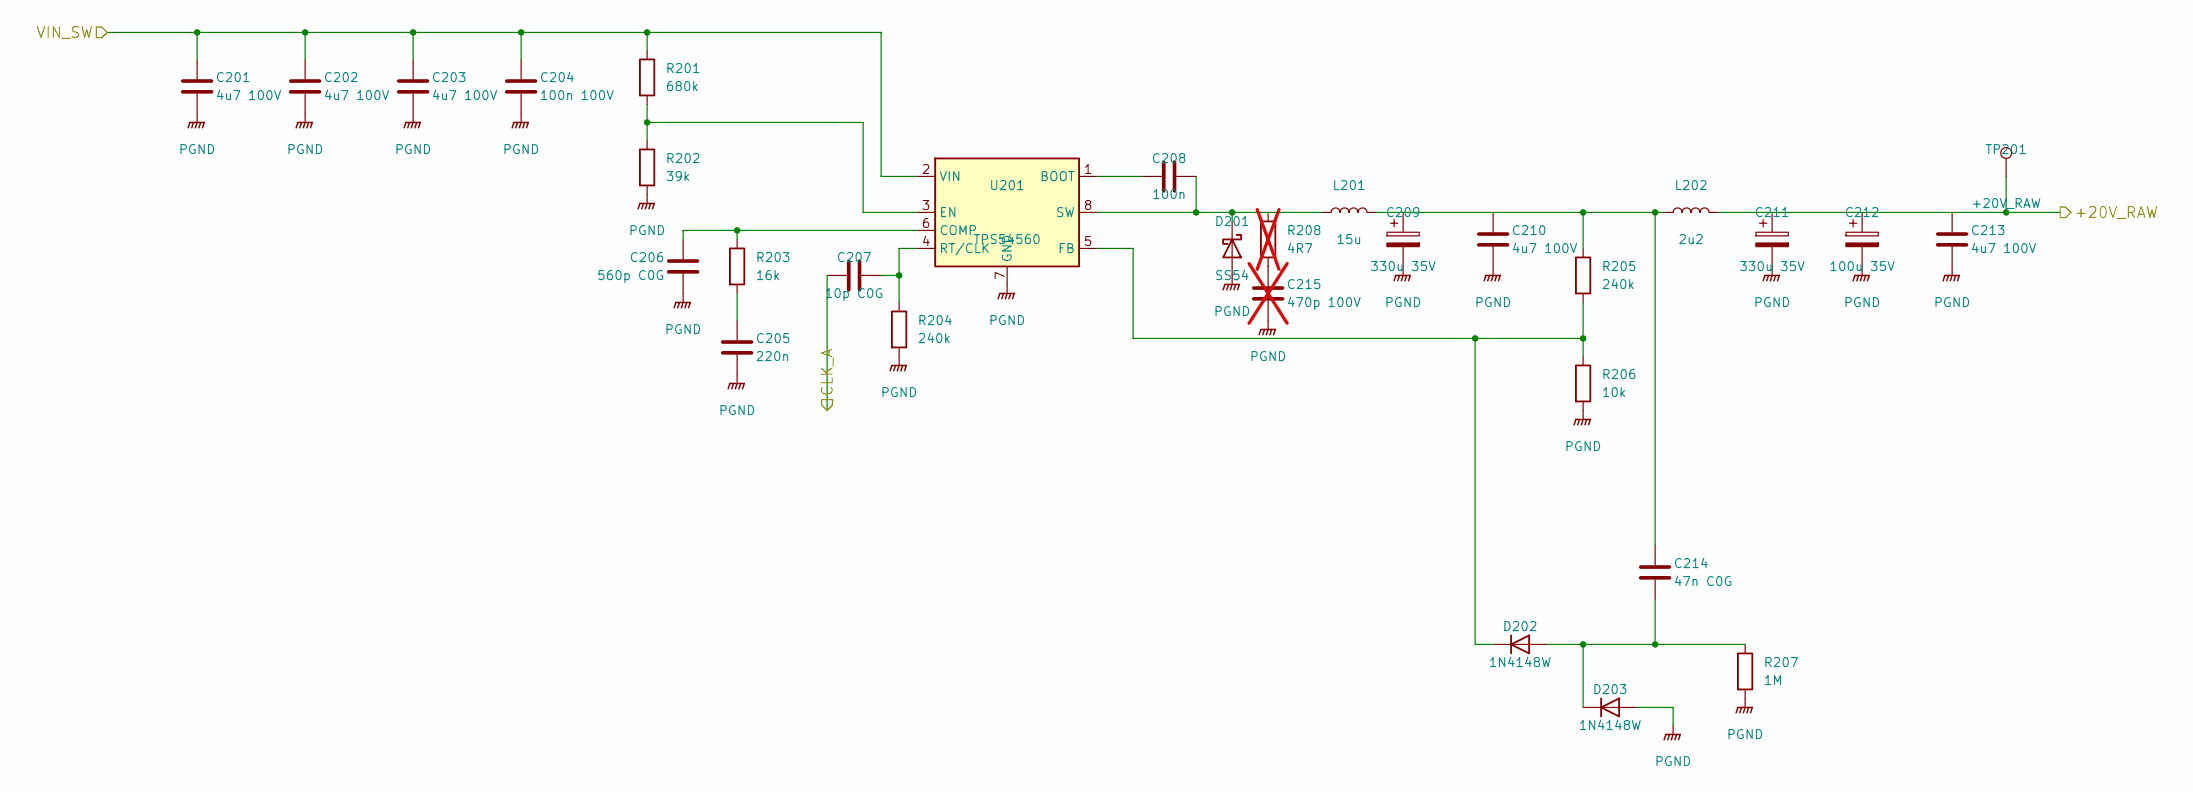
[picture p2: schematic buck.kicad_sch, Power board: +20 V buck]

Parts:
C201, C202, C203, C210, C213: 4u7 100V; C_1210_3225Metric; MPN HMK325C7475KMHPE
C204: 100n 100V; C_0805_2012Metric
C205: 220n; C_0805_2012Metric
C206: 560p C0G; C_0805_2012Metric
C207: 10p C0G; C_0603_1608Metric; MPN CL10C100JB8NNNC
C208: 100n; C_0805_2012Metric
C209, C211: 330u 35V; CP_Elec_10x10.5; MPN EEHZK1V331P
C212: 100u 35V; CP_Radial_D6.3mm_P2.50mm; MPN KNM2100UF35V149EC0055
C214: 47n C0G; C_0805_2012Metric
C215: 470p 100V; C_0805_2012Metric; not fitted
D201: SS54; D_SMA; MPN SS54
D202, D203: 1N4148W; D_SOD-123
L201: 15u; L_Bourns_SRP1265A; MPN SRP1265A-150M
L202: 2u2; L_Bourns_SRP7028A_7.3x6.6mm; MPN SRP7028A-2R2M
R201: 680k; R_0805_2012Metric; MPN 0805W8F6803T5E
R202: 39k; R_0805_2012Metric; MPN 0805W8F3902T5E
R203: 16k; R_0805_2012Metric; MPN 0805W8F1602T5E
R204, R205: 240k; R_0805_2012Metric
R206: 10k; R_0805_2012Metric
R207: 1M; R_0805_2012Metric
R208: 4R7; R_0805_2012Metric; not fitted
TP201: +20V_RAW; TestPoint_Pad_D1.5mm
U201: TPS54560; Texas_R-PDSO-G8_EP2.95x4.9mm_Mask2.4x3.1mm; MPN TPS54560DDAR

Connections:
/+20V_RAW: C211.1, C212.1, C213.1, L202.2, TP201.1; also elsewhere on the board
/CLK_A: C207.1; also elsewhere on the board
unnamed: C205.1, R203.2
unnamed: C209.1, C210.1, C214.1, L201.2, L202.1, R205.1
unnamed: C215.1, R208.2
unnamed: C208.2, D201.1 (K), L201.1, R208.1, U201.8 (SW)
unnamed: C214.2, D202.2 (A), D203.1 (K), R207.1
unnamed: D202.1 (K), R205.2, R206.1, U201.5 (FB)
unnamed: C208.1, U201.1 (BOOT)
unnamed: C206.1, R203.1, U201.6 (COMP)
unnamed: R201.2, R202.1, U201.3 (EN)
unnamed: C207.2, R204.1, U201.4 (RT/CLK)

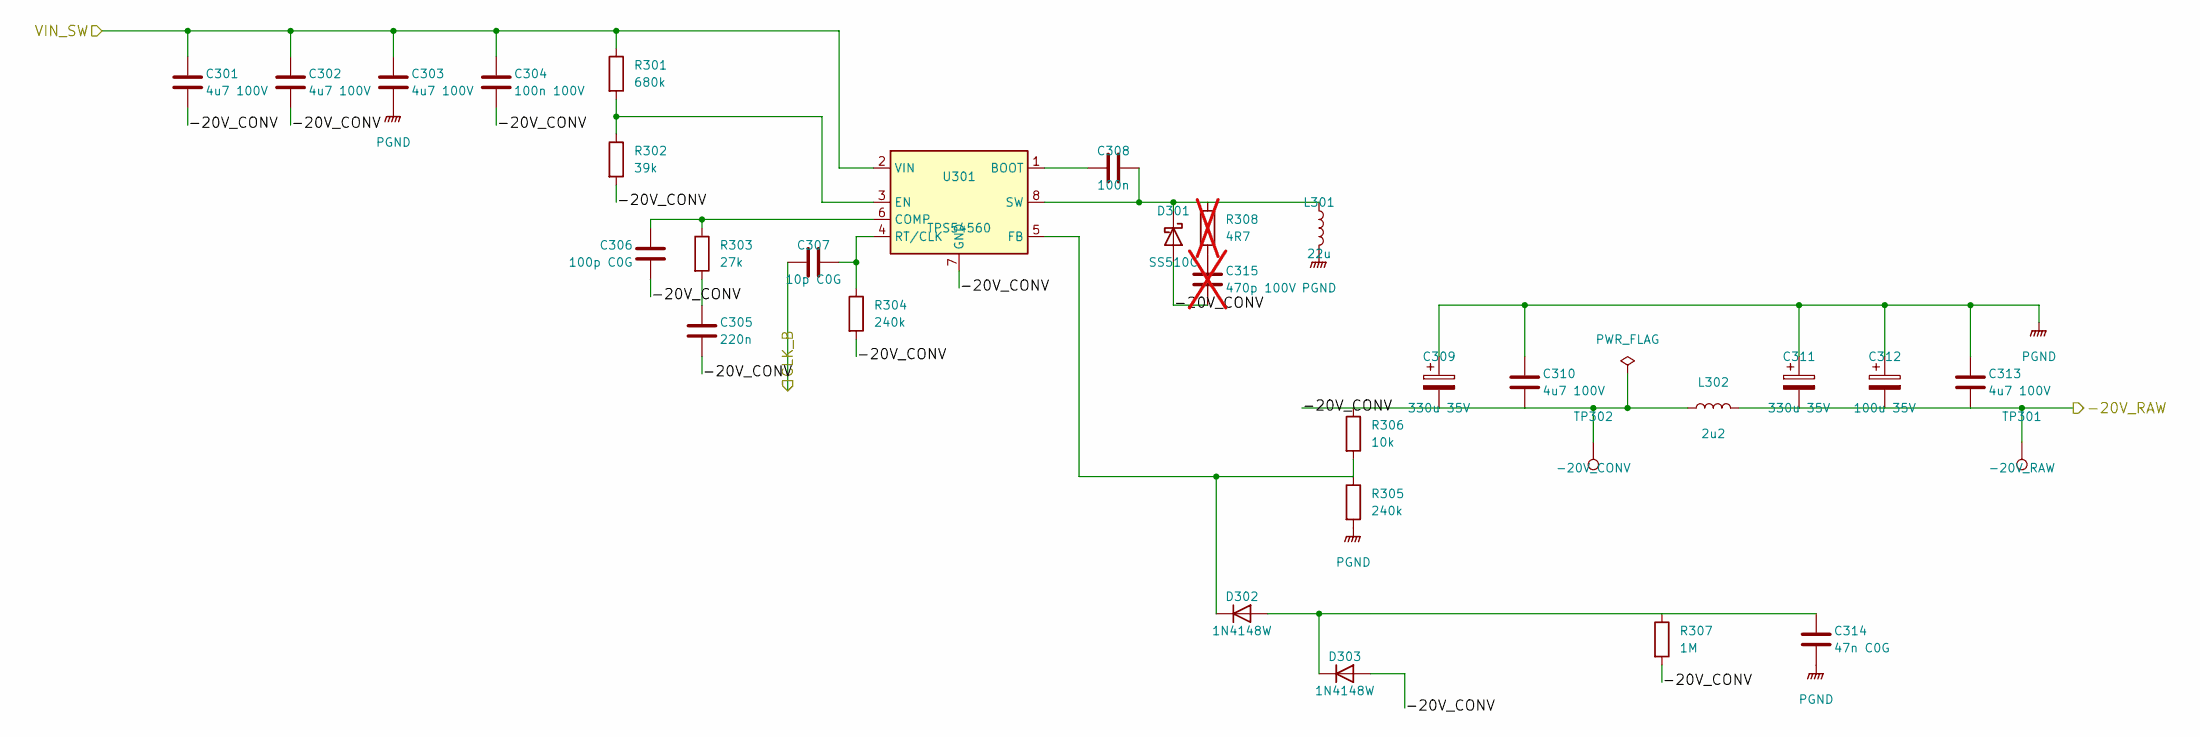
[picture p3: schematic inverter.kicad_sch, Power board: -20 V inverter]

Parts:
C301, C302, C303, C310, C313: 4u7 100V; C_1210_3225Metric; MPN HMK325C7475KMHPE
C304: 100n 100V; C_0805_2012Metric
C305: 220n; C_0805_2012Metric
C306: 100p C0G; C_0805_2012Metric
C307: 10p C0G; C_0603_1608Metric; MPN CL10C100JB8NNNC
C308: 100n; C_0805_2012Metric
C309, C311: 330u 35V; CP_Elec_10x10.5; MPN EEHZK1V331P
C312: 100u 35V; CP_Radial_D6.3mm_P2.50mm; MPN KNM2100UF35V149EC0055
C314: 47n C0G; C_0805_2012Metric
C315: 470p 100V; C_0805_2012Metric; not fitted
D301: SS510C; D_SMC; MPN SS510C
D302, D303: 1N4148W; D_SOD-123
L301: 22u; L_Bourns_SRP1265A; MPN SRP1265A-220M
L302: 2u2; L_Bourns_SRP7028A_7.3x6.6mm; MPN SRP7028A-2R2M
R301: 680k; R_0805_2012Metric; MPN 0805W8F6803T5E
R302: 39k; R_0805_2012Metric; MPN 0805W8F3902T5E
R303: 27k; R_0805_2012Metric
R304, R305: 240k; R_0805_2012Metric
R306: 10k; R_0805_2012Metric
R307: 1M; R_0805_2012Metric
R308: 4R7; R_0805_2012Metric; not fitted
TP301: -20V_RAW; TestPoint_Pad_D1.5mm
TP302: -20V_CONV; TestPoint_Pad_D1.5mm
U301: TPS54560; Texas_R-PDSO-G8_EP2.95x4.9mm_Mask2.4x3.1mm; MPN TPS54560DDAR

Connections:
/-20 V inverter/-20V_CONV: C301.2, C302.2, C304.2, C305.2, C306.2, C309.2, C310.2, C315.2, D301.2 (A), D303.2 (A), L302.1, R302.2, R304.2, R306.1, R307.2, TP302.1, U301.7 (GND), U301.9 (GND)
/-20V_RAW: C311.2, C312.2, C313.2, L302.2, TP301.1; also elsewhere on the board
/CLK_B: C307.1; also elsewhere on the board
unnamed: C305.1, R303.2
unnamed: C315.1, R308.2
unnamed: C308.2, D301.1 (K), L301.1, R308.1, U301.8 (SW)
unnamed: C314.1, D302.2 (A), D303.1 (K), R307.1
unnamed: D302.1 (K), R305.1, R306.2, U301.5 (FB)
unnamed: C308.1, U301.1 (BOOT)
unnamed: C306.1, R303.1, U301.6 (COMP)
unnamed: R301.2, R302.1, U301.3 (EN)
unnamed: C307.2, R304.1, U301.4 (RT/CLK)

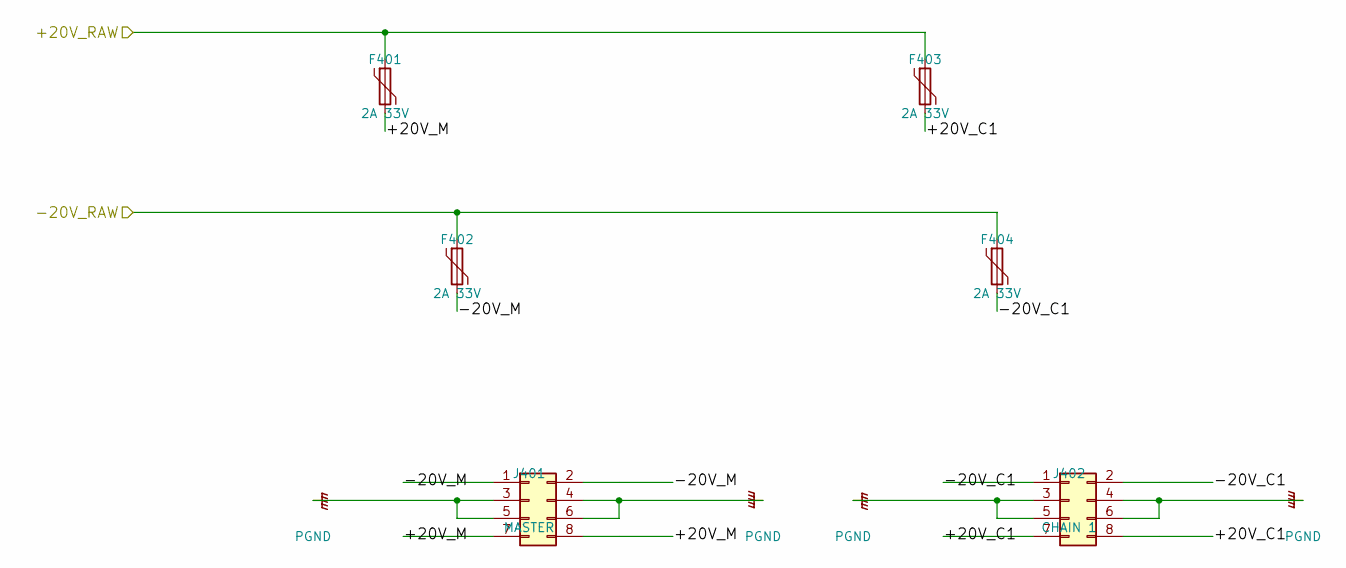
[picture p4: schematic outputs.kicad_sch, Power board: outputs]

Parts:
F401, F402, F403, F404: 2A 33V; Fuse_1812_4532Metric; MPN BSMD1812-200-33V
J401: MASTER; IDC-Header_2x04_P2.54mm_Vertical; MPN 61200821621
J402: CHAIN 1; IDC-Header_2x04_P2.54mm_Vertical; MPN 61200821621

Connections:
/+20V_RAW: F401.1, F403.1; also elsewhere on the board
/-20V_RAW: F402.1, F404.1; also elsewhere on the board
/Outputs/+20V_C1: F403.2, J402.7, J402.8
/Outputs/+20V_M: F401.2, J401.7, J401.8
/Outputs/-20V_C1: F404.2, J402.1, J402.2
/Outputs/-20V_M: F402.2, J401.1, J401.2

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
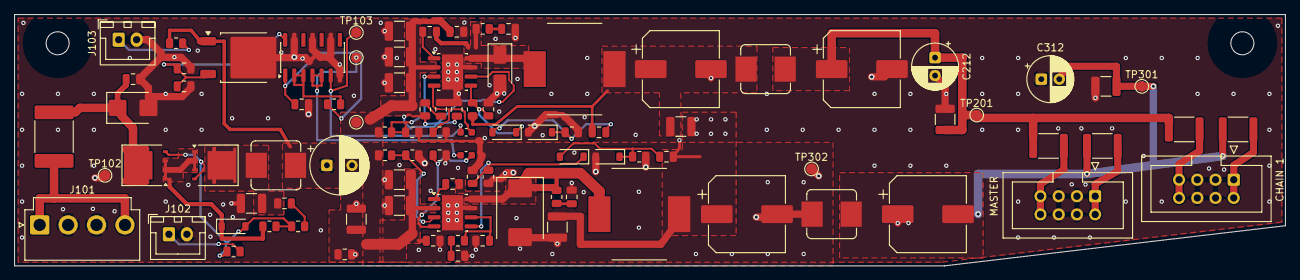
[picture p5: board power.kicad_pcb from above]

Board: 2 copper layers, 177.0 x 35.0 mm, 97 parts (0 on the bottom side), 41 nets.

Other parts of the board:
H1, H2: bracket M3; MountingHole_3.2mm_M3
