plektra/syntsamix/(commit log)

2026-10-02 Add project spec v0.4, decisions log and roadmap
    Specification for a modular analog mixer for live electronic music:
    4 stereo channels with a 24 dB/oct SSI2144 ladder LPF (hot drive,
    bypass, CV), VCA fader and mute, 2 stereo AUX sends, main/compressor
    bus assign and PFL; master card with compressor bus, sidechain LPF,
    AUX returns, headphones and LED meter. Inputs accept Eurorack levels
    up to ±12 V peak on 6.3 mm and 3.5 mm jacks.
    SSI2144 and THAT1246 figures are verified against their datasheets.
2026-10-03 Update spec to v0.6: parts, chain interface, meters, compressor
    - VCA SSI2162 (one per card), input receiver AD8273, fader Bourns
    PTA6043-2015DPB103 with +10 dB / -inf console law
    - Channel cards are independent and daisy-chained (up to 16) by a
    34-pin audio ribbon and a keyed 8-pin power ribbon at about ±20 V;
    pinouts and grounding rules in docs/CHAIN.md
    - 8-segment meter per channel, 12-segment stereo master meter
    - Performance compressor (Amount, Release, Mix, on/off, GR LEDs) with
    INT/BUS/EXT sidechain, pre-fader SC sends and SC listen
    - All jacks 6.3 mm; Eurorack levels up to ±12 V peak
    - Remaining proposals confirmed; availability notes and backlog updated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
2026-10-03 Add filter gain-structure simulation and record its outcome
    Behavioural 4-pole ladder model in ngspice (no vendor SSI2144 model
    exists), calibrated to the datasheet, with a runner script and results.
    Findings: hot drive gives about 93 dB SNR but about 1.3% THD at +4 dBu
    when the cutoff is lowered; resonance costs 12 dB of bass at maximum Q.
    Decisions: keep hot drive as default with a prototype jumper for medium
    drive, and use half resonance compensation (-6 dB bass loss, about
    +9.5 dB peak). Breadboard verification is the next step.
2026-10-03 Update spec to v0.7: schematic-ready decisions
    - AUX sends: dual-gang send master pots; returns: AD8273 with gain
    jumper, SSI2162 level VCA, mute button, bus switch
    - Filter cutoff 20 Hz to 20 kHz on a linear pot; fixed 1 V/oct CV input
    - Latching channel buttons with LEDs; strip layout follows signal flow
    - Headphone driver, compressor detector and ranges, output relays
    - Desktop rail frame with FR4 panels, 35 mm strips, rear jacks
    - Prototype power from a DC brick and DC-DC module to about ±20 V
    - Single-point frame bond with ground lift; chain connector types
2026-10-03 Add SSI2144 breadboard schematic, checked layout and build page
    - breadboard_schematic.py draws the test circuit (datasheet Rev 3.0
    pinout and Figure 1/3 values plus project values)
    - breadboard_layout.py places every part on a standard breadboard and
    checks the connections against the schematic netlist
    - breadboard_page.py builds breadboard.html with both drawings,
    placement and wiring tables, and power-up checks
    - Output stage feedback is now a single 50 kOhm trimmer; BREADBOARD.md
    and its shopping list updated to match
    - .gitignore for the local venv, caches and preview SVGs
2026-10-04 Add breadboard BOM and correct the SSI2144 adapter spec
    - breadboard-bom.csv: order quantities with spares, E24 substitutes
    for hobby-shop stock, and suggested suppliers (Electrokit for the
    SSI2144 and common parts)
    - BREADBOARD.md: the SSI2144 package is QSOP-16 with 0.635 mm pitch;
    the adapter must be 300 mil (SparkFun BOB-13994) to fit the layout
    Claude-Session: https://claude.ai/code/session_012m7N7TeMJRWAStviMH3feQ
    [breadboard-bom.csv]
2026-10-04 Update breadboard BOM: resistors from E24 kit, add supplementary parts
    Resistors come from the user's 1% E24 metal film kit. Supplementary
    section adds spares and likely adjustment parts so one order covers
    the bench work: NE5532s, reverse-polarity diodes, alternative ladder
    and stability capacitors, extra decoupling, trimmers, pot, adapter
    pack and solder wick.
    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
    [breadboard-bom.csv]
2026-10-04 Add Electrokit quick-order file for the breadboard parts
    sku;qty format for Electrokit's quick order, with article numbers,
    prices and stock checked on 2026-10-04. Sold-out film capacitors are
    replaced with in-stock R82 6.8 nF and 10 nF. The SSOP adapter
    (SparkFun BOB-13994) is not stocked there and must be ordered elsewhere.
    [electrokit-order.csv]
2026-10-04 Add input module interface and create the first KiCad projects
    - Decision 62: input jacks move to a passive, interchangeable input
    module on an 8-pin header (docs/INPUT-MODULE.md); 6.3 mm module for
    the prototype, 3.5 mm and D-SUB bundle modules later
    - Empty KiCad 10 projects: hardware/channel-card and
    hardware/input-module-6p3
    [channel-card.kicad_pcb, channel-card.kicad_sch, input-module-6p3.kicad_pcb, input-module-6p3.kicad_sch]
2026-10-04 Add missing items to the Electrokit order file
    Adds the two 100 kOhm 3296W trimmers and solder wick from the
    supplementary list. The SSOP adapter (SparkFun BOB-13994) is still
    ordered separately because Electrokit does not stock it.
    [electrokit-order.csv]
2026-10-04 Add part numbering convention and parts register
    Decision 63: each unique part type gets a project part number
    SX-<category>-<nnn>, used as Mouser's customer part number. KiCad
    symbols carry ProjectPN, Manufacturer, MPN, Supplier and SupplierPN
    fields, and BOMs are exported grouped by ProjectPN. docs/parts.csv
    starts with the parts decided so far.
    [parts.csv]
2026-10-04 Add soft clipping and a switchable 150 Hz low-cut
    Decision 64: soft clipping after each channel's input trim and on the
    master bus output, onset about +14 dBu. Decision 65: switchable fixed
    low-cut at about 150 Hz (12 dB/octave proposed) after the trim and
    before the ladder filter, with its own latching button. Both inspired
    by the Intellijel Jellymix; the sweepable HPF stays in the backlog.
2026-10-04 Ignore KiCad local state files
    Adds *.kicad_prl, lock files, backups and caches to .gitignore and
    removes the committed channel-card.kicad_prl. Commits KiCad's
    expanded default settings for the input module project file.
2026-10-04 Add sidechain ducking and direct-out backlog item
    Decision 66: the master card turns the filtered sidechain into an
    envelope (THRESHOLD, DEPTH, DECAY) on chain line SC_ENV (was SPARE1).
    Each channel's DUCK button and each AUX return's DUCK switch apply it
    to the VCA, complementing the compressor bus. Inspired by the
    Boredbrain Xcelon SL. Pre-fader direct output goes to the backlog.
2026-10-04 Add input module schematic and 10-pin input header
    - input-module-6p3 schematic: two Neutrik NMJ6HCD2 switched jacks
    (L/MONO, R) with R-to-L mono normalling, and a 1x10 Molex KK 254
    header to the channel card. ERC clean.
    - Decision 67: cutoff CV jack moves to the channel card's filter
    section, on the top panel next to CUTOFF.
    - Decision 68: input header grows to 10 pins; pins 8-9 reserved for
    the stereo pre-fader direct output (backlog), pin 10 AGND.
    - parts.csv: SX-CONN-001 jack and SX-CONN-002 header.
    - .gitignore: kicad-mcp-pro working files, reports and backups.
    [input-module-6p3.kicad_sch, parts.csv]
2026-10-04 Add channel card input stage schematic and AD8273 symbol
    - Input sheet: 10-pin input module header, input protection, AD8273
    receiver at G = 1/2 (wired inverting), AC coupling, NE5532 trim stage
    (-20 to +20 dB overall) with 6.2 V zener soft clip, 150 Hz 12 dB/oct
    Sallen-Key low-cut selected by a DG413, LOW-CUT button and LED.
    Netlist verified against the design; ERC clean apart from the sheet
    links to the not-yet-drawn filter sheet and the PGND label.
    - Shared symbol library hardware/libs/syntsamix.kicad_sym with the
    AD8273 (pinout from datasheet Rev B), registered in both projects.
    - Decision 69: buttons switch stereo audio through DG413 analog
    switches; a local +5 V supply fe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
    [channel-card.kicad_sch, input.kicad_sch, parts.csv]
2026-10-05 Add 32-channel expansion to backlog
    Also include KiCad's expanded channel card project settings.
2026-10-05 Add channel card filter sheet with LM13700 Q VCA
    Two SSI2144 ladder filters with the datasheet's external Q VCA for
    resonance compensation (jumper: none, half, full), shared cutoff summer
    with CV input, drive jumpers and DG413 bypass. Adds the SSI2144 symbol,
    decision 71, new part numbers, breadboard test 9 and a follow-up
    Electrokit order.
    [breadboard-bom.csv, channel-card.kicad_sch, electrokit-order-2.csv, filter.kicad_sch, parts.csv]
2026-10-05 Add channel card level sheet and sheet generator scripts
    SSI2162 VCA with a 3-segment console fader law, click-free DG413 mute
    and DUCK on SC_ENV (decision 72), SSI2162 symbol, fader-law breadboard
    test and parts. The Filter and Level sheets are generated by scripts in
    hardware/channel-card/scripts, with a netlist and duplicate-reference
    check. In-file SPDX headers now take precedence over REUSE.toml.
    [breadboard-bom.csv, channel-card.kicad_sch, electrokit-order-2.csv, level.kicad_sch, parts.csv]
2026-10-05 Fix duplicate sheet page numbers and instance paths
    sch_create_sheet numbered every new sheet page 2, which the KiCad app
    repairs on load. fix_paths.py now orders page numbers by sheet position
    and rewrites symbol instance paths and project names after each
    rebuild. Includes the schematics as re-saved by KiCad 10.
    [channel-card.kicad_sch, filter.kicad_sch, input.kicad_sch, level.kicad_sch]
2026-10-05 Redraw level sheet with real wires
    Pilot for readable sheets: schlayout.py places symbols and draws wires
    from KiCad pin geometry, level_wired.py lays out the Level sheet by
    circuit block, post_wired.py adds junctions, ground nets, no-connects
    and readable field placement. level_build.py stays the reference
    netlist. SSI2162 symbol pins rearranged for drawing.
    [level.kicad_sch]
2026-10-05 Redraw filter and input sheets with wires; low-cut to 100 Hz
    Filter and Input sheets are now drawn with real wires inside each
    circuit block, generated by filter_wired.py and input_wired.py and
    checked pin by pin against reference netlists (the Input reference is
    frozen in scripts/reference). SSI2144 symbol rearranged so the ladder
    capacitors sit beside their pins. Obsolete label-only post scripts
    removed. The input low-cut moves to 100 Hz with 24k/47k resistors
    (decision 73).
    [filter.kicad_sch, input.kicad_sch, parts.csv]
2026-10-05 Add channel card routing sheet
    Pre-fader buffers, two stereo AUX sends with dual-gang pots and pre/post
    jumpers, DG413 main/compressor bus assign, DG412 PFL and sidechain send,
    open-collector PFL_ACT driver and three buttons, drawn with real wires
    and checked against routing_build.py. Bus resistors 22.1k (decision 74).
    root_links.py labels shared sheet pins on the root sheet.
    [channel-card.kicad_sch, parts.csv, routing.kicad_sch]
2026-10-05 Choose GPBS850N latching buttons with printed light caps
    Buttons are CW Industries GPBS850N latching DPDT switches (Electrokit)
    with 0805 LEDs lighting 3D-printed translucent caps (decision 75).
    The datasheet shows pins 2-3 and 5-6 close when pressed, so every
    button now uses pin 3 for logic and pin 6 for the LED. Adds the switch
    footprint library, rebuild_all.sh, the state-retention requirement for
    the momentary-button backlog item, and ten switches to the second
    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
    [breadboard-bom.csv, channel-card.kicad_sch, electrokit-order-2.csv, filter.kicad_sch, input.kicad_sch, level.kicad_sch, parts.csv, routing.kicad_sch]
2026-10-05 Add channel card meter sheet
    8-segment peak meter on the pre-fader signal: four superdiode peak
    detectors into one hold capacitor (1 ms attack, about 1.5 s fall),
    buffered into eight LM339 comparators against a 1% ladder from +15 V,
    LEDs from +5 V (decision 76). Drawn with real wires and checked against
    meter_build.py. Page numbers now order by sheet position in both axes.
    Adds a 10-segment gauge bar sample to the second Electrokit order.
    [breadboard-bom.csv, channel-card.kicad_sch, electrokit-order-2.csv, filter.kicad_sch, input.kicad_sch, level.kicad_sch, meter.kicad_sch, parts.csv]
2026-10-05 Add test pads to the channel card sheets
    24 bare 1.5 mm test pads on key audio, control and ground nets across
    the Input, Filter, Level, Routing and Meter sheets, named by net and
    kept out of the BOM (decision 77). Each pad is in the reference
    netlists, so the checks prove it sits on the intended net.
    [channel-card.kicad_sch, filter.kicad_sch, input.kicad_sch, level.kicad_sch, meter.kicad_sch, routing.kicad_sch]
2026-10-05 Add chain and power sheet; channel card schematic complete
    Audio and power ribbon IN/OUT headers wired straight through,
    LM317/LM337 regulators to +/-15.2 V with ADJ bypass and protection
    diodes, SS14 rail clamps, 78L05 for +5 V, and test pads for the rails
    (decision 78). Power flags moved to this sheet. The whole channel card
    now passes ERC with 0 errors and 0 warnings and every sheet matches its
    reference netlist. Records the open power-ribbon current question in
    CHAIN.md.
    [chain.kicad_sch, channel-card.kicad_sch, filter.kicad_sch, input.kicad_sch, level.kicad_sch, meter.kicad_sch, parts.csv, routing.kicad_sch]
2026-10-05 Check parts against LCSC stock and use basic resistor values
    tools/lcsc_check.py checks docs/parts.csv against the JLCPCB/LCSC
    catalogue and writes docs/lcsc-check.csv. Non-critical resistors move
    to JLC basic values to cut setup fees (decision 79): bus resistors 22k,
    VCA input network 100R, cutoff offset 470k, regulator dividers 200R/2k2
    (15.1 V). All sheets rebuilt and verified (ERC 0/0).
    [chain.kicad_sch, channel-card.kicad_sch, filter.kicad_sch, input.kicad_sch, lcsc-check.csv, level.kicad_sch, meter.kicad_sch, parts.csv]
2026-10-06 Record master card design decisions 80-86
    Power injected in groups of 8 cards from a separate power board,
    AS3046D log detector, THAT1646 main output drivers (cost-cut
    candidate), TPA6120A2 headphone amplifier replacing the NJM4556A,
    Omron G6K relays for output protection, round 3 mm meter LEDs. Adds a
    relay part category, a cost-cut list and a printed LED diffuser backlog
    item; drops the bar-graph sample from the second Electrokit order.
    [breadboard-bom.csv, electrokit-order-2.csv, parts.csv]
2026-10-06 Create master card project and bus summing sheet
    Eleven virtual-earth summing amplifiers for the chain buses with 22k
    feedback, hierarchical bus nodes for the other master sheets, PFL_ACT
    pull-up and test pads, drawn with real wires and checked against
    bus_build.py. Shared sheet scripts now take the project name from their
    folder; the master project links to them. Decision 80 corrected: the
    power board feeds both chains and the master directly.
    [bus.kicad_sch, channel-card.kicad_sch, master.kicad_pcb, master.kicad_sch]
2026-10-06 Add master card power sheet
    Power ribbon in from the power board, LM317/LM337 to +/-15.1 V, L7805
    for the master's heavier +5 V LED load, the system AGND-PGND star point
    as a net tie, and the frame bond with ground lift (decision 87). Parts
    whose project number starts with "none" stay out of the BOM.
    [bus.kicad_sch, master.kicad_sch, parts.csv, power.kicad_sch]
2026-10-06 Add master card AUX return sheets
    Two identical return sheets from one script: L/MONO-normalled jacks,
    AD8273 receiver with a PRO/PEDAL gain jumper after it, SSI2162 VCA with
    the channel fader law on a level pot, DG413 mute and duck, inverter and
    22k bus resistors switched to MAIN or COMP (decision 88). Checked
    against aux_return_build.py; the master rebuild script now runs every
    sheet script.
    [aux_return1.kicad_sch, aux_return2.kicad_sch, bus.kicad_sch, master.kicad_sch, parts.csv, power.kicad_sch]
2026-10-06 Add master card compressor sheet
    Log-domain peak detector on the AS3046D matched pair with ERA-V33
    temperature compensation, current-mirror release, 4:1 gain computer
    with Amount-linked makeup, click-free on/off ramp, MIX crossfade and
    gain-reduction LEDs (decision 89). Side chain simulated in ngspice
    (simulation/compressor). Adds the AS3046 symbol, verified DG413 unit
    mapping and a session handoff file.
    [compressor.kicad_sch, master.kicad_sch, parts.csv]
2026-10-06 Add master card sidechain and ducking sheet
    Source selection by an SC BUS button with EXT plug override, Sallen-Key
    sidechain LPF (46-510 Hz) with bypass, SC listen to the cue buses with
    the PFL_ACT driver, and a trigger-style ducker driving SC_ENV
    (decision 90). Filter and ducker simulated in ngspice
    (simulation/sidechain).
    [master.kicad_sch, parts.csv, sidechain.kicad_sch]
2026-10-06 Add master card AUX sends sheet
    Dual-gang send masters with polarity-restoring 47k inverters,
    impedance-balanced TRS outputs and L/MONO summing switched by a DG411
    from the R jack's plug detection (decision 91).
    [aux_sends.kicad_sch, master.kicad_sch, parts.csv]
2026-10-06 Add master card master out sheet
    SSI2162 master VCA with the channel fader law, soft clip in the I-V
    stages, THAT1646 balanced drivers with offset caps and phantom clamps,
    G6K output protection relays with 2 s power-up delay and raw-rail
    drop-out (decision 92). Adds the THAT1646 symbol and exports
    +20V_RAW from the power sheet.
    [master.kicad_sch, master_out.kicad_sch, parts.csv, power.kicad_sch]
2026-10-06 Add master card master meter sheet
    Stereo 12-segment peak meter after the master level: per-side
    superdiode detectors with 1 ms attack and 1.5 s fall, one shared 1%
    ladder (within 0.04 dB) and 24 LM339 comparators (decision 93).
    [master.kicad_sch, meter.kicad_sch, parts.csv]
2026-10-06 Add master card headphones sheet; master schematic complete
    Main/cue source switch on PFL_ACT, dual volume pot, TPA6120A2 at
    gain 2 with TI's resistor values, protection relay and PFL-active LED
    (decision 94). Adds the TPA6120A2 symbol and no-connect flags for the
    unused bus-node pins (root_nc.json). Master card ERC 0/0.
    [headphones.kicad_sch, master.kicad_sch, parts.csv]
2026-10-06 Recheck master card power, add regulator heatsinks; update handoff
    Power budget script for the master card (typical +15 V 345 mA,
    -15 V 275 mA; worst case 730/606 mA) and board-mount TO-220 heatsinks
    of 10 C/W or better on the LM317 and LM337 (decision 95). Handoff file
    updated for the next session.
    [parts.csv, power.kicad_sch]
2026-10-06 Split the decision log by area; add roles, commands and agents
    - docs/decisions/: decisions 1-95 split into system, channel-card,
    input-module, master-card, power, mechanical and process files, with
    INDEX.md; docs/DECISIONS.md is now a pointer
    - docs/ARCHITECTURE.md: system diagram, cross-board budgets, chain lines
    and invariants
    - Per-board CLAUDE.md and STATUS.md; shared schematic workflow in
    hardware/CLAUDE.md; simulation/CLAUDE.md; short project-level handoff
    - Slash commands /board, /system, /handoff, /validate; sub-agents
    architect (contract reviewer) and validator (independent design checks)
    - docs/WORKING-WITH-CLAUDE.md: roles and session loop for the user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
2026-10-06 Add README landing page: project, goals, features and status
2026-10-06 Add system validation report; record its findings
    - docs/reviews/2026-10-06-system.md: first system validation
    (0 critical, 3 major, 4 minor)
    - Findings recorded as open system items in ARCHITECTURE.md (power
    table marked under review), in each board's STATUS.md, and in the
    order of work (/system power budget before the power board)
    - .gitignore: Claude Code worktrees
2026-10-06 Settle system validation findings: decisions 96-99
    - 96: power sizing rule (own parts worst case, shared parts IC typical x 1.5
    plus use-dependent loads); channel card and system budget scripts;
    prototype 1.35/1.11 A, full size 3.6/3.0 A per rail, 0.76 A per ribbon pin
    - 97: SC_ENV negative (-1 V = 10 dB) into the control summer's virtual
    earth, so ducking no longer depends on the fader position
    - 98: PFL_ACT drivers and button pull-downs return to PGND
    - 99: input-module cable (1:1 KK 254 crimp cable)
    - Fix stale power-entry wording; hand board changes to channel card and
    master STATUS; power board unblocked
    [parts.csv]
2026-10-08 Draw power board schematic: decision 100
    24 V Class II brick (Mean Well GSM120B24-R7B) on a locking 4-pin DIN jack,
    4 A PTC, SMBJ24A TVS, back-to-back SQJ457EP reverse block and soft start.
    Non-isolated TPS54560 buck (+20 V) and inverting buck-boost (-20 V),
    synced at 400 kHz in opposite phase from a 74HC14 oscillator; LC filter
    per rail and a 2 A PTC per rail per power ribbon header. Four sheets,
    netlist checks 0 problems, ERC 0/0. Values derived in scripts/design.py.
    Register the new parts (power ribbon header SX-CONN-008 = Wurth
    61200821621), add proposed part categories L and F, update SPEC/README/
    ROADMAP and the board STATUS files; items for /system noted in
    hardware/power/STATUS.md.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
    [buck.kicad_sch, input.kicad_sch, inverter.kicad_sch, outputs.kicad_sch, parts.csv, power.kicad_sch]
2026-10-08 System: power conversion wording, floating supply (decision 101), op amp power levers
    Reword ARCHITECTURE, CHAIN and decisions 60/81/96 for decision 100's
    non-isolated converters. Decision 101: the supply feeding the power
    ribbons must float from mains earth (invariant 8, CHAIN.md grounding);
    mains supply moves to the backlog. Record proposed op amp power-cut
    candidates in ROADMAP and flag the TL072 fader buffer input range and the
    power levers as checks before layout on the channel and master cards.
2026-10-08 Power board: confirm decision 100 values, add start-up ramp
    The user confirmed the UVLO thresholds (21.1 / 18.7 V), the oscillator
    (4.7 k / 560 p), the switch and LED at the rear edge and the L / F
    part-number categories.
    An averaged ngspice model (scripts/startup_sim.py) showed the fixed
    2.6 ms soft-start into about 1.1 mF per rail takes 183-262 W from the
    brick, over the GSM120B24's 126 W hiccup threshold. Each converter now
    gets 47 nF from its output through a 1N4148W into FB (1 M and a clamp
    diode reset the node): the rails rise with tau 11.3 ms and the input
    peaks at about 54 W. Netlist checks 0 problems, ERC 0/0.
    [buck.kicad_sch, input.kicad_sch, inverter.kicad_sch, outputs.kicad_sch, power.kicad_sch]
2026-10-08 Channel card: draw decisions 97 and 98, fader buffer on an OPA2171 (decision 102)
    - Level: SC_ENV into the summer's virtual earth through R217 30k1, R218 removed,
    summer + input on AGND (decision 97)
    - Q301 emitter and button pull-downs R17, R186, R220, R222, R313, R315, R317 to PGND (decision 98)
    - U204 = OPA2171 for the fader buffer and control summer (input range includes V-);
    superdiodes moved to the TL072 U205 (decision 102)
    - simulation/level: fader law within 1.2 dB, ducking 10.07 dB per -1 V at every fader position
    - Power budget, parts list, STATUS, breadboard test 10 and working notes updated
    [filter.kicad_sch, input.kicad_sch, level.kicad_sch, parts.csv, routing.kicad_sch]
2026-10-08 Master card: draw decisions 97 and 98, OPA2171 fader-law stages (103), SC_ENV drive (104)
    - AUX returns: SC_ENV into the summer's virtual earth through R232/R332 30k1,
    R233/R333 removed, summer + input on AGND (decision 97)
    - Q501 emitter and button pull-downs R237/239/241, R337/339/341, R455,
    R523/525/527 to PGND (decision 98)
    - U206, U306, U705 = OPA2171 for the pot buffer and control summer; superdiodes
    on the TL072s U207, U307, U706 (decision 103)
    - Sidechain: DEPTH negative (R518 to -15 V), U505B follower fed back after R521,
    D504 BAT54T1G clamp to AGND (decision 104); simulation rerun with 1.7 kOhm load
    - R421 on its 0603 footprint (system validation finding 3)
    - Power budget,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
    [aux_return1.kicad_sch, aux_return2.kicad_sch, compressor.kicad_sch, master_out.kicad_sch, parts.csv, sidechain.kicad_sch]
2026-10-08 System: confirm input header pinout (decision 105), AD8273 supply current verified
2026-10-08 System: mechanical contract MECHANICAL.md, decisions 106-109
    - 106: 35 mm strips, 34.8 mm FR4 panel, card <= 33 mm wide, control area
    <= 320 mm; cutoff CV jack moved to its own spot above CUTOFF
    - 107: PCB 10 mm below the panel (Alpha 9 mm pots hold it); fader screwed
    to the panel with M2 screws and 3.5 mm spacers before soldering;
    top-side parts <= 9 mm
    - 108: panel on both 2020 rails, two M3 screws per end into T-nuts;
    PCB <= 318 mm between the rails
    - 109: master at the right end; IN headers on the left edge, OUT on the
    right, underside; U-loop jumpers, cable mock-up before the first PCB
    - New contract docs/MECHANICAL.md listed with CHAIN.md and INPUT-MODULE.md;
    board STATUS n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
2026-10-09 Channel card: mechanical parts, decisions 110-117
    - 110 LM317/LM337 in D2PAK on copper (onsemi, LCSC)
    - 111 SMD electrolytics <= 5.4 mm (ROQANG, Panasonic bipolar)
    - 112 trimmers and jumper headers on the underside, bottom cover for /system
    - 113 low-cut caps C0G 1206
    - 114 pot shaft standard T18 15 mm; 115 trim stage scaled to 100k, pots chosen
    (blocked until RoHS declarations)
    - 116 RoHS strict for every part and board (process)
    - 117 button LED colours (JLCPCB basic 0805), Wurth chain headers
    - J181 drawn as Thonkiconn 3.5 mm (pending /system), fields and footprints set,
    five sheets rebuilt, netlists match, ERC 0/0
    - STATUS: seven For /system items (CV jack, 0805 meter bezel, panel sc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
    [chain.kicad_sch, filter.kicad_sch, input.kicad_sch, level.kicad_sch, parts.csv, routing.kicad_sch]
2026-10-09 System: mechanical flags from the channel card, decisions 118-122
    - 118 jack size by function (replaces decision 27's rule): 6.3 mm default for
    audio, 3.5 mm for Eurorack CV/gate; cutoff CV = 3.5 mm Thonkiconn
    - 119 channel meter: 0805 LEDs under a printed bezel in one panel slot,
    6.0 mm pitch, CLIP level with the fader top, scales independent
    - 120 one centred M3 per panel end plus a printed locating key (refines 108)
    - 121 underside parts, provisional edge keep-out, detachable bottom cover
    - 122 RoHS invariant 9, standard passives at BOM time, parts audit before
    the first PCB order
    - MECHANICAL.md, CHAIN.md, ARCHITECTURE.md, SPEC.md brought up to date;
    channel-card.md split into ch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
    [parts.csv]
2026-10-09 Breadboard: what runs on the first Electrokit order alone
    Tests 1-7 (output scale, Q limit, drive jumper) and a reduced test 10 need
    only the first order; tests 8-9, the GPBS850N buttons and the full test 10
    (OPA2171) need the second order or extra parts.
2026-10-09 Channel card: meter LEDs 0805, op amp power levers (decision 123), RoHS audit
    - Meter D411-D418 to 0805 LEDs (KT-0805G, KT-0805Y, NCD0805R1; decision 119)
    - U107 NE5532 -> TL072; meter U401/U404 TL072 -> TL062CDR (SX-IC-024)
    - Card load 113 / 95 mA typical, sizing 174 / 142 mA; netlists match, ERC 0/0
    - RoHS audit of parts.csv (decision 122): 47 rows sourced; gaps SSI2144,
    SSI2162, AS3046D; THAT1646S08-U and ERA-V33J102V end of life at Mouser
    (docs/reviews/2026-10-09-rohs-audit.md); four rows requoted
    [filter.kicad_sch, meter.kicad_sch, parts.csv]
2026-10-09 System: power budgets after decision 123, RoHS open item after the audit
2026-10-09 System: Alpha pots RoHS-cleared (decision 124), Thonk order codes, bushing confirmed
    Taiwan Alpha's general RoHS II declaration (via Thonk) covers every
    standard Alpha pot: channel CUTOFF, TRIM, AUX and RESONANCE are cleared,
    master Alpha pots get their source once chosen. Thonk's Alpha order codes
    recorded (SX-POT-003/011/013); M7x0.75 x 5 mm bushing confirmed.
    Supplier declarations kept locally in git-ignored docs/rohs/.
    README: status brought up to date (all four schematics, RoHS, next steps).
    [parts.csv]
2026-10-09 Master card: DRV135 outputs, TL062 levers, SMD electrolytics, both raw rails watched (decisions 125-128)
    /board master pre-layout session; the user delegated the open points.
    - Confirms the [proposed] parts of decisions 89-94 (Q5 checked, +22 dB
    makeup kept for the breadboard, fallback R439 = 330k).
    - 125: TI DRV135UA replaces the end-of-life THAT1646 (THAT memo
    2026-09-01); same SO-8 pinout, LCSC C544663.
    - 126: U409, U410, U802, U804 TL072 -> TL062; superdiodes and U407 stay.
    - 127: master electrolytics to SMD (decision 111 parts, 5.4 mm).
    - 128: U707C watches -20V_RAW (22k6/100k), wired-OR with the +20 V trip.
    - Würth fields on J101/J901, BAT54 LCSC C152458, G6K and header
    drawings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
    [aux_return1.kicad_sch, aux_return2.kicad_sch, bus.kicad_sch, compressor.kicad_sch, headphones.kicad_sch, master.kicad_sch, master_out.kicad_sch, meter.kicad_sch]
2026-10-09 Channel card: pot MPNs on the symbols, R184 12k for the RESONANCE pot rating (decision 129)
    - Alpha MPNs on RV1 (TRIM), RV181 (CUTOFF), RV301/RV302 (AUX); the Thonk
    -0057 variant suffix is left open
    - RV183 reference netlist now SX-POT-012 (Tayda RD901F-40-15K-C10K),
    matching the drawing
    - Decision 129: Alpha's RD901F spec rates non-B tapers at 0.02 W; RV183
    carried about 21 mW, R184 10k -> 12k gives about 17 mW (max Q current
    about 254 uA, provisional with R120/R170)
    - RD901F spec facts in parts.csv; master STATUS notes RV402 RELEASE at
    about 20.2 mW for its own session
    Netlists match, ERC 0/0.
    [filter.kicad_sch, input.kicad_sch, parts.csv, routing.kicad_sch]
2026-10-09 Master card: RELEASE pot C100K for Alpha's 0.02 W rating (decision 131)
    - RV402 C10K -> C100K (Alpha RD901F-40-15K-C100K, Tayda A-5370,
    SX-POT-014), R425 620R -> 6k2 (SX-R-091): about 2 mW instead of
    20 mW; only the R425/track ratio sets the law
    - Simulated release 44 / 353 / 1427 ms per 10 dB (was 44 / 351 /
    1422 ms); raising R425 alone would have cut the CW end to ~0.3 s
    - run.py takes the pot value; parts, STATUS, index updated
    - hardware/CLAUDE.md: Tayda blocks scripts; check decision and SX
    numbers across worktrees before numbering
    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
    [compressor.kicad_sch, parts.csv]
2026-10-09 Channel card: TFPT tempco pair replaces the end-of-life ERA-V33J102V (decision 130)
    - R108/R158 Vishay TFPT0603L8200FV 820R (+4110 ppm/K) with new R122/R172
    180R in series to AGND: 1k at about +3370 ppm/K, divider unchanged
    - SX-R-089, SX-R-090 in parts.csv; SX-R-021 stays for master R421
    - Trim pot value text shortened to "50k OFFSET" for room on the sheet
    - STATUS, handoff, hardware notes (datasheet routes, pot power rating);
    master STATUS points R421 at the same pair
    Netlists match, ERC 0/0, reuse lint clean.
    [filter.kicad_sch, parts.csv]
2026-10-10 System: cost review and cost control (decisions 132-137)
    Rean NYS216 jacks with a new footprint (132), through-hole parts hand-soldered (133), E24 values owned per board (134), live-device cost principle (135), /cost with the cost-controller sub-agent, tools/costs.py and a private ledger of realized costs (136), JLCPCB fee-free parts first (137).
    [aux_return1.kicad_sch, aux_return2.kicad_sch, aux_sends.kicad_sch, headphones.kicad_sch, input-module-6p3.kicad_sch, master_out.kicad_sch, overheads.csv, parts.csv]
2026-10-10 Master card: SC LPF pot RV501 a standard Alpha dual B100K (decision 138)
    The reverse-log dual 100k had no standard 9 mm T18 source. RV501 becomes
    Alpha RD902F-40-15K-B100K-0057 (Thonk, SX-POT-015), RoHS cleared by
    Alpha's general declaration. Same circuit; simulated sweep 46/60/85/146/510 Hz
    at CCW/25 %/middle/75 %/CW. Other non-B master pots checked against Alpha's
    0.02 W rating: all well under it. Netlist checks 0 problems, ERC 0/0.
    [parts.csv, prices.csv, sidechain.kicad_sch]
2026-10-10 Channel card: fee-free TL072CDT, 78L05G-AB3-R, BZT52C6V2, UNI-ROYAL resistors (decision 137)
    SX-IC-007 TL072 -> ST TL072CDT (LCSC C6961, basic), SX-IC-012 78L05 -> UTC
    78L05G-AB3-R (C71136, basic; pins 1 O 2 G 3 I, not the -AB3-C-R variant),
    SX-D-001 -> hongjiacheng BZT52C6V2 (C19077403, preferred), SX-R-011/036/042
    -> UNI-ROYAL 0805W8F (preferred). Datasheet facts and RoHS sources in
    parts.csv. Filter, level, meter and chain sheets rebuilt: netlists match,
    ERC 0/0. costs.py extended: 82 -> 80 fee types. Master STATUS notes that
    its TL072 symbols still need the ST fields.
    [chain.kicad_sch, filter.kicad_sch, lcsc-check.csv, level.kicad_sch, meter.kicad_sch, parts.csv, prices.csv]
2026-10-10 System: cost review 2026-10-10, prices and estimate corrections
    - docs/reviews/2026-10-10-cost-system.md: cost controller report (whole system)
    - prices.csv: current DG413, DG412, trimmer, SSI, AD8273, JLCPCB library prices;
    seven fee types the estimate counted as free; ERA-V33J102V priced as a TFPT
    - overheads.csv: JLCPCB Economic PCBA set-up (about EUR 9 per design, not 35)
    - costs.py: estimate --fees-per-design for shared extended types billed per design
    - Board STATUS: review levers added as proposals; ROADMAP figures updated
    [overheads.csv, prices.csv]
2026-10-10 Channel card: cost levers (decisions 139-143)
    - U303 DG412 -> DG413, SC send on the NC section (139)
    - All values E24 with JLCPCB fee-free parts; E24 pairs for V/oct
    and fader law, meter ladder re-fitted (140)
    - Filter temperature compensation to the backlog (141)
    - MUTE/DUCK switched by the buttons' spare pole, U206 DG413 removed;
    100k hold resistors, no dependence on contact sequence (142)
    - TL072 difference receiver with 10k 0.1 % instead of the AD8273 (143)
    - Trimmers from Mouser, CUTOFF pot from Tayda A-4730
    - Breadboard tests 11 (X5R coupling caps) and 12 (fixed V/oct)
    - costs.py estimate, 4 channels: EUR 1,035 -> 946
    [filter.kicad_sch, input.kicad_sch, level.kicad_sch, meter.kicad_sch, parts.csv, prices.csv, routing.kicad_sch]
2026-10-10 System: full-size brick GSM220B24-R7B (decision 145), 4/8/16 cost builds
    - Decision 145: 16-card brick GSM220B24-R7B (221 W, Class II, same R7B plug)
    instead of the GSM160B24-R7B; prototype keeps the GSM120B24-R7B
    - costs.py takes the brick price from prices.csv (SX-MECH-003 / -005) and
    shows the standard builds 4, 8 and 16 channels side by side
    (941 / 1,221 / 1,818 EUR); /cost, cost-controller and /handoff follow
    - ARCHITECTURE.md and CHAIN.md power figures after decision 143; brick row;
    DRV135 in the diagram; RoHS open item updated; INPUT-MODULE.md receiver
    - ±15 V rails cost review (dropped as marginal; one power input only)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
    [overheads.csv, parts.csv, prices.csv]
2026-10-10 Workflow: models per role and lighter /board start-up (decision 150)
    Design sessions stay on Opus. architect, cost-controller and validator
    run on Sonnet; /validate ... deep and /cost ... deep run on Opus for
    pre-layout, pre-order and system reviews. New read-only helper agents
    for bounded jobs: part-facts (Sonnet), build-check, sim-run and
    stock-check (Haiku). /board reads only the board's rows of INDEX.md
    and the invariants and open items of ARCHITECTURE.md.
2026-10-10 Master card: fee-free parts and E24 values (decisions 144, 146-150)
    - 144: AUX return and master fader laws on the channel's E24 pairs
    - 146: meter ladder on fee-free E24 values (0.45 mA, within 0.14 dB); R732 22k + R737 560R
    - 147: compressor R420/R426 E24 pairs, GR LED ladder 470k/4k3, SC LPF C503 2 x 47n C0G
    (Q 0.707, 44-478 Hz); TL072 symbols ST TL072CDT
    - 148: AUX return receivers TL072 difference amplifiers (AD8273 gone from the project)
    - 149: R421 plain 1k; compressor temperature compensation to the backlog
    - 150: DG413, SSI2162, DRV135UA, AS3046D hand-soldered on the prototype master
    (symbol field Assembly, read by tools/costs.py); SPOF noted in the backlog
    - Part swaps: button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
    [aux_return1.kicad_sch, aux_return2.kicad_sch, aux_sends.kicad_sch, compressor.kicad_sch, headphones.kicad_sch, lcsc-check.csv, master_out.kicad_sch, meter.kicad_sch]
2026-10-10 System: buttons may switch DC control voltages (decision 152), SC_ENV load 30k (153); split system.md, budgets rerun
2026-10-10 Decision log: move the area files to docs/decisions/record/ (decision 154, step 1)
    Pure rename, no content change, so git log --follow keeps each file's
    history. The short current-ruling files follow in the next commit.
2026-10-10 Decision log in two tiers: short current rulings, full record (decision 154)
    docs/decisions/<area>.md now holds the current ruling of each decision,
    with refinements folded in; docs/decisions/record/<area>.md keeps the
    full text (figures, sources, rejected options). Session reading of the
    area files drops from about 122 KB to 47 KB (channel card 36 KB to 12 KB).
    The validator checked every short entry against its record: no problems.
    - tools/check_decisions.py: INDEX, short files and record list the same
    numbers, each in one area (154 decisions, 0 problems)
    - /board, /system, /handoff and the validator, cost-controller and
    architect agents read the short files and write both tiers
    - CLA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
2026-10-10 Channel card: R217 30k (decision 153), SSI2144/SSI2162 hand-soldered on the prototype (decision 155)
    Level sheet: R217 30k1 -> 30k (SX-R-050, basic); ducking -10.10 dB per -1 V
    in simulation/level. U101/U102 SSI2144 and U201 SSI2162 carry Assembly =
    "hand (decision 155)": 38 -> 36 fee types, 4/8/16 channels EUR 788/1,069/1,665.
    Bipolar 10 uF caps stay consigned until breadboard test 11. Netlists match,
    ERC 0/0.
    [filter.kicad_sch, level.kicad_sch, overheads.csv]
2026-10-10 Master card: R232/R332 30k (decision 153)
    AUX return sheets: R232/R332 30k1 -> 30k (SX-R-050, JLCPCB basic);
    SX-R-087 no longer used. simulation/sidechain load 18 x 30k = 1.667 kOhm,
    results unchanged. Netlists match (73 nets each), ERC 0/0. Cost: 35 fee
    types, EUR 785/1,066/1,663 for 4/8/16 channels. STATUS.md trimmed;
    drawn part swaps moved to CHECKLISTS.md.
    [aux_return1.kicad_sch, aux_return2.kicad_sch, parts.csv]
2026-10-10 Buttons: SX-SW-001 is the latching GPBS850L, not the momentary GPBS850N
    Electrokit 41012905 (on-on, latching) links the GPBS850N datasheet, which
    is the momentary twin (Electrokit 41015527, Mouser "Non-Latching ON-(ON)");
    the MPN was copied from that file. The latching part is CW GPBS850L
    (datasheet Rev 2, 2014: same body, pin grid and pressed = 2-3, 5-6 contacts;
    plunger 4.0 mm instead of 3.8).
    MPN and footprint name corrected on all 17 button symbols, the generator
    scripts and the input reference; parts.csv gets the GPBS850L datasheet and
    RoHS source (Mouser 629-GPBS-850L, DigiKey CW179-ND); prices.csv gets the
    Electrokit price (6.48 SEK ex VAT at 25+). Erratum on decision 75, checklist
    i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
    [aux_return1.kicad_sch, aux_return2.kicad_sch, breadboard-bom.csv, compressor.kicad_sch, filter.kicad_sch, input.kicad_sch, level.kicad_sch, parts.csv]
2026-10-10 Cost model: JLCPCB extended fees per design, MOQ, Economic PCBA limits
    Checked against JLCPCB's price page and PCBA FAQ (2026-10-10):
    - Extended part fee 3.07 USD, billed on each design that uses a type
    (jlc_fee_per_design = 1; JLCPCB quotes each assembled design separately,
    to confirm on the first real quote).
    - Basic and preferred parts are fee-free only in Economic PCBA; Standard
    charges every type. Economic takes at most 30 boards of a design
    unpanelled, and its 250 mm panels cannot hold the 318 mm channel card:
    costs.py flags a build above that (jlc_economic_max_boards).
    - Minimum order quantities: costs.py buys at least a part's MOQ (optional
    moq column in prices.csv, MOQ i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
    [overheads.csv]
2026-10-10 Power board: E24 dividers, rear-panel rocker, last parts chosen (decisions 156-159)
    - 156: UVLO 680k/39k (start 21.3 V, stop 19.0 V), RT 240k, buck
    compensation 16k; design.py and startup_sim.py rerun (start-up unchanged,
    GSM220B24 limit in the model)
    - 157: power switch a Legion SS11-BBIWG-R20-R rocker on the rear panel,
    wired to J102 (JST XH 2-pin) in place of SW101; counted in costs.py
    - 158: C103 Nichicon UHE1H101MPD radial; sync caps 10 pF C0G 50 V 0603
    - 159: D201 SS54 on D_SMA to match LCSC C22452
    - Netlist checks 0 problems, ERC 0/0; estimate 764/1045/1641 EUR
    (4/8/16 ch), 28 fee types
    [buck.kicad_sch, input.kicad_sch, inverter.kicad_sch, outputs.kicad_sch, parts.csv, power.kicad_sch, prices.csv]
2026-10-10 Cost model: series orders of N mixers, Standard PCBA, volume breaks
    - tools/costs.py sets [--channels 8] [--sets 1,5,10,20]: one order of N
    identical mixers, order total and cost per set.
    - A design above Economic PCBA's 30 boards is priced as Standard PCBA:
    set-up 25.56 + stencil 8.21 USD and 1.53 USD loading per basic or
    extended type (JLCPCB price page, 2026-10-10). Panelling the 33 mm
    channel card for Standard is not priced.
    - prices.csv gets optional moq and breaks columns; Thonk's volume prices on
    the SSI2144 and SSI2162 (5 % at 10+, 10 % at 25+, 50 % at 100+).
    - After main's power board decisions 156-159: EUR 778 / 1,040 / 1,600 for
    4 / 8 / 16 channels; an 8-channel mixer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
    [overheads.csv, prices.csv]
2026-10-11 Channel card: coupling capacitors as back-to-back ROQANG pairs (decision 161)
    Each 10 uF bipolar coupling capacitor (Panasonic EEE-1VA100NP, out of stock
    at LCSC and consigned) becomes two ROQANG RVT1V100M0505 10 uF 35 V (SX-C-024,
    already on the card) in series, negative to negative: C5+C21, C6+C22,
    C101+C108, C151+C158, C107+C109, C157+C159, C221+C235, C271+C285. No new fee
    type, nothing on the channel card consigned. Netlists match (input 48,
    filter 85, level 43 nets), ERC 0/0. Breadboard test 11 now checks the pair;
    the X5R option is dropped. Estimate EUR 778 -> 768 for 4 channels; the
    master follows in its own session.
2026-10-11 Add /status command: compact board progress and next steps
    Read-only overview on Sonnet: board table, next steps with the command
    to start each, items waiting on the user or others, and flags.
2026-10-11 Mechanical: rear strips, input module on edge, sloped frame (decision 160)
2026-10-11 Mechanical: master section, power bay, single front rail (decision 162)
    Master section 4 strips with rear jacks on two passive row boards,
    panel-mounted headphone jack, 0805 meter under bezels, TO-220
    heatsinks under the card; power bay with an on-edge power board and
    two planned module sizes; chain 1 next to the master, feeds into the
    rightmost card's power OUT header; single 2020 front rail (about 6°
    slope). Contracts, budgets, SPEC, roadmap and board notes updated.
2026-10-11 Master: rear jacks on two 26-pin row-board ribbons (decision 163)
    J603 (AUX sends sheet) carries main outs and both AUX sends to the
    output row board; J903 (Power sheet) brings the AUX returns, SC EXT
    and the ground-lift switch (pins 25/26) from the input row board.
    Pairs with a ground between them; row boards hold only jacks, header
    and SW901. Netlist checks 0 problems, ERC 0/0.
2026-10-13 Channel: cutoff CV chaining, CV OUT and summer clamp (decision 165)
    CV OUT jack J182 reports the channel's total cutoff control at 1 V/oct
    from FCV through the spare U107B. Jumper JP181 selects CV ONLY (a
    plugged CV replaces the knob through J181's normal contact) or CV + POT.
    D184/D185 BZT52C11 back to back clamp the cutoff summer so the SSI2144
    frequency pin stays within about +-128 mV (datasheet range -120..+150 mV,
    dropout above about +175 mV); simulation/cutoff/, breadboard test 13.
    Panel row for CV IN/OUT noted for /system.
2026-10-13 System: cutoff CV IN and OUT side by side in panel row 3 (decision 166)
    CV patch cables between channel cards allowed (AGND to AGND); decision 163
    wording in ARCHITECTURE invariant 2, CHAIN grounding and MECHANICAL rear jacks.
2026-10-13 Breadboard: refresh to the delivered Electrokit parts and E24 kit
    The first Electrokit order and the SSOP adapter arrived. breadboard.html
    (and its artifact) and BREADBOARD.md now use the parts in hand: E24 kit
    values (18k, 33k -> 51k, 510, 470k, 160k, 300k; the card's own where it
    has them, so test 5's RV3 value carries over to R111/R161 directly), RV3
    start about 9k instead of the datasheet's 33k, bipolar coupling caps,
    R82 film caps placed diagonally for their 5 mm pitch, C14/C15 10 uF at
    the supply entry, 1N4001s at the supply terminals, a rail-continuity
    check and the pin 15 range with the offset trim. Tests 11 and 12 run on
    the first order; test 13 still needs two 11 V zeners. Layout c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
2026-10-13 Breadboard: test 13 zeners on the second Electrokit order
    Electrokit has no 11 V zener (BZX79C11 not available), so the on-hold
    second order carries two BZX55C10V (40310030) and two BZX55C12V
    (40310033). Test 13 measures the summer clamp with both pairs, the two
    neighbours of the card's BZT52C11 and the values the test may move to;
    C11 is read between them. BOM, page note and status files follow.
2026-10-13 System: passive ventilation and heat budget (decision 167)
    Perforated bottom cover, four 2 x 30 mm slots per channel rear strip, no cheek
    or top openings; design point 22 K above room (57 C on a 35 C stage);
    tools/heat_budget.py; master heatsinks to about 6.5 C/W under decision 95,
    SX-IC-010 NRND, rear angle check for the input module.
2026-10-13 Power: power LED on the power bay's top strip (decision 168)
    The power board stands on edge in the bay (decision 162), so the
    on-board 0805 power LED could not be seen. D103 leaves the board;
    R104 feeds a JST XH 2-pin header J103 wired to a 3 mm Kingbright
    WP710A10LGD (SX-D-004) in a Bivar CR-104 clip (SX-MECH-006, new) on
    the bay's top strip. Both off-board parts are costed with the frame,
    like the rocker. Netlist checks 0 problems, ERC 0/0.
2026-10-13 Master: headphone jack, 0805 LEDs, off-board parts in the estimate (decisions 169-171)
    - J751 becomes a KK 1x3 header for the panel Rean NYS230 with a ready-made
    Molex 217797-1031 lead (169)
    - Master meter, gain-reduction (yellow) and PFL-active LEDs all 0805 basic
    parts; SX-D-005/006 retired (170)
    - tools/costs.py counts parts without a schematic symbol from
    docs/costs/offboard.csv, and the two rear row-board PCBs (171):
    estimate EUR 831 / 1,110 / 1,693 for 4 / 8 / 16 channels
    - New parts SX-CONN-019..022; ready-made input-module cable noted for /system
    - NYS216/NYS230 samples to order; heatsink choice on hold (none fits 25 mm
    at decision 167's 57 C air), options in master STATUS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
2026-10-13 System: register chain ribbon cable parts (on hold for a cost review)
    2x17 IDC socket Würth 61203423021 (SX-CONN-023), 3M 3365 flat cable 34/26/10-way
    (SX-WIRE-001..003); WIRE category; Mouser prices in prices.csv; KK crimp
    SX-CONN-010 end of life noted; 28 AWG fit and cable current left to the mock-up
    (decision 109); chain ribbons vs offboard.csv and the frame overhead on hold in
    CONTINUE-FROM-HERE.
2026-10-13 Cost: system review 2026-10-13 and its prices
    Add the system cost review (docs/reviews/2026-10-13-cost-system.md) and
    the prices it found: Mouser prices and breaks for the Wurth box headers
    SX-CONN-007/008 (replacing estimates) and the 2x4 socket SX-CONN-012,
    LCSC rows for SX-D-009 (preferred), SX-D-013 and SX-F-002, and the lever
    candidates (Adam Tech BHR/FCS, 0603 C39148 and C4197, LCSC trimmer
    C83686) in the notes of the parts they would replace. No lever adopted.
2026-10-14 Channel: SSI2144 package verified (SSOP-16 MO-137-AB, 0.635 mm)
    Sound Semiconductor's package drawing PODPSSL16 and a measured chip
    confirm the QSOP-16 0.635 mm footprint on U101/U102; parts.csv,
    CHECKLISTS.md and STATUS.md record it, hardware/CLAUDE.md notes
    where package drawings live.
2026-10-14 Breadboard: layout re-placed for the 500 mil SSOP adapter
    The SparkFun BOB-13994's pin rows are 500 mil apart: U1's pins sit in
    rows d/g, rows e/f stay free under the adapter. The layout check now
    rejects parts in chip pin holes or under a chip.
2026-10-15 Breadboard: Electrokit SKUs and part types, kit resistor substitutes, RV4 and 1N4001s on the board
2026-10-17 Master: back-to-back coupling pairs, ten NE5532 to TL072, Wakefield heatsinks, onsemi TO-220 regulators (decisions 172-174)
2026-10-17 Channel card: cable mock-up dropped by the user, noted for /system (decision 109)
2026-10-17 System: multi-drop chain cables in 8-card sections with a coupler board, replacing the mock-up; power and heat budgets refreshed after decisions 173-174 (decision 175)
2026-10-17 Channel card: chain sheet down to one audio and one power header on the multi-drop cables, spares unconnected; decisions 139-143 reviewed by the user (decision 175)
2026-10-17 Master: AUX return MUTE and DUCK on the buttons, U208/U308 DG413 removed; checklists brought to decisions 174-175; decision 147 confirmed (decision 177)
2026-10-17 System: chain cables costed, master regulator zone, power LED hole, ready-made input cable, rated Wurth chain cable (decisions 176-178)
2026-10-17 System: SPARE2 to SPARE5 wording in CHAIN.md and ARCHITECTURE.md (unconnected on the cards, decision 175)
2026-10-17 Input module: IDC ribbon input cable replaces the Molex lead, NYS216 jacks kept, cost review and checklists (decision 180)
2026-10-18 System: input header Adam Tech 2x6 box header, Würth 12-way IDC flat cable, misplug-safe pinout; contracts, parts and prices (decision 181)
2026-10-18 Channel card: input header J1 redrawn as the Adam Tech 2x6 box header, pinout of decision 181
    Stock KiCad Conn_02x06_Odd_Even and IDC-Header_2x06_P2.54mm_Vertical; DO_L/DO_R open;
    opt-in field_at in post_wired.py; netlists match, ERC 0/0.
2026-10-18 Input module: input header J3 redrawn as the Adam Tech 2x6 box header on the stock KiCad parts (decision 181)
2026-10-19 System: power board PCB first in the order of work, KiCad MCP profile note
2026-10-19 Channel card: CD4052B bus assign, PFL and SC send switches at the virtual-earth bus ends, LCSC BOCHEN trimmers (decisions 183-184)
2026-10-20 Power board: PCB placed and routed by scripts, panel-mount brick jack, small module without chain 2 (decisions 182, 185, 186)
2026-10-20 Power board: input EMI pi filter C108/L101 after Q102, PCB rebuilt (decision 187)
    C108 4.7 uF 100 V on the brick side, L101 2.2 uH SRP7028A in series, then C103:
    keeps the converters' 400 kHz input current off the brick lead (about -80 dB
    against -44 dB in a hand model; L101 alone gains nothing because C101 resonates
    with the lead near 400 kHz). No new part type. Input area re-placed (F101
    upright, Q101/Q102 to the rear, VIN_PRE copper under L101); placement.py now
    takes new parts and pad nets from the schematic. ERC 0/0, DRC 0, parity clean.
2026-10-20 System: power bay layout, brackets, LED hole and master heatsink keep-out (decision 188)
2026-10-20 System: chain and architecture wording for the two power module sizes (decision 185)
2026-10-20 Power board: DNP switch-node RC snubber footprints across D201 and D301, bench EMI checklist (decision 189)
    R208/C215 (SW to PGND, above D201) and R308/C315 (SW to -20V_CONV, beside
    D301), 0805, not fitted: values from a bench measurement of the ringing on the
    first boards ("Bench, first boards" in CHECKLISTS.md, with the input filter
    check of decision 187). placement.py takes DNP and BOM flags from the symbols.
    ERC 0/0, DRC 0, parity clean; cost unchanged.
2026-10-20 Power board: snubber placement reviewed by the user (decision 189)
2026-10-20 Breadboard: test 2 on SSI2144 chips 1 and 2, loose ladder capacitor contacts, second Electrokit order released
    Chip 1 reached k = 1.5 at about 520 uA (776 uA measured into pin 14) and
    never self-oscillated; the build matches the datasheet (part-facts check).
    The ladder film capacitors' breadboard contacts were loose; chip 2 is faulty
    or has a bad joint; chip 1 was then damaged by a misplaced power-up.
    Next: a soldered core on a ProtoPCB EKB14 and chip 3.
    The second order now adds three ProtoPCB boards, three SSI2144 and the
    E24 resistors the kit lacks; GPBS850L cut to 3 (LED bleed test moves to
    the first assembled channel card).
2026-10-21 Power board: EMI layout review, smaller switch-node copper, bottom-plane keep-outs under the hot loops
    Switch-node pours cut to the pads plus a strip (buck about 95 to 71 mm2,
    inverter about 149 to 98 mm2); the buck boot capacitor's switch-node link and
    the MOSFET source link moved from the bottom to the top; bottom-layer track
    keep-outs under the buck loop, the input filter, left of and below the
    inverter's loop. Under the inverter IC the EN, RT/CLK and FB hops remain.
    DRC 0 violations, 0 unconnected, schematic parity.
2026-10-21 System: cost review of hand-soldered SMD chips; prototype keeps them, production machine-places them (decision 190)
2026-10-21 System: PCBA supplier comparison, JLCPCB kept; pre-reflow fee avoided by SMD-only order files (decision 191)
2026-10-21 Power board: inverter control corner reworked, boot capacitor above the IC, compensation below it
    C308 between pins 1 and 8 above U301 removes the BOOT hop and the switch-node
    run round the IC; R303/C305/C306 and C304 below the IC remove the COMP hop;
    the band below the inverter IC is clear of bottom tracks. EN, RT/CLK and FB
    still cross the island under the IC (about 26 mm, from 55). A top PGND sliver
    between C314's pads is covered by the inverter-output ground area. DRC 0
    violations, 0 unconnected, schematic parity; reviewed by the user.
